2186279865/robot-10.15/README.md

# robot-competition —— 机器人视觉分拣系统

> 2027 年第十届中国大学生工程实践与创新能力大赛 · 智能+工程创新赛道 · **智能分拣**赛项
> 一台"看得到、抓得准"的四轴抓取机器人：双相机识别 → 双摄融合定位 → 四轴 + 托盘 + 舵机夹爪执行。

```
         两个 USB 相机                    笔记本（识别 + 界面）
              │                                 ▲
              ▼                                 │ WiFi：5056 发现 / 5057 图传 / 5058 串口桥
       香橙派（采集 + 串口桥）───────────────────┘
              │ USB
              ▼
   STM32F407 ── USART2 ──► 4 台 EMM V5 步进（Z / 托盘 / X / Y）
        └── TIM4_CH1 ──► 舵机夹爪（180° 全开 / 150° 预备 / 135° 夹紧）
```

## 仓库四个文件夹（第四个是给队友的）

| 文件夹 | 是什么 | 谁该看 |
|---|---|---|
| **`01-交付包/`** | **能用的那一版**：固件源码+hex、派端服务、视觉算法+模型权重、上位机 GUI、部署脚本、操作文档。自带模型，拷走就能跑 | 要跑、要改、要交付的人 |
| **`02-资料库/`** | 赛题原文、硬件资料、往届参考、历史快照、调研报告、交接教程，以及 **`00-项目日志.md`**（每件事的背景/取舍/验证/坑） | 想知道"为什么这么做"、要接手的人 |
| **`03-实验台/`** | 试过但没进主线的东西：Qwen 语义识别（33 GB，**不在 git 里**）、SAM 上派实测、网络化原型 | 想试新想法的人 |
| **`04-队友视觉调试包/`** | 给第二台电脑（队友）的入口：只读看图、离线跑识别、一键自检、真机样例图 | 队友和他的 AI |

**第一次来 → 直接读 `01-交付包/README.md`**（三步跑起来 + 故障速查）。
**想搞清来龙去脉 → 读 `02-资料库/00-项目日志.md`**（按时间倒着看也行）。

## 最快上手

```bat
cd 01-交付包
setup.bat                     :: 只需一次：建 .venv 并装依赖（约 1–2 GB）
run.bat                       :: 本地模式：相机 + STM32 都插在本机
run.bat --pi 192.168.100.198  :: WiFi 模式：相机和 STM32 在派上（端口下拉框会自动出现「派 robot-pi …」）
run.bat --sim                 :: 没有硬件，纯看界面
selftest.bat                  :: 自测 7 步（220 单测 + 端到端 + GUI）
```

派端装一次：`cd 01-交付包/orangepi && ./install.sh`（装依赖 + 生成开机自启服务）。
固件烧录：`01-交付包/stm32/hex/STM32F429.hex`（或 Keil 打开 `01-交付包/stm32/firmware/Project/STM32F407.uvprojx` 按 F8）。

## 三个容易踩的坑（交付包里已经处理过，但你还会遇到）

1. **相机槽位每次插拔可能变**——顶视/侧视互换后要改 `vision/config.json` 的 `remote.cam_map`；
2. **两台相机别挂同一个 USB2 hub**——带宽不够会掉到 5 fps，插一台到 USB3；
3. **动过相机位置/分辨率 → 标定全部重做**（四点、空背景、X/Y、Z 示教）。

## 快照与恢复

- git：tag `working-20261023` / commit `3a5fec3` 是重构前的可运行快照；
- 物理备份：`D:\study\backup\robot-competition-2026-10-23`（1.16 GB，含逐文件哈希清单）；
- 模型 `sam_b.pt`（358 MB）走 **Git LFS** 入库：clone 前先 `git lfs install`（否则得到 134 字节指针，`git lfs pull` 补）；
- 队友那台机器直接看 `04-队友视觉调试包/README.md`。

## 约定

- 批处理文件一律**纯 ASCII + CRLF**（cmd.exe 逐字节解析，UTF-8 中文会把行切错）；
- 固件里**不要**从外部脚本改 `.uvprojx`（Keil 保存会用内存里的旧列表覆盖）；
- 新增功能优先改 `*_inline.h`；`Drive/Source/gripper.c`、`stepper.c` 是参考副本、不进编译；
- `01-交付包` 严禁 import `03-实验台` 里的东西；要用的结论就搬进 01。

## 旧目录（待清理，暂留作回退）

`10.21/`（重构前的自包含包）、`final/`、`new_eye/`、`ghr/`、`xrw/`、`build/`、`Qwen/`（已移入 `03-实验台/Qwen-VLM/`）
—— 内容都已被三个新文件夹覆盖，确认新版无问题后可删（见 `02-资料库/00-项目日志.md` 最后一条）。
