2186279865/robot-10.15/03-实验台/网络化原型/README.md

# 【已毕业】网络化原型（派采集 + 串口桥 + 拉模式图传）

- **日期**：2026-10-22 起草 → 2026-10-23 毕业
- **想解决什么**：相机和 STM32 都插在派上，笔记本只跑识别与界面，两者同一 WiFi。
- **毕业去向**：已全部并入 `01-交付包/`：

| 当初的原型 | 现在在交付包里的位置 |
|---|---|
| `pi_agent.py`（图传 5057 + 串口桥 5058 + UDP 发现 5056） | `01-交付包/orangepi/pi/pi_agent.py` |
| 线路协议（9 B 请求 / 24 B 头 + JPEG / 6 B 错误头） | `01-交付包/common/wire.py` |
| `RemoteCamera` / `camera_factory`（笔记本侧把远程帧伪装成本地相机） | `01-交付包/vision/remote_camera.py`、`camera_factory.py` |
| `SocketLink`（把 `tcp://IP:5058` 当串口用） | `01-交付包/host/serial_link.py` |
| 一键连派（端口下拉框里出现「派 robot-pi <IP>」） | `01-交付包/host/pi_link.py` |
| 发现与测速工具 | `01-交付包/net/find_pi.py` |
| 防火墙/组网指南 | `01-交付包/net/组网指南.md`、`firewall-allow.ps1` |

## 这个实验里最值钱的三个判断

1. **拉模式优于推流**：笔记本发 9 字节请求、派回一帧 JPEG。没有积压、没有重传、延迟可控（实测取一帧 137–376 ms）。
2. **错误包必须带自己的头长度**：图传头 24 B、错误头 6 B。第一版客户端一律按 24 B 读，遇到错误包会多吞 18 字节，然后卡到 5 s 超时——表现为"偶发超时"，非常难查。修法：先读 2 B magic 再分派。
3. **派端要有看门狗**：笔记本 1.5 s 没发字节，派端就自己往 STM32 发四轴停车帧。这样笔记本崩了/网断了，机械臂不会一直跑。

## 这目录现在还剩什么

什么都没有——原型代码已经删了（避免两份代码漂移）。要读实现，直接看 `01-交付包` 里的对应文件；要读当时的取舍，看 `02-资料库/00-项目日志.md` 的 2026-10-22 与 2026-10-23 两条。
