2186279865/robot-10.15/codex/output/project_report_work/artifact.md

# 模板执行约定

- 原件：C:/Users/rs/Desktop/附件7-命题文档_1785202024444.docx
- SHA256：7c49e14664f3795d0f7ec58d0b5f1f59784145c8e426350145f9a7dabfd03245
- 已用 Word 只读导出 template.pdf，7 页；template-1.png 至 template-7.png 已检查。
- 参考 PDF 为写作结构与详细程度参考，不复制人物、机构、实测成绩或垃圾分拣部件。
- A4 纵向 21.001×29.700 cm；上/下 2.54 cm，左/右 3 cm；单节；页眉距离1.501 cm，页脚1.750 cm。
- 主体是一个10行2列合并表格：第0行赛事名称，第1行组委会编号，第2/3行标题与参赛项目，第4至8行五章，第9行赛事提示。
- 保留主表列宽、表头合并关系、边框、赛事标题、编号栏与赛事提示。正文允许克隆源全宽行，将标题和正文、图片和图题作为完整分组；组间隐藏横线，保留章节分隔。复制源文件编辑，不改变原件。
- 填入第3行项目名 智能分拣 并加入作品题目 几何物块视觉识别与自动分拣系统。
- 第4至8行：删除蓝色指导文字和空白段，替换为原创项目正文；各章字数分别不超过500/2000/500/300/2000。
- 正文宋体10.5 pt（五号），固定20 pt行距，两字首行缩进；正文与标题黑色。章节按源模板编号，内层采用2.1等层次，避免借用垃圾项目的内容。
- 源表行高为模板占位，5~7行各742.35 pt；正文填入后改为自然高度，允许跨页。正式内容自然续页；正文短组不可拆分，标题与后文、图片与图题合组以防孤行，不再强制章节分页。
- 图表：仅使用项目图像与新绘制的系统/算法/动作示意图；图按章最多5幅。图中文字中文，说明为示意不伪装实物成果；图文不覆盖、不越框。
- 第二张表为智能搬运赛项的决赛场地空白附页，不适用于智能分拣，删除该附页及多余空白段；模板正文的五章和赛事提示保留。
- Title样式应用于作品说明书标题，去除标题装饰线；参赛作品题目位于第一章内。
- 匿名：清除作者等元数据；不出现学校、队号、学生名及个人标识，不放软件带个人信息的截图。
- 数据：采用已经存档的离线结果，不虚构全机准确率与耗时。决赛流程、数量、时间和评分明确为命题建议。
- 渲染：当前Windows运行时没有LibreOffice（runtime.json libreOfficeVersion=null），已确认本机 Word 16.0 可用。通过任务包装器将技能render_docx.py的PDF转换阶段接入Word只读导出，PNG仍由技能渲染器生成。最终逐页检查。
- 输出为codex/output/几何物块智能分拣系统作品说明书.docx；中间PDF与页面不作为交付件。

- 最终QA：6页逐页PNG已检查；四幅图齐全，无蓝色指导文字；各章字数合限，几何尺寸与原模板相同，原文件哈希未变。正文借助克隆行解决Word长合并单元格的分页问题，保留章节边框。报告仅采用存档离线测试数据。
