2186279865/robot-10.15/01-交付包/VERSION.md

# VERSION.md —— 01-交付包 版本说明

## 当前版本：v1.0（2026-10-23 冻结）

| 项 | 值 |
|---|---|
| 冻结时间 | 2026-10-23 23:50 左右（本机时间） |
| Git 快照 | 仓库 commit `3a5fec3`，tag `working-20261023` |
| 物理备份 | `D:\study\backup\robot-competition-2026-10-23`（1.16 GB，含 `_MANIFEST.txt`） |
| 固件 | `stm32/hex/STM32F429.hex`，92,952 B，2026-10-26 00:13 编译，Code=31,632 / RO=1,152 / RW=532 / ZI=7,396，0 Error 0 Warning（含闭环 `motor_goto` + **转盘角度模式** `motor_angle`/`motor_angle_zero`；修了 goto 负向方向 bug、查询节流、argc 与时间差回绕） |
| 上位机 | 8 页一体化 GUI，单测 **182** 个全过（含 box_map / auto_runner） |
| 派端 | `pi_agent.py` 1872 行，假硬件自测 24 项全过 |
| 视觉 | SAM-B（`vision/models/sam_b.pt`，357.7 MB）+ 双摄融合 + 规则分类 |
| 跨端 | TCP 端到端 5 项全过（图传 / 串口桥 / ER 包 / cam_map / 不可达降级） |

## 这一版能做什么

- 笔记本单机跑（USB 相机 + USB 串口），或 WiFi 跑（相机与 STM32 在派上）；
- 双相机实时预览（顶视 + 侧视）、点选识别、分割出目标、双摄融合、按形状/颜色分类；
- 四轴手动点动、参数读写、动作序列编排与运行；
- 夹爪三档角度：180° 完全张开 / 150° 预备位（连上自动到）/ 135° 夹紧；
- 接近段示教：把"上电位置 → 抓取位置"的路径录下来，序列前自动重放；
- 回上电初始位：记录本次上电后的全部移动，一键倒放回来；
- 三层安全网（界面急停 / 派端 1.5 s 看门狗 / 固件 3 s 心跳锁存）。

## 已知限制（不是 bug，是这一版就这样的地方）

1. **四轴无编码器回读**（PA3 回读线未接）：`motor_query` 一律 `E04`，所有位置是"软位置"（按脉冲累加估算），超时/堵转后不可信。
2. **开环重放有累积误差**：接近段与回初始位都是按记录重放，误差逐次累积；现场需要人工归位。
3. **常用走（速度模式）的段是估算**：按"转速 × 时间"换算脉冲，误差较大；示教优先用「相对走 / 绝对走到此」。
4. **相机槽位不稳定**：换 USB 口/换相机/重装系统后 `0/1` 可能互换，需重设 `vision/config.json` 的 `remote.cam_map`。
5. **同 USB2 hub 掉帧**：两台 1280×720 相机挂同一个 USB2 hub 时 5–10 fps；分开插（一台 USB3）可到 11 fps 以上。
6. **标定不可迁移**：动过相机位置/分辨率，四点、空背景、X/Y、Z 全部要重做。
7. **识别只在笔记本**：派上跑 SAM 实测 20–30 s/帧，不可用；派只做采集与串口桥。
8. **Qwen 语义识别未并入主线**：那套（Ollama + qwen2.5vl）在 `../03-实验台/Qwen-VLM/`，它的输出格式与上位机现在读的 `latest_targets.json` 不通。
9. **本包不含 `.venv`**：模型与代码都在，但 Python 依赖要跑一次 `setup.bat` 装（约 1–2 GB）。

## 上一版（历史）

- `10.21/`（本包的前身）：2026-10-22～23 在工作区根目录演进，功能相同但目录没分三类、依赖仓库根的 `Qwen/.venv`。
- `final/`（2026-10-21 01:06 冻结）：单机一体化交付快照，8 页，但在 `02-资料库/04-历史快照/final/`。
- `new_eye/`（更早）：独立视觉程序，不含控制，在 `02-资料库/04-历史快照/new_eye/`。

## 改动记录

| 日期 | 内容 |
|---|---|
| 2026-10-23 | 固件：夹爪三档（180/150/135）+ `gripper ready` 动作 + `gripper_ready_deg`/`gripper_hold_max_ms` 参数 + 卸力保护 |
| 2026-10-23 | 上位机：三种点动都能记入接近段；删掉「一键回0 / 开机回基准」；新增「回上电初始位」 |
| 2026-10-23 | 派端：`_open_capture` 设 MJPG 修多相机带宽；连接失败可见化；派端 systemd 服务按现场生成 |
| 2026-10-23 | 结构：从 `10.21/` 重排为 `01-交付包/`（stm32 / orangepi / vision / host 分家），路径全部改为相对计算 |
