2186279865/robot-10.15/02-资料库/方案-省赛冲刺总纲-2026-10-26.md

# 省赛冲刺总纲（2026-10-26 凌晨）

> 背景：距离省赛只剩几天。目标从"把系统做完整"改成"**能跑完一轮、不违规、拿得到分**"。
> 本文件是把 2026-10-21 ~ 10-26 所有讨论（架构、闭环、流程、现场约束）收敛成一份可执行总纲。
> 相关文件：`方案-自动抓放流程与状态机-v2.md`（流程细节）、`明日待办-2026-10-26.md`（当日操作）、`待优化清单.md`（赛后再说）。

---

## 1. 一页结论

- **能拿分的形态**：一键启动 → 自动抓 1 件 → 分类 → 转盘到位 → 沿固定通道出去 → 对准 → 抓起 → 原路回 P0 → 松爪落盒 → 屏幕显示 → 自动下一件。全程不碰人、不遥控。
- **当前底座**：链路、双相机、SAM、四轴点动、夹爪三档、遥测真实 counts、**闭环 goto 正向已通（err 33–127 counts）** 全部可用。
- **当前缺口**（按危险度）：①标定 u,v→X/Y 不可用（旧残差 ±3.2 万脉冲）②行程/软限位未知 ③通道执行器（corridor）没有 ④goto 负向 bug ⑤转盘角度模式 ⑥6 类样本只登记了 1 类 ⑦显示/一键启动/状态机。
- **冲刺策略**：先保"一条完整链能自动跑"，再谈精度与分类；所有"锦上添花"一律砍掉。

---

## 2. 事实底座（已确认，不要再猜）

### 2.1 机械与现场约束（用户确认）

| 事实 | 影响 |
|---|---|
| P0（上电初始位）= 转盘正上方，**正上方有结构挡住，不能先抬 Z** | 出门必须"先 Y 让开 → 再抬 Z"，通道固定为 2 段 |
| 结构已固定，不能改 | 一切只能在软件层解决 |
| 抓取区 12 件货、最多 6 类；**X、Y 都随机散布** | X 必须参与对准，X 标定精度须等同 Y |
| 6 类货**尺寸/高度都差不多** | 单一 `Z_PICK` 即可，夹爪开口统一 |
| 相机固定；**看不到盒子区，但抓取区完整可见** | 拍照可在 P0 进行；**落货无法视觉确认** |
| 转盘：步进 + 6 个储物盒，每盒 60° | 用**绝对角度模式 + 单圈归零点** |
| 现场只有约 3 分钟调试，没时间录样本 | 分类样本必须**赛前**录好 |

### 2.2 电气与固件（实测）

| 项 | 值 / 结论 |
|---|---|
| 链路 | 笔记本 ↔ WiFi ↔ 派 192.168.100.198 ↔ `/dev/ttyACM0` ↔ STM32 ↔ 四台 EMM V5 |
| 图传/串口桥 | 1280×720 约 48–70 ms / 约 5–38 ms |
| 回读 | **遥测链路可用**（四轴真实 counts，`counts_per_rev=65536` 已实测吻合：640 脉冲 → +13110 counts） |
| `motor_query` | 必回 E04（同源时间戳 bug），**闭环已绕开，不修也行** |
| 闭环 `motor_goto` | 正向 `+640 tol=200` → `ok passes=0 err=-127 counts 834 ms`；**负向 bug 已定位、补丁已写未烧** |
| 夹爪 | `gripper_open_deg=180` / `gripper_ready_deg=150` / `gripper_grab_deg=135`，运行时读参数 |
| 安全网 | GUI「停止全部」→ 派端 1.5 s 无字节发停车帧 → 固件 3 s 失联锁存停止 |

### 2.3 分类现状（危险）

- `01-交付包/vision/samples.json`：**只登记了 1 类**（`五棱体|绿`）。
- `config.json` 的 `class_map`：6 条键值，值是旧编号（5/2/6/4/3/待登记），**与真实 6 类不对应**。
- 结论：**分类链路现在等于没配**。有实物就必须今天补录，否则只能按颜色粗分。

---

## 3. 目标与验收

### 3.1 本轮交付定义

> **一键启动后，机器人自动完成 ≥6 件（目标 12 件）的"抓—分类—归盒"循环，中途不碰人，屏幕持续显示当前件信息；单件节拍 ≤15 s（赛题要求"超 15 秒无动作无显示本轮结束"）。**

### 3.2 验收清单（比赛前必须全绿）

| # | 验收项 | 判据 |
|---|---|---|
| 1 | 行程与软限位 | 三轴行程已量、`limits.json` 生效，超程拒绝 (E15) |
| 2 | 闭环 goto 双向 | 正负各 3 轮，\|err\|≤200 counts、累计漂移≤1000 counts |
| 3 | 转盘角度 | 转 60° / 回 0°，回读角差 ≤0.5°，重复 6 次不累积 |
| 4 | 标定 | u,v→X/Y 残差 <100 脉冲（约 0.25 mm 量级） |
| 5 | 单件抓放 | 抓取成功率 ≥8/10，回 P0 松爪落盒成功 ≥8/10 |
| 6 | 分类 | 6 类各 5 件，正确率 ≥80% |
| 7 | 自动流程 | 一键启动 → 连跑 ≥6 件，无需人工介入 |
| 8 | 显示 | 序号/类别/数量显示正确，刷新 ≤1 s |
| 9 | 安全 | 急停可用、失联停车、上电不自走 |

---

## 4. 架构与数据流（不变的部分）

```
[顶视相机] --JPEG--> 派(camera_agent/pi_agent:5057)
                        │
[笔记本 host GUI] <──────────────────────────┐
   ├─ 视觉页: 取帧 → SAM → 融合 → 规则分类 → latest_targets.json
   ├─ 动作序列: auto_runner 读目标 → 生成四轴脉冲 → 发命令
   └─ 串口桥 5058 → 派 → /dev/ttyACM0 → STM32 → 驱动器
[显示] 派 HDMI 小屏 ← 5059 display_state（或笔记本副屏）
```

**职责划分**：识别与决策在笔记本（SAM 只能在笔记本跑，0.98 fps）；派只做"取图 + 串口透传 + 显示"；STM32 只做"收帧 + 发帧 + 闭环 goto + 角度模式"。

---

## 5. 精简流程：8 状态（替代原 19 状态）

| 状态 | 动作 | 判据/超时 | 失败去向 |
|---|---|---|---|
| `S1 CAPTURE` | 顶视取 1 帧 + SAM 分割 | 3 s | FAULT |
| `S2 DECIDE` | 选目标（完整度→近通道→面积）+ 分类 + 盒号 + 算 X/Y 目标脉冲 | 2 s | FAULT |
| `S3 TRAY` | `motor_angle 3 <deg>` 到该盒角度 | 3 s | FAULT |
| `S4 OUT` | 通道出门：`Y +Δy` → `Z_LOW→Z_HIGH` | 4 s | FAULT |
| `S5 PICK` | X/Y 闭环对准 → `Z→Z_PICK` → 夹 135° → `Z→Z_HIGH` | 6 s | FAULT |
| `S6 BACK` | X/Y 回 P1 → `Z_HIGH→Z_LOW` → `Y -Δy` | 5 s | FAULT |
| `S7 DROP` | 松爪 180° → 等 0.3 s → 回 150° → 显示 + 计数 | 2 s | FAULT |
| `S8 NEXT` | 还有件 → S1；无件 → DONE | — | — |

**设计原则**

1. **每步都等事件**（goto 应答 / `motor_angle` 应答 / 图像帧到位），不用固定 `sleep`。
2. **任何失败进 FAULT 并立即停车**，屏幕显示错误码；不重试（时间不够，宁可少抓一件也不要把机构卡住）。
3. **不做抓取复核**（`VERIFY_PICK` 砍掉，省 1.5 s/件；靠闭环 counts 判定）。
4. 显示在每一状态切换时更新，保证"始终有动作/有显示"。

---

## 6. 关键设计决策（含被否方案）

| # | 决策 | 理由 | 被否方案 |
|---|---|---|---|
| D1 | 通道固定 2 段（Y 让开 → Z 抬起），回程严格反序 | P0 正上方有结构，不能先抬 Z | 先抬 Z 再 Y（撞） |
| D2 | X 只在"最高处"参与移动与对准 | X 参与会破坏"固定通道"的安全前提 | 通道含 X（会被挡） |
| D3 | 转盘用绝对角度 + 单圈归零 | 幂等，重复下发不偏移；断电后人工对 1 号盒 | 相对增量记账（会累积漂移） |
| D4 | 闭环放固件、读遥测缓存 | 判定 1 ms；WiFi 往返 200–400 ms 太慢 | 闭环放上位机 |
| D5 | 查询节流 20 ms + 发帧后静默 30 ms | kHz 级 `0x36` 查询会把 `FD` 运动帧淹掉（已实测） | 不节流（goto 不动） |
| D6 | 分类用"规则(形状\|颜色) + 赛前样本登记" | 现成代码，赛前 30 分钟可录 6 类 | CLIP 零样本（来不及调） |
| D7 | 落货不做视觉确认 | 相机看不到盒区 | 加对射光电（改硬件，赛后） |
| D8 | 显示用派 HDMI 全屏大字（最简） | 赛题强制"仅显示功能的高亮屏" | STM32 直驱 TFT（驱动/接线成本高） |
| D9 | 一键启动 = 界面上一个按钮 + 键盘回车 | 赛题"不得遥控" | 手机/远程触发（违规） |

---

## 7. 明天必须测出来的物理量（40 分钟）

| # | 量 | 怎么量 | 用途 |
|---|---|---|---|
| M1 | X/Y/Z 三轴行程脉冲（正负两个方向） | 相对走 200–500 脉冲/次，读回读 counts 累计；留 5–10% 余量 | 软限位 `limits.json` |
| M2 | 每毫米多少脉冲（丝杠导程） | 走 3200 脉冲，用尺量实际位移 | 精度预算、视觉标定 |
| M3 | `Δy_corr`、`Z_LOW`、`Z_HIGH`、`Z_PICK` | 手动点动 + 目视/尺量，记 counts | 通道与抓取高度 |
| M4 | 托盘一圈是否 3200 脉冲；1 号盒是否对准 P0 | `motor_angle_zero` 后转 60° 看回读 | 角度表 |
| M5 | 抓取区在相机里的物理范围（mm） | 四点校正 + 尺量 | 视觉→脉冲标定 |
| M6 | 硬限位在哪（听声音/看行程） | 慢速点动到底 | 软限位余量 |

---

## 8. 精度与误差预算（粗算，待 M2 修正）

- 编码器：65536 counts/圈，3200 脉冲/圈 → **1 脉冲 = 20.48 counts**。
- 若导程 4 mm：3200 脉冲 = 4 mm → 1 脉冲 = 1.25 µm；**tol 200 counts ≈ 0.25 mm**。
- 视觉链路误差来源：四点校正残差 + 标定残差 + 抓取时爪子偏移。
- **目标**：视觉→脉冲残差 <100 脉冲（≈0.12 mm），夹爪开口留 2–3 mm 余量吸收剩余误差。

---

## 9. 分类与盒号映射

- 流程：SAM 掩膜 → 颜色(HSV) + 形状(圆度/顶点/长宽比/实心度) → `形状|颜色` 键 → `class_map` → 类别号 → 盒号 = 类别号（1..6）。
- 赛前要做：①6 类各登记 3–5 个样本（GUI「登记样本」）；②确认 `class_map` 6 条键值对应真实类名；③类别→盒号固定映射写进 `config.json`。
- 兜底：分类失败（"待登记"）→ 按**颜色最近**归盒，仍失败 → 放 1 号盒（拿基础分 2 分/件）。
- 现状差距：样本库只有 1 类，`class_map` 值还是旧编号 → **必须重录**。

---

## 10. 节拍预算（12 件 ≈ 2 分钟）

| 状态 | 预计 | 备注 |
|---|---|---|
| S1 CAPTURE | 1.0 s | SAM 0.98 fps |
| S2 DECIDE | 0.3 s | 纯计算 |
| S3 TRAY | 1.0 s | 60°，300 RPM |
| S4 OUT | 1.5 s | 2 段 |
| S5 PICK | 3.0 s | 对准 1.5 + 下探/夹/抬 1.5 |
| S6 BACK | 2.5 s | 3 段 |
| S7 DROP | 0.6 s | 松爪+回位+显示 |
| **合计** | **≈10 s/件** | 12 件 ≈ 2 min，余量充足 |

---

## 11. 冲刺日程（按"还剩 3–4 天"）

| 天 | 目标 | 产出 |
|---|---|---|
| **D0（今天凌晨，纯软件）** | 固件一轮改完并编译出 hex；`auto_runner.py` 8 状态骨架（假后端可跑）；显示页最简版；分类映射配置 | 三个 hex/文件，明天只需烧录+上板 |
| **D1** | 量行程(M1–M6) → 烧新固件 → goto 双向 3 轮 → 转盘角度验证 → 示教通道+三高度 | `limits.json`、`P0/P1/Δy/Z_*` 参数、双向 goto 全绿 |
| **D2** | u,v→X/Y 标定（残差<100）→ 单件"抓→回→松"跑通 | 第一次完整单件演示（最关键里程碑） |
| **D3** | 6 类登记 + 盒号映射 → 连跑 3–6 件 → 一键启动 + 显示接线 | 自动流程跑通 |
| **D4（缓冲/比赛日）** | 12 件演练 ×2、runbook、故障预案、打包 | 比赛可交付 |

---

## 12. 风险与保底

| 风险 | 概率 | 预案 |
|---|---|---|
| 标定搞不定（残差 >100） | 中 | **保底 A：工位示教**——把抓取区分成 3×4 网格，每格教一次 X/Y 脉冲，按格抓，完全绕过视觉标定 |
| 分类样本录不全 | 中 | 保底 B：只按颜色粗分（6 类颜色够区分就能到 5 分/件） |
| goto 负向仍有问题 | 低 | 保底 C：通道段改用 `motor_pos rel` + wait（精度差但能动） |
| 自动流程卡死 | 中 | 每状态硬超时 → FAULT 停车 + 屏幕报错，人工接管重跑本轮 |
| 显示被扣分 | 低 | 显示内容最小集：序号/类别名/已分拣数量，刷新 1 s 内 |
| 现场网络 | 低 | 统一 192.168.100.x 静态；备用手机热点 |

---

## 13. 今晚我做什么（无需你在场）

1. 应用 `.survey/patch_goto_dir.py`（负向方向修复）+ 写 `absolute` 真生效 + `motor_angle` / `motor_angle_zero` → 编译出 hex、CHECK、selftest。
2. 写 `01-交付包/host/auto_runner.py`（8 状态 + 假后端单测），先保证"逻辑能跑通"。
3. 写 `01-交付包/orangepi/pi/pi_display.py`（5059 全屏大字，最简）。
4. 分类：写 `tools/register_classes.py`（一键登记 6 类）与 `class→盒号` 映射配置，等你明天有货时 30 分钟录完。
5. 生成 `02-资料库/赛前 runbook（打印版）.md` 与待测表格。

---

## 14. 待你确认（3 条）

1. **比赛具体日期**（还剩几天）？
2. **6 类货现在手上有实物吗**（决定今晚能不能录样本）？
3. **派的小屏现在能用吗**（HDMI 输出是否已确认显示）？

---

## 15. 附录：关键文件与命令

| 用途 | 路径 / 命令 |
|---|---|
| 烧录 | `01-交付包/stm32/hex/STM32F429.hex`（Keil F8 或 `UV4 -f`） |
| 自测 | `01-交付包/selftest.bat`、`CHECK.py`、`tools/goto_check.py` |
| 固件源码 | `01-交付包/stm32/firmware/Drive/Include/{host_protocol_inline.h,control_inline.h,emm_reply_inline.h,stepper_inline.h}` |
| 上位机 | `01-交付包/host/`（`host_gui.py`、`auto_runner.py`、`vision_grasp.py`） |
| 视觉 | `01-交付包/vision/`（`gui.py`、`auto_segment.py`、`classify.py`） |
| 派端 | `01-交付包/orangepi/pi/pi_agent.py`、`pi_display.py` |
| 参数 | `counts_per_rev=65536`、`goto_tol_counts=200`、`goto_rpm=300`、`goto_max_passes=4` |
