2186279865/robot-10.15/02-资料库/明日待办-2026-10-26.md

# 明日待办 · 2026-10-26

> 状态（10-25 23:50 收工）：**闭环 `motor_goto` 真机正向已通（err 33–127 counts）；负向方向 bug 补丁已写未烧；转盘角度模式、自动抓放流程已定方案（v2）。**
> 顺序按用户要求：**第 1 件=量全场行程脉冲，第 2 件=修 goto（连带固件改动，一次烧完），第 3 件=自动抓取状态机骨架。**

---

## 0. 今天的关键结论（先读）

1. 闭环 goto 真机成功：`motor_goto 4 +640 tol=200 rpm=60` → `ok passes=0 err=-127 counts elapsed=834 ms`（counts 94042→107252，理论 13107）。
2. 根因不是驱动器/接线/使能：goto 期间主循环 kHz 级地灌 `0x36` 查询，驱动器把紧跟其后的 `FD` 运动帧丢掉 → `tx=1` 却不动。已修（查询限速 20 ms + 发帧后静默 30 ms）。
3. **还没修**：GAP 段发段用绝对值 → **负向指令实际往正走**。补丁 `.survey/patch_goto_dir.py` 已写好未应用。
4. `motor_query` 仍必 E04（闭环已绕开）；**回读靠遥测**（四轴真实 counts 可读）。
5. 板子里现在是 **89,961 B / 22:46:55**（含节流，**不含方向修复**）。

---

## 1. 【第一件 · P0】量全场行程脉冲（约 40 分钟）

**目的**：拿到 X/Y/Z 三轴从初始位到两端的真实脉冲数，明天写进配置做**软限位**（防止视觉/标定算错时把机构顶死）。

### 1.1 工具与安全注意

- 只用 **「相对走」(`motor_pos rel`)** 点动，**不要用 goto**——闭环负向现在还是坏的；
- 每次 200–500 脉冲（Z 用 200，X/Y 用 500），每走一次**读一次「回读」**（遥测，0.1 s 刷新）；
- **留 5–10% 余量**：听到/看到快到底就停，别真撞到硬限位（撞了会丢步，数字就不准了）；
- 每轴记两个数：**正方向累计** 和 **负方向累计**（从初始位出发，各走到底再回初始位）。

### 1.2 怎么走（界面 + 记录表）

四轴页每个轴都有「相对走」（方向 正/负 + 圈数/度数 + 脉冲），走一次看一下「回读」的 counts。

| 轴 | 正方向（远离初始位） | 负方向 |
|---|---|---|
| `Z (1)` | 初始 → 最高 = ______ 脉冲 | 初始 → 最低 = ______ 脉冲 |
| `Y (5)` | 初始 → 最远 = ______ 脉冲 | 初始 → 最近 = ______ 脉冲 |
| `X (4)` | 初始 → 最远 = ______ 脉冲 | 初始 → 最近 = ______ 脉冲 |
| `托盘 (3)` | 一圈确认 = 3200 脉冲？ | 单圈归零点 = 1 号盒（确认） |

顺便确认（这三个数字直接影响参数）：
1. 每轴**正常可用**的最高转速（X/Y 比如 150 RPM、Z 100 RPM）→ 写进 `goto_rpm`；
2. **有没有硬限位开关**（没有的话软限位就是唯一保护）；
3. 三轴**上电初始位**是机械停位，还是每次要人工对零。

### 1.3 交给我之后我做什么

把表填好发我 → 我写进 `01-交付包/host/limits.json`（新文件）+ `auto_runner`/`host_client` 下发前检查：
`目标 = 当前 + delta`，若 `目标` 超出 `[min, max]` → 直接拒绝并报 `E15 超程`（不上报固件，不动作）。

---

## 2. 【第二件 · P0】固件一轮改完，一次烧录（约 1.5 h）

三个补丁一起做、一次编译、一次烧录、一次复位：

| # | 内容 | 补丁/位置 |
|---|---|---|
| A | goto **方向修复**（GAP 段按 `dir` 还原符号；CORRECT 段补 `dir`） | `.survey/patch_goto_dir.py`（已写） |
| B | **绝对位置真生效**：`control_apply_position()` 现在调 `Stepper_MoveRelativeAt2(...,0UL)`，`absolute` 没生效 → 真走 `Stepper_MoveAbsoluteAt()`（`0xFD raF=1`） | 新补丁 |
| C | **转盘角度模式**：`motor_angle,<addr>,<deg_x100>[,<rpm>]` + `motor_angle_zero,<addr>`（发 `93 88`）；角度→脉冲用参数换算；到位用 `0x36` 回读，角差 ≤0.5° | 新补丁 |

```powershell
cd D:\study\project\robot-competition
01-交付包\.venv\Scripts\python.exe .survey\patch_goto_dir.py
01-交付包\.venv\Scripts\python.exe .survey\patch_absolute_and_angle.py   # 明天写

D:\study\keil\UV4\UV4.exe -b D:\study\project\robot-competition\01-交付包\stm32\firmware\Project\STM32F407.uvprojx -j0 -o D:\study\project\robot-competition\01-交付包\stm32\firmware\Project\build_goto5.log

Get-Process UV4 -ErrorAction SilentlyContinue | Stop-Process -Force
Start-Process -FilePath 'D:\study\keil\UV4\UV4.exe' -ArgumentList '-f','D:\study\project\robot-competition\01-交付包\stm32\firmware\Project\STM32F407.uvprojx','-j0','-o','D:\study\project\robot-competition\01-交付包\stm32\firmware\Project\flash_goto5.log' -Wait
Get-Content 01-交付包\stm32\firmware\Project\flash_goto5.log
# 烧完必须【按复位键】，USB 才会重新枚举
```

**验收**

```powershell
cd D:\study\project\robot-competition\01-交付包
.venv\Scripts\python.exe tools\goto_check.py  --port tcp://192.168.100.198:5058 --axis 4 --pulses 640  --rounds 3 --tol 200
.venv\Scripts\python.exe tools\angle_check.py --port tcp://192.168.100.198:5058 --axis 3 --zero --deg 6000
.venv\Scripts\python.exe tools\angle_check.py --port tcp://192.168.100.198:5058 --axis 3 --deg 0
```

判据：goto 3 轮全 `ok`、每轮 `|err|≤200`、累计漂移 ≤1000；角度回读差 ≤0.5°，重复下发同一角度**不再转动**。

⚠ 顺手把 `tools/goto_check.py` 的客户端超时改大（`hc.send("motor_goto", ..., timeout_ms=20000)`），否则 rpm=60 会误判超时。

---

## 3. 【第三件 · P0】自动抓放状态机骨架（假后端，不碰硬件）

文档：`02-资料库/方案-自动抓放流程与状态机-v2.md`。
新建 `01-交付包/host/auto_runner.py`：19 个状态（`IDLE / TRAY_SET / CAPTURE / RECOGNIZE / PLAN / CORRIDOR_OUT / MOVE_XY / DESCEND / GRASP / LIFT / VERIFY_PICK / RETURN_XY / CORRIDOR_BACK / RELEASE / LIFT_BACK / DISPLAY / NEXT / FAULT / DONE`）。

要点：
- 每步**等事件**（`motor_goto`/`motor_angle` 的 ok/err），不按固定时间等；
- 每步超时 + 重试预算（对准 1、重夹 2、转盘 2），超了进 `FAULT`；
- 分类不确定**自动取最高分**（记 confidence），不停下问人；
- 每件耗时写 `runtime/auto_run_*.jsonl`；
- 下发前用 §1 的软限位检查。

用 `--sim` 假后端跑通全流程，界面加「一键启动 / 暂停 / 停止 + 当前状态」。

---

## 4. 【第四件 · P1】示教通道与高度（要你在场）

- `P0`（X0,Y0,Z 最低）、`P1`（X1,Y1,Z_HIGH）、`Z_PICK`、`Δy_corr`；
- 通道两段写进 `approach_route`：`Y +Δy_corr` → `Z→Z_HIGH`；回程 `reverse_steps`。

---

## 5. 【第五件 · P1】标定 u,v → X/Y（要你在场）

- 重拍空背景 → 顶视四点 → X/Y 标定，判据残差 **<100 脉冲**；
- Z 三个高度示教后存 `runtime/`；
- 侧视支架一改就要重做。

---

## 6. 【第六件 · P1】真机联调

1. 手动单件：`TRAY_SET → 通道 → X/Y 对准 → 抓 → 复核 → 回 → 松爪`；
2. 自动循环 6 件（每类 1 件）→ 归盒正确；
3. 连续 20 件 + 异常注入（抓空/超时）→ 全进 `FAULT` 且能人工恢复。

---

## 7. 收尾

- `VERSION.md` 固件行改新 hex；`stm32/hex/` 换最终 hex + build_log；
- `00-项目日志.md` 追加今天三件事（行程数据 / 方向+角度模式 / 状态机骨架）；
- `git add -A && git commit`；
- 待定：`3d/` 两个 STL 是否收进 `02-资料库/02-硬件/`。

---

## 8. 现场 / 环境备忘

| 项 | 值 |
|---|---|
| WiFi | `MIFI-2419`（笔记本 + 派都连它） |
| 笔记本 IP | `192.168.100.200` |
| 派 IP | `192.168.100.198`，SSH `orangepi/orangepi` |
| 派端服务 | `systemctl status robotpi`；`/dev/ttyACM0` = STM32 CDC |
| 串口桥 / 图传 / 发现 | `tcp://192.168.100.198:5058` / `5057` / `5056` |
| 固件参数 | `counts_per_rev=65536`、`goto_tol_counts=200`、`goto_rpm=300`、`goto_final_rpm=60`、`goto_max_passes=4` |
| 烧录 | Keil `UV4.exe -f`（无 ST-LINK_CLI），烧完必须按复位 |
| 约定 | 所有 .bat/.cmd 必须纯 ASCII + CRLF |

---

## 9. 尚未解决（不在明天范围）

- `motor_query` 必 E04（时间基不同源），闭环已绕开；
- 背隙补偿（先量正/反向 err 差值）；
- 回读是单圈角度，多圈靠固件累计；
- 侧视相机被丝杠挡 → 支架调整 + 重标定；
- 夹爪角度随时可改（OPT-01，见 `待优化清单.md`）；
- 派端显示窗口（`pi_display.py`）与赛题硬指标（350×350×450 包络、一键启动、15 s 节奏）；
- 落货确认只能靠"视觉复核目标消失"，没有盒子入口光电（已记进 OPT）。
