2186279865/robot-10.15/02-资料库/明日待办-2026-10-25.md

# 2026-10-25 明天待办清单

> 用法：从上往下做，带 ☐ 的勾掉。**灰底「需你到场」的条目必须先做**（要上电/动电机/烧录）。
> 昨晚的思路背景见 `02-资料库/思路-2026-10-24.md`；整机方案见 `02-资料库/方案-整机作战方案-v1.md`。

---

## 0. 开场 10 分钟：先回答这 7 个问题（或直接说"按建议"）

| # | 问题 | 我的建议默认值（没人回答就按这个做） |
|---|---|---|
| 1 | P0 释放到哪里？(a) 六盒转盘 (b) 滑槽料框 (c) 别处 | **先按 (b) 滑槽/料框做**：RELEASE = 松爪 180，不做托盘转位 |
| 2 | P0 张开夹爪有干涉吗？ | 假设无；若无把握，RELEASE 前先 Z 抬 5 mm |
| 3 | 通道每件都走吗？ | **每件都走**（对应你要的"抓完原路返回"） |
| 4 | 六类货高度不同吗？ | 假设**不同**，先按 6 个 `Z_grab` 查表做，值先人工示教 |
| 5 | 允许"放弃某件"吗？ | **允许**（超时 14 s / 连续抓空 2 次就跳过） |
| 6 | 小显示器规格？ | 先按 7" 1024×600、≥500 nit、HDMI、5 V 供电做代码，屏到了再调 |
| 7 | 4 个闭环标定实验可否现在跑？ | 需要你点头（会动 X 轴约 1 分钟） |

---

## 1. 批次一：需要你在场（上电/动电机/烧录）

### ☐ M1 更正文档里的错误结论（10 分钟，不用硬件）
- 依据：回读其实通了（遥测 75 帧全有真实 counts）。
- 改两处：
  - `02-资料库/02-硬件/README.md:23` —"PA3 未接线 → E04" → "PA3 已回读正常；`motor_query` 主动查询有固件状态机 bug（见 `思路-2026-10-24.md` §1）"
  - `01-交付包/VERSION.md:28` — 同上
- 验收：`grep -n "未接线" 02-资料库/02-硬件/README.md 01-交付包/VERSION.md` 无输出。

### ☐ M2 四个遥测闭环标定实验（约 1 分钟动作 + 20 分钟整理）★需你点头
- 脚本：`03-实验台/00-scratch` 下新建 `telemetry_calib.py`（只发 enable/pos rel/遥测，不动 Z、不夹爪）。
- 实验与产出：

  | 实验 | 做法 | 产出 |
  |---|---|---|
  | A 比例 | X(4) 走 3200 脉冲，前后读 counts 差 | `counts/脉冲` 系数 |
  | B 重复性 | A 重复 5 次 | 误差分布 → 死区取值 |
  | C 反向间隙 | 正走 1600 再反走 1600，看 counts 差 | 背隙 counts → 是否必须单向逼近 |
  | D 遥测延迟 | 发指令后每 100 ms 采样 counts | 实际刷新周期 → "等几拍" |

- 验收：生成 `02-资料库/05-调研报告/遥测闭环标定.md`，含 4 个表 + 结论（死区取多少）。
- 风险：X 轴 1 圈 60 RPM，幅度小；若撞限位立即急停（GUI「停止全部」或断电）。

### ☐ M3 烧一版"诊断固件"钉死 E04（30 分钟）
- 改动（`01-交付包/stm32/firmware/Drive/Include/host_protocol_inline.h`）：
  - `host_cmd_motor_query()` 里把 `sent_ms` 改为**任务循环的 now**（或记录两套时间戳做对比）；
  - 新增事件（或临时 `telemetry` 字段）每次查询输出：`sent_ms / stamp_ms / have / active / timeout_count`；
  - `EmmQuery_Expired` 改有符号比较（`emm_reply_inline.h:354-365`）。
- 编译：`D:\study\keil\UV4\UV4.exe -b "01-交付包\stm32\project\STM32F407.uvprojx" -j0 -o build\uv4_diag.log` → 0E0W。
- 烧录：`01-交付包\stm32\hex\STM32F429.hex`（重新生成后）。
- 验收：连上后跑 20 次 `motor_query`，成功率 ≥19/20，且日志能看出旧 bug 的时间戳规律。
- 需要你做的：插 ST-Link、按 F8 烧录、确认电机能上电。

---

## 2. 批次二：纯软件（我做，不需要你在场）

### ☐ F1 固件 A1：修 `motor_query`（0.5 天）★依赖 M3 的诊断结论
- 按 M3 观测到的真因落最终修法（统一时间源 / 有符号比较 / 重取 now）；
- 编译 0E0W → 交给 M3 的烧录流程；
- 验收：`readback_noTele.py` 12/12 成功（tele 关闭状态下也能查）。

### ☐ F2 固件 B1：固件侧闭环 goto（1 天）
- 新命令：`motor_goto <axis> <target_counts> [tol]` → 两段式逼近 + counts 校验 + `done,counts=N`；
- 新参数：`goto_tol_counts`（默认 200）、`goto_final_rpm`（默认 60）；
- 失败路径：补两次仍超差 → `err,E14,goto_lost,axis=N,delta=D`（新错误码 E14）；
- 验收：模拟后端单测 + 真机 X 轴 10 次 goto，重复性误差 ≤200 counts。

### ☐ F3 固件 B2：多轴同步（0.5 天）
- 用 `FF 66` 同步触发：先给各轴发 `FD snF=1`（等同步），再发 `FF 66`；
- 校验：先单独验证两台电机能同时启动；
- 验收：X/Y 走斜线后，`elapsed_ms` 比顺序执行少 ≥15%。

### ☐ H1 上位机：查询界面改读遥测（0.2 天）
- 「查位置/查速度」按钮改为直接显示 `last_counts`/`age_ms`（不再发 `motor_query`）；
- 加提示：`motor_query` 修好前这是唯一来源；
- 验收：`01-交付包/host` 单测全绿（164+），GUI 四轴面板回读不再报 E04。

### ☐ H2 上位机：`corridor.py` + 往返状态机（1 天）★今天主目标
- `01-交付包/host/corridor.py`（新）：`{axis,dir,rpm,acc,pulses}` 段的 load/save/正序/倒序/校验（仿 `approach_route.py`）；
- 示教：复用四轴页「开始示教」，录完存 `runtime/corridor.json`；
- 执行器：`IDLE → OUT → PICK → BACK → RELEASE → 计数+1 → OUT/IDLE`；
- 每段：`motor_enable` → `motor_pos rel` → 等时（或 B1 的 goto 到位）→ 200 ms 稳定；
- 每件回 P0 做 counts 校验（与上电基准差 >500 counts → 警告）；
- 抓取宏：`pick()` = 拍图 → 对准 → Z 下 → 夹 135 → Z 上 → 侧视确认；
- 释放宏：`release()` = （可选 Z 下）→ 夹爪 180 → 300 ms → Z 上 → 夹爪 150；
- 验收（模拟后端）：`.survey` 新脚本跑 12 件时序，打印每件耗时、末态 counts、无队列泄漏。

### ☐ D1 派端 `pi_display.py` 骨架（0.5 天，可先不动硬件）
- `01-交付包/orangepi/pi/pi_display.py`：Tkinter 全屏窗口（第 N 件/图片/名称/类别/计数/状态）；
- 监听 `5059`（JSON + 可选 JPEG），断线 3 s 重连，无数据显示"等待上位机"；
- 本地可用假数据跑通并截图；
- 验收：`python pi_display.py --fake` 出窗口并截图 `01-交付包/runtime/display_fake.png`。

---

## 3. 收尾验证（全部跑一遍，10 分钟）

```powershell
cd "D:\study\project\robot-competition\01-交付包"
.\CHECK.py                                      # 期望 19/19
.\selftest.bat /quick                           # 期望 ALL CHECKS PASSED（164 单测等）
.\selftest.bat                                  # 全量 7/7
```

- ☐ `CHECK.py` 19/19
- ☐ `selftest.bat /quick` 全绿
- ☐ `selftest.bat` 全量 7/7（含 GUI 冒烟截图）
- ☐ 固件编译 0 Error 0 Warning，hex 大小记录进 `01-交付包/VERSION.md`

---

## 4. 需要你做的（我会等这些）

| 事项 | 什么时候 | 说明 |
|---|---|---|
| 回答 §0 的 7 个问题（或说"按建议"） | 开场 | 最关键的是 1、2、3、5 |
| 同意 M2 动电机做标定 | 批次一 | 约 1 分钟动作，X 轴 1 圈 60 RPM |
| 插 ST-Link + 烧录（M3/F1/F2 每次） | 批次一/二 | 我编好 hex 你按 F8 |
| 屏到货后给型号/亮度/供电 | 随时 | 决定 `pi_display.py` 分辨率与支架 |
| 确认 P0 释放点有无干涉（拍照给我也行） | 批次一 | 决定 RELEASE 要不要加 Z 抬升 |

---

## 5. 卡住时的降级方案

| 卡在 | 降级做法 |
|---|---|
| E04 诊断不出真因 | 走方案 A：上位机只用遥测（已实现），`motor_query` 标记"暂不可用"，继续 H2 |
| 标定实验数据离散太大 | 死区放宽到 500 counts，改用"单向逼近 + 每件校准" |
| 往返状态机来不及 | 先做"手动 OUT → 抓 → 手动 BACK"的**半自动**版（各一个按钮），把流程跑通 |
| 屏没到 | `pi_display.py` 用假数据跑到截图为止，真屏到了只调分辨率 |

---

## 6. 明天结束时应产出

- [ ] `02-资料库/05-调研报告/遥测闭环标定.md`（死区/背隙/延迟实测值）
- [ ] `02-资料库/02-硬件/README.md`、`01-交付包/VERSION.md` 的旧结论更正
- [ ] 固件：E04 修复 + `motor_goto` + 同步触发（三个 hex 版本）
- [ ] `01-交付包/host/corridor.py` + 往返状态机 + 模拟后端 12 件时序脚本
- [ ] `01-交付包/orangepi/pi/pi_display.py` + 假数据截图
- [ ] `02-资料库/00-项目日志.md` 追加一条（当天记录）
- [ ] 全量自测绿（CHECK 19/19 + selftest 7/7）
