2186279865/robot-10.15/01-交付包/docs/交接文档-20261016.md

# 交接文档（2026-10-16 更新版）

> **新对话请先读这份。**
> 上一版交接文档是 `交接文档.md`（189 行，提交 `6fb864c`），写于 PA0 改造之前。本文取代它，包含那之后的所有进展、以及**串口上位机的完整方案**。
> 读完本文如需更深的细节，再去读文末「文档地图」里列的具体文档。

---

## 一、项目是什么

STM32F407ZGT6 机器人抓取系统：**舵机夹爪 + 单按键 + 4 台 EMM V5 步进电机**，用于机器人比赛。

| 项 | 值 |
|---|---|
| 工作区目录 | `D:\study\project\robot-competition` |
| 主工程 | `ghr/10.15/`（**要改的就是这个**） |
| 参考示例 | `xrw/例35 视觉XY接近跟随(1)(2)/`（视觉跟随，用 USART1 控制台）、`xrw/例36 Z轴单独上升/`（按键控制 Z 轴，**实测好用**） |
| 远程仓库 | `git@github.com:2186279865/robot-10.15.git`（SSH，不需要代理） |
| SSH 私钥 | `D:\study\git\key\id_ed25519`（全盘唯一，**不要放进仓库**） |
| 分支 | `main` |
| 编译器 | Keil MDK V5.39 + **ARMCC V5.06 update 6 (build 750)**，**禁止换 AC6** |
| Keil 安装位置 | `D:\study\keil`（UV4 在 `D:\study\keil\UV4\UV4.exe`，ARMCC 在 `D:\study\keil\ARM\ARMCC\Bin`） |
| 目标器件 | `STM32F407ZGTx`，Pack `Keil.STM32F4xx_DFP.3.1.1` |
| 工程文件 | `ghr/10.15/Project/STM32F407.uvprojx`（含调试工程 `STM32F407_diag.uvprojx`） |
| 固件产物 | `ghr/10.15/Project/Objects/STM32F429.hex`（**名字里的 429 是历史遗留，实际是 407，故意不改**） |
| 下载方式 | **ST-Link + Keil 按 F8**（`STM32F407.uvoptx:117` 指向 `ST-LINKIII-KEIL_SWO.dll`；`uvoptx` 被 gitignore，每个队友要各自重选一次调试器） |

### 硬件接线（现状，已实测）

| 功能 | 引脚 | 说明 |
|---|---|---|
| 舵机抓夹 | **PB6** = TIM4_CH1 | 50Hz PWM，脉宽 500~2500us ↔ 0~270° |
| 按键 | **PA0** | **内部下拉 `GPIO_PuPd_DOWN`，按下读到高**（这是铁律，见四-②） |
| 步进电机 | **PA2** = USART2_TX | 115200 8N1，**只发不收**，PA3 未配置 |
| 调试串口 | **PA9/PA10** = USART1 | 文档标"预留"，**固件里零实现**；上位机就用它 |
| LED | **PC13** | 低电平点亮（`LED1_ON` = ResetBits） |
| 步进电机地址 | Z=**1**、托盘=**3**、X=**4**、Y=**5** | 全部挂同一条 PA2 总线，靠地址区分 |
| 电机驱动器电源 | **独立 12~48V** | 只靠 USB/5V 供电电机绝对不会转 |
| 舵机电源 | 4.8~7.4V | 与大电流电机分开供 |
| 共地 | STM32 GND ↔ 驱动器电源 GND | **必须共地**，不共地表现为"程序在跑但电机纹丝不动" |

---

## 二、当前状态（截至 2026-10-16）

### 2.1 Git 状态

```
最新提交  6fb864c  docs: 新增交接文档（新对话先读这份）      ← 远端与本地一致
历史提交  8 条，追踪文件 391 个
origin/main = 6fb864c，ahead 0 / behind 0
```

**工作区有未提交的改动**（都在 `ghr/10.15/` 下，`xrw/` 一行未动）：

```
 M ghr/10.15/Drive/Include/stepper.h        +5   （新增 Stepper_ResetStallAt / RunSpeedAt2 声明）
 M ghr/10.15/Drive/Include/stepper_inline.h +32  （新增解堵转、带加速度速度模式）
 M ghr/10.15/Drive/Source/stepper.c         +32  （参考副本同步，**不参与编译**）
 M ghr/10.15/MY/main.c                      194 行改动（PA0 控制 1 号电机转/停）
?? ghr/10.15/MY/main_diag.c                 （新增：硬件联调诊断固件）
?? ghr/10.15/Project/STM32F407_diag.uvprojx （新增：诊断固件专用 Keil 工程）
?? ghr/10.15/上位机方案.md                   （新增：串口上位机设计方案）
```

**注意：这些改动还没有提交。** 详见 2.4 与第八节的建议。

### 2.2 已完成并验证的事

| 事项 | 状态 | 证据 |
|---|---|---|
| PA0 改成"按一下 1 号电机转、再按一下停" | ✅ **用户已确认"跑通了"** | `ghr/10.15/MY/main.c` |
| 起转参数问题定位与修复 | ✅ 已定位 | 旧版 RPM=300 + acc=128，加速度档位越大起转力矩越小 → 易触发堵转保护；改成 acc=1 + RPM=60，并加自动换档 |
| 正式固件编译 | ✅ 0 Error 0 Warning | `Code=3308`，产物 `Objects/STM32F429.hex` |
| 诊断固件编译 | ✅ 0 Error 0 Warning | `Code=3044`，产物 `Objects/STM32F429_diag.hex` |
| 帧格式正确性 | ✅ 反汇编逐条核对 | 见 2.3 |
| 串口上位机 | ❌ **仅有方案，未写代码** | `ghr/10.15/上位机方案.md` |

### 2.3 反汇编核对结论（帧编码已排除嫌疑）

用 `fromelf --text -c -o dis.txt Objects/STM32F429.axf` 反汇编后逐条核对：

- `build_speed` @`0x08000b78`：`o[0]=addr`、`o[1]=0xF6`、`o[2]=dir`、`o[3]=rpm>>8`、`o[4]=rpm`、`o[5]=accel`、`o[6]=0`、`o[7]=0x6B`，返回 8 ✅
- `build_stop` @`0x08000ba2`：`FE 98 00 6B` ✅；`build_enable` @`0x08000b56`：`F3 AB on 00 6B` ✅
- `main` @`0x08000bbc`：参数阶梯表在 `0x08000e78`（`003c,01 / 003c,00 / 0078,01 / 012c,01 / 001e,01`），循环里 `LDRH`+`LDRB` 取值传给 `build_speed` ✅
- `Stepper_SendFrame` @`0x080007f0`：USART2 基址 `0x40004400`，逐字节等 TXE(0x80)、末尾等 TC(0x40) ✅
- **教训：想验证帧编码不能用二进制搜常量** —— 帧是运行时在栈上逐字节构造的，不是常量数组，搜 `01 F6 ...` 永远 0 命中。**必须看反汇编。**

因此**按一下 PA0 实际发出的字节就是 `01 F6 00 00 3C 01 00 6B`**（地址 1、CW、60RPM、acc=1），停止是 `01 FE 98 00 6B`，使能是 `01 F3 AB 01 00 6B`。

### 2.4 本地备份快照（已被 gitignore，勿加进 Keil 工程）

`.gitignore` 有 `**/backup_*/` 规则，这些目录不会入库：

```
ghr/10.15/backup_before_pa0_pulldown_20261015_205054/
ghr/10.15/backup_before_inline_gripper_20261015_211202/
ghr/10.15/backup_before_toggle_20261016_135500/     ← PA0 toggle 改之前的 main.c
ghr/10.15/backup_before_accfix_20261016_135752/     ← 加参数阶梯之前的 main.c
```

---

## 三、编译与下载

### 3.1 命令行编译（无需开 Keil GUI）

```powershell
& 'D:\study\keil\UV4\UV4.exe' -b 'D:\study\project\robot-competition\ghr\10.15\Project\STM32F407.uvprojx' -j0 -o 'D:\...\build.log'
```

- **exit 0 = 成功**，失败会返回非 0，日志里看 `Error(s)`。
- ⚠️ `UV4 -h` **不会打印帮助，会打开 GUI**，别用。
- `xrw/例36/build_check.ps1` 里假设 `D:\ARM\ARMCC507\bin\armcc.exe` 存在 —— **该路径不存在，不能用**。
- 全量重编：先清空 `Project/Objects/` 和 `Project/Listings/`。

### 3.2 反汇编核对（本机唯一能"看机器码"的手段）

本机**没有模拟器、没有 gcc/clang/cl**，无法运行 ARM 代码。只能用：

```powershell
& 'D:\study\keil\ARM\ARMCC\Bin\fromelf.exe' --text -c -o Objects\dis.txt Objects\STM32F429.axf
& 'D:\study\keil\ARM\ARMCC\Bin\fromelf.exe' --bin -o Objects\img.bin Objects\STM32F429.axf
```

### 3.3 两个 Keil 工程的分工

| 工程 | 编译的入口 | 产物 | 用途 |
|---|---|---|---|
| `STM32F407.uvprojx` | `MY/main.c` | `Objects/STM32F429.hex` | **正式固件**：PA0 按键控制 1 号电机转/停 |
| `STM32F407_diag.uvprojx` | `MY/main_diag.c` | `Objects/STM32F429_diag.hex` | **诊断固件**：位置模式，每 2.5s 走半圈，自动换档试参数 |

诊断固件用 **FD 位置模式**（例36 里 Z 轴实测好用的那条指令），上电闪 **2 下**（正式固件闪 1 下），用来区分烧的是哪支。**电机跟着节奏一动一动 = 驱动器/电源/共地/地址/接线全部 OK；全程静止 = 硬件或接线问题。**

---

## 四、三条特殊约定（**违反会直接出 bug**）

### ① 模块实现放在 `Drive/Include/*_inline.h` 里

**原因**：Keil 保存时会用**内存里的旧文件列表**覆盖 `.uvprojx`，外部加进去的文件会丢。

- `MY/main.c:8-13` 的三行 `#include "gripper_inline.h"` / `"key_inline.h"` / `"stepper_inline.h"` **就是实现代码**，删了会 Undefined symbol。
- **`Drive/Source/gripper.c`、`Drive/Source/stepper.c` 是参考副本，不参与编译**；把它们加进 Keil 工程会 **Multiply defined symbol**。
- ⚠️ **例外**：`Drive/Source/servo.c` 是**真实参与编译的**（定义 `Servo_Init`/`Servo_SetAngle`/`Servo_AngleToPulse`）。"Source 下都是参考副本"这句话对 `servo.c` 不成立。`key.c` 根本不存在。
- **推论：加新模块不要新建 `.c` 再加进工程**，写成 `*_inline.h` 由 `main.c` include 即可，`.uvprojx` 完全不用动。

### ② 按键 PA0 必须内部下拉、按下读到高

```c
key.GPIO_Mode = GPIO_Mode_IN;
key.GPIO_PuPd = GPIO_PuPd_DOWN;   /* key_inline.h:34 —— 不要改成 UP */
```

**照例36。之前用上拉绕了很久都读不到按键。** `KEY_DEBOUNCE_MS=20`、`KEY_TASK_MS=1`；`Key_Poll(now)` 要求**先松开过一次**才认下一次按下，长按不会连发。

### ③ 源文件编码是 GBK / UTF-8 **混合**的，不要批量转码

**实测结果**（逐个文件用 UTF-8 严格解码验证）：

| 编码 | 文件 |
|---|---|
| **GBK** | `MY/main.c`、`MY/main_diag.c`、`MY/stm32f4xx_it.c`、`Drive/Source/delay.c`、`Drive/Source/led.c`、`Drive/Include/delay.h`、`Drive/Include/led.h` |
| **UTF-8** | `MY/stm32f4xx_conf.h`、`MY/stm32f4xx_it.h`、`Drive/Include/stepper.h`、`stepper_inline.h`、`key.h`、`key_inline.h`、`gripper.h`、`gripper_inline.h`、`servo.h`、`Drive/Source/servo.c`、`gripper.c`、`stepper.c` |
| **UTF-8（文档）** | 所有 `.md` |

> ⚠️ 上一版交接文档说 `stepper.h`/`stepper_inline.h` 是 GBK —— **那是错的**，它们其实是 UTF-8。这里已更正。

**读文件的方法**：`read` 工具遇到 GBK 文件会报 `invalid UTF-8 text`，改用：
```powershell
$gbk=[System.Text.Encoding]::GetEncoding(936)
[IO.File]::ReadAllText('ghr\10.15\MY\main.c', $gbk)
```

**写文件的建议**：改 `main.c` 就**保持 GBK**（用上面的 Encoding 写回）；改 `stepper.h`/`stepper_inline.h` 就**保持 UTF-8**；新增的 `.c/.h` 建议跟同目录邻居一致。**不要用工具批量转码。**

---

## 五、固件架构与模块参考

### 5.1 编译清单（`.uvprojx` 里实际编的 12 个源文件）

```
MY      : main.c          ← 主逻辑（GBK）
          stm32f4xx_it.c  ← SysTick_Handler → TimingDelay_Decrement()
Drive   : Source/led.c  Source/delay.c  Source/servo.c
STM32   : startup_stm32f40_41xxx.s  system_stm32f4xx.c  misc.c
          stm32f4xx_rcc.c  stm32f4xx_gpio.c  stm32f4xx_usart.c  stm32f4xx_tim.c
```

**⚠️ `stm32f4xx_dma.c` 不在清单里 → 本工程固件没有 DMA 可用。**

IncludePath：`..\STM32\CMSIS\Device\ST\STM32F4xx\Include;..\STM32\CMSIS\Include;..\STM32\STM32F4xx_StdPeriph_Driver\inc;..\MY;..\Drive\Include`
Define：`USE_STDPERIPH_DRIVER,STM32F40_41xxx`；优化档 O0，C99。

### 5.2 模块接口速查

**`Drive/Include/stepper.h`**（**UTF-8**）

| 宏 | 值 |
|---|---|
| `STEPPER_ADDR_Z / TRAY / X / Y` | `1U / 3U / 4U / 5U` |
| `STEPPER_MOTOR_1..4 / COUNT` | `1U,2U,3U,4U / 4U` |
| `STEPPER_SPEED_RPM / ACCEL / PULSES_PER_REV` | `300U / 128U / 3200UL` |
| `STEPPER_MOVE_WAIT_MS / TURNS_PER_PRESS` | `6000UL / 1U` |
| `STEPPER_DIR_POSITIVE / NEGATIVE` | `0U / 1U` |

函数（行号为当前文件）：

```c
void     Stepper_Init(void);                                                  /* :44  配 USART2(PA2)+TIM2 1ms */
uint8_t  Stepper_EnableAt(uint8_t addr, uint8_t on);                          /* :47  F3 */
uint8_t  Stepper_ZeroHereAt(uint8_t addr);                                    /* :48  0A 6D 位置清零 */
uint8_t  Stepper_ResetStallAt(uint8_t addr);                                  /* :49  0E 52 解堵转【本次新增】 */
uint8_t  Stepper_MoveRelativeAt(uint8_t addr,uint8_t dir,int32_t pulses,uint32_t wait_ms);
uint8_t  Stepper_MoveRelativeAt2(uint8_t addr,uint8_t dir,int32_t pulses,uint16_t rpm,uint8_t accel,uint32_t wait_ms);
uint8_t  Stepper_MoveAbsoluteAt(uint8_t addr,uint8_t dir,int32_t pulses,uint32_t wait_ms);
uint8_t  Stepper_RunSpeedAt(uint8_t addr, uint8_t dir, uint16_t rpm);          /* :57  F6，accel 固定 0 */
uint8_t  Stepper_RunSpeedAt2(uint8_t addr,uint8_t dir,uint16_t rpm,uint8_t accel); /* :58 【本次新增】 */
uint8_t  Stepper_StopAt(uint8_t addr);                                        /* :59  FE */
uint8_t  Stepper_NudgeAll(uint8_t dir, uint16_t rpm, uint32_t run_ms);
uint8_t  Stepper_SendFrame(const uint8_t *frame, uint8_t len);                /* :71  已够健壮，回读复用 */
uint32_t Stepper_Millis(void);                                                /* :74  TIM2 1ms，不占 SysTick */
uint8_t  Stepper_LoopbackTest(void);                                          /* :81  回环自检（会发 0x55/0x56 垃圾字节）*/
uint8_t  Stepper_Read(uint8_t *byte);                                         /* :84  ⚠️ 有声明、无实现 */
uint8_t  Stepper_RxError(void);                                               /* :85  ⚠️ 有声明、无实现 */
```

> **`Stepper_Read`/`Stepper_RxError` 是原作者给回读预留的空接口** —— 做上位机回读功能时正好填上它们。

**`gripper.h`**：`GRIPPER_STEP_DEG 45U`、`OPEN_DEG 180U`、`GRAB_DEG 0U`、`STEP_WAIT_MS 200U`；`Gripper_Grab/Release/GrabNow/ReleaseNow/GetAngle/IsGrabbed/IsOpen`。
**`servo.h`**（**真实编译**）：`SERVO_PORT GPIOB`、`SERVO_PIN GPIO_Pin_6`、`MIN_US 500`、`MAX_US 2500`、`MAX_ANGLE 270`；`Servo_Init`、`Servo_SetAngle(uint16_t)`、`Servo_AngleToPulse(uint16_t)`。
**`key.h`**：`KEY_PORT GPIOA`、`KEY_PIN GPIO_Pin_0`、`DEBOUNCE_MS 20`、`TASK_MS 1`；`Key_Init`、`Key_Poll(uint32_t now)`、`Key_TaskDelay()`。
**`led.h`**：`LED1_PIN GPIO_Pin_13`、`LED1_PORT GPIOC`、`LED1_ON/OFF/Toggle`、`LED_Init()`。
**`delay.h`**：`Delay_Init()`、`Delay_ms(uint32_t)`。**没有 `Delay_us`。**

### 5.3 定时器/中断占用

| 资源 | 用途 | 备注 |
|---|---|---|
| TIM2 + TIM2_IRQn | 1ms 软件毫秒计数（`Stepper_Millis`） | NVIC 抢占优先级 **1**；加新中断时**不要抢它的优先级** |
| TIM4_CH1 / PB6 | 舵机 50Hz PWM | Prescaler=83, Period=19999 → 1MHz/50Hz |
| SysTick | `Delay_ms` | `delay.c:23` `SysTick_Config(SystemCoreClock/1000)` |
| USART2 + 空 ISR | 电机发送 | `stepper_inline.h:108-110` 是空 `USART2_IRQHandler`，回读时直接填 |
| USART1 / PA9 / PA10 | **空闲，未配置** | 上位机就用这里 |

---

## 六、串口通信协议

### 6.1 EMM V5 驱动器协议（PC→固件→驱动器）

115200 8N1，**帧尾固定 `0x6B`**（不是 CRC），多字节参数**大端**。

| 功能 | 帧 | 长度 |
|---|---|---|
| 使能 | `[addr] F3 AB state snF 6B` | 6 |
| 速度模式（持续转） | `[addr] F6 dir vel_H vel_L acc snF 6B` | 8 |
| 位置模式 | `[addr] FD dir vel_H vel_L acc clk[4] raF snF 6B` | 13 |
| 立即停止 | `[addr] FE 98 snF 6B` | 5 |
| 解除堵转 | `[addr] 0E 52 6B` | 4 |
| 位置清零 | `[addr] 0A 6D 6B` | 4 |
| 同步触发 | `[addr] FF 66 6B` | 3 |
| 查询实时转速 | `[addr] 35 6B` | 3 |
| 查询实时位置 | `[addr] 36 6B` | 3 |
| 查询状态标志 | `[addr] 3A 6B` | 3 |

**回包（例36 已实测的长度表，直接复用，别自己猜）**：

| 功能码 | 回包长度 | 格式 |
|---|---|---|
| `0x1F` 版本 | **5** | 字段含义待现场确认 |
| `0x35` 转速 | **6** | `addr 35 dir spd_H spd_L 6B` |
| `0x36` 位置 | **8** | `addr 36 dir p31:24 p23:16 p15:8 p7:0 6B` |
| `0x3A` 状态 | **4** | **位定义待现场抓包确认** |
| `0x3B` 回零 | **4** | 待补 |
| `0xFD` 到位通知 | **3** | `addr FD 9F 6B` |
| 其它未知功能码 | — | **一律拒绝解析**（注释原文："不猜测未知/可变长度回复"） |

**多机同总线注意**：① 连发多条命令**帧间至少 10ms**（否则驱动器接收被粘包打断）；② 查询命令**一次只查一个地址**，等回包或超时后再查下一个；③ 广播地址 0 只用于同步触发，不用于查询。

**⚠️ 别照抄协议文档里的 DMA 代码**：根目录 `EMM_V5_串口协议与工程指令总结.md:17-26` 说的 `Src/Emm_V5.c`、`Src/usart.c` **不是本仓库的文件**（没有这些路径，也没有 HAL 库），那是**厂家自己的 HAL + DMA + IDLE 中断**示例工程。本工程是标准外设库，且 `stm32f4xx_dma.c` 不在编译清单里。所以**只搬帧格式，收发用 RXNE 中断 + 环形缓冲**（例35/例36 的做法，已实测）。

### 6.2 PC ↔ 单片机 上位机协议（**设计中，未实现**）

```
PC → 单片机:  $12,motor_speed,1,1,120*3F\n
单片机 → PC:  #12,ok,addr=1,rpm=120*4A\n
              #0,tele,addr=1,vel=118,pos=1024,flag=0x21*7D\n   ← 主动上报
```

- `<id>` 是 PC 递增的请求号，固件原样回填，用于配对请求/应答。
- `*CS` 是 `$`/`#` 与 `*` 之间所有字节的**逐字节异或**，两位十六进制 —— 防的是电机大电流时串口位翻转。
- `\n` 分帧，行缓冲上限 96 字节，超长丢弃并回 `E06`。
- 错误码 `E01` 未知命令 / `E02` 参数越界 / `E03` 地址越界 / `E04` 驱动器无回包 / `E05` 回包格式错 / `E06` 行超长 / `E07` 校验和错 / `E08` 未使能就运动。
- 命令表、GUI 布局、里程碑详见第七节。

---

## 七、★ 串口上位机方案（本次新增，重点）

**完整设计文档：[`ghr/10.15/上位机方案.md`](上位机方案.md)（422 行）。** 这里只摘要点，细节看那份。

### 7.1 用户已拍板的决策

| 议题 | 决定 |
|---|---|
| 固件侧通信机制 | **接受**加双向命令层（USART1 收命令 → 固件转发/驱动） |
| 电机回读接线 | **接回读线**（驱动器 TXD → PA3），要能读位置/速度/堵转 |
| 上位机形态 | **Python 桌面 GUI（tkinter）** |
| 第一期范围 | ① 手动控制 ② 参数在线读写 ③ 动作序列编排/重放 |
| 硬件条件 | **已有 USB 转串口模块，3.3V 电平** ✅ |

### 7.2 架构（核心决定：上位机**不**直接对驱动器发帧）

```
PC ──USART1(PA9/PA10)──► 固件命令解析层 ──► 现有 stepper_inline.h ──PA2──► EMM 驱动器（地址 1/3/4/5）
                          ▲                                              │
                          └──────── 回包解析 ◄── PA3 ◄───────────────────┘
```

理由：① 只有走单片机才能读到按键/LED/固件状态；② PC 串口是 5V 电平，物理上接不进驱动器总线；③ 固件层能做限速、超时自动停等保护。

### 7.3 ★ 最大发现：两块关键代码在 `xrw/` 里已有**跑通过的成品**，应当移植而非重写

| 要移植的东西 | 现成实现位置 |
|---|---|
| **USART1 控制台全套**：环形缓冲 `RxRing`、`gpio_uart()`/`uart_setup()`（PA9/PA10, 115200）、`Console_GetCommand/Write/TakeRxError/FlushRx`、`USART1_IRQHandler` | `xrw/例35 …/HARDWARE/EMM/emm_port.c:11,30,41,68-70,158-188,203` |
| **软件急停**：主机发单字节 `'!'` 立即 latch 停止 | `xrw/例35 …/emm_port.c:199` |
| 行协议先例：PC 发 `id,x,y`，STM32 回 `ACK,<id>` | `xrw/例35 …/HARDWARE/EMM/motion_sequence.c:256-278` |
| **EMM 回包解析器**：`reply_length()` 长度表 + `EmmParser_Feed()` 按地址重同步 + `Emm_DecodePosition()` | `xrw/例36 …/HARDWARE/EMM/emm_protocol.c:5-17,21-49,88-98` |
| 电机接收环缓冲 `motor_rx[]` + `Read/Flush/RxError` | `xrw/例35 …/emm_port.c:147-157`（正好填 `stepper.h:84-85` 的空接口） |

**例35 的视觉跟随正是靠这条 USART1 控制台在跑，引脚/波特率与本工程完全一样** —— 说明通信链路可以继承一份已验证的实现。真正要新写的只剩"命令分发层"（约 300 行）。

### 7.4 固件侧要实现的东西

| 文件 | 动作 |
|---|---|
| `Drive/Include/usart_inline.h` | **新增**（GBK）：移植例35 控制台 + 新写行命令解析与分发 `Usart_CommandTask()` |
| `Drive/Include/emm_reply.h` | **新增**（GBK）：移植例36 长度表与解析器，补 `Emm_DecodeSpeed()` |
| `Drive/Include/stepper_inline.h` | 小改：`stepper_inline.h:99` 改 `USART_Mode_Tx \| USART_Mode_Rx`；补 PA3 配置；填 `USART2_IRQHandler`；**实现** `Stepper_Read`/`Stepper_RxError` |
| `MY/main.c` | 小改：`#include "usart_inline.h"`、上电 `Usart_Init()`、主循环 `Usart_CommandTask()` |
| `Project/STM32F407.uvprojx` | **不动**（头文件靠 `#include` 展开） |

**必须非阻塞**：所有"等电机走到位"的地方做成状态机，禁止在主循环 `Delay_ms(大数)`，否则上位机以为掉线。

### 7.5 里程碑

| 期 | 内容 | 验收标准 |
|---|---|---|
| **第一期** | 移植 USART1 控制台 + 命令解析 + `ping`/`motor_*`/`servo_angle`/`raw`；PC 侧串口连接、控制面板、原始报文日志、（不接硬件也能跑的）虚拟后端 | 点 GUI"起转"，1 号电机真的转；日志能看到 `$…` 发出、`#…` 应答、以及 PA2 上的原始帧 |
| **第二期** | PA3 回读 + 填 `USART2_IRQHandler` + 移植例36 解析器 + `motor_query`/`tele`；PC 侧实测值显示 + 曲线 | 显示数字与电机实际状态一致；堵转时状态位变色 |
| **第三期** | `param_get/set`（可选 Flash 保存）、`tele` 限流、离线看门狗；PC 侧参数面板 + 动作序列编辑器 | 不改代码就能试出合适转速/加速度；一键跑完整抓取序列 |
| **第四期** | 错误码补全、协议文档成文；PyInstaller 打包 exe、README | 拷给队友就能用，不需要装 Python |

### 7.6 硬件要动一次的地方

1. USB 转 TTL（3.3V）：`TXD→PA10`、`RXD→PA9`、`GND→单片机 GND`。**必须 3.3V，5V 会烧 PA9/PA10。**
2. 回读线，三选一（**4 个驱动器的 TX 不能直接并联**，会互相短路）：
   - **方案 A（推荐）**：`驱动器1 TXD → PA3`，只回读 1 号，风险最低。
   - **方案 B**：每个驱动器 TXD 串一个二极管（或 1kΩ）再并入 PA3。
   - **方案 C**：RS-485 + MAX485 半双工，最干净但要加芯片。
3. PA3 要配 `GPIO_Mode_AF` + `GPIO_AF_USART2` + **上拉**（悬空时拉高，不会误触发 RXNE —— 这正是原作者只发不收的原因）。

### 7.7 还没定的事

1. 上位机放哪个目录（建议 `ghr/10.15/上位机/`，不碰 Keil 工程）。
2. 要不要"PC 断连 3 秒自动停全部电机"看门狗（安全，但断线重连可能打断正在跑的动作）。
3. `param_set` 只存 RAM 够不够，要不要写 Flash。
4. 提交策略：一期一提交，还是全做完再提交。

---

## 八、待办

### 🔴 高优先级

1. **把当前未提交的改动提交并推送**（现在这些成果只在本地，没有备份到远端）。建议提交信息：
   ```
   feat(10.15): PA0 改为控制 1 号电机转/停，新增解堵转与带加速度速度模式
   fix(10.15): 起转参数由 300RPM/acc128 改为 60RPM/acc1 并加参数阶梯自动换档
   feat(10.15): 新增硬件联调诊断固件 main_diag.c 与独立 Keil 工程
   docs(10.15): 新增串口上位机设计方案
   ```
2. **开工上位机第一期**（方案已评审通过 4 项决策，见 7.1）。

### 🟡 中优先级

3. **邀请队友**：GitHub → repo → Settings → Collaborators → Add people → 权限选 **Write**。
4. 账号 `2186279865` 疑似个人账号，若比赛要求组织账号需早处理。
5. 抓夹夹紧位在 0° 时需要按 4 下 —— 待确认是机械还是参数问题。
6. `stepper.h:37 STEPPER_TURNS_PER_PRESS` 与 `STEPPER_MOVE_WAIT_MS` 目前是**死代码**（main 走速度模式），按"速查表"去改圈数不会有任何效果，建议清理或明确用途。

### ✅ 已解决（留档）

- ~~在硬件上确认步进电机能转~~ → 2026-10-16 用户确认"跑通了"。
- ~~PA0 按键读不到~~ → 内部下拉解决（见四-②）。

---

## 九、踩过的坑（含上一版 8 条）

1. **改 `.uvprojx` 会被 Keil 覆盖** —— 所以模块实现写成 `*_inline.h`。**在 Keil 开着的时候别在外部改工程文件**；同理，**Keil 开着时它会缓存旧版 `main.c`，如果不先 Close Project 就按保存，会把我改的内容覆盖回去。**
2. **`gripper.c`/`stepper.c` 加进工程会重复定义** —— 它们是参考副本；但注意 `servo.c` **是**真编的。
3. **按键必须内部下拉**（PA0，按下为高）—— 用上拉会绕很久读不到。
4. **不要批量转码** —— GBK/UTF-8 混合。
5. **`xrw/例36/build_check.ps1` 假设的 armcc 路径不存在** —— 用 `D:\study\keil`。
6. **`UV4 -h` 会打开 GUI**，不是打印帮助。
7. **不能用二进制搜常量验证帧编码** —— 帧是运行时在栈上构造的，必须看反汇编。
8. **别照抄协议文档的 DMA 代码** —— 那是厂家 HAL 工程，本工程没有 DMA。
9. **电机不转先查硬件**：驱动器 12~48V 电源、STM32 与驱动器**共地**、PA2 接的是不是驱动器 RXD、地址拨码是不是 1。
10. **加速度档位越大，起转力矩越小** —— `acc=128` + 300RPM 会因起转无力触发堵转保护而纹丝不动；`acc=0/1` 才是近乎直接启动。
11. **堵转保护一旦触发，只发 F6/FD 也不会转** —— 必须发 `0E 52` 解堵转或断电重启。所以上电先发一帧 `0E 52` 成本极低。
12. **Keil 保存时用内存里的旧文件列表覆盖工程**（同 1，但这是根因）。
13. **会话工作区目录被移走会导致所有工具失效**（上一版记录）。
14. **`read` 工具读 GBK 文件报 `invalid UTF-8`** —— 改用 `[System.Text.Encoding]::GetEncoding(936)`。

---

## 十、文档地图

| 文档 | 行数 | 内容 |
|---|---|---|
| `交接文档-20261016.md` | 本文 | **新对话先读这份** |
| `交接文档.md` | 189 | 上一版（提交 `6fb864c`），信息较旧但硬件/仓库部分仍有效 |
| `ghr/10.15/上位机方案.md` | 422 | **串口上位机完整设计方案**（架构/协议/GUI/里程碑/风险/依据行号） |
| `EMM_V5_串口协议与工程指令总结.md` | 732 | EMM V5 驱动器的**全部帧格式、回包格式、解码公式**；作者明确说可作上位机接口参考 |
| `ghr/10.15/新手联合开发完整教程.md` | 1253 | 从注册账号讲起的 Git/Keil 上手教程；**第四节引脚表在 674-693 行** |
| `ghr/10.15/CONTRIBUTING.md` | 223 | 协作规则、三条铁律、引脚表（244 行） |
| `README.md` | 92 | 仓库结构、构建环境 |

**参考资料（只读，不要改）**：

| 路径 | 能参考什么 |
|---|---|
| `xrw/例36 Z轴单独上升/` | **实测好用的按键控制 Z 轴**；`HARDWARE/EMM/` 下的 `app_config.h` 是全部可调参数；`emm_protocol.c` 有回包长度表和解析器 |
| `xrw/例35 视觉XY接近跟随(1)(2)/` | **USART1 控制台实现**（`emm_port.c`）、PC 行协议先例（`motion_sequence.c:256-278`）、软件急停 `'!'` |

---

## 十一、环境与工具

| 项 | 值 |
|---|---|
| 工作目录 | `D:\study\project\robot-competition` |
| Shell | **PowerShell 7**（用户 2026-10-16 指定） |
| 文件策略 | `danger-full-access`，审批已关闭；**不要请求提权** |
| Keil | `D:\study\keil`（UV4 + ARMCC V5.06 update 6） |
| fromelf | `D:\study\keil\ARM\ARMCC\Bin\fromelf.exe` |
| 本机**没有** | 模拟器、gcc/clang/cl、能运行 ARM 代码的东西 → 一切验证靠**反汇编 + 上板实测** |
| git 提交 | 用户 SSH key 已配好；`git fetch` 可直连 GitHub，不需要代理 |
| 只改范围 | **只允许改 `ghr/10.15/`，`xrw/` 一行不碰** |

---

## 十二、约定与红线

- ✅ 只改 `ghr/10.15/`，`xrw/` 只读
- ✅ 模块实现放 `*_inline.h`，不动 `.uvprojx`
- ✅ PA0 保持内部下拉
- ✅ 不批量转码；改 GBK 文件就写回 GBK
- ✅ 不换编译器（ARMCC V5.06 update 6，AC6 关闭）
- ✅ 不把密钥、`backup_*`、`Objects/` 提交进仓库（`.gitignore` 已覆盖）
- ❌ 不把 `gripper.c`/`stepper.c` 加进 Keil 工程
- ❌ 不在主循环里用长 `Delay_ms` 阻塞（做上位机功能时尤其重要）
- ❌ 不照抄协议文档里的 DMA 收发代码
