2186279865/robot-10.15/02-资料库/06-交接与教程/交接文档.md

# 交接文档（新对话请先读这份）

> 生成时间：2026-10-16
> 用途：把当前进度完整交给下一个对话/下一个人，避免重复摸索。
> **先读本文，再读 [README.md](README.md) 和 [新手联合开发完整教程.md](ghr/10.15/新手联合开发完整教程.md)。**

---

## 一、30 秒速览

| 项目 | 值 |
|---|---|
| 工程 | STM32F407ZGT6 机器人抓取（舵机夹爪 + 按键 + EMM V5 步进电机） |
| 代码位置 | **`D:\study\project\robot-competition`** |
| 主工程 | `ghr/10.15/`（Keil 工程、源码都在这） |
| 参考示例 | `xrw/例35 ...`（视觉 XY 跟随）、`xrw/例36 ...`（按键 + Z 轴升降） |
| 远程仓库 | `git@github.com:2186279865/robot-10.15.git`（**SSH，不需要代理**） |
| 当前提交 | `dab6d77`，7 条历史，390 个文件，工作区干净 |
| SSH 密钥 | **`D:\study\git\key\id_ed25519`**（唯一一把，已登记到 GitHub） |
| 编译器 | Keil MDK V5.39 + **ARMCC V5.06 update 6**（不能换 AC6） |

---

## 二、当前固件在做什么

`ghr/10.15/MY/main.c`：

```
上电：
  1. 串口回环自检（PA2↔PA3 短接则回显），LED 闪 1/2/3 次报告结果
  2. Stepper_StopAll() → Stepper_EnableAll(1) → 等 500ms     （照例36 的顺序）
  3. Gripper_Init()  舵机停到松开位 180°

按 PA0 一次：
  1. 抓夹收紧一步 45°（180 → 135 → 90 → 45 → 0，到 0 停止）
  2. 全部电机（地址 1~4）以速度模式 F6 转 1 秒，然后 FE 停车
  3. 方向每次按键交替（正 / 负）
```

**各模块参数**（要调参改这些宏）：

| 模块 | 头文件 | 关键参数 |
|---|---|---|
| 舵机 | `Drive/Include/servo.h` | PB6 / TIM4_CH1 / 50Hz；500~2500us ↔ 0~270° |
| 抓夹 | `Drive/Include/gripper.h` | `OPEN_DEG=180`、`GRAB_DEG=0`、`STEP_DEG=45`、`STEP_WAIT_MS=200` |
| 按键 | `Drive/Include/key.h` | **PA0 内部下拉、按下读到高**；`DEBOUNCE_MS=20`、`TASK_MS=1` |
| 步进 | `Drive/Include/stepper.h` | PA2 / USART2 / 115200；地址 Z=1 托盘=3 X=4 Y=5；`SPEED_RPM=300`、`ACCEL=128`、`PULSES_PER_REV=3200` |

---

## 三、⚠️ 这个工程的三个特殊约定（不知道就会踩坑）

### 1. 模块实现放在 `*_inline.h` 里，不是 `.c`

`MY/main.c` 里有这几行，**它们是实现代码，删了会链接报 `Undefined symbol`**：

```c
#include "gripper_inline.h"
#include "key_inline.h"
#include "stepper_inline.h"
```

原因：**Keil 保存工程时会用内存里的旧文件列表覆盖 `.uvprojx`**，导致从外部加进去的 `.c` 不被编译。所以把实现放进头文件，由 `main.c` 编译时带进来，**不需要改工程文件**。

因此 `Drive/Source/gripper.c`、`stepper.c` 是**参考副本，当前不参与编译**。不要把它们加进 Keil 工程——会 `Multiply defined symbol`。

> 已记入 `新手联合开发完整教程.md` 第 6 章"铁律一"。

### 2. 按键是"内部下拉 + 按下为高电平"

```c
key.GPIO_PuPd = GPIO_PuPd_DOWN;   // PA0
```

这是从 **例36**（唯一按键实测好用的工程）照抄的。**之前用"上拉 + 按下为低"绕了很久都读不到**，改成下拉立刻正常。改按键代码时务必保持这个极性。

### 3. 源文件是 GBK / UTF-8 混合编码

- **GBK**：`Drive/Source/delay.c`、`led.c`、`Drive/Include/delay.h`、`led.h`、`MY/stm32f4xx_it.c`
- **UTF-8**：`MY/main.c`、`servo.h`、`gripper*.h`、`key*.h`、`stepper*.h`、`servo.c`、`gripper.c`、`stepper.c`

ARMCC 两种都能编译，**不要为了"统一"批量转码**（会让 diff 整个文件变红）。用 Keil 编辑最安全。

---

## 四、Git 与推送

### 正常流程

```powershell
cd D:\study\project\robot-competition
git pull
# 改代码 → Keil F7 编译 → F8 下载验证
git add -A
git commit -m "说明"
git push
```

### 关键事实

| 事项 | 说明 |
|---|---|
| 远程协议 | **SSH**（`git@github.com:...`）→ **不需要开代理**，实测 4 秒推完 |
| 密钥位置 | `D:\study\git\key\id_ed25519`（**全盘唯一**，已加到 GitHub） |
| `~/.ssh/config` | 指向 D 盘密钥，内容 6 行（见文末附录） |
| 凭证助手 | `credential.helper = manager`（HTTPS 备用通道也能用） |
| 全盘代理 | `http.proxy` 已清空（原来指向未开启的 `127.0.0.1:7897`，会挡住操作） |

### 如果推送报错

| 报错 | 原因 | 解决 |
|---|---|---|
| `Permission denied (publickey)` | 密钥丢了或没登记 | 确认 `D:\study\git\key\id_ed25519` 在；公钥在 https://github.com/settings/keys 里 |
| `Failed to connect ... over proxy` | 你在用 HTTPS 且代理没开 | 打开代理，或改用 SSH |
| `non-fast-forward` | 队友先推了 | `git pull --rebase` 再推 |

---

## 五、踩过的坑（避免重复）

| # | 坑 | 结论 |
|---|---|---|
| 1 | 10.15 舵机不动 | 一度以为是舵机代码问题。反汇编比对证明 `Servo_Init` 与例35 `S20_Servo_Init` **指令序列完全一致**，舵机通路没问题 |
| 2 | **按键一直读不到** | **根因：极性搞反**。必须用 `GPIO_PuPd_DOWN`（照例36），不要用上拉。这是踩最久的坑 |
| 3 | 步进电机不转 | 一度归因于 USART2 配置（原来开了 Rx+RXNE 中断），后改为**纯发送**（照例35/36 `EMM_TX_ONLY`）。**但用 SSH 推送成功不代表电机已转——这块尚未在硬件上确认** |
| 4 | Keil 覆盖 `.uvprojx` | 外部改工程文件会被 Keil 保存时覆盖 → 模块实现改用 `*_inline.h` 方案 |
| 5 | `*.uvopt` 规则写错 | 应为 `*.uvoptx`，否则本机调试设置会误入库（已修正并移除） |
| 6 | 私钥进了工程目录 | `.git-ssh/` 残留过，**已删除**；`.gitignore` 已加防密钥规则 |
| 7 | 旧私钥随临时目录消失 | 已改用 `D:\study\git\key`，不再依赖临时目录 |
| 8 | 会话工作区目录被移走 → 所有工具失效 | `pwsh`/`glob`/`read` 都以会话工作区根为基准。**若报 `realpath ... 不存在`，请在 `C:\Users\rs\Desktop\机器人校赛` 建一个空文件夹** |

---

## 六、硬件接线

| 功能 | 引脚 | 外设 | 说明 |
|---|---|---|---|
| 舵机（抓夹） | **PB6** | TIM4_CH1，50Hz | 500~2500us ↔ 0~270° |
| 按键 | **PA0** | GPIO 输入，**内部下拉** | 按下读到高 |
| 步进电机 | **PA2** | USART2 TX，115200 8N1 | 只发不收，PA3 留空 |
| 板载 LED | **PC13** | GPIO 输出 | 低电平点亮 |
| 调试串口 | PA9 / PA10 | USART1 | 预留 |

**电源**：步进驱动器需独立 **12~48V** 电机电源；舵机需 **4.8~7.4V**；**都必须和 STM32 共地**。

**电机地址**：Z=1、托盘=3、X=4、Y=5（同一条 PA2 总线靠地址区分）。

---

## 七、待办 / 下一步

| 优先级 | 事项 |
|---|---|
| 🔴 高 | **在硬件上确认步进电机能转**（目前只验证到"代码会发帧"，未确认电机动作） |
| 🔴 高 | **邀请队友**：https://github.com/2186279865/robot-10.15/settings/access → `Add people` → 角色 **Write** |
| 🟡 中 | `2186279865` 看起来是**个人账号**。若与队友共用，则无法区分谁提交了什么——建议队友注册自己账号 |
| 🟡 中 | 抓夹"夹紧位置"目前是 0°（需按 4 下到位）。若实际机械只需走一步，改 `GRIPPER_GRAB_DEG` 或把 main 里的 `Gripper_Grab()` 换成 `Gripper_GrabNow()` |
| 🟢 低 | 步进电机地址/圈数若与实物不符，改 `stepper.h` 里的 `STEPPER_MOTOR_1..4`、`STEPPER_TURNS_PER_PRESS` |

---

## 八、常用文件速查

| 想做什么 | 改这里 |
|---|---|
| 改按键动作 | `ghr/10.15/MY/main.c` 的 `while(1)` 循环 |
| 调抓夹角度/步进 | `ghr/10.15/Drive/Include/gripper.h` |
| 调按键消抖 | `ghr/10.15/Drive/Include/key.h` |
| 调电机速度/地址/圈数 | `ghr/10.15/Drive/Include/stepper.h` |
| 调舵机脉宽 | `ghr/10.15/Drive/Include/servo.h` |
| 加忽略规则 | **仓库根** `.gitignore`（不在 `ghr/10.15/` 里） |
| 看协议 | `EMM_V5_串口协议与工程指令总结.md` |
| 队友上手 | `ghr/10.15/新手联合开发完整教程.md` |

---

## 附录：`~/.ssh/config` 内容（换电脑需重建）

```
Host github.com
    HostName github.com
    User git
    IdentityFile D:/study/git/key/id_ed25519
    IdentitiesOnly yes
    StrictHostKeyChecking accept-new
```

> ⚠️ 私钥 `D:\study\git\key\id_ed25519` 是**全盘唯一**的，请自行备份到安全位置（U 盘/加密网盘）。
> **绝不能提交到仓库或发给他人**——仓库已确认不含任何密钥文件（有 `.gitignore` 规则防护）。
