2186279865/robot-10.15/01-交付包/stm32/docs/固件-速度版默认值-20261031.md

# 固件「速度版默认值」改动说明（2026-10-31）

> 给队友（以及队友的 AI）看的变更说明：**改了哪个文件、改了哪几项、为什么必须改、怎么合并、怎么编译烧录、怎么自检、怎么回滚**。
> 读这份就能判断「我这边的代码会不会被影响」，不用去翻整份交接文档。

## 0. 一句话结论

只改了 **一张参数默认值表里的 4 个初值**（`01-交付包/stm32/firmware/Drive/Include/host_protocol_inline.h` 的 `host_param_defaults`），
**没有改任何协议命令、字段、帧格式、状态机**。
目的是让 MCU 复位/断电重新上电后，不用点「初始化」就已经是速度版（`speed_rpm_max=3200 / acc=0 / telemetry_ms=100 / gripper_ready_deg=168`）。

## 1. 为什么非改固件不可

`host_protocol_init()` 每次上电都会把运行参数恢复成 `host_param_defaults` 里那一份（源码注释写得很明白：
「MCU 复位后参数一定回到默认」）。所以只要默认值还是 `speed_rpm_max=300`、`acc=1`：

- 上位机「X/Y 并行」用 `motor_pos` 发 **Y 轴 2000 圈/分**，固件会判 `rpm > speed_rpm_max` → 回 `reason=speed_limit`；
- 上位机只能退化成「X 先走、Y 再顺序补走」，肉眼看到 **X/Y 分开走**，每件多花 0.5~1 s；
- `acc=1`（默认带加速度斜坡）比 `acc=0` 慢一个数量级；
- `telemetry_ms=200` 让编码器回读偏旧（上位机的 counts 龄期经常 >400 ms）。

**现场证据（2026-10-31 02:37 那一批）**：STM32 重启后启动号变成 `00000001`，参数全部回到默认；
一手抬到 3200 之后 `move_xy_fast` 的 `finally` 又把值改回旧值 300，于是全批 **12 次 Y 并行全被 `speed_limit` 拒**。
上位机侧也已同步修好（见第 5 节），但**根子只有改默认值才彻底**。

## 2. 改了哪个文件

| 项 | 值 |
| --- | --- |
| 文件 | `01-交付包/stm32/firmware/Drive/Include/host_protocol_inline.h` |
| 表 | `static const host_param_def_t host_param_defaults[]`（全工程只有这一份） |
| 改动行 | 表中 4 行 + 表上方一段注释（说明改动理由），其余 22 行未动 |

`Drive/Include/*_inline.h` 是**真正被编译进去**的实现；`Drive/Source/gripper.c`、`Drive/Source/stepper.c` 只是参考副本，改它们不生效（这个坑以前踩过）。

## 3. 逐项改动

| 参数 | 旧默认 | 新默认 | 为什么 | 影响面 |
| --- | --- | --- | --- | --- |
| `acc` | `1` | `0` | `acc=1` 带加速度斜坡，实测慢约 10 倍；本项目全程用 `acc=0`（零加速） | 任何依赖「默认有斜坡」的调用方需自己下发 `acc=1` |
| `speed_rpm_max` | `300` | `3200` | 这是 `motor_speed` / `motor_pos` 的**手动转速上限**；`motor_pos` 的 X/Y 并行要用 2000 圈/分 | 只放宽了上限，不会自己变快；不安全时可随时 `param_set` 降回 |
| `gripper_ready_deg` | `150` | `168` | 现场标定的「预备（待抓）」角；上位机连上后还会推存盘值（`host/runtime/gripper.json`），这里只是让「没连上位机时」也正确 | 夹爪 `ready` 命令/pin 回位角度变化 |
| `telemetry_ms` | `200` | `100` | 编码器回读周期；上位机默认也是 100 ms，回读更新鲜 → 并行残差保护少误判 | 串口流量略增（约 +5 帧/秒/轴） |

其余 22 项（`speed_rpm`、`goto_rpm`、`goto_final_rpm`、`goto_tol_counts`、`goto_max_passes`、`goto_max_ms`、
`link_timeout_ms`、`heartbeat_ms`、`query_timeout_ms`、`frame_gap_ms`、`readback_mask`、`counts_per_rev`、
`gripper_open_deg`、`gripper_grab_deg`、`gripper_step_deg`、`gripper_settle_ms`、`gripper_hold_max_ms`、`angle_tol_counts` …）**一个都没动**。

### 特别说明：`speed_rpm_max` 只管两条命令

- 只在 `host_cmd_motor_speed()` 与 `host_cmd_motor_pos()` 里检查 `rpm > speed_rpm_max`，超限回 `reason=speed_limit` + `max=<当前值>`。
- **`motor_goto`（闭环 goto）不看 `speed_rpm_max`**，它看 `goto_rpm`（命令里可带，默认 300）。
  所以现场 Z 轴用 2400 圈/分走 `motor_goto` 一直没问题，只有 Y 并行用的 `motor_pos` 会被拒 —— 这一点以前排查时很容易看错。

## 3.5 追加（2026-10-31 03:5x）：闭环 goto 的时序提速（同一文件、两处常量）

现场用户要求「Z 轴还能再快」。追日志后发现**光把转速从 2400 抬到 2800 反而更慢**
（Z 单趟 1474 ms → 1848/2182 ms，`passes` 从 0 变 1~2）：因为驱动器停得比 350 counts 稍偏，
固件就用 `goto_final_rpm`（默认 **60 圈/分**）补走一整趟 —— 补的那几步位移不到 1 mm，
**时间全花在「等停稳 + 20 ms 总线空档 + 慢速补走」这套固定开销上**。
所以这轮改的是「固定开销」，不是再堆转速：

| 位置 | 旧值 | 新值 | 为什么 |
| --- | --- | --- | --- |
| `host_goto_estimate_ms()` 末尾 | `return ms + 250U;` | `return ms + 60U;` | 250 ms 只是「等它走完」的保险，而后面 `HOST_GOTO_SETTLE` 本来就会等 counts 停稳；每趟白等约 190 ms（Z 四趟/件 ≈0.76 s） |
| `#define HOST_GOTO_STABLE_NEED` | `2U` | `1U` | 遥测 100 ms 一份，要求连续 2 份「没动」= 再白等一份；`delta<=40 counts` 本身已经等价于停住，1 份就够 |

语义没变（状态机、命令、应答字段都没动），只是少了两次固定等待。
配合上位机侧「Z 转速 2400→3000 + Z 闭环容差 350→1500 counts」，Z 满行程单趟预计从实测 **1.62 s → 约 1.1 s**。

## 4. 编译（Keil，命令行可跑）

```powershell
# 工程：01-交付包/stm32/firmware/Project/STM32F407.uvprojx（ARMCC V5.06 update 6）
& 'D:\study\keil\UV4\UV4.exe' -b 'D:\study\project\robot-competition\01-交付包\stm32\firmware\Project\STM32F407.uvprojx' -j0 -o 'D:\study\project\robot-competition\01-交付包\stm32\firmware\Project\Objects\uv4_build.log'
```

- 成功判据：日志末尾 `".\Objects\STM32F429.axf" - 0 Error(s), 0 Warning(s).`
- 产物：`01-交付包/stm32/firmware/Project/Objects/STM32F429.hex`（**注意目标名是 STM32F407，但输出文件名历史上叫 STM32F429.hex**，别被名字骗了）
- 发布用 hex 要**手工复制**到 `01-交付包/stm32/hex/STM32F429.hex`（仓库里只维护这「一份当前 hex」）。

## 5. 上位机侧配套改动（同一个 commit，一起 merge）

这些改动**不依赖烧录**也生效，是「复位后还没连上位机」之外的兜底：

1. `01-交付包/host/protocol.py`：`PARAM_DEFAULTS` 与固件逐项对齐（`speed_rpm_max=3200 / acc=0 / telemetry_ms=100 / gripper_ready_deg=168`），
   否则「参数页显示的默认值」和板子复位后的真实值会不一致；`GRIPPER_READY_DEG=168`。
2. `01-交付包/host/host_gui.py`：**连接成功即下发速度版参数**（`acc=0 / speed_rpm_max=3200 / goto_max_ms=120000 / telemetry_ms=100`），
   并在日志里打一行 `[连接] 参数快照：speed_rpm_max=… acc=… telemetry_ms=…`，看日志就知道板子上跑的是不是速度版。
3. `01-交付包/host/prep_pose.py`：`move_xy_fast` **不再把 `speed_rpm_max` 还原**（原 `finally` 会把它改回旧值，是 X/Y 分开走的直接原因）；
   被 `speed_limit` 拒绝时**抬高限速并原地重发同一轴**，不退化成顺序补走。
4. `01-交付包/host/prep_pose.py`：`EFFECTIVE_RPM_CAP` 从 `50` 改成 `2740` —— 旧值把 Z 满行程估成 122 s，导致「回执早到了、后台还在等超时」（现场 02:39:37 已回 `#265,ok`，02:41:37 才报超时）。
6. `01-交付包/host/protocol.py`：`GOTO_RPM_BY_AXIS[1]`（Z）**2400 → 3000**，并新增 `GOTO_TOL_BY_AXIS`（Z 闭环容差 **1500 counts** ≈0.044 mm，其余轴 350）；
   `prep_pose` 里 4 处 `client.goto(...)` 都把该容差传下去。理由见 3.5 节：容差贴着边会触发 60 圈/分的慢补走，放宽容差 + 提转速才是净收益。
   **一行回滚**：`protocol.GOTO_RPM_BY_AXIS[1] = 2400`（容差可保持 1500，不会变慢）。
7. `01-交付包/host/host_client.py`：E10 自动清锁存重发、链路判定 8 s→15 s、运动类回执超时 1.5 s→3 s；
   `01-交付包/vision`：云端单次封顶 6 s、>3.5 s 熔断 120 s（现场图传挤爆链路时的兜底，详见上位机交接文档 §8 第 19/20 条）。

5. `01-交付包/host/host_gui.py` / `calib_tab.py`：后台抓取线程改用 `done_of` 轮询回执（不再用会抢 GUI 事件队列的 `wait_reply`）；
   遥测到的 counts 直接回写 `soft_pos`（修「被拒的 motor_pos 也记账 → 软位置漂到 +140570 脉冲 → 算出一万五千脉冲的假位移被 RANGE 拦停」）。

## 6. 合并建议（给队友的 AI）

- **改默认值 = 单文件小 diff**：`01-交付包/stm32/firmware/Drive/Include/host_protocol_inline.h`（4 行 + 注释）。
  直接 cherry-pick 我们这个 commit，或手工照第 3 节改这 4 个数即可；**不需要动任何 `.c`**。
- 队友如果同时改了这个头文件，按 hunk 合并：只保留 `host_param_defaults` 表里那 4 行数值，注释块可整段带走。
- 合并后务必做一次「协议回归」：`host_param_get/param_set` 表顺序、`param_get` 回包字段名都不变，但请重跑一遍他们的单元测试。
- 兼容性检查清单（改别人代码前先 grep 这几点）：
  - 有没有代码**假定** `speed_rpm_max` 默认是 300（例如自己先 `param_set` 再判断）？
  - 有没有依赖 `acc` 默认 = 1 的斜坡行为（位置精度/丢步）？
  - `telemetry_ms` 减半后串口/接收缓冲是否吃得下（按 100 ms × 4 轴估算）。
  - `gripper_ready_deg` 默认 168 会不会和他们的夹爪标定冲突？（上位机连上会推存盘值覆盖）
- **不要**只改上位机不改固件：复位后未连接的瞬间仍是旧默认值，且队友如果直接用串口脚本（不连上位机）就会拿到旧值。

## 7. 烧录

- 本机**没有** STM32CubeProgrammer / ST-Link CLI（只有虚拟串口驱动），所以：
  - 用 Keil 打开工程 → `Flash → Download`（F8）烧 `STM32F429.hex`；或
  - 用 STM32CubeProgrammer（GUI）选 `01-交付包/stm32/hex/STM32F429.hex` 烧录。
- 烧录前把机械臂挪到安全位（Z 抬到顶、X/Y 在通道外），烧录会复位 MCU，参数表按新默认值初始化。
- 步骤细节见同目录 `烧录与编译.md`。

## 8. 烧完自检清单（3 分钟）

1. 上电/复位后**不要点「初始化」**，先 `param_get` 四个值：`speed_rpm_max=3200`、`acc=0`、`telemetry_ms=100`、`gripper_ready_deg=168`。
2. 手动发一次 `motor_pos 5,0,2000,0,20000,rel`：应被接受（不再 `reason=speed_limit`）。
3. 观察 telemetry 频率：约 10 Hz/轴（100 ms）。
4. 上位机连上后看日志：`连接成功：速度版参数已下发 …` + `[连接] 参数快照：speed_rpm_max=3200 …`。
5. 点一次「一键启动」，一件节拍应在 **10~15 s**（2.29 版现场 11.9~15.3 s；本轮 Z 提速后预期再省 1.5~2 s/件）；若明显更慢，先查第 3 节四项是否真的生效，再看日志里 Z 的 `elapsed_ms`（新参数应 ≈1000~1200 ms，旧 2400 圈/分是 ≈1600 ms）。

## 9. 如果你手里只有 hex，怎么快速确认是不是这版

Keil 把 4 个默认值放在这几个位置（本版编译产物，`Objects/STM32F429.hex`）。用文本方式看对应记录行即可
（第 1 个 u16 是 `value`，小端）：

| 记录起始 | 期望字节（value, LE） | 含义 |
| --- | --- | --- |
| `:107D3000` | `0000` | `acc = 0`（旧版是 `0100`） |
| `:107D4000` | `800C` | `speed_rpm_max = 3200`（旧版是 `2C01`=300） |
| `:107D6000` | `A800` | `gripper_ready_deg = 168`（旧版是 `9600`=150） |
| `:107DE000` | `6400` | `telemetry_ms = 100`（旧版是 `C800`=200） |

> 地址是「本版 + 当前编译选项」下的结果；队友改了代码后地址可能漂移，只适合作为**交叉验证**，
> 真正的判据还是烧上去 `param_get`。

## 10. 回滚

- 固件回滚：`git show <旧commit>:01-交付包/stm32/hex/STM32F429.hex` 取回旧 hex 重新烧（本轮之前的版本是 commit `db429f6` 的 hex）。
- 上位机回滚：`git reset --hard pre-speedup-20261031-0213`（2026-10-31 凌晨的「一档提速」稳定版）。
- 只想关掉某项提速、不改固件：`param_set speed_rpm_max,300` / `param_set acc,1` 即可临时回到保守值（复位后又会变回速度版默认值）。

## 11. 联系/上下文

- 上位机交接文档：`02-资料库/交接文档-20261031.md`（架构、参数、坑、现场操作卡）。
- 本轮上位机改动与验证：**271 个单元测试全绿** + `main.py --selftest` 8/8 页。
- 本版固件编译产物：`Code=31624 RO-data=1152 RW-data=532 ZI-data=7396`，Keil 0 Error 0 Warning。
- 现场验收口径：**以「2.29 版」（commit `e268d02`，真机 6 件 88.1 s、单件 11.9~15.3 s）为质量红线，新版本只能更好不能变差**。
