2186279865/robot-10.15/02-资料库/04-历史快照/final-20261021/ghr/10.15/上位机方案.md

# 串口上位机调试工具 —— 设计方案（v1，待评审）

> 目标：在 PC 上做一个图形化工具，用一根串口线连到单片机，实现对步进电机 / 舵机夹爪的**手动控制、参数在线调整、动作序列编排与重放**，并能**看到电机真实状态**（转速、位置、堵转/到位标志）。
> 本文只做方案，不含实现代码。评审通过后按第 10 节的里程碑分期开发。

---

## 0. 一句话架构

```
┌─────────────── PC ───────────────┐        ┌──────────── STM32F407 (ghr/10.15) ────────────┐        ┌─ EMM V5 驱动器 ─┐
│  上位机 GUI (Python)             │        │  新增：串口命令层 (usart_inline.h)            │        │                │
│  ┌──────────┐  ┌──────────────┐  │  USB   │  ┌──────────┐   ┌──────────────────────────┐  │  PA2   │  1 号 (地址01) │
│  │ 串口收发 │  │ 命令/日志/   │  │◄──────►│  │ 帧解析器 │──►│ 现有模块                  │──┼───────►│  3 号 (地址03) │
│  │ 帧编解码 │  │ 曲线/序列    │  │ 转 TTL │  │ 命令分发 │   │ stepper_inline.h (PA2 TX) │  │  PA3   │  4 号 (地址04) │
│  └──────────┘  └──────────────┘  │ PA9/10 │  └──────────┘   │ key_inline.h / gripper    │  │◄───────│  5 号 (地址05) │
│                                  │ USART1 │                 │ servo.c / led.c           │  │ 回读    │                │
└──────────────────────────────────┘        └───────────────────────────────────────────────┘        └────────────────┘
        （PC 只跟 USART1 说话）                （固件负责把 PC 命令翻译成 EMM 帧，在 PA2 上发出）
```

**关键设计决定：上位机不直接对驱动器发帧。** PC 的串口接的是 `USART1 / PA9(TX) PA10(RX)`，固件收到 PC 命令后由固件在 `PA2` 上发 EMM 帧。这样做的三个理由：

1. **能读状态**：驱动器回包走 `PA3` 进单片机，固件解析后回给 PC；如果 PC 直连驱动器总线，就绕过了单片机，读不到按键/LED/固件状态，而且 PC 串口是 5V/RS232 电平，接不进驱动器总线。
2. **不用改接线逻辑**：现在的 PA2 单总线已经在正常工作，不用把 PC 串口线并进去。
3. **安全**：固件可以做限位、超时自动停、转速上限，PC 崩了不会让电机失控。

---

## 1. 现状盘点（已核对源码）

### 1.1 ★关键发现：这两层在 `xrw/` 里都已经有**跑通过的成品**，应当移植而不是重写

| 要移植的东西 | 现成实现在哪 | 复用价值 |
|---|---|---|
| **USART1 控制台全套**：环形接收缓冲 `RxRing` + `Console_GetCommand()` + `Console_Write()` + `Console_TakeRxError()` + `Console_FlushRx()` + `USART1_IRQHandler` + PA9/PA10 初始化 | `xrw/例35 视觉XY接近跟随(1)(2)/HARDWARE/EMM/emm_port.c:11,30,41,68-70,158-188,203` | **这是最大的发现**：`例35` 的视觉跟随就是靠这条 USART1 控制台在跑（PC 发 `id,x,y` 行、STM32 回 `ACK,<id>`），硬件和引脚与本工程**完全一样**（PA9/PA10、115200）。**移植它 = 通信链路直接继承一份已验证的实现**，风险比重写低一个量级 |
| **软件急停**：主机发单字节 `'!'` 立即latch 停止 | `emm_port.c:199` `if(debug && b=='!') { stop_latched=1; return; }` | 白送一个"急停"能力，不用设计协议 |
| **EMM 回包解析器**：`EmmParser_Feed()` 按地址重同步 + `reply_length()` 长度表 + `Emm_DecodePosition()` | `xrw/例36 Z轴单独上升/HARDWARE/EMM/emm_protocol.c:5-17,21-49,88-98` | 回读解析**不用自己猜帧长**，直接搬长度表（见 4.6 节） |
| **电机接收环形缓冲**：`motor_rx[]` + `EmmPort_Read/Flush/RxError` | `emm_port.c:147-157` | 正好对应 `stepper.h:84-85` 已经声明但**从未实现**的 `Stepper_Read()` / `Stepper_RxError()` —— 说明原作者本来就预留了这个接口 |

> 移植时按本工程约定改写：放进 `Drive/Include/usart_inline.h`（GBK 编码），只保留单通道版本（`EMM_CHANNEL_COUNT=1`），去掉例35 的多通道/视觉/PD2 急停输入那些用不上的部分。

### 1.2 现状逐项核对

| 项目 | 现状 | 结论 |
|---|---|---|
| 调试串口 | `USART1 / PA9 / PA10` 在 `新手联合开发完整教程.md:682` 标为"预留"；**全工程源码里没有任何 USART1 初始化代码**（已 grep 确认无 `RCC_APB2Periph_USART1`、无 `USART1_IRQHandler`、无 `printf`/`fputc`） | 工程里没有，但**例35 里有完整可移植版** → 移植而非重写 |
| 电机串口 | `USART2 / PA2`，只发不收，`stepper_inline.h:99` `u.USART_Mode = USART_Mode_Tx;`，PA3 完全没配置（`:87` 注释"只配 TX，PA3 留空"） | 回读需要改成 `USART_Mode_Tx \| USART_Mode_Rx` 并配 PA3 |
| 电机中断 | `stepper_inline.h:108-110` 已有一个**空的** `void USART2_IRQHandler(void) {}`；`stepper.c:97-102`（不参与编译的参考副本）里还留着旧的"开 RXNE 中断"代码 | 回读直接在空 ISR 里填 `receive()` 即可，向量表不用动 |
| **已声明但未实现的接口** | `stepper.h:84` `uint8_t Stepper_Read(uint8_t *byte);`、`:85` `uint8_t Stepper_RxError(void);` —— 有声明、无实现 | 老接口原样留着，正好还给上位机用 |
| 发送实现 | `Stepper_SendFrame()`（`stepper_inline.h:114-140`）逐字节等 TXE、末尾等 TC、每位 10ms 超时，返回 1/0 | 够健壮，回读复用，不改 |
| 帧构造 | `build_speed`(F6) / `build_enable`(F3) / `build_stop`(FE) / `build_position`(FD) / `Stepper_ResetStallAt`(0E 52) / `Stepper_ZeroHereAt`(0A 6D) | 命令层的"执行"全部复用，不重写协议 |
| 键盘 | `key_inline.h`：PA0 内部下拉（`:34` `key.GPIO_PuPd = GPIO_PuPd_DOWN;`）、20ms 消抖、`Key_Poll()` | PC 命令层与按键层并存，不互相干扰 |
| LED | `led.h:8-15`：`LED1 = PC13`，低电平点亮 | 用作"上位机在线/命令执行"指示 |
| 舵机 | `servo.c` **真实参与编译**，TIM4+PB6（`servo.c:23-24` `Prescaler=83, Period=19999` → 1MHz/50Hz），`Servo_SetAngle()` 0~270° | 直接调用，无冲突 |
| 中断占用 | 只有 TIM2（`stepper_inline.h:57`）和 SysTick 是活的；USART2 ISR 是空壳 | 加 USART1 中断不冲突（NVIC 优先级注意别抢 TIM2） |
| 编译 | `STM32F407.uvprojx:13` `5060750::V5.06 update 6 (build 750)::ARMCC`、`:14` `<uAC6>0</uAC6>`、`:17` `STM32F407ZGTx`、`:317` `<Optim>1</Optim>`(O0)、`:329` `<uC99>1</uC99>` | 换编译器=重做验证，**不许换 AC6** |
| ⚠️ **DMA 不可用** | 根目录 `EMM_V5_串口协议与工程指令总结.md` 里的示例代码用 **DMA + IDLE 中断**做收帧，但 `stm32f4xx_dma.c` **根本不在 Keil 工程编译清单里** | **别照抄那份文档的 DMA 代码**（会链接失败或行为不对）；用中断收字节的方式，也就是例35/例36 的做法 |
| 下载方式 | `STM32F407.uvoptx:117` `STLink\ST-LINKIII-KEIL_SWO.dll` → **ST-Link + Keil 按 F8**；`*.uvoptx` 被 gitignore，每个队友要自己选一次调试器（`新手联合开发完整教程.md:448-491`） | 上位机不管下载，只管运行时通信 |
| 编码 | 源文件 GBK / UTF-8 混合 | 新增 `.c/.h` 用 GBK，文档用 UTF-8，**不批量转码** |

**结论：整套方案的改动量比预想的小得多** —— 发送、帧构造、消抖、舵机、**以及 USART1 控制台和 EMM 回包解析器**都已有成品；真正要新写的只有"把 PC 命令翻译成模块调用"的命令分发层（约 300 行）。

---

## 2. 硬件改动（需要你动一次烙铁/杜邦线）

### 2.1 必做

| # | 接线 | 说明 |
|---|---|---|
| 1 | PC 的 USB 转 TTL 模块 `TXD → PA10(RX1)`、`RXD → PA9(TX1)`、`GND → 单片机 GND` | **必须 3.3V 电平**（接 5V 会烧 PA9/PA10）。常用 CH340 / CP2102 / FT232 模块上都有 3.3V 档 |
| 2 | 单片机 `GND` ↔ 驱动器电源 `GND` | 这条**必须**共地，否则电机根本不动（`新手联合开发完整教程.md:695-699`、`CONTRIBUTING.md:247` 都点明了） |

### 2.2 回读接线（选做，第 4 节要用）

驱动器要回包就必须接它的 TX 出去。**多机同总线时不能把 4 个驱动器的 TX 直接并在一起**（会互相短路打架），有两个方案：

- **方案 A（推荐，简单）**：`驱动器1的 TXD → 单片机 PA3`，只回读 1 号。够验证"上位机能显示真实转速/位置"，调试期风险最低。
- **方案 B（全回读）**：给每个驱动器 TXD 串一个二极管（或 1kΩ）再并入 PA3，靠 EMM 的"只应答自己被点名的地址"特性避免冲突。**能工作但电气上不优雅**。
- **方案 C（工业做法）**：驱动器如果是 RS-485 接口，用 MAX485 收发器，单片机一个 GPIO 控 DE/RE 做半双工。最干净，但要加芯片。

> 不管哪个方案，`PA3` 要配成 `GPIO_Mode_AF` + `GPIO_AF_USART2` + 上拉（与 PA2 对称）。悬空时上拉把 RX 拉高，不会误触发（这也是原作者只发不收的原因，见 `stepper_inline.h:97-98` 的注释）。

### 2.3 电源

| 设备 | 电压 | 备注 |
|---|---|---|
| STM32 | 3.3V / 5V（板载） | — |
| 舵机 | 4.8~7.4V | 与大电流电机**分开供**，否则共电源会互相干扰 |
| EMM 驱动器 | **12~48V 独立电源** | 只靠 USB 供电绝对不会转 |

---

## 3. 固件侧设计

### 3.1 新增/修改文件一览（严格遵守交接文档约定①）

| 文件 | 动作 | 内容 |
|---|---|---|
| `Drive/Include/usart_inline.h` | **新增**（GBK） | **移植**例35 `emm_port.c:11,30,41,68-70,158-188,190-203` 的 USART1 控制台（保留单通道）：`RxRing` 环缓冲、`gpio_uart()`/`uart_setup()`、`Console_GetCommand/Write/TakeRxError/FlushRx`、`USART1_IRQHandler`；再加上**新写**的行命令解析器与命令分发 `Usart_CommandTask()`、回包发送 `Usart_Reply*()` |
| `Drive/Include/stepper_inline.h` | 小改 | ① `stepper_inline.h:99` `USART_Mode_Tx` → `USART_Mode_Tx \| USART_Mode_Rx`；② 补 PA3 的 GPIO/复用配置（与 PA2 对称，上拉）；③ 填充空的 `USART2_IRQHandler()`（`:108-110`），把驱动器回包写进环缓冲；④ **实现** `stepper.h:84-85` 已声明但空缺的 `Stepper_Read()`/`Stepper_RxError()`；⑤ 新增 `Stepper_QueryAt(addr, func)` 查询帧构造 |
| `Drive/Include/emm_reply.h` | **新增**（GBK） | 移植例36 `emm_protocol.c:5-17` 的 `reply_length()` 长度表 + `:21-49` 的 `EmmParser_Feed()` 重同步解析 + `:88-98` 的 `Emm_DecodePosition()`；再补 `Emm_DecodeSpeed()` |
| `MY/main.c` | 小改 | ① `#include "usart_inline.h"`；② 上电加 `Usart_Init()`；③ 主循环加 `Usart_CommandTask()`（1ms 轮询） |
| `Drive/Include/stepper.h` | 小改 | 新增 `Stepper_QueryAt` 声明 |
| `Drive/Source/stepper.c` | 小改 | 同步镜像（**不参与编译**，只为保持参考副本一致） |
| `Project/STM32F407.uvprojx` | **不动** | 头文件靠 `#include` 展开，不需要加进 Keil 文件列表 —— 这正是 `*_inline.h` 约定存在的意义 |

**注意**：`Usart_*` 的实现必须写在 `Drive/Include/usart_inline.h` 里（用 `static inline` 或在 main.c 的编译单元里展开），不能新建 `usart.c` 加进工程 —— 这是本工程踩过的坑：Keil 保存时会用内存里的旧文件列表覆盖 `.uvprojx`，新加的文件会丢。

### 3.2 主循环时序

```
while (1) {
    Usart_CommandTask();   // 解析收到的行命令并执行；不阻塞，最多处理 1 条
    Stepper_QueryPoll();   // 有回读时：驱动回包解析 + 应答 PC
    if (Key_Poll(ms)) { ...保留现在的 PA0 逻辑... }
    Key_TaskDelay();       // Delay_ms(1)
    ms += KEY_TASK_MS;
}
```

全部**非阻塞**：命令执行里凡是要"等电机走到位"的地方，都用状态机（`WAIT_300MS` → `WAIT_MOVE_DONE`），不能 `Delay_ms(5000)` 卡住主循环，否则上位机会以为单片机死了。

### 3.3 与按键共存

- PC 命令和 PA0 按键**都能**操作电机，互相不锁。
- PA0 按下时如果电机正在被上位机操作，按现有逻辑立刻停止（安全优先）。
- LED1 语义：常亮 = 电机运行中；快闪 = 正在执行上位机命令；慢闪 = 仅仅在线。避免和现在的"空闲心跳"冲突。

---

## 4. 通信协议设计（PC ↔ 单片机）

### 4.1 为什么用"文本行 + 逗号分隔"而不是二进制/JSON

| 方案 | 优点 | 缺点 | 结论 |
|---|---|---|---|
| 二进制定长帧 | 紧凑、解析快 | 出错时完全看不懂，每次加字段都要改两端 | ✗ |
| JSON | 扩展性最好 | 要在 ARMCC + 无 malloc 的 STM32 上**手写 JSON 解析器**，成本远大于收益 | ✗ |
| **文本行 + 逗号分隔 + 校验** | 串口助手直接能看懂/能手敲、解析器 50 行、出错能看见 | 每字节 1 个字符，比二进制大一倍 | **✓ 采用** |

### 4.2 帧格式

```
PC → 单片机（请求）：
    $<id>,<cmd>[,<arg1>[,<arg2>...]]*<CS>\n
    例： $12,motor_speed,1,1,120*3F\n

单片机 → PC（应答）：
    #<id>,ok[,<key=value>...]*<CS>\n          执行成功
    #<id>,err,<code>[,<msg>]*<CS>\n           执行失败
    例： #12,ok,addr=1,rpm=120*4A\n
         #12,err,E02*3C\n

单片机 → PC（主动上报，id 固定为 0）：
    #0,tele,addr=1,vel=118,pos=1024,flag=0x21*7D\n
```

- `<id>`：PC 自己递增的请求号，固件原样回填，用来配对"哪条命令回了什么"。
- `<CS>`：`*` 后面两位十六进制，对 `$`(或`#`) 与 `*` 之间的所有字节做**逐字节异或**。防的是串口在电机大电流干扰下的位翻转，这个是真实会遇到的。
- `\n` 结尾：只用 LF 作分帧符，丢弃 `\r`，PC 端（tkinter/Python）和串口助手都好处理。
- **行缓冲上限 96 字节**：超长直接丢弃并回 `E06`，防止缓冲区溢出。

### 4.3 命令表（第一期）

**电机（地址 1~5，广播用 0）**

| 命令 | 参数 | 固件动作 | 成功应答 |
|---|---|---|---|
| `motor_speed` | `addr,dir,rpm` | `build_speed` + 发帧；记录为"运行中" | `addr,rpm,dir` |
| `motor_pos` | `addr,dir,rpm,acc,pulses` | `build_position`（相对运动） | `addr,pulses` |
| `motor_stop` | `addr` | 连发两帧 FE（间隔 10ms） | `addr` |
| `motor_enable` | `addr,on` | F3 | `addr,on` |
| `motor_stall_clear` | `addr` | `0E 52` | `addr` |
| `motor_zero` | `addr` | `0A 6D`（当前位置清零） | `addr` |
| `motor_query` | `addr,what` | 发 `35`/`36`/`3A` 查询帧，等回包 | `vel=`/`pos=`/`flag=` |
| `motor_status` | — | 返回固件记录的运行状态 | `run=1,dir=1,rpm=120` |

**舵机 / 夹爪**

| 命令 | 参数 | 动作 |
|---|---|---|
| `servo_angle` | `deg` | `Servo_SetAngle(deg)`（0~270） |
| `gripper` | `open` \| `grab` \| `step` | 复用 `Gripper_Open/Grab/Step` 宏语义 |

**系统 / 参数**

| 命令 | 参数 | 动作 |
|---|---|---|
| `ping` | — | 回 `ver=1,fw=..,addr=id`，用于握手和探测在线 |
| `led` | `on` \| `off` \| `blink,n` | 调试用 |
| `param_get` | `name` | 读固件里的宏值（rpm/acc 上限、脉冲当量、舵机角等） |
| `param_set` | `name,value` | **运行期**改，存 RAM（可选存 Flash），掉电丢失 |
| `save` / `load` | — | 把运行期参数写/读 Flash（可选，第二期） |
| `version` | — | 固件版本、编译日期时间 |

**调试用（必须留）**

| 命令 | 参数 | 动作 |
|---|---|---|
| `raw` | `hex串`（如 `01F600007800006B`） | **原样**把字节发到 PA2 总线，用于协议层抓虫 |
| `raw_query` | `hex串` | 原样发 + 等回包并回显十六进制 |
| `echo` | `on/off` | 打开后固件把 PA2 收到的所有字节上报给 PC（调试回读时极其有用） |
| `reset` | — | 软复位（可选） |

### 4.4 错误码

| 码 | 含义 |
|---|---|
| `E01` | 未知命令 |
| `E02` | 参数错/越界（如 rpm>3000） |
| `E03` | 地址越界（合法 1~5，广播 0） |
| `E04` | 驱动器无回包（超时 100ms） |
| `E05` | 回包格式错（地址/功能码/帧尾不符） |
| `E06` | 行超长/缓冲满 |
| `E07` | 校验和错 |
| `E08` | 电机未使能就发运动命令 |

### 4.5 主动上报（遥测）

- 上位机周期性发 `tele_on,addr,interval_ms` 打开，`tele_off` 关闭（默认关，避免占带宽）。
- 固件每 `interval_ms`（默认 200ms）上报：`#0,tele,addr=1,vel=118,pos=1024,flag=0x21`
- 连发限流：单片机发送前检查 `USART1` TXE，发送函数与 `Stepper_SendFrame` 同样带超时，绝不阻塞主循环。

### 4.6 EMM 回包格式（固件解析用，已核对手册**和例36 的实测代码**）

例36 的 `emm_protocol.c:5-17` 里有一张**已经跑通的长度表**，直接移植，不要自己猜：

| 查询 | 发送帧 | 回包（字节数） | 解析 |
|---|---|---|---|
| 固件/硬件版本 `0x1F` | `[addr] 1F 6B` | **5** | 待补字段含义 |
| 实时转速 `0x35` | `[addr] 35 6B` | **6**：`addr 35 dir speed_H speed_L 6B` | `speed = H<<8\|L`，`dir!=0` 为负（手册 `:149-150`） |
| 实时位置 `0x36` | `[addr] 36 6B` | **8**：`addr 36 dir p31:24 p23:16 p15:8 p7:0 6B` | 32 位有符号 counts；`angle = raw*360/65536`（手册 `:170-175`） |
| 状态标志 `0x3A` | `[addr] 3A 6B` | **4** | 使能/到位/堵转位 —— **位定义待现场抓包确认** |
| 回零状态 `0x3B` | `[addr] 3B 6B` | **4** | 待补 |
| 到位通知 | 位置模式自动发 | **3**：`addr FD 9F 6B` | 运动到位（手册 `:325-329`） |
| 总线电压 `0x24` | `[addr] 24 6B` | 表里没有 | 想读要扩表，并现场确认长度 |
| 相电流 `0x27` / PID `0x21` | … | 表里没有 | 同上 |

**移植过来的解析器已经内建两条保护**，要保留：
1. `EmmParser_Feed()` 按**地址**重同步：丢字节直到 `bytes[0]==addr`，帧尾不是 `0x6B` 就丢掉一个字节重新同步 —— 串口被电机干扰时能自愈。
2. 长度表里**未知功能码一律返回 0（不解析）**，注释原文是"不猜测未知/可变长度回复"。这是对的，宁可报错也不要瞎解析。

> `3A` 的位定义和 `1F`/`24` 的字段布局，实现时先用 `raw_query` 命令现场抓一次真实回包，再写进解码器 —— 这样不依赖我对手册的转述。

### 4.6.1 ⚠️ 协议文档里的 DMA 示例是**厂家自己的工程**，不能照抄

先看清 `EMM_V5_串口协议与工程指令总结.md:17-26` 说的是什么：它整理的 `Src/Emm_V5.c`、`Src/usart.c`、`Src/stm32f4xx_it.c` **不是本仓库的文件**（本仓库里根本没有这些路径，也没有 HAL 库），而是**厂家 EMM V5 示例工程**（HAL 库 + DMA + IDLE 中断，见 `:41-44` `发送方式 DMA 普通模式 / 接收方式 DMA 循环模式 / 一帧结束判断 UART IDLE 中断`、`:526,553,565` 的 `HAL_UART_*` 调用）。

两个工程的技术栈完全不同：

| | 厂家示例工程 | 本工程 `ghr/10.15` |
|---|---|---|
| 库 | STM32 **HAL** | **标准外设库**（StdPeriph） |
| 收帧 | DMA 循环 + IDLE 空闲中断 | 无 DMA |
| DMA 可用性 | 有 | **`stm32f4xx_dma.c` 不在 Keil 编译清单里** |

**所以：协议栈只能搬"帧格式"，不能搬"DMA 收发代码"。** 本方案统一用**逐字节 RXNE 中断 + 环形缓冲**（例35/例36 的实际做法，已实测可用）。若将来真要用 DMA，得先把 `stm32f4xx_dma.c` 加进工程并处理 HAL→StdPeriph 的改写，属于单独一件事，不放进本期。**可以放心复用的是**：帧结构、帧尾 `0x6B`、大端字节序、以及例36 已经写好的回包长度表与解析器。

### 4.7 多机同总线的注意点

1. 连续给多个驱动器发命令，**帧间至少留 10ms**（`EMM_V5_串口协议与工程指令总结.md:728`），否则驱动器的接收会被粘包打断 —— 这就是现在 `motor_stop` 里两帧之间 `Delay_ms(10)` 的原因。
2. 查询命令**一次只查一个地址**，等回包（或超时）后再查下一个，不能并发，否则回包会撞在一起。
3. 广播地址 0 只用于 `sync`（`FF 66`）和使能，不用于查询。

---

## 5. 上位机设计

### 5.1 技术选型

- **Python 3 + tkinter**（标准库自带 GUI，双击即用）
- 串口：`pyserial`。考虑到开发机可能装不了包，代码里做**双后端**：
  - 装了 `pyserial` → 用真串口；
  - 没装 → 退化到 Windows 原生 `\\.\COMx` 文件读写（能用，但缺少超时/波特率设置能力）。
  - 另做**虚拟串口后端（simulator）**：不接硬件也能把整套 GUI 点一遍、验证协议解析和时序。**这一点很重要**，因为这台机器上没法仿真固件（无模拟器、无 gcc），上位机必须先能独立自测。
- 曲线：优先用 tkinter Canvas 手绘（零依赖）；若装了 matplotlib 则用它画得更漂亮。
- 打包（可选）：PyInstaller 出单个 `.exe`，方便拷到别的电脑。

### 5.2 文件结构（建议放 `ghr/10.15/上位机/`，不影响 Keil 工程）

```
上位机/
├── host_gui.py          # 主窗口 + 各面板
├── protocol.py          # 帧编解码、校验和、错误码（与固件一一对应，含自测）
├── serial_link.py       # 串口抽象：真实串口 / 虚拟串口 两种后端
├── emm.py               # EMM 回包解析（转速/位置/标志），可单独单测
├── sequence.py          # 动作序列模型、执行器（含超时与中止）
├── config.json          # 串口参数、电机地址映射、默认转速/加速度、序列库
├── logs/                # 原始报文日志（按启动时间命名）
└── README.md            # 使用说明：怎么接线、怎么选串口、怎么排错
```

### 5.3 界面布局

```
┌────────────────────────────────────────────────────────────────────────────┐
│ 串口: [COM5 ▼] 115200 [刷新] [连接] ●已连接   收 1234 字节 / 发 567 字节    │  ← 连接栏
├────────────────────────────────────────────────────────────────────────────┤
│ [电机控制] [舵机夹爪] [参数] [动作序列] [原始报文]                          │  ← 分页
├────────────────────────────────────────────────────────────────────────────┤
│ ▸ 电机控制                                                                  │
│   ┌ 电机 [1 ▼](地址1~5) ──────────────────────────────────────────────┐    │
│   │ 转速(60~3000) ─────●────── 120 RPM   加速度 ──●──── 128            │    │
│   │ 方向 [正转][反转]  [▶ 起转] [■ 停止] [⊙ 解堵转] [⌂ 位置清零]        │    │
│   │ 位置模式: 脉冲[ 3200 ] 圈数[ 1.0 ] [▶ 相对走] [▶ 绝对走]           │    │
│   │ 实测: 转速 118 RPM   位置 1024 (5.6°)   状态: 使能/已到位           │    │
│   └────────────────────────────────────────────────────────────────────┘    │
│   快捷: [全部使能] [全部停止] [全部解堵转]      ← 一键安全操作              │
├────────────────────────────────────────────────────────────────────────────┤
│ ▸ 原始报文 / 日志                                       [清空] [保存]      │
│   14:02:31.412  ▶ $12,motor_speed,1,1,120*3F                             │
│   14:02:31.425  ◀ #12,ok,addr=1,rpm=120*4A                               │
│   14:02:31.426  ⇒ PA2: 01 F6 00 00 78 00 00 6B      ← 固件上报的原始帧   │
└────────────────────────────────────────────────────────────────────────────┘
```

- **参数面板**：所有可调项（转速上限、加速度档、脉冲当量、舵机角度、按键消抖）以表格呈现，支持"读回/下发/保存到 config.json"，避免每次改参数都重编固件。
- **动作序列面板**：表格排列步骤，每行 = `延时 | 目标(电机n/舵机/夹爪) | 动作 | 参数`；支持增删行、上下移、保存/加载到 `config.json`、一键运行/暂停/急停；运行中高亮当前行。这一块直接对应你现在的抓取流程（托盘 → X/Y → Z 下降 → 夹紧 → 上升），一次编排就能复现整套动作。
- **曲线面板（第二期）**：转速/位置随时间滚动显示，用于判断加减速是否合理、是否丢步。

### 5.4 安全性设计（必须有）

| 层 | 措施 |
|---|---|
| 上位机 | 转速上限校验、脉冲数上限校验；`Ctrl+S` / 红色急停按钮随时可点；关闭窗口前自动发一次"全部停止" |
| 协议 | 每条命令带校验和；请求/应答带 id，超时 300ms 未收到应答就在日志里标红 |
| 固件 | PC 命令只允许在合法地址/参数范围内；`tele` 上报自动限流；**可选**："PC 离线 3 秒自动停止全部电机"看门狗（建议做，值可在参数面板配） |
| 物理 | 电机驱动器本身的堵转保护；`0E 52` 解堵转一键可达 |

---

## 6. 开发环境与依赖

| 项 | 方案 |
|---|---|
| PC 端运行 | Python 3.8+（先确认你机器上的版本），`pyserial` 可选 |
| 无第三方依赖也能跑 | 提供虚拟串口后端 + tkinter 手绘曲线 |
| 固件端 | Keil MDK + ARMCC V5.06 update 6（**不能换 AC6**，交接文档明确） |
| 新增文件入工程 | 手动在 Keil 里 Add Files 到 `Drive/Include`（其实头文件不用加，只加 `main.c` 即可因为 `#include` 展开）；**改完 .uvprojx 后别让 Keil 覆盖** |
| 版本管理 | 只动 `ghr/10.15/`，不碰 `xrw/`；上位机目录天然不进 Keil 工程 |

---

## 7. 测试计划（本机不能仿真固件，所以分层验证）

1. **协议自测**（纯 PC，不用硬件）：`protocol.py` 里对编解码/校验和做单元测试，跑 `python -m unittest`；用虚拟后端把 GUI 全流程点一遍。
2. **回环自测**（PC 单机）：把 USB 转 TTL 的 TXD 和 RXD 短接，上位机自己发自己收，验证串口层和分帧。
3. **固件命令层自测**（不接驱动器）：用 `raw`/`echo` 命令，让 PC 发帧、固件回报"我在 PA2 上发了什么"，比对字节是否与手工算的一致。
4. **单电机联调**：接 1 号驱动器 + 回读线，验证 `motor_speed`/`motor_stop`/`motor_query` 的实测值。
5. **全轴联调 + 序列重放**：接齐 4 个驱动器 + 舵机，跑一遍真实抓取序列。
6. **干扰测试**：电机大电流运转时观察校验和错误率（验证协议鲁棒性）。

---

## 8. 风险与对策

| 风险 | 影响 | 对策 |
|---|---|---|
| **照抄协议文档的 DMA 示例** | 编译/链接失败（`stm32f4xx_dma.c` 不在工程里） | 统一用 RXNE 中断 + 环形缓冲，见 4.6.1 |
| `pyserial` 装不上 | 上位机起不来 | 双后端设计 + 纯 tkinter，零依赖可跑 |
| 驱动器 TX 并总线冲突 | 回包乱码 | 先只接 1 号（方案 A）；全接时加二极管隔离 |
| `3A`/`1F` 回包位定义未知 | 状态解析错 | 先 `raw_query` 抓真实回包再写死；解析器强校验地址/功能码/帧尾，未知功能码拒绝解析 |
| Keil 覆盖 `.uvprojx` | 新文件从工程里消失 | 实现全放 `*_inline.h`，只改 `main.c` 的 include，**不动 `.uvprojx`** |
| 主循环被长动作阻塞 | 上位机以为掉线 | 所有等待做成状态机，禁止在主循环 `Delay_ms(大数)` |
| 调试串口与电机串口接反/接错 | 通信不通 | 上位机 `ping` 握手 + 日志显示原始字节；接线表写进 README |
| 3.3V/5V 电平接错 | 烧 PA9/PA10 | README 首行加粗警告 + 连接前自检清单 |
| 编码混乱（GBK/UTF-8） | Keil 里中文乱码、编译报错 | 新增 `.c/.h` 用 GBK；`.md` 用 UTF-8；**不批量转码** |
| USART1 中断抢 TIM2 优先级 | 1ms 时基抖动 → 消抖/超时判断漂移 | 给 USART1 设**低于** TIM2 的抢占优先级（TIM2 目前是 1） |

---

## 9. 待你确认的问题

1. **USB 转 TTL 模块**：你手上有没有？是哪种（CH340 / CP2102 / FT232）？能出 3.3V 电平吗？现在 PA9/PA10 是不是空的？
2. **回读接线**：接受第 2.2 节的方案 A（只回读 1 号）吗？还是想一次性把 4 个都回读（方案 B 加二极管）？
3. **Python 环境**：机器上装了 Python 吗、什么版本？允许 `pip install pyserial` 吗（还是要求零依赖）？
4. **离线看门狗**：要不要"PC 断连 3 秒自动停全部电机"？做的话安全，但断线重连时可能中断你正在跑的动作。
5. **参数是否存 Flash**：`param_set` 只存 RAM（掉电丢）够不够？要不要 `save` 写进 Flash 长期保存？
6. **上位机位置**：放 `ghr/10.15/上位机/` 可以吗？还是要单独一个仓库/目录？
7. **提交策略**：这次方案通过后，是一次性实现完再提交，还是每期提交一次？

---

## 10. 分期里程碑

| 期 | 固件侧 | PC 侧 | 验收标准（可观测） |
|---|---|---|---|
| **第一期** 打通控制 | **移植**例35 USART1 控制台（已验证过）+ 新写行命令解析 + `ping`/`motor_*`/`servo_angle`/`raw` | 串口连接、电机控制面板、原始报文日志、虚拟后端 | 点 GUI 上"起转"按钮，1 号电机真的转；日志里能看到 `$…` 发出、`#…` 应答、以及 PA2 上的原始帧 |
| **第二期** 看得见 | PA3 回读 + 填 `USART2_IRQHandler` + **移植**例36 长度表与 `EmmParser_Feed()` + `motor_query`/`tele` | 实测转速/位置显示、状态灯、曲线面板 | GUI 上显示的数字与电机实际状态一致；堵转时状态位变色 |
| **第三期** 可调可编排 | `param_get/set`（可选 `save/load`）、`tele` 限流、离线看门狗 | 参数面板、动作序列编辑器 + 一键重放 | 不改代码就能试出合适转速/加速度；一键跑完整抓取序列 |
| **第四期** 打磨 | 错误码补全、协议文档成文 | PyInstaller 打包 exe、README、异常自愈 | 拷给队友就能用，不需要装 Python |

## 11. 本方案的事实来源（便于复核）

| 结论 | 依据 |
|---|---|
| USART1 控制台可移植 | `xrw/例35 …/HARDWARE/EMM/emm_port.c:11,30,41,68-70,158-188,203` |
| 软件急停 `'!'` | `xrw/例35 …/emm_port.c:199` |
| EMM 回包长度表 / 重同步解析 / 位置解码 | `xrw/例36 …/HARDWARE/EMM/emm_protocol.c:5-17,21-49,88-98` |
| 电机 RX 环缓冲接口 | `xrw/例35 …/emm_port.c:147-157`，对应 `ghr/10.15/Drive/Include/stepper.h:84-85` 的空声明 |
| USART2 只发不收 / PA3 未配置 | `ghr/10.15/Drive/Include/stepper_inline.h:87,99` |
| USART1 在 ghr 中零实现 | grep 全工程无 `RCC_APB2Periph_USART1` / `USART1_IRQHandler` / `fputc` |
| DMA 不在编译清单 | `ghr/10.15/Project/STM32F407.uvprojx` 的 STM32 组文件列表无 `stm32f4xx_dma.c` |
| 协议文档的 DMA 示例来自厂家 HAL 工程 | `EMM_V5_串口协议与工程指令总结.md:17-26,41-44`（`Src/Emm_V5.c`/`Src/usart.c` 均不在本仓库） |
| 编译器/器件/优化档 | `STM32F407.uvprojx:13,14,17,317,329` |
| 下载用 ST-Link | `ghr/10.15/Project/STM32F407.uvoptx:117` |
| 协议帧格式与回包 | `EMM_V5_串口协议与工程指令总结.md:115-176,325-329,637-664,730` |
| 引脚/接线/共地要求 | `ghr/10.15/新手联合开发完整教程.md:674-699`、`CONTRIBUTING.md:244,247` |

---

## 附：与现有约定的兼容性检查

- ✅ 只改 `ghr/10.15/`，`xrw/` 一行不动
- ✅ 实现写在 `*_inline.h`，不新增 `.c` 到 Keil 工程（遵守交接文档约定①）
- ✅ `gripper.c` / `stepper.c` 仍不加进工程（避免 Multiply defined symbol）
- ✅ PA0 仍是 `GPIO_PuPd_DOWN`（约定②），按键功能保留
- ✅ 不批量转码（约定③），新增 C 文件用 GBK、文档用 UTF-8
- ✅ 不换编译器（ARMCC V5.06 update 6）
- ✅ 不碰 `Drive/Source/servo.c`（它是真实参与编译的，不是参考副本）
