2186279865/robot-10.15/02-资料库/04-历史快照/final-20261021/ghr/10.15/交接文档-上位机开工-TypeC-20261016.md

# 上位机开工交接：10.15 / Type-C USB CDC

更新时间：2026-10-16。本文供新对话接手开发，记录本次会话的最终决定、真实文件状态、已核对代码和开工顺序。

## 1. 接手后要做什么

用户准备让新对话开始实现上位机。目标是：通过开发板自带Type-C接口，以STM32原生USB CDC虚拟串口连接PC，完成四轴电机、舵机夹爪的手动控制、运行参数在线调整、动作序列编辑与重放，并显示已接回读轴的真实反馈。

最新方案是本目录的 **《上位机方案-v3-TypeC-CDC.md》**。v1、v2保留作历史参考，不能继续按其USART1 + USB转TTL路线开发。原《交接文档-20261016.md》中的硬件进展仍有参考价值，但部分事实已更正，见本文第12节。

本轮用户请求是写交接文档；本轮没有实现USB固件或PC上位机。新对话收到用户的开工指令后，应直接推进实现，不再重做整套方案讨论。

## 2. 工作区与必读文件

工作区：`D:\study\project\robot-competition`

| 优先级 | 路径 | 用途 |
|---|---|---|
| 1 | `ghr/10.15/交接文档-上位机开工-TypeC-20261016.md` | 本文，接手状态与实施注意事项 |
| 2 | `ghr/10.15/上位机方案-v3-TypeC-CDC.md` | 当前完整方案，约298行 |
| 3 | `C:\Users\rs\Desktop\机器人校赛\STM32F407VGT6_TypeC通信_标准库交接说明.md` | 用户提供的USB硬件与SPL移植说明 |
| 4 | `ghr/10.15/MY/main.c`及实际模块实现 | 当前固件真实行为，以源码为准 |
| 5 | `ghr/10.15/Project/STM32F407.uvprojx` | 编译器、器件、真正参与编译的文件 |
| 参考 | `EMM_V5_串口协议与工程指令总结.md` | 电机帧格式；HAL/DMA代码不能直接移植 |
| 参考 | `ghr/10.15/交接文档-20261016.md` | 早期调试记录，注意过时内容 |

USB说明提到的原理图：`C:\Users\rs\Downloads\1777026115896930.pdf`。本会话读取了交接说明，并未重新打开PDF或检查实物；后续若需确认供电、VBUS或CC线路，应实际查看图纸/实物，不能把转述写成自己测过。

## 3. 用户已确认的基准

### 3.1 四轴地址

| 轴 | 总线地址 |
|---|---|
| Z | 1 |
| 托盘 | 3 |
| X | 4 |
| Y | 5 |

用户明确确认1、3、4、5正确。`stepper.h`已修改为：

```c
#define STEPPER_MOTOR_1 STEPPER_ADDR_Z
#define STEPPER_MOTOR_2 STEPPER_ADDR_TRAY
#define STEPPER_MOTOR_3 STEPPER_ADDR_X
#define STEPPER_MOTOR_4 STEPPER_ADDR_Y
```

现有inline和参考副本的`stepper_all_addr[]`均引用这些宏，因此全部接口现在遍历1、3、4、5。不能再把电机序号直接当地址；GUI显示“Z(1)、托盘(3)、X(4)、Y(5)”。

### 3.2 舵机和夹爪

用户确认昨晚封装好的夹爪文件正确。本会话细查了inline实现、Source参考副本、PWM底层及旧main备份，确认动作逻辑自洽；没有修改舵机或夹爪文件。

| 项目 | 当前定义 |
|---|---|
| PWM | PB6 / TIM4_CH1，50Hz |
| 脉宽范围 | 500～2500μs对应0～270° |
| 松开 | 180° |
| 夹紧 | 0° |
| 单步 | 45° |
| 每步等待 | 200ms |

`Gripper_Grab()`依次180→135→90→45→0；前四次返回1，到0°后再次调用返回0。`Release()`反向走。`GrabNow/ReleaseNow`直接设置端点，但现有函数内部仍等待200ms。“需要按四次”是单步API的既定行为，不能据此认为封装或机械有错。

`servo.h`中旧名称`SERVO_OPEN_DEG=0`与`SERVO_GRAB_DEG=180`没有用于夹爪动作计算；夹爪以`GRIPPER_*`为准，不要反转已验证的夹爪方向。

集成时需要处理的衔接问题：

- 当前`Servo_Init()`初始化目标0°，`Gripper_Init()`随后设180°；新增可指定初始角度的入口，在PWM输出启用前准备松开目标，避免启动短暂夹紧。首个实际PWM需上板测量。
- 当前main/main_diag均不调用舵机初始化，是只调试电机的入口选择，不代表模块失效。
- `Servo_SetAngle()`不会同步夹爪内部目标角度；角度调试和夹爪命令应走统一状态接口。
- 为上位机新增非阻塞请求和轮询，沿用端点、步长和PWM映射；可保留旧阻塞API给旧调用者。
- `GetAngle/IsGrabbed/IsOpen`是软件目标状态，不能显示成传感器实测到位；200ms结束只说明等待结束。

## 4. Type-C路线与硬件事实

交接材料记录用户最终确认实际芯片为 **STM32F407VGT6**，不是旧文档的ZGT6。图纸标VET6，而实物据用户为VGT6；两者100引脚，G为1MB Flash、E为512KB。工程应按VGT6配置。

| 信号 | 接线/处理 |
|---|---|
| USB D− | Type-C经0Ω到PA11 |
| USB D+ | Type-C经0Ω到PA12 |
| USB控制器 | USB OTG FS，Device CDC，PA11/PA12 AF10 |
| PA9 VBUS检测 | 材料称未连接，移植时配置无外部VBUS sensing模式 |
| CC1/CC2 | 图中悬空，实物是否有Rd需核实；首次用USB-A转Type-C数据线 |
| 主晶振 | 图中8MHz；当前代码HSE_VALUE也为8MHz |
| PA9/PA10 | 不再作为上位机USART1通信引脚 |
| 电机TX | USART2 PA2，115200 8N1，仍保留 |
| 电机RX | 计划USART2 PA3，先接Z驱动器TXD验证 |
| 按键 | PA0内部下拉，按下高电平，20ms消抖 |
| LED | PC13低电平点亮 |

Type-C是MCU原生USB，无CH340/CP2102桥；只初始化USART无法通过此口通信。CDC表现为COM口，但串口波特率通常只是线路编码，不限制USB传输速率。

当前时钟已满足USB：HSE8MHz / PLLM8 × PLLN336 / PLLP2=168MHz；PLLQ7得到48MHz。APB1 /4、APB2 /2，TIM2/TIM4时钟84MHz。不要为USB随意改时钟或影响现有舵机PWM。

无VBUS检测时必须核对所选库的最终寄存器初始化，包括设备模式及会话有效处理，不是删PA9配置就完成。无VBUS检测也不能保证立即知道物理拔线，业务心跳仍需保留。

若需要C-to-C，核实实物后按设备受电端设计让CC1、CC2分别经约5.1kΩ到地；不要直接短接两脚。程序继续用ST-Link下载，Type-C通信不等于USB下载已实现。

## 5. 当前固件真实状态

### 5.1 正式入口

`MY/main.c`：上电闪一次、解堵转、停止、使能地址1；PA0启动/停止地址1。每250ms补发F6。

自动换档目前开启，运行后无条件每约1.5秒切换60/acc1→60/acc0→120/acc1→300/acc1→30/acc1，最后保持30。**没有回读，所以它不能判断电机是否已成功起转。** 接入PC控制时要关闭该调试换档，并让按键/PC共用统一状态，否则旧循环会覆盖PC目标。

`motor_state`等目前在main中局部维护，串口发送返回值多被丢弃。LED亮不代表驱动器确实转动。主循环`ms += KEY_TASK_MS`是估算时钟，业务增多后应改用`Stepper_Millis()`。

### 5.2 诊断入口

`MY/main_diag.c`：独立诊断固件，上电闪两次，以FD位置模式循环走半圈、等待、换参数。会自动产生运动，不能当作普通USB空载通信测试固件误烧。

### 5.3 接收与阻塞

真正编译的`stepper_inline.h`只启用USART2 TX，PA3未配，USART2_IRQHandler为空。`Stepper_Read()`、`Stepper_RxError()`已有函数体及缓冲，但没有ISR写入，所以不会收到数据。

不参与编译的`Drive/Source/stepper.c`已有接收ISR代码，但其GPIO尚只配PA2，不能原样认为硬件接收已完成。迁移时参考其错误处理，补全PA3和接收恢复。

位置API含`Delay_ms(wait_ms)`，夹爪API含200ms等待，`NudgeAll()`也阻塞。`*All()`现有循环没有10ms帧间调度。新增控制层需要非阻塞动作等待、帧队列、查询事务和停止优先级；单纯调用旧接口不能满足上位机响应要求。

## 6. 工程配置、模块和编码

正式工程：`ghr/10.15/Project/STM32F407.uvprojx`

诊断工程：`ghr/10.15/Project/STM32F407_diag.uvprojx`

两者当前器件仍是`STM32F407ZGTx`，**尚未改成VGTx**。ARMCC V5.06 update 6 build750，AC6关闭，C99、O0，Pack Keil.STM32F4xx_DFP.3.1.1。正式输出名STM32F429是历史命名，实际芯片407；不必为USB顺便改名。

实际参与编译的代码：

```text
MY/main.c（诊断工程替换为main_diag.c）
MY/stm32f4xx_it.c
Drive/Source/led.c
Drive/Source/delay.c
Drive/Source/servo.c
STM32/.../startup_stm32f40_41xxx.s
STM32/.../system_stm32f4xx.c
STM32/.../misc.c
STM32/.../stm32f4xx_rcc.c
STM32/.../stm32f4xx_gpio.c
STM32/.../stm32f4xx_usart.c
STM32/.../stm32f4xx_tim.c
```

`main.c`包含`gripper_inline.h/key_inline.h/stepper_inline.h`来带入实现。`gripper.c/stepper.c`是参考副本，不要同时加进编译，否则重复定义。`servo.c`是真正编译的，不能当参考副本忽略。

USB栈尚未加入：仓库未找到USB库；启动文件已有OTG_FS_IRQHandler弱向量，没有真实USB ISR。DMA外设库源码虽然在磁盘上，但没有加入当前编译清单，不能直接复制厂家HAL+DMA代码。

USB库和适配层应独立编译，正式加入uvprojx，这替代了旧方案“一律不改工程文件”的约束。不要include多个USB .c进main。避免Keil开着时从外部修改工程清单，被内存旧配置覆盖；修改前检查是否有打开的工程，编辑后重新加载核对。

| 编码 | 已核对文件 |
|---|---|
| GBK | main.c、main_diag.c、stm32f4xx_it.c、delay.c/h、led.c/h |
| UTF-8 | stepper.h、stepper_inline.h、key.h、key_inline.h、gripper.h、gripper_inline.h、servo.h、servo.c、gripper.c、stepper.c |
| UTF-8 | Markdown文档 |

编辑保持原编码，不批量转换。新增自有源码可统一UTF-8，厂商库保留原文件。GBK读取示例：

```powershell
$encoding = [Text.Encoding]::GetEncoding(936)
[IO.File]::ReadAllText('D:\study\project\robot-competition\ghr\10.15\MY\main.c', $encoding)
```

## 7. PC软件建议结构

```text
ghr/10.15/上位机/
  host_gui.py        tkinter主窗口，四轴/夹爪/参数/序列/日志分页
  protocol.py        ASCII帧、异或校验、请求id、错误码
  serial_link.py     pyserial传输、超时、设备识别、读写队列
  simulator.py       无硬件后端，与真实链路使用同一业务协议
  sequence.py        步骤模型、等待条件、超时、暂停/中止
  config.json       轴映射、参数快照、序列及格式版本
  requirements.txt  pyserial等明确依赖
  tests/            协议/序列/异常行为测试
  README.md         启动、Type-C连接、烧录、模拟模式和排错
```

GUI主线程只更新界面，串口线程用队列传递数据，`after()`刷新；禁止从后台线程直接操作tkinter控件。无pyserial时仍可运行模拟模式，真实连接给出依赖提示。

先让模拟器、协议和GUI可运行，与USB库移植分别推进；不必等实物枚举才能写PC侧。不要把虚拟后端数据伪装成实测数据。若USB库来源或硬件验证暂时受阻，继续完成不依赖这些条件的PC工作。

## 8. 通信与控制必须落实的规则

### 8.1 USB封装

参考v3的HostLink接口：Init、Poll、IsConfigured、ReadByte、QueueTx、TakeRxError。它们是计划新增的本项目接口，不是现有实现或厂商固定API。

OUT回调只扫描停止字符、入队和处理溢出；主循环解析协议。USB包不等于命令，必须处理拆包/粘包。发送复制到自有队列后才返回成功，端点完成前不得覆盖使用中的内存；端点忙不自旋，处理64字节整数倍传输及库要求的ZLP。

USB配置态与PC业务在线是两个状态。重枚举、MCU重启、断连后重新hello，清理半帧、旧回复和未完成动作，不能自动续跑。DTR不能作为唯一心跳依据。

### 8.2 文本帧

```text
请求：$<id>,<cmd>[,<arg>...]*<CS>\n
应答：#<id>,ok[,<key=value>...]*<CS>\n
错误：#<id>,err,<code>*<CS>\n
事件：#0,event,<type>[,<key=value>...]*<CS>\n
遥测：#0,tele,<key=value>...*<CS>\n

已核对示例：
$12,motor_speed,1,0,60,1*4A\n
#12,ok,addr=1,rpm=60*60\n
```

CS是起始符之后、星号之前ASCII字节逐个异或。文档中的反斜杠n表示实际LF，不是两个普通字符。完整帧含分隔与LF最多96字节，数组至少97字节容纳终止零；若接受CRLF，计数和丢CR规则需两端统一。

id为1～65535，0留给事件。会话内缓存请求内容和结果；相同id、相同内容不重复执行，相同id不同内容报错。在途重复请求也要有明确处理，不能再次排队。运动超时不能盲目重试，尤其相对位移；缓存之外结果未知应停止或查询。id回绕需避免与旧缓存冲突，必要时在空闲状态重新建立会话。

hello带协议版本和会话标识，返回固件/启动身份、轴映射和能力。命令集合按v3：ping、motor_enable/speed/pos/stop/stall_clear/zero/query、stop_all、status、gripper、servo_angle、param_get/set、tele_on/off、stop_clear。

解析必须严格检查字段数、整数格式、范围和溢出。速度初始60RPM/acc1，界面默认速度上限300RPM；驱动器物理极限不能直接当机械安全速度。普通轴地址白名单1/3/4/5，广播不开放普通查询。

ok表示接纳，不表示运动到位。任务事件区分sent、driver_ack、reached、settle_elapsed。无回读时“使能已发送”不能假装“使能已确认”；E08具体门槛按反馈能力明确实现，避免无回读模式完全无法调试或虚假显示确认。

### 8.3 停止和按键

- 单字节`!`优先锁存停止；USB回调不直接发送长电机帧。
- 主循环清空运动队列、取消查询，优先对1/3/4/5发停止，并安排间隔补发。
- PA0空闲时保留启动Z；运行或序列期间按下触发全部停止，统一状态避免旧循环覆盖。
- 建议PC心跳500ms，失联3秒停车锁存；本地独立按键运行与PC会话保护应分清，不能没连PC就无条件超时。
- 停车不自动关闭Z轴使能，需结合垂直机构保持情况验证。
- 解除锁存只解锁，不恢复旧运动；软件停止不等同独立硬件急停。

上述心跳数值、初始速度、暂停策略是方案默认值，不是已经完成上板验证的参数。

### 8.4 回读与序列

先单Z轴回读。多路驱动器TX不能因为地址不同就直接并联；四轴回读硬件方案尚未确定。没接的轴明确显示“未接回读”。

复用例36解析器：1F=5字节、35=6字节、36=8字节、3A/3B及常见应答=4字节；到位通知`addr FD 9F 6B`是4字节，同步触发`addr FF 66 6B`也是4字节。0E等未覆盖应答需确认后扩表，状态位未确认时显示原始值。

每次只留一个查询事务，校验地址、功能码、长度、帧尾和符号；初始超时100ms。编码器计数65536/圈与位置指令脉冲数不同，不能混用。遥测默认当前轴200ms起始周期，反馈按时间标新鲜度。

PC序列逐步下发，步骤含完成条件和超时；无反馈轴只能用明确标识的时间等待。暂停在当前步骤完成后生效，立即停车用中止；中止/断连后不自动续跑。运行参数先RAM，PC配置和序列存JSON；Flash、脱机序列、exe打包后续再做。

## 9. USB库移植和实施顺序

1. 先核对现有文件状态和环境，读v3，避免覆盖未提交成果。
2. 固定业务协议的尚未定细节（字段、任务事件、会话缓存边界），在protocol.py及简短协议文档中落地；实现模拟器和最小可启动GUI。
3. 获取同一发行版的STM32F4兼容ST USB Host/Device库，优先评估旧版配套CDC示例，检查ARMCC5和CMSIS依赖。记录来源、版本和许可证，不能跨代拼文件，不套HAL API。
4. 引入FS Device、CDC、描述符、板级适配及中断，改正式工程器件为VGTx；诊断工程仅同步器件型号并保留诊断功能。具体文件名/API以选定库为准。
5. 做最小CDC echo固件，先验证枚举与字节流；不要用会自动运动的诊断程序当通信空载测试。临时测试入口与正式构建明确区分。
6. 接入hello/状态/命令层、统一控制队列和夹爪非阻塞接口，关闭旧自动换档覆盖；先单Z和夹爪，再四轴。
7. 接PA3回读、遥测、参数和序列，逐项验证异常恢复。

可以先写PC侧并做模拟验收，同时准备USB库；硬件相关验收需要用户实际接板配合。当前尚未选定/下载USB库，所以不要承诺某个旧版USBD_Init参数已经与工程匹配。

## 10. 工具、验证和当前证据

Keil：`D:\study\keil\UV4\UV4.exe`

ARMCC：`D:\study\keil\ARM\ARMCC\Bin\armcc.exe`

FromELF：`D:\study\keil\ARM\ARMCC\Bin\fromelf.exe`

本会话确认armcc存在、node命令可用；`Get-Command python,python3,py`未找到命令。不能据此断言磁盘上绝无Python：新对话需查运行时或安装条件，依赖安装/网络访问按当时权限处理，不要声称环境已配好。

当前会话文件写权限为工作区及指定临时目录，网络受限制；旧交接写的“danger-full-access、无需审批”不代表真实工具权限。遇到下载限制按当前环境正规处理，不能借文档绕过审批。

已有旧构建日志：正式Code=3308、诊断Code=3044，均0 Error/0 Warning，是USB改造前记录。地址表修改后本会话用ARMCC5分别单独编译main.c和main_diag.c成功；**没有重新完整链接，没有烧录，没有验证USB。** 临时对象文件main_v2_check.o及main_diag_v2_check.o在被忽略的Objects目录。

完整构建可参考：

```powershell
& 'D:\study\keil\UV4\UV4.exe' -b 'D:\study\project\robot-competition\ghr\10.15\Project\STM32F407.uvprojx' -j0 -o 'D:\study\project\robot-competition\ghr\10.15\Project\build_usb.log'
```

UV4可能异步返回，需等进程或日志写完，检查最终错误警告和产物时间；不要只靠启动返回值报成功。`UV4 -h`会开GUI，不是命令行帮助。改动USB编译清单后完整构建，不能只做main语法检查就称USB移植通过。

PC测试重点：分段/粘连、校验、超长恢复、请求去重、在途重发、相对位移不重复执行、序列超时/中止、断连重连。USB上板测试重点：枚举，1/63/64/65/96/128/256字节，队列满，端点忙，拔插，MCU复位，主机停止读取；USB负载下按键、TIM2和舵机仍正常。

## 11. Git状态与本轮交付

当前HEAD：`6fb864c docs: 新增交接文档（新对话先读这份）`。本会话未提交、推送或fetch；不声称远端仍与本地一致。

写本文前已存在的状态：

```text
 M ghr/10.15/Drive/Include/stepper.h
 M ghr/10.15/Drive/Include/stepper_inline.h
 M ghr/10.15/Drive/Source/stepper.c
 M ghr/10.15/MY/main.c
?? ghr/10.15/MY/main_diag.c
?? ghr/10.15/Project/STM32F407_diag.uvprojx
?? ghr/10.15/上位机方案.md
?? ghr/10.15/上位机方案-v2.md
?? ghr/10.15/上位机方案-v3-TypeC-CDC.md
?? ghr/10.15/交接文档-20261016.md
```

本文本身也是新文件。main和stepper的改动多数早于本次会话，不能reset或覆盖。本会话实际代码修改只有stepper.h四个序号宏引用轴地址；新增v2、v3及本交接。舵机/夹爪未修改。USB库、PC程序和上位机目录均未创建，器件配置尚未调整。

`backup_before_*`保留在本地并被gitignore；Objects、Listings、用户uvoptx、密钥不入库。xrw目录本次未修改，后续继续仅作参考。不要根据旧文档的待办自动提交推送或邀请协作者。

## 12. 旧文档不能继续沿用的内容

| 旧说法 | 当前结论 |
|---|---|
| PC走USART1 PA9/PA10与USB转TTL | 已改Type-C原生USB CDC，PA11/PA12 |
| 芯片固定ZGT6 | USB交接记录用户更正为VGT6；工程尚待调整 |
| 全部电机地址1/2/3/4 | 已修为1/3/4/5，轴定义正确 |
| Stepper_Read/RxError只有声明 | 已有函数体，缺启用接收及ISR写入 |
| 四次夹紧可能是bug | 45°单步从180到0的预期行为 |
| SERVO_OPEN名称相反就要反转夹爪 | 不成立，夹爪方向由GRIPPER宏控制 |
| 只新增命令分发约300行即可 | 还需USB栈、统一状态、非阻塞队列、协议事务和PC程序 |
| 所有新模块只能inline且不能改uvprojx | USB栈/适配必须正式独立编译，业务inline约定保留 |
| FD到位通知3字节、同步触发3字节 | 两者完整帧都是4字节 |
| v1报文示例校验可直接复制 | 部分错误；以v3及实际计算的测试向量为准 |
| 按下后参数稳定在60RPM | 旧main无条件换档到最后30RPM，集成时关闭 |
| 文档说用户已批准/已测就算本轮验证 | 区分历史转述、本轮源码核对和真实硬件验收 |

## 13. 用户协作偏好

用户明确要求：**做完一件事就报告一件事**，不接受长时间只显示thinking。此前反复描述“正在写”却没有及时落盘，已导致用户不满。

接手后用小块交付：创建协议模块就报告路径和测试结果；创建可启动GUI就报告启动方式；引入USB库就报告版本和构建结果。进度更新必须对应真实完成的动作，不要提前说已写入或已测试。持续工作时至少每60秒更新一次，优先实际写文件和执行检查，减少重复阅读与方案复述。

只在确实缺少硬件信息或权限时询问；同时继续不依赖该答案的工作。当前对话没有授权主动开多个子代理，不要默认派发。不要把用户的新开工指令又转换成一轮冗长方案确认。

## 14. 可直接发给新对话的开工话术

> 请先读 `ghr/10.15/交接文档-上位机开工-TypeC-20261016.md` 和 `ghr/10.15/上位机方案-v3-TypeC-CDC.md`，然后开始实现上位机及必要的固件通信层。通信采用STM32F407VGT6标准库工程的板载Type-C USB CDC，PC用Python tkinter + pyserial，并提供模拟模式。保留Z=1、托盘=3、X=4、Y=5及昨晚已验证的夹爪180°松开/0°夹紧封装。先交付可运行的PC协议、模拟器和最小GUI，同时落实兼容ARMCC5的USB CDC接入。保护现有未提交修改，每完成一项就报告文件和验证结果；不要只停留在计划，也不要把没做过的硬件测试说成通过。
