2186279865/robot-10.15/02-资料库/README.md

# 02-资料库

> 这里放**所有不是"当前要跑的那一版"**的东西：赛题、硬件资料、往届参考、历史快照、调研报告、交接文档、截图。
> 规则只有一条：**只加不改**。已经写下的资料不删、不改结论；有新认识就新增一份，或在 `00-项目日志.md` 里补一条。

## 先看哪个

| 你想干什么 | 打开 |
|---|---|
| **赛前只看这一份**（省赛几天冲刺：现状/缺口/8 状态流程/日程/风险/今晚做什么） | **`方案-省赛冲刺总纲-2026-10-26.md`** ← 最新总纲，优先级最高 |
| 想知道"接下来怎么干、还差什么、怎么验收" | **`方案-整机作战方案-v1.md`** ← 现状/差距/分阶段/验收/风险（一页纸摘要在第 0 节） |
| 想知道"自动抓一件"具体怎么跑（Y+Z 通道 / 六盒转盘） | **`方案-自动抓放流程与状态机-v2.md`** ← 修正通道定义 + X 参与 + 转盘角度模式（v1 已被它取代） |
| 想知道"2026-10-24 到底讨论了什么、明天从哪继续" | **`思路-2026-10-24.md`** ← 回读真相/往返流程/遥测闭环/显示改派 HDMI/7 个待拍板 |
| 明天照着做（可勾选） | **`明日待办-2026-10-26.md`** ← 方向修复→3 轮验证→3200 脉冲→接 corridor→收尾（`明日待办-2026-10-25.md` 是上一版） |
| 想到但暂时不做的改进 | **`待优化清单.md`** ← OPT-01 夹爪角度随时可改（三步）+ 其它 9 条占位 |
| 想知道"这些功能当初为什么这么做" | **`00-项目日志.md`** ← 最重要，唯一的行为+想法记录 |
| 想快速上手一个子系统 | `06-交接与教程/` |
| 想核对赛项规则（尺寸/计分/流程） | `01-赛题/newpdftext.txt`（官方规则，冲突以它为准）+ `pdftext.txt`（命题解析） |
| 想看往届/厂家参考代码 | `03-往届参考/xrw/`（例35 视觉XY跟随、例36 Z轴） |
| 想找某一版旧代码 | `04-历史快照/` |
| 想看某个技术判断的依据 | `05-调研报告/`（6 份带行号引用的调研 + 分工方案 + 重构计划） |
| 想要现场照片/界面截图 | `07-图片与录屏/` |

## 目录说明

```
02-资料库/
├── 00-项目日志.md          ★ 唯一追加式日志：每件事的背景/取舍/做法/验证/风险/放弃的念头
├── 00-项目日志模板.md       新条目的格式
├── 决策记录.md              只记"拍板类"决定（含被推翻的），一行一条
├── 01-赛题/                 官方规则 pdftext/newpdftext（转文本）+ 测试图 crop_test.jpg
├── 02-硬件/                 接线与硬件说明索引（详细在 01-交付包/stm32/docs）
├── 03-往届参考/xrw/          例35（视觉XY跟随+托盘六工位）、例36（PWM/按键/Z轴），只读参考
├── 04-历史快照/              旧版本，仅供对照
│   ├── final-20261021/        10-21 冻结的一体化 8 页快照（本版上位机的前身）
│   ├── new_eye-独立视觉/      最早的独立视觉程序（不含控制）
│   ├── 液晶-10.17/ 液晶-10.19/ ST7735S 点屏实验（赛项强制显示屏的现成驱动）
│   └── 上位机-原始版6页/      6 页版本的上位机
├── 05-调研报告/              6 份子系统调研 + 香橙派分工方案 + 重构计划
├── 06-交接与教程/            交接文档、上位机方案 v1/v2/v3、新手教程、各子系统 README
└── 07-图片与录屏/            真机截图（含 8 页界面、双相机画面、夹爪开合证据）
```

## 与另外两个文件夹的关系

- `01-交付包/` = 能跑的那一版（代码 + 模型 + hex + 部署脚本）。**资料库里的代码都是历史，不要拿它跑。**
- `03-实验台/` = 试过但没进主线的东西（Qwen 语义识别、SAM 上派实测、网络化原型）。
- 本资料库不存大件（模型、venv、编译中间产物）。历史快照里的 `models/` 已被剔除，需要权重去 `01-交付包/vision/models/`。
