2186279865/robot-10.15/02-资料库/05-调研报告/README.md

# 05-调研报告

> 2026-10-21 一次性把整仓读了一遍，得到 6 份带**行号引用**的子系统报告 + 2 份方案设计稿。
> 行号是**当时的**行号（代码后来改了），所以它们适合看"结论与机制"，不适合当接口文档用。

| 文件 | 覆盖 | 最值钱的三个结论 |
|---|---|---|
| `00-全项目导读.md` | 全仓（339 行，15 节） | ①主线是 `ghr/10.15` 固件 + 上位机 + `new_eye` 视觉；②赛项是智能分拣，缺"高亮显示屏"和"一键启动"；③文档一半过期 |
| `01-firmware.md` | STM32 固件（447 行） | ①模块实现内联在 `*_inline.h`；②USB CDC 从未上板枚举；③`motor_query` 依赖 PA3 回读线（没接） |
| `02-host-app.md` | 上位机（229 行） | ①纯标准库 tkinter，一个 daemon 服务线程 + 30 ms 轮询；②abs 在固件里其实是 rel；③真机日志证明 hello 通、四轴 E04 |
| `03-vision.md` | new_eye 视觉（293 行） | ①双相机四点单应 → SAM → 融合 → 规则分类，只输出 JSON；②0.98 fps；③X/Y 标定残差 ±3.2 万脉冲（验收要求 <100）→ 不可用于真抓 |
| `04-llm-qwen.md` | Qwen 实验台（232 行） | ①Ollama + qwen2.5vl，冷启 60 s / 热 0.8–2 s；②6 件 4 件"未知"；③交接文件已成孤儿 |
| `05-refs-docs.md` | 赛题 + 参考例程 + 编译日志（321 行） | ①赛项硬约束逐条（外形 ≤350×350×450、六储物盒、一件一显示、15 秒节奏…）；②EMM V5 帧格式全表；③唯一一份 10.15 编译日志是**失败**的 |
| `06-final.md` | final 快照（242 行） | ①10-21 01:06 冻结的 8 页一体化包；②6 个集成文件只存在于此；③冻结后又开发 19 小时 → 它不是主线 |
| `香橙派-笔记本分工方案.md` | 架构设计（约 300 行） | 四个方案对比后选"派采集 + 笔记本识别 + 串口桥"，并给出时延/带宽预算与三层安全网 |
| `重构计划-交付包与资料库.md` | 仓库重构 v2（约 300 行） | 三文件夹结构（01 交付 / 02 资料 / 03 实验台）+ 日志规范 + 六阶段执行计划 |

## 怎么用这些报告

- 想理解**某个机制的存在理由** → 查对应报告（比如"为什么固件把模块实现写进 `.h`"）。
- 想确认**某个结论是否有证据** → 报告里都是 `路径:行号`，直接跳过去看代码。
- **不要**拿它当"当前代码是什么样"的文档：2026-10-22～23 之后代码改动很大（夹爪三档、接近段示教、回初始位、网络化），以 `01-交付包/README.md` + `VERSION.md` 为准。
