2186279865/robot-10.15/03-实验台/00-模板/README.md

# 【进行中】实验名：一句话

- **开始日期**：YYYY-MM-DD
- **想解决什么**：
- **用到的外部东西**：（模型/库/服务，写清体积，方便日后清理）
- **数据多大**：
- **结论**（结束前填）：

## 为什么开这个实验

（一句话说清：主线上有什么缺口，逼得你要试这个）

## 怎么试的

（命令、脚本名、关键参数。别人要能照着复现）

## 结果

（数字、截图路径。别写"效果不错"，写"6 件里 4 件识别正确，平均 2.3 s"）

## 判断：毕业 / 放弃 / 继续

- 毕业 → 把要用的代码搬进 `01-交付包`，再回来标【已毕业】并写"搬到了哪里"
- 放弃 → 写清**为什么不行**（这比代码值钱）
- 继续 → 写下一步
