2186279865/robot-10.15/02-资料库/交接文档-20261031.md

# 机器人分拣项目 · 交接文档（2026-10-31 00:30 版）

> 用途：换新对话/换人接手时，读完这一份就能继续干。
> 当前代码 HEAD：`cd2374f`（分支 `main`，已 push 到 `github.com:2186279865/robot-10.15.git`）

---

## 0. 30 秒速览

- **做了什么**：笔记本上位机（Python + Tk 一体化 GUI，8 页签）+ 树莓派端（视觉采集/串口桥/比赛屏）+ STM32F429 步进控制（四轴：Z/X/Y/转盘 + 舵机夹爪）。
- **现在能做什么**：视觉识别 6 类物块 → 自己算抓取点 → 全自动抓取/抬升/搬运/落盒/回位；比赛屏实时显示分拣进度。
- **最近状态**：最后一次真机整批 = **8 成功 / 1 失败、总 227.9 s、单件 18–28.8 s**（没达设计 9–10 s/件，原因见 §8.4）。
- **马上要做的三件事**（按优先级）：
  1. 双击 `01-交付包/deploy_pi_display.bat` 更新派端屏（输入派端密码 `orangepi`）；
  2. 恢复被回滚删掉的运行态配置（`tray_scale.json` / `route.json`，见 §5.4，**不恢复转盘只会转一半**）；
  3. 跑 12 件真机彩排，记录节拍与失败原因（见 §9 待办 P0）。

---

## 1. 赛题与物块

- 任务：托盘内 6 类几何体各 2 个（共 12 件）→ 识别 → 逐件抓取 → 按「同类同盒」放进 6 个转盘储物盒。
- 官方清单（`01-交付包/物块/物块种类.txt`）：黄色圆锥 ×2、紫色四棱锥 ×2、蓝色长方体 ×2、红色长方体 ×2、白色六棱锥 ×2、粉色椭圆柱 ×2。
- ⚠️ **实物与清单有出入**（2026-10-30 清点）：红长方体只有 1 件，另多 1 件**黄绿色长方体**。若按清单摆 12 件，实际只有 11 件匹配 + 1 件"清单外"，会多占 1 个 class_key（6 盒可能不够）。
- 分盒键 = **颜色 + 形状**（蓝/红长方体同形状不同色，必须分开）。

---

## 2. 硬件与网络

| 角色 | 型号/位置 | 地址 |
|---|---|---|
| 上位机（主控） | 笔记本 Windows | 192.168.100.199（与派同网段） |
| 派端 | Orange Pi 4 Pro（A733，无 CUDA） | 192.168.100.198，用户 `orangepi`，项目在 `/home/orangepi/robot1021/` |
| 运动控制 | STM32F429（EMM V5 步进驱动器 ×4 + 舵机） | USB CDC，经派端串口桥暴露 |
| 相机 | 2 个 USB 摄像头（顶视 = 派端槽位 1、副摄 = 槽位 0） | 派端 `/dev/video*` |
| 比赛屏 | 派端 HDMI 1024×600 全屏 Tk 窗口 | 派端本机 |

### 端口表

| 端口 | 方向 | 用途 |
|---|---|---|
| 5056 | UDP | 派端发现（上位机扫局域网自动填 IP） |
| 5057 | TCP | 图传（上位机按需拉帧：9B 请求 + 24B 头 + JPEG） |
| 5058 | TCP | 串口桥（**独占**，只有上位机连；用于发运动/夹爪命令） |
| 5054 | TCP | 只读观察（遥测/日志旁观，不影响主控） |
| 5060 | TCP | 派端**最新缓存帧**（只读，给派端屏裁缩略图用，不触发新抓帧） |
| 5059 | TCP | 派端比赛屏接收上位机推送（NDJSON：`state` / `item` / `finished` / `alarm`） |

### 固件

- 源码：`01-交付包/stm32/firmware/`（Keil 工程，UV4 命令行可编译）
- 现用 hex：`01-交付包/stm32/hex/STM32F429.hex`（2026-10-31 03:04 重编的「速度版默认值」固件），与 `stm32/firmware/Project/Objects/STM32F429.hex` 同内容
- **2026-10-31 起固件默认值改为速度版**（`host_param_defaults`：`speed_rpm_max 300→3200`、`acc 1→0`、`telemetry_ms 200→100`、`gripper_ready_deg 150→168`），复位后不用点「初始化」就是速度版；改动说明/合并/烧录/自检/回滚见 **`01-交付包/stm32/docs/固件-速度版默认值-20261031.md`**（给队友的 AI 看的那份）
- 诊断固件：`stm32/hex/STM32F429_diag.hex`（11 KB，仅点灯/串口）
- 烧写：Keil F8 / STM32CubeProgrammer（本机**没有** ST-Link CLI）；烧完断电重连

---

## 3. 代码地图

```
01-交付包/
├─ run.bat                      # 主程序启动（ASCII+CRLF，别用中文注释）
├─ deploy_pi_display.bat        # 派端一键更新（pi_display.py + presets/）
├─ main.py                      # 入口：host_gui + vision gui 组装
├─ host/                        # 上位机逻辑（40 个 py，约 11k 行）
│  ├─ host_gui.py               # 8 页签 GUI（运行台/视觉/运动控制/X-Y标定/参数/动作序列/视觉目标/原始日志）
│  ├─ run_tab.py                # 「运行台」页：一键启动/一键回 P0/状态与识别结果两栏日志（2026-10-31 已删预览画面）
│  ├─ auto_grab.py              # 核心：识别→抓取 11 段动作、分盒、转盘、回 P0
│  ├─ prep_pose.py              # 底层单轴/多轴移动（move_abs 闭环、软限位、位置来源）
│  ├─ calib_tab.py              # X/Y 标定页（抓取点记录/求解、连续抓入口；2026-10-31 已删顶视小预览）
│  ├─ host_client.py            # 5058 串口桥协议客户端
│  ├─ display_link.py           # 5059 比赛屏推送（norm_bbox / thumb_b64）
│  ├─ runtime/                  # 运行态：limits.json、gripper.json、tray_scale.json、route.json
│  └─ tests/                    # 341 个单测
├─ vision/                      # 视觉（15 个 py）
│  ├─ gui.py                    # 视觉页 + recognize_blocking（识别主流程）
│  ├─ cloud_vlm.py              # DeepSeek 提示词/请求/解析（6 类规则在 _SCENE/_RULE/_JSON_SPEC）
│  ├─ classify.py               # 几何判据 + six_class 收敛
│  ├─ segmenter.py / fusion.py  # SAM 分割、双视融合
│  ├─ config.json               # 相机/四点框/云模型/类别等全部配置
│  └─ runtime/                  # latest_targets.json、calib_marks.json、grasp_pairs.json、tray_calib.json
├─ orangepi/pi/                 # 派端
│  ├─ pi_agent.py               # 图传/串口桥/发现/缓存帧
│  ├─ pi_display.py             # 比赛屏（6 列盒位、卡片缩略图、预设图 fallback、总用时）
│  ├─ presets/                  # 6 类预设图 ×52/56/96/160 + index.json（比赛屏唯一的货物图）
│  ├─ start.sh / start_display.sh / robotpi.service
├─ stm32/                       # 固件源码 + hex
├─ 物块/物块种类.txt             # 赛题清单
└─ runtime/                     # 上位机杂项运行态（box_map.json、journey.json、备份 json）

02-资料库/                       # 文档（本文件所在）
图片/presets/                    # 6 张 512×512 实物照（比赛屏预设图源）
```

---

## 4. 启动与常用命令

### 4.1 启动（每天开机顺序）

1. 派端开机 → 等屏幕出现「智能分拣 · 待机」六列。
2. 笔记本双击 `01-交付包/run.bat`。
3. GUI 顶栏串口下拉选「派 robot-pi 192.168.100.198」→ 点「连接」（自动：订阅四轴遥测、下发 `acc=0`、夹爪打预备角）。
4. 点「初始化」→ 四轴回读出数（**Z 必须是 0 = 最底**，见 §8.2）。
5. 视觉页「打开双画面」→ 首次会加载分割模型（约 5–6 s）。
6. 运行台点「一键启动」。

### 4.2 测试与自检

```powershell
# 单元测试（必须用 venv，系统 python 缺 PIL 会报 3 errors）
cd D:\study\project\robot-competition\01-交付包\host
& '..\.venv\Scripts\python.exe' -m unittest discover -s tests -q      # 期望：Ran 341 tests ... OK

# 界面自检（截图 8 页）
cd D:\study\project\robot-competition\01-交付包
& '.\.venv\Scripts\python.exe' main.py --selftest                     # 期望：selftest pages: 8 / 8
```

### 4.3 派端部署

- 图形屏：双击 `01-交付包/deploy_pi_display.bat`，输密码 `orangepi`（会校验 md5 与预设图数量，并装开机自启）。
  它会传 `pi_display.py` + `presets/`，再调派端 `start_display.sh` 重启屏幕（第 4 步原来是错的，已修）。
- 改货物图：换 `图片/presets/<基名>.png`（512×512）→ `.venv\Scripts\python.exe tools\make_presets.py`
  重新生成 `orangepi/pi/presets/*_{52,56,96,160}.png`（`--check` 只检查）→ 再跑上面的 bat 传上去。
- 完整 agent：`scp 01-交付包/orangepi/pi/pi_agent.py orangepi@192.168.100.198:/home/orangepi/robot1021/pi/` 后 `ssh ... "pkill -f pi_agent; nohup python3 pi_agent.py --port 5057 ... &"`（参考 `start.sh`/`robotpi.service`）。
- 免交互部署（本机已装 PuTTY，主机指纹 `SHA256:SHnztqS6JrOB8t65hwMvC9cZw7kcGXSBGGNouVrYbKg`，密码 `orangepi`）：
  `pscp -batch -hostkey <指纹> -pw orangepi -r 01-交付包\orangepi\pi\presets orangepi@192.168.100.198:/home/orangepi/robot1021/pi/`
- 派端日志：`ssh orangepi@192.168.100.198 tail -f /home/orangepi/agent.log`；屏幕日志在 `/tmp/pdisp.out`（要在日志里看每条消息/排查图片问题，用 `DISPLAY_LOG=1 sh start_display.sh` 起屏）。截屏验证：`DISPLAY=:0 import -window root /tmp/shot.png`。

### 4.4 Git

```bash
git log --oneline -10
git push            # 远端已配好 ssh
```

---

## 5. 关键参数与运行态文件

### 5.1 `01-交付包/host/auto_grab.py` 常量（原文）

```python
Z_DOWN = 0                  # 抓取高度（最底）
Z_UP   = -152000            # 抬顶
P1_Y   = -13144             # 通道末端
P0_Y   = 0                  # 初始/落料位
TRAY_DEG = 60.0             # 每个盒 60°
_ACC_DEFAULT = 0            # 0=最快；acc=1 实测慢 10 倍，禁用
TRAY_RPM = 6                # 5 很稳、6 略快且顺、10 会甩货
TRAY_ACC = 1                # 转盘必须用驱动器慢斜坡
TRAY_TIMEOUT_S = 20.0
TRAY_JOIN_TIMEOUT_S = 8.0   # 转盘没到位时在 ⑧ 降 Z 之前等它的上限（超时中止本件、不松爪）
TRAY_STABLE_COUNTS = 60.0   # 判"稳定"的 counts 抖动容差（≈3 脉冲）
TRAY_MOVED_OK = 0.72        # 位移≥72% 视为到位
TRAY_MOVED_LENIENT = 0.45   # 等够 1.1×理论时长后 ≥45% 也算到位
TRAY_TIME_FALLBACK = 1.25   # counts 不可信时按 1.25×时长收口
# 2026-10-31 提速后的等待与判据：
SETTLE_GRAB_MS = 200        # 夹紧后等 0.2 s（用户 2026-10-31 明确「这里稍微等 0.2 秒」）：
                            #   固件 host_cmd_gripper 调完 control_gripper_apply 立即回 ok、舵机自己合拢，
                            #   这 0.2 s 留给舵机真的合上，之后立刻抬 Z。
SETTLE_OPEN_MS = 220        # 松爪后给舵机**张嘴**的时间（500→150→0→220）：
                            #   0 的时候 open/ready 相隔 ~1 ms 背靠背下发，固件收到 ready 立刻
                            #   Servo_SetAngle(168) 覆盖 open，爪子张不开、物块不掉，现场看起来
                            #   像「爪子没松/预备角度没了」。舵机 135°→180° 约 0.1~0.2 s，留 0.22 s。
SETTLE_READY_MS = 0         # 回预备不再单独等（下一段运动期间转完）
IN_PLACE_TOL_PULSES = 60    # "就在这个位"的判据（≈0.6 mm），move_abs 用它跳过空步
COUNTS_MAX_AGE_MS = 800     # counts 超过这个年龄才重取（最多 2×30 ms）；现场拥塞时 age 常到 400~800 ms
PREFETCH_Z_TOL_PULSES = 400 # 预走的 Z 在底判据（±400 脉冲）＋两次读数差 ≤200 counts、且龄期 ≤COUNTS_MAX_AGE_MS
#: tele_on 的遥测周期（ms）——**这才是真正决定遥测帧率的旋钮**；固件里的 `telemetry_ms`
#: 参数只是声明、代码没人读。200 ms 时四轴各 5 Hz ≈ 20 帧/秒，界面每条还记两遍 → 日志 40 行/秒，
#: 2026-10-31 05:25 实测把派端串口桥挤到整段停 5 s、Z 回执迟到 4 s。改 400 = 事件量减半。
TELE_PERIOD_MS = 400
# 【硬性约束】Z 抬升高度 = -152000 是现场硬性要求，**不可以改**（用户 2026-10-31 明确：
# 抬不到顶横移会撞托盘上的物块/箱口）。不要为了省时间把它调低，也不要加"可覆盖"的配置项。
# Z 转速也已到硬件上限（实测 ~1804 圈/分 ≈60 mm/s），一件 4 趟 Z ≈6.1 s 是硬成本——
# 见 §8 第 22 条。想提速只能从非 Z 段挖。
```

```
#: 01-交付包/host/protocol.py（2026-10-31 提速）
GOTO_RPM_BY_AXIS = {1: 3000, 3: 300, 4: 300, 5: 2000}   # 2026-10-31 三轮：Z 2400→3000
GOTO_TOL_BY_AXIS = {1: 1500, 3: 350, 4: 350, 5: 350}    # 闭环到位容差（counts）；Z 放宽到 1500≈0.044 mm，避免触发 60 圈/分的慢补走
# Z 2200→2400（2800 实测更慢，已回退）；Y 1600→2000；Z 要再降就改 [1]
```

```
#: 固件默认值（01-交付包/stm32/firmware/Drive/Include/host_protocol_inline.h: host_param_defaults）
#: 2026-10-31「速度版」：复位后不用点「初始化」就是速度版
acc = 0            # 原 1（有斜坡，慢 10 倍）
speed_rpm_max = 3200  # 原 300；只管 motor_speed / motor_pos，motor_goto 不看它
telemetry_ms = 100    # 原 200
gripper_ready_deg = 168  # 原 150
# 上位机 protocol.PARAM_DEFAULTS 必须与这份逐项一致（有单测守着）
```

### 5.2 单位换算（易混，务必记住）

- 接口口径 **3200 脉冲/圈**；编码器 counts = **脉冲 × 20.48**（1 圈 = 65536 counts）。
- 行程 100 mm：X 96.5 脉冲/mm、Y 97.7、Z 1658（Z 是 2 mm 导程丝杆）。
- 界面「回读」显示的是 **counts**，输入框填的是 **脉冲**。

### 5.2.1 位置回读预算与链路预算（**2026-10-31 18:12 现场定死**）

- **遥测 counts 不是"当前位置"**：固件 `host_query_sweep()` 挂在"遥测发送"分支里
  （`host_protocol_inline.h:2608-2614`），每个遥测节拍（`telemetry_ms=400`）**只轮询一根轴**，
  4 轴转一圈 = **1.6 s**；只有 `motor_goto` 期间 `host_goto_sweep_first()` 会把那根轴提到 20 ms 级。
  实测：`addr=5` 的 counts 连发 5 帧同值（`age_ms` 1→399→799→1199→1599），Y 42,675 脉冲/s
  → 光滞后就相当于算错 6.8 万脉冲。
- 需要"当前位置"时一律用 `prep_pose.query_pulses(client, axis)`：发 `motor_query <axis> pos`
  （固件直问驱动器，回 `counts`；忙回 `E09 query_busy`，内部等 15 ms 重试 3 次 ≈ 40 ms）。
- 实测有效转速（由 `[预走] … elapsed_ms` 反算）：**Y = 800 圈/分（42,675 脉冲/s）、
  Z = 1810 圈/分（96,569 脉冲/s）**、X = 300、托盘 = 300；
  代码里是 `prep_pose.EFFECTIVE_RPM_BY_AXIS = {1: 1900, 5: 800, 4: 300, 3: 300}`。
  用"指令转速"估走位时间会**少等 1.5 倍**（Y@2000 若按 1240 上限算）。
- 链路预算：`host_client.HEARTBEAT_MS = 500`（原 1000）、`LINK_TIMEOUT_MS = 15000`、
  `SLOW_LINK_MS = 5000`；派端看门狗 `common/wire.py SERIAL_WATCHDOG_MS = 3000`（原 1500）。
  原来 1 s 心跳对 1.5 s 看门狗太接近：链路抖一下派端就注停车帧 → 固件锁存 E10 → 后面 goto 全被拒。

### 5.3 `01-交付包/host/limits.json`（软限位，脉冲）

| 轴 | min | max |
|---|---|---|
| Z(1) | −152501 | 500 |
| 托盘(3) | −20000 | 20000 |
| X(4) | −500 | 12000 |
| Y(5) | −55000 | 500 |

### 5.4 运行态文件现状（**重要**）

| 文件 | 状态 | 说明 |
|---|---|---|
| `host/runtime/gripper.json` | ✅ `{"ready_deg": 167}` | 夹爪预备角（改后存盘，重启保留） |
| `vision/runtime/grasp_pairs.json` | ✅ 5 组 | 抓取点标定（`u,v → px,py`），见下表 |
| `vision/runtime/tray_calib.json` | ✅ | (u,v)→X/Y 仿射（a,b,c,d,tx,ty） |
| `runtime/box_map.json` | ✅ 每批自动清零（2026-10-31 起） | 文件里可能还留着旧键（`圆柱/圆形→1`、`五棱体→2`），下次「一键启动」会先打一行「分盒已自动清零」再重分 |
| `host/runtime/tray_scale.json` | ❌ **缺失** | 缺省回落 1.0 → 转盘只转一半！必须恢复或重标（约 2.0） |
| `host/runtime/route.json` | ❌ **缺失** | 「一键走出固定路线」用，缺失则该按钮报错 |
| `host/runtime/prep_pose.json`、`host/config.json` | ❌ 缺失 | 同上（随 10-30 回滚被删） |

抓取点 5 组（u,v → 脉冲）：

```
(0.1433, 0.1923) → ( 500, -38144)
(0.8246, 0.1975) → ( 900, -97144)
(0.7944, 0.8082) → (9300, -93144)
(0.1326, 0.8214) → (9200, -34144)
(0.4533, 0.5326) → (5300, -63144)
```

### 5.5 `01-交付包/vision/config.json` 要点

```
fps: 3                     # 15 → 8 → 3（断联/链路挤停治理）：Stream 现在真的按 fps 节流，
                           # 每帧都是"请求→派端缩放压 JPEG→走无线"，越快越挤控制链路
frames_for_vote: 1         # 只跑一帧，无投票
device: cuda               # 笔记本有 GPU；SAM 首次加载 5–6 s
top_camera_index: 1 ; side_camera_index: 2
remote.cam_map: {"1": 1, "2": 0}    # 顶视→派端槽位1；副摄→槽位0（弄反会裁错位置！）
cloud_vlm: enabled=true, mode="primary", model="deepseek-flash", views="two",
           min_conf=0.88, accept_conf=0.7, timeout_s=10,
           candidates=["圆锥","四棱锥","六棱锥","椭圆柱","长方体","其他几何体"],
           ambiguous=["四棱锥","六棱锥","椭圆柱","圆锥","其他几何体"]
white_objects: true        # 白色/浅色物块候选（2026-10-31：两个白六棱锥一直漏抓）
white_ratio: 1.10 ; white_sat_max: 55 ; white_val_min: 80
white_min_area: 5000 ; white_min_fill: 0.35   # 滤掉托盘内壁的斜向反光带
```

---

## 6. 抓取动作时序（auto_grab.run_once，每件 11 段）

| # | 动作 | 目标 | 备注 |
|---|---|---|---|
| 0 | 点「一键启动」 | — | ① **刷新派端屏**（6 盒卡片清空、计数/计时归零、回「等待第一件」）② **分盒登记清零** ③ 拍一张照片开始识别 |
| ① | Y 进通道（识别期间） | Y=−13144（**Z 必须在底**） | 通道净高不够，必须先走 Y；识别同时在跑，不占节拍 |
| ② | Z 抬顶（识别期间） | −152000 | Y 之后立刻抬，X 不动；①② 都在「等识别结果」之前走完 |
| ③ | X/Y **一起**到物块上方 | 该件脉冲 | **一条并行 motor_pos**；残差也是一整对重发，绝不拆单轴 |
| ④ | Z 降底 | Z=0 | 到位立刻降 |
| ⑤ | 夹紧 | 135° | 发出去就走，**停 200 ms**（给舵机合上，用户要求） |
| ⑤b | 转盘后台开转 | 目标盒角度差（见下） | **本件一开始（①之前）就开始转**，与 ①~⑧ 全程并行 |
| ⑥ | Z 抬顶 | −152000 | 夹紧后立刻；Z 在顶才允许横移 |
| ⑦ | X/Y **一起**回 P1 | X=0, Y=−13144 | 一条并行指令 |
| ⑧ | **等转盘到位** → Z 降底 | 0 | 转盘没到位就在这里等（上限 8 s，超时报错中止本件、**不降 Z 不松爪**）；到位才降 |
| ⑨ | 松爪 | 180°（张嘴 220 ms）→ 回预备 168° | 降到底**立刻**松爪，不等转盘、不等落盒 |
| ⑩ | 松爪后立刻：**拍下一张识别 + Z 抬顶** | — | 每件都重新识别（`recognize_each=True`）；下一件 ① 的 Y 已在 P1 会跳过；Z 上升期间爪子转回 168° |

- **分盒规则**：`box_map[class_key]` 决定盒号；`k=(box-box_now)%6`，`k>3` 取负（走最短方向）；`k=0` 不转（同类不转，省 4 s/件）。
- **整批回 P0**（`goto_p0()`，2026-10-31 重写）：已判新鲜读数（连续两次差 ≤30 counts）后分四种情形——已在 P0 → 不动；**在 P1 且 Z 到底 → 只发 `Y→0`（唯一允许直接回 P0 的情形）**；在 P1 但 Z 没到底 → `Z→0` 再 `Y→0`；**不在 P1（停在托盘上方）→ X/Y 并行回 P1 → `Z→0` → `Y→0`**。绝不"就地降 Z"。手动按「停止」则不回位。
- **照片链路**：派端屏用 `orangepi/pi/presets/` 的预设照片（四档 52/56/96/160，按屏上实际像素选相近档），`display_link.SEND_THUMB=False` 时上位机不再推 `thumb_b64`（见 §8 第 27 条）；改图走 `tools/make_presets.py` + `deploy_pi_display.bat`。

---

## 7. 识别链路（vision/gui.recognize_blocking）

1. 顶视+副摄取最新帧（1920×1080，fps 3，`Stream` 按 fps 节流）
2. `top_points` / `side_points` 四点透视校正到 700×700
3. SAM 分割（GPU，首帧 5–6 s，之后 ~0.9 s）；候选前景 = **颜色分支**（`饱和度>45 & 亮度>35`）
   + **白色/浅色分支**（`局部亮度比 V/模糊(V) > 1.10` 且 `饱和度<55` 且 `亮度>80`，见 §8 第 24 条）
4. 面积/贴边过滤 → 双视 (u,v) 融合
5. **DeepSeek 双图分类**（`views=two`、`thinking=disabled`、`temperature=0`、`detail=high`、10 s 超时）→ 每件 `shape/color/confidence/center`
6. 按中心 ≤0.07 贴回 SAM 掩膜；失败先单图重试，再失败回退几何判据（日志会打「已回退几何判据」）
7. 写 `vision/runtime/latest_targets.json`；同时做 **VLM 条数 vs 本地分割条数** 一致性校验（不一致以本地为准并告警）
8. 整次 2.5–4 s

### 提示词（v3，2026-10-30）核心判据

- **第一步：顶面内部有没有棱线/明暗分区** → 有 = 锥（圆锥/四棱锥/六棱锥），无 = 柱（椭圆柱/长方体）
- 柱：顶面全圆滑 = 椭圆柱；顶面有 4 个尖角/两组平行边 = 长方体
- 锥：顶视外轮廓 圆→圆锥、4 边→四棱锥、6 边→六棱锥
- 数量约束：「最多 6 类、每类 2 个、合计 12，允许更少，禁止凑数/合并/重复」
- 颜色闭集：黄/紫/蓝/红/白/粉 + 提示"蓝色偏紫要报蓝并给低置信"
- 逐件要求字段：`id/shape/color/confidence/inner_edges/outline_corners/edge_style/apex/top_aspect/reason/center`
- 已知短板：`frames_for_vote=1`（首帧错到底；2026-10-31 前 `recognize_blocking` 写死 2 帧，现在真按 1 帧跑，若发现误识别变多就改回 2）；`ask_crops`（放大裁剪）已实现但**未接入**；密排时单件仅 60–120 px

---

## 8. 踩过的坑（**新手必读，别再犯**）

1. **相机槽位映射**：`cam_map {"1":1,"2":0}`。曾把顶视指到槽位 0 → 画面是斜视，四点框套错、裁出来的"照片"全是别的区域。改完必须重启 GUI（配置只在启动时读）。
2. **Z 零点语义**：`Z=0` 必须是**最底**、`−152000` 是顶部。清零必须"降到底再清零"，否则整套动作上下反向（**撞过机**）。
3. **counts 读数滞后**：`prep_pose.move_xy_fast` 的并行残差保护 **2026-10-31 已按现场要求改过分级**：
   - 收口读数改成"连续两次一致"的**新鲜读数**再算残差。旧帧晚 130 ms ≈ 1.1 万脉冲（Y 1600 RPM ≈ 8.5 万脉冲/s），
     这正是现场那句「偏离目标 +11394 脉冲（>3000）」的来源 —— 爪子其实已在位。
   - `60 ~ 3000` 脉冲：照旧顺序补一次（相对量，等回执）。
   - `3000 ~ 40000` 脉冲：**只告警、不补走、继续本件**，不再中止整批（现场确认爪子已到位）。
   - `> 40000` 脉冲（≈400 mm，回读滞后解释不了）：仍中止等人工，防真撞机。
   - 阈值在 `prep_pose.XY_MISS_TOL_PULSES / XY_MISS_SKIP_PULSES / XY_MISS_ABORT_PULSES`。
   **不要把 3000 改回"中止线"**：那会在爪子已到位时白停一批（2026-10-31 现场已确认）。
4. **节拍慢的真因**：每件 4 次 Z 全行程（1.6 s/次）+ 每段等稳定 0.6 s + 转盘 join。设计 9–10 s，实测 18–28 s。**2026-10-31 已提速**（删 0.6 s 稳定等待、X/Y 永远并行、夹爪/松爪等待缩短、Z/Y 转速上调），见 §9 第 9 条。
5. **转盘**：必须 `TRAY_ACC=1`（驱动器慢斜坡）、`TRAY_RPM=6`；`acc=0` 会甩货、`rpm=10` 会甩。轴 3 常无有效回读 → 已改成"抖动容差 60 counts / 45–72% 位移 / 按时间收口"，**不会再死等 20 s**。
6. **分盒 class_key 旧名**：曾出现 `菱体/菱形|蓝` 与 `长方体|蓝` 两个 key 指向同一类 → 同形同色分两盒 → 6 盒被 7 key 占满 → 第 9 件"分盒失败"。现已 `six_class()` 收敛；历史 `box_map.json` 仍需清理。
7. **派端屏照片**：不能拿 5060 实时帧按"识别时的旧框"裁（物块已被抓走/画面已变），要用识别帧的 `thumb_b64`。
8. **断联**：1080p×15fps×2 约 31 Mbps 打满 WiFi 上行 → 心跳丢失判离线。已把 `fps 15→8`、链路判定 3 s→8 s、查询超时 300→800 ms。
9. **.bat 必须纯 ASCII + CRLF**：带中文注释或 LF 换行时 cmd 按 GBK 解析会打不开/乱码。
10. **系统 python 缺 PIL**：所有测试/自检必须用 `01-交付包/.venv/Scripts/python.exe`。
11. **派端 ssh 无免密**：`Permission denied (publickey,password)`，只能用 `deploy_pi_display.bat` 手动输密码，或先 `ssh-copy-id`。
12. **回滚风险**：2026-10-30 23:15 用 `git reset --hard 3024475` 回滚过（删掉了开机预热、免确认、屏端缩略图、`main.py` 与 `deploy_pi_display.bat`）。恢复：`git reset --hard pre-rollback-20261030-2315`（该 tag = 被回滚的 `3523484` 状态）。
13. **预备角度「莫名其妙变小」（2026-10-31 已修）**：现场设好 168°/170°，一按「初始化」就掉回 **158°**（预备位夹得更紧，爪尖容易蹭到物块）。真因：`host_gui.App._INIT_PARAMS` 是**类属性**，`gripper_ready_deg` 在 import 时求值 → 拿到协议默认 158（`protocol.GRIPPER_READY_DEG`），那时还没读 `runtime/gripper.json`；`initialize_all()` 每次把 158 下发给固件。日志特征：`param_set,gripper_ready_deg,158` 紧跟一条 `初始化：…`。
    已改成 `_INIT_PARAM_BASE`（不含预备角度）+ `_init_params()` 现算：界面输入框 → 存盘 `gripper.json` → 模块值，三者取第一个合法的 135–180。
    **别再往类属性/模块常量里塞"当前用户设置"**：Tk 界面起来之前加载的文件，一律在用到时现读。
14. **旧帧把 Z 判成"在底"（2026-10-31 已修）**：抓空后回 P0 那一刻，预走刚把 Z 抬到顶，回读还是旧值 `-8 counts` → 被判"Z 已在底"、跳过降底，于是**在高位直接 Y 退回 P0**（现场看到的「抓空后直接回 p0」）。`goto_p0()` 现在强制"连续两次读数一致（差 ≤30 counts）"才下结论，且不在 P1 时先并行回 P1 再降 Z。**别再把单次读数当真相**，尤其刚发过运动命令之后。
15. **X/Y "又分开走"（2026-10-31 已修）**：现场看到 X 先走、Y 后补，日志一堆 `Y 并行：被拒绝 reason=speed_limit`。真因两层：
    - 固件复位后 `speed_rpm_max` 回到默认 **300**，而 Y 并行要 **2000** → `motor_pos` 被拒（`host_protocol_inline.h` 里 `rpm > speed_rpm_max` 直接回 `reason=speed_limit`；**`motor_goto` 不看这个参数**，所以只有 Y 并行中招）。
    - 上位机 `move_xy_fast` 在 `speed_setup` 里把 `speed_rpm_max` 抬到 3200，`finally` **又还原成旧值**（"一批只抬一次"的设计 + finally 还原 = 抬完立刻失效）。
    修法：固件默认值改 3200；`move_xy_fast` 不再还原；被拒时抬限速并**原地重发同一轴**；被拒的轴不再退化成顺序补走。判定是否复发：日志里不该再出现 `reason=speed_limit`。
16. **回执竞态 → 假超时（2026-10-31 已修）**：后台抓取线程没传 `wait`，`prep_pose` 默认走 `client.wait_reply()`，而它会 `poll_events()` **把回执从 GUI 事件队列取走**，主线程再也看不见 → 后台干等到超时（现场 02:39:37 Z 抬顶已回 `#265,ok`，02:41:37 才报超时）。`calib_tab._grab_waiter()` 现在只用 `done_of()` 轮询；`wait_reply` 的 docstring 本来就写着"只给脚本用，GUI 别调"。
17. **软位置双计 → 假位移被 RANGE 拦停（2026-10-31 已修）**：`host_client.send()` 在下发前就调 `motion_hook` 记账，**被固件拒绝的 `motor_pos` 也记**，之后补走用 `motor_goto` 再记一次 → `soft_pos[Y]` 从 -13144 漂到 +140570；`_counts_with_soft()` 拿它换算成 2878873 counts，下一条动作算出 **-153714 脉冲**（>120000）→ `第 4 件失败：Y 没走到位：RANGE 单步超行程 1.5 倍`。修法：遥测 counts 一到就回写 `soft_pos/pos_known`（以实测为准），不再靠累加记账。
18. **`EFFECTIVE_RPM_CAP = 50` 是早期错结论（2026-10-31 已修）**：它把 `estimate_timeout_ms` 的有效转速硬压到 50 圈/分，Z 满行程 152000 脉冲被估成 **122 s**。真实现场：Z 2400 圈/分走满行程 1.49 s（有效 ~1910 圈/分）。现在 `EFFECTIVE_RPM_CAP = 2740`。

19. **E10「停止锁存」把整件吃掉（2026-10-31 已修）**：派端串口桥看门狗在笔记本 **1.5 s** 没收到字节就会
    `transport.write(wire.STOP_FRAMES)` 注入四轴停车帧（`orangepi/pi/pi_agent.py: _watchdog_loop`），
    固件随即置停止锁存；等笔记本再发运动命令就被 `E10` 拒，直到有人 `stop_clear`。现场 03:14 那件就是这么丢的
    （`#123,err,E10` → `第 1 件失败：Z 没走到位：E10`）。
    修法（`host_client`）：收到 `E10` 且命令属于运动类时，**自动 `stop_clear` + 换新 id 重发原命令**
    （同一 id 重发会被固件当成重传、回放的还是那条 E10），最多 2 次；应答按**原请求 id** 结算，调用方无感。
    人按「停止全部」造成的锁存**不自动清**（`_user_stop` 守卫，安全优先）。
    同时放宽链路判定：`LINK_TIMEOUT_MS 8000→15000`（中间静默 5 s 只告警「链路变慢」）、
    运动类「被接纳」超时 1500→3000 ms（`prep_pose.ACK_MS`）、`param_get` 800→1500、`param_set` 1200→2000。
    判定是否复发：日志里偶尔出现 E10 没关系，**不能**再出现「E10 → 第 N 件失败」。
20. **云端分类拖慢节拍（2026-10-31 已修）**：网络一慢 `ask_objects2` 从 1.2 s 涨到 6.5~6.7 s；
    而 `classify_fused` 先按 8 s 上限调双图、再用 **10 s 不封顶**的单图重试 → 分类 18.55 s、识别总耗 20.6 s。
    修法：云端单次封顶 **6 s**（`cloud_vlm.DEFAULT_TIMEOUT`、`vision/config.json` 的 `cloud_vlm.timeout_s`）；
    一次调用 >3.5 s 就**熔断 120 s**（之后直接用本地几何判据，不再调云端）；偏慢/熔断时跳过单图重试；
    `available()` 探测 1.5→5 s、缓存 60→10 s（原来一次抖动就把云端功能「锁死一分钟」）。

21. **「Z 转速一抬反而更慢」（2026-10-31 已修）**：Z 从 2400 抬到 2800，单趟反而从 1494 ms 变成 1848/2182 ms、`passes` 从 0 变 1~2。
    机理：驱动器停的位置比闭环容差（`goto_tol_counts=350` counts ≈0.017 圈）稍偏 → 固件用 `goto_final_rpm`（默认 **60 圈/分**）补一趟；
    补的位移不到 1 mm，时间全花在固定开销上（等停稳 2 份遥测 + 20 ms 总线空档 + 慢速补走）。
    **结论：抬高转速必须同时放宽容差**，否则净变慢。本轮：Z `GOTO_RPM_BY_AXIS[1] 2400→3000` + `GOTO_TOL_BY_AXIS[1]=1500 counts`（≈0.044 mm，竖直轴无感）；
    固件侧再把 `host_goto_estimate_ms()` 的 +250 ms 余量降到 +60 ms、`HOST_GOTO_STABLE_NEED 2→1`（SETTLE 本来就会等停稳，这两处是纯白等）。
    预期 Z 单趟 1.62 s → 约 1.1 s。判据：日志里 `motor_goto` 的 `elapsed_ms`（Z 满行程应 ≈1000~1200 ms、`passes=0`）。

22. **Z 轴提速到头了（2026-10-31 实测结论，别再折腾）**：
    - 转速上限：rpm=3000 跑 93 趟，`elapsed_ms` min 1414 / **avg 1585** / max 1794、`passes` 全 0、`|err|` max 1169 counts；
      rpm=2400 跑 15 趟 avg **1617** → 只差 24 ms/趟。折算有效 **1804 圈/分（96 kHz 步频）**，单趟最快 1414 ms（2013 圈/分）。
      3000 圈/分需要 160 kHz，实际只有 96 kHz → **电机/驱动器能力上限**（≈60 mm/s，1658 脉冲/mm）。
    - 抬升高度：`Z_UP = -152000` 是**现场硬性要求，不可以改**（抬不到顶横移会撞物块/箱口）。
    - 合起来：一件 4 趟 Z（②抬④降⑥抬⑧降）= **约 6.1 s，是硬成本**。抬转速、改细分、调行程三条路都堵死了，
      别再把"Z 变快"当待办；要省时间只能挖非 Z 段（见 §9 第 12 条）。

23. **松爪前白等转盘 1.5 s（2026-10-31 已修）**：转盘原来在「⑤夹紧之后」才开始转，而 -120° 要 **7.42 s**、
    回程（⑥抬 ⑦回P1 ⑧降）只要 ~6 s → 到落料位还得 `join` 等 **1.51 s** 才能松爪（现场 04:02 那件就是这么白等的）。
    修法：`run_once(..., tray_early=True)` 把转盘启动提到**本件一开始（①Y 之前）**——盒号在 `run_many` 里早就定了，
    转盘只动 3 轴、与 Y/Z/X 电机独立，货块也不在转盘上，所以全程并行是安全的。
    重试场景加了防重复转：`run_once` 把本件已转的度数写进 `state['tray_applied']`，`run_many` 重试时把需要的角度减掉
    （日志「重试不再转盘（上一轮已转 +120°，剩 +0°）」）。旧顺序可用 `tray_early=False` 复现。

---
24. **白色/浅色物块漏抓（2026-10-31 已修）**：托盘里两个**白色六棱锥**一直识别不出来，`第 N 件` 永远轮不到它们。
    两道门都会杀它（都实测过）：
    - 候选前景只认 `饱和度 > 45`，白块实测 **S≈11~15** → SAM 一个提示点都落不到；
    - 就算打了点，掩膜的「物体性」门是 `sat_mean < 32 and diff_mean < 20` 就丢；白块 S≈10，
      现场又没开 `gray_objects`（无空托盘差分）→ 必丢。
    修法：`auto_segment._white_mask()` 用**局部亮度比**找白块（`V / GaussianBlur(V, σ≈0.04·边长) > 1.10`
    + 低饱和 + 够亮），`_white_ok()` 再做块级过滤，`segment()` 把白色候选并入前景并放宽物体性门
    （白候选命中 ≥35% 即可）。阈值来自现场帧实测：
    白棱锥 7262 px / 填充 0.52、7778 px / 填充 0.44；托盘内壁反光带 3800 px / 填充 0.37
    → `white_min_area=5000` + `white_min_fill=0.35` 正好把假目标挡在外面。
    **判据**：日志/`runtime/latest_targets.json` 里应出现 `白|六棱锥`；`stats['white_blobs']` 在
    `detect_targets` 里会统计白银候选块数。整条分支可用 `"white_objects": false` 关掉。
    注意：离线脚本进程里 `SAM.predict()` 会崩 `0xC0000005`（ACCESS_VIOLATION，本机环境问题），
    这条分支只能用**纯 OpenCV 候选 + 假 SAM 管线**回归（`host/tests/test_auto_segment_white.py`），
    端到端只能开 GUI 验。

25. **「Z 降到底后停顿几秒」= 回执被链路拖住，不是 Z 慢（2026-10-31 已治）**：
    固件自报 `elapsed_ms` 恒 1034~1054 ms（真走完了），但回执迟到 2~6 s（05:13–05:31 会话里 Z 的 60 次
    `motor_goto` 有 18 次迟到 ≥1.5 s，最坏 6 s），期间遥测整段断流（`链路变慢：已经 5 s 没收到任何数据`、
    `ping 无应答`）→ `move_abs` 在等回执，看起来就是「降到底卡住」。
    真因：图传 1920×1080@8fps 请求把派端 CPU 吃满（相机原生只有 1280×720，`pi_agent._encode()` 先放大再压
    JPEG，实测只出 ~1.1 fps）+ 四轴 5 Hz 遥测（≈20 帧/秒）→ 串口桥转发线程被饿死，遥测与回执一起积压。
    已做的三件事：
    - A：`vision/config.json` 的 `fps 8→3`，`Stream.run()` **真的按 fps 节流**（以前只是把 fps 传下去，没限速）；
    - D：`tele_on` 周期 200→**400 ms**（`protocol.TELE_PERIOD_MS`），遥测帧不再额外发一条 `rx` 事件
      （界面原来把 `rx` 和 `tele` 各记一行，光日志就 40 行/秒，读写都在挤链路）；
    - ①③（用户明确要求）：Z 降到底**立刻松爪**、**不再等转盘**（原来 join 最多 8 s、现场白等 1.5 s），
      夹紧指令发完**立刻抬 Z**（不再留 180 ms）。
    **判据**：日志里 `链路变慢`/`ping 无应答`/`[自动抓] 读数不够新` 明显变少；单件不再偶发 +2~6 s。
    没做的：B 降分辨率（画面标注按 1920 标定坐标画，降了会整体错位，2026-10-31 试过已回退）、
    C 把派端 JPEG 编码挪出主循环（要改 `orangepi/pi/pi_agent.py`，风险大、收益要现场验）。

26. **「爪子没松 / 预备角度像没了」= open 与 ready 背靠背下发（2026-10-31 已修）**：
    现场 05:54 的用户反馈，日志里 `$119,gripper,open` 与 `$120,gripper,ready` 同一秒（相隔 ~1 ms）：
    固件 `host_cmd_gripper`（`host_protocol_inline.h:2112-2185`）收到命令就 `Servo_SetAngle()` 无条件写 PWM
    （`control_inline.h:312-326`、`servo.c:58`），**不看 busy、不等舵机**，所以 ready 立刻把 open 的目标角度
    覆盖成 168° → 舵机来不及从 135° 张到 180° → 爪子看着没张开、物块也可能不掉。
    注意：**预备角度参数一直没动过**（连接日志 `$3,param_set,gripper_ready_deg,168`、参数快照
    `gripper_ready_deg=168`、`host/runtime/gripper.json` 也是 168），`gripper ready` 命令每件都在发。
    修法：`SETTLE_OPEN_MS = 220`（0 → 220），open 之后留 0.22 s 给舵机真正张到 180°，再发 ready；
    回预备仍然不等（180°→168° 在下一件 ②Z 抬顶期间转完），转盘/落盒也仍然不等。
    单测 `test_auto_grab.ReleasePacingTest.test_open_then_ready_keeps_a_mouth_opening_gap` 守住这条
    （open 与 ready 之间必须有一段 ≥150 ms 的等待）。

27. **派端屏的货物图改成「预设照片」，不再实时截取（2026-10-31 现场要求）**：
    用户要求「@图片/presets/ 让派端调用这几张照片，不在实时截取」。原逻辑是收到 `item` 后
    从派端 5060 预览口抓一帧、按 bbox 裁剪（`pi_display._fetch_photo_later`），每件多拉一次图、
    样子还随光照变。现在：
    - `pi_display.py` **先查 `presets/` 预设图**（按「形状\|颜色」，查不到退到同色同族、再退到同族），
      查不到才用上位机推的 `thumb_b64`；`_fetch_photo_later` 默认**不调用**，
      要恢复抓拍就带环境变量 `PI_DISPLAY_LIVE_PHOTO=1` 启动；
    - 上位机 `display_link.SEND_THUMB = False`（默认不再每件解码顶视图+裁剪+压 JPEG+base64，
      `auto_grab.py` / `calib_tab.py` 都不再算 thumb），省 CPU；
    - `图片/presets/` 的 6 张 512×512 原图 → `tools/make_presets.py` 生成
      `orangepi/pi/presets/<基名>_{52,56,96,160}.png` + 人工维护的 `index.json`；
    - **坑（现场截图发现）**：屏是 1024×600，列内缩略图只有 `f(52)=52 px`、底栏 `f(56)=56 px`。
      Tk 的 `Label(width=52)` 对 96 px 的图是**从左上角裁**，不是缩放 → 第一版只生成 96/160 时，
      屏上每张图都只剩「灰底 + 一角」。修法：多生成 52/56 两档，`preset_photo()` 按请求尺寸挑
      「相近且不小于」的档；真不在档里再 `PhotoImage.subsample(k)` 整数倍缩小。
    - 部署：`deploy_pi_display.bat` 第 4 步原来指向不存在的 `..\.survey\start_disp.sh`（必失败），
      已改成调派端 `start_display.sh`（并 `setsid nohup` 让它脱离 ssh）。
    - **事故（2026-10-31 07:35，用户报「派端图片不对，现在是纯色图片」）**：派端 `pi_display.py`
      被换回了 10-30 的旧版（38126 B、mtime 还是 10-30 10:57，明显是带时间戳同步覆盖的），
      `presets/` 目录整个不在 → 旧版拿不到图就画**纯色方块**。重传后立刻恢复正常
      （现场真机截图：椭圆柱|红 显示粉色椭圆柱实物图）。为防止再次"悄悄变回去"：
      * `pi_display.py` 加 `BUILD = '2026-10-31 presets-only'`，启动打印
        `[display] BUILD=... 启动（... live_photo=False）`；
      * 新增 `self_check_presets()`，缺目录/缺图时打印 `[preset] !! ...`（一眼能看出"图没了"）；
      * `deploy_pi_display.bat` 上传后**核对远端 md5 + presets/*.png 数量 + index 行数**，
        不一致就 `:fail` 退出（以前无论传没传上去都说 DONE）；
      * 顺带装开机自启 `~/.config/autostart/pi_display.desktop`（调 `start_display.sh`），
        这样重启派端后屏幕自己回来（以前要手动起）；
      * **坑**：`deploy_pi_display.bat` 必须是 **CRLF** 行尾 —— 用 LF-only 写出来时 cmd.exe 会
        逐行吞掉首字符（报 `'nabledelayedexpansion' is not recognized` 这类鬼错）。
    - 单测 `01-交付包/host/tests/test_presets.py`（14 个）：index 与 4 档图齐全、无孤儿图、
      现场 6 个类别键都能查到图、颜色写错能退到同形状、未知形状返回 None、`pi_display` 先查预设且
      实时抓拍受开关控制、上位机默认不推 thumb、BUILD 横幅与 `self_check_presets` 在位、
      自启条目存在、bat 会校验 md5/预设数量且是 CRLF 行尾、形状没认出来时能按颜色兜底
      （第 8 件类别名是 `—`、颜色 `蓝/浅蓝` → 蓝长方体预设图；`透明` 这种无对应颜色 → None）。
    - **"纯色图片"还有第二种来源（2026-10-31 07:45 现场看到）**：形状识别成 `—` 的件，预设查不到 →
      退回上位机裁的缩略图，屏上就是一块纯色。现在 `preset_photo()` 多一级兜底
      `_preset_base_by_color()`：形状族对不上时按颜色（含 `蓝/浅蓝` 这种多色串）挑同色预设图。

28. **E02 零脉冲补走把一整件打挂（2026-10-31 07:39 已修）**：`move_xy_fast` 的残差段先用旧帧算出
    `Y 并行残差复核：-49332 → +0 脉冲（用新鲜读数）`，`miss` 变成 0 之后**没有重新判容差**，
    仍然发了一条 `motor_goto,5,0,350,2000` → 固件回 `#203,err,E02,reason=pulses` →
    `Y 补走失败：code=E02 reason=pulses` → `[连续抓] 第 7 件失败：Y 补走未完成（锁存/超时），中止本件`。
    修法（`01-交付包/host/prep_pose.py`）：
    * 复核出新鲜残差后**重新判一次**容差，`|miss| <= max(XY_MISS_TOL_PULSES, tol_pulses)` 就
      `continue`（日志「并行残差复核后已在容差内（…），不补走」）；
    * `_goto_wait()` 开头对 `0` 脉冲直接返回 True、不发指令（「补走 0 脉冲：已经在目标位」）。
    单测：`tests/test_prep_pose.py::ParallelResidualTests::test_fresh_read_that_clears_the_residual_sends_nothing`。

29. **视觉没定名的件吃掉盒号 → 第 7 件「分盒失败」整批停（2026-10-31 07:41、07:47 两次，已修）**：
    视觉偶尔给不出定名（`待登记` / `副摄待确认` / `—` / `未知`），`class_key()` 把它们当**新类别**，
    `BM.assign()` 各占一个盒（现场 6 类里混进 `副摄待确认|蓝/浅蓝 → 6 号盒`），下一件 `待登记|红`
    撞上满盒 → `分盒失败：6 个盒子都已分配给其它类别` → `break` 停机。
    修法（`01-交付包/host/auto_grab.py`）：
    * 新增 `UNNAMED_SHAPES` / `is_named()` / `box_for(key)`，`run_many` 的两处分盒都走 `box_for`；
    * 没定名的键**不占新盒**：① 先复用**同颜色**的已登记类别盒（分盒可能错这一件，但不停批）
      → ② 还有空盒就占空盒并登记该键 → ③ 6 盒都满 → 复用**最后登记**的盒，只 WARN；
    * **任何情况都不再因为分盒 break**；
    * `pick_order()` 改成**定名的目标优先**（没定名的排最后，别白占分盒名额）。
    单测：`tests/test_auto_grab.py::BoxForTests`（7 例）。

30. **同时开两个窗口 → 互踢串口 + 关窗口把正在跑的件打死（2026-10-31 07:35，已修）**：
    现场同时开了两个 GUI，两个都连同一块板子：
    * 两个实例抢 5058 → 07:33:50–07:33:56 连续 `失联→重连→主动断开→连接成功`；
    * 关掉其中一个窗口时 `host_gui._on_close` 会 `client.stop_all()`，把另一个窗口**正在跑的那件**
      打成 `E14 reason=stopped`（07:35 一分钟内 `已下发停止全部 19 次`、5 件失败都是这个原因）。
    修法：`01-交付包/main.py` 启动先抢本机单实例锁（源码里 `LOCK_PORT = 47319`，
    绑 `127.0.0.1:47319`；Windows 上**不能**设 `SO_REUSEADDR`），抢不到就弹提示并 `return 2`；
    调试确实要多开时加 `--allow-multi`。
    单测：`tests/test_single_instance.py`（4 例）。
    附带：`初始化` / `位置清零` 撞上正在跑的 goto 会回 `E09 忙/队列满` → **先停止、再初始化**。

31. **每件重新拍照 + 开批刷新派端屏 + X/Y 整对重发（2026-10-31 现场固定时序）**：
    用户明确"这些都是死的"：每次「一键启动」必须刷新派端屏、清零分盒；识别期间**先 Y 后 Z**；
    X/Y **必须一起走**、不许分开；任何轴转速不许降；夹紧后等 0.2 s；转盘务必在爪子到落料位前到位；
    松爪后**立刻**拍下一张开始识别、同时 Z 抬顶，Z 上升期间爪子回预备角 168°。
    做法：
    * 派端屏：`display_link.reset()` 推 `kind=reset`，`pi_display.Screen.apply()` 收到就把 6 个盒卡片
      清空、`done/elapsed` 归零、回「等待第一件」；`run_many` 开批第一件事就是推它（日志「派端屏已刷新」）。
    * 每件重新识别：`calib_tab._many_worker` 传 `recognize_each=True`（否则会拿一次识别的清单逐件消费，
      松爪后不会重新拍照）。
    * 预走：`_prefetch_channel()` 恢复「①Y 进通道 → ②Z 抬顶」两步（04:30 那版曾把 ② 回滚掉）。
    * 转盘：`tray_early=True` 一开始就转；⑧ 降 Z 之前 `tray_job.join(TRAY_JOIN_TIMEOUT_S)` **硬等**，
      转盘报错/超时 → `GrabError` 中止本件（不降 Z、不松爪），不再"只 WARN 就松爪"。
    * 夹爪：`SETTLE_GRAB_MS = 200`；open 后 220 ms 发 ready（§8 第 26 条），ready 不等。
    * X/Y 收口：`move_xy_fast` 删掉单轴 `motor_goto` 顺序补走，残差/被拒都改成
      `_send_round()` 把需要动的轴**整对重发**（`X/Y 并行收口（第 n 轮）`），最多 2 轮，
      之后仍有偏差就日志说明"按现场要求继续本件，不再单轴补走"。
    单测：`tests/test_display_reset.py`（含「一键启动必须传 recognize_each=True」「预走 Y 在 Z 之前」「SETTLE_GRAB_MS=200」「转盘等到位在松爪之前」四条源码守卫）、`tests/test_auto_grab.py::PrefetchTest`
    （Y→Z 顺序 / 转盘必须到位 / 转盘报错不松爪）、
    `tests/test_prep_pose.py::ParallelResidualTests::test_moderate_residual_is_re_sent_in_parallel`。

32. **X 轴「莫名其妙不对」（收口基准用了旧帧，2026-10-31 16:54 现场，已修）**：
    现象：某几件 X 会多走一截、甚至冲出 0 点（遥测 `addr=4 counts=-178145`），下一件又"纠正"过头。
    日志铁证（16:54:17 那件）：
    * `[自动抓] X 并行：-8668 脉冲（300 RPM）` → `$110,motor_pos,4,1,300,0,8668,rel`；
    * `X/Y 并行：0.70 s 内读数没有变化…交给残差逻辑收口` → `X/Y 并行收口（第 1 轮）：X -472`；
    * **紧接着实际发的还是 `$113,motor_pos,4,1,300,0,8668,rel`** → X 多走 8196 脉冲；
    * 下一件目标 X +6423，实际下发 `+15114`（= 6423 + 8691）→ 又顶回量程另一头。
    根因：`move_xy_fast()` 里两个函数**读不同来源的位置**——
    `_residual_fixes()` 用 `fresh_counts()`（连续两帧一致，慢但准）算出残差 -472；
    而 `_send_round()` 用 `read_counts()`（只取当前最新一帧，可能是 2.8 s 前的旧帧 +8668）
    再算一次「绝对目标 − 基准」→ 得到 -8668。于是「日志说 -472、实际发 -8668」。
    加重因素：`|miss|` 在 3000~40000 之间只告警「继续本件」，8k 级错位不会停机。
    修法（`01-交付包/host/prep_pose.py`）：
    * `_send_round(send_map, rel_map=None)` 的基准改成 **`fresh_counts() or read_counts()`**
      （和残差同一个来源）；
    * 收口轮把**残差量直发**（`rel_map`，日志 `X/Y 并行收口（第 n 轮）… X 并行收口：%+d 脉冲直发（残差量…）`），
      不再"绝对目标 − 基准"二次换算 —— 基准过期一帧也不可能再多走一整段。
    单测：`tests/test_prep_pose.py::StaleBasisTests`（3 例：残差 472 只发 472 / 残差 100 不等于整段 5000 /
    收口的两轴仍在同一批里紧挨发出）。

33. **X/Y「乱走 / 原地抓取」的真因：拿 1.6 s 才刷新的遥测当当前位置（2026-10-31 18:12 现场，已修）**：
    现象：前几件还行，后面开始"走着走着不对"、偶尔在托盘上方就松爪（等于原地放回），
    批末回 P0 又"自己调回来了"。18:12 那批：**4 成 1 败、127.1 s**，第 8 件回程只发
    `X +4 / Y +9` 脉冲（应 −821 / +74,277）、第 10 件去程 X 发 −3419（应 −127，多走 34 mm）。
    根因链：
    * 每段 X/Y 位移是"目标 − 回读基准"；基准取自遥测 counts，而 X/Y 的 counts **1.6 s 才刷新一次**
      （固件每个遥测节拍只查一根轴），Y 42,675 脉冲/s → 基准最坏偏 6.8 万脉冲；
    * 走位等待又按 `min(转速, 1240)` 估 → 比实测 Y（800 圈/分）少等 1.55 倍，常常"还没到就进下一步"；
    * "判停稳"比较两次读数差 ≤24，而遥测把同一缓存帧重复 4~5 次 → 值相同、必然判成停稳 → Z 提前下压；
    * 偏差 >3000 只告警"继续本件" → 该件抓偏，下一件又从错位基准继续 → 越走越乱；
    * 批末 `goto_p0()` 走 `motor_goto` 闭环（固件 20 ms 查该轴 + 补差）→ 位置被拉回真值。
    修法（`01-交付包/host/prep_pose.py`、`host_client.py`、`common/wire.py`）：
    * **基准现查**：`query_pulses()` 发 `motor_query` 直问驱动器（忙 E09 重试 3×15 ms），
      查不到才退回遥测并告警；
    * **按实测转速等**（`EFFECTIVE_RPM_BY_AXIS`，Y 800），先睡 `t_est*0.6`，之后每 0.20 s 现查一次，
      两轴都进容差就立刻走（`X/Y 并行：现查已到位（x.xx s）`）——又快又准；
    * **残差按剩余量整对重发**（`rel_map`），不再有单轴 `motor_goto` 补走、也不再"只告警不纠"；
    * **`motor_goto` 遇 E10/E14 自动 `stop_clear` 后重试一次**（原来直接判整件失败）；
    * **心跳 1000→500 ms、派端看门狗 1500→3000 ms**，消掉"抖一下就锁存"。
    单测：`tests/test_prep_pose_query.py`（8 例：基准来自 motor_query 而非遥测 / query 在 move 之前 /
    提前放行 / 残差只发剩余量 / 两轴背靠背 / E10 自动清锁存重试 / 心跳<看门狗 / 实测转速）。

## 9. 待办（按优先级，含做法）

### P0（比赛前必做）

1. **恢复运行态配置**：`tray_scale.json`（约 `{"scale": 2.0}`）、`route.json`。可从 tag `pre-rollback-20261030-2315` 取，或重标（转盘转 60° 量实际角度，`scale = 2.0 × 60/(60+偏差°)`）。
2. **12 件真机彩排**：摆 6 类×2 → 勾「抓完落货」→ 连续抓 → 记录总时长/失败件/节拍；目标 ≥11/12、≤15 s/件。
3. **派端屏更新**：跑 `deploy_pi_display.bat`（预设图 + 照片修复才生效）。
4. ~~点「分盒清零」~~ **已自动化（2026-10-31 02:50）**：每次「一键启动 / 连续抓」开批自动清零（`run_many(..., reset_boxes=True)` → `box_map.auto_reset`），日志打「分盒已自动清零（每批重新分配盒子）：<旧登记> → 0 类」；手动按钮仍保留。

### P1（提准确率/提速）

5. **接 `ask_crops`**（`vision/cloud_vlm.ask_crops` 已实现未接）：把每件放大到 300 px 拼成编号图再问一次，低置信时二次问 → 预期密排场景明显变好。
6. **`frames_for_vote 1→2`**（可选）：整批两帧投票，降"首帧错到底"。注意这个配置 **2026-10-31 起才真正生效**（之前 `recognize_blocking` 写死 2 帧）；现在 1 帧 ≈ 2~5 s，改 2 就是多花一倍时间，只在误识别偏多时才开。
7. ~~**一键启动 15 s 加速**~~ **已实施（2026-10-31 01:45）**：根因是**识别本身就要 8~17 s**，且机械臂在等识别。实测拆解：SAM **首帧推理 ~8 s**（`_prewarm` 只 `SAM(...)` 加载权重、不跑推理）+ `recognize_blocking` 写死 `max(2, n)` 硬凑 2 帧（配置里 `frames_for_vote: 1`）。已做：
   - `vision/auto_segment.AutoSegmenter.warmup()`：造一张 700×700 假托盘（灰底 + 饱和色块）真跑一次 `segment()`；`vision/gui._prewarm` 在「打开双画面」时调用（日志「分割模型预热完成（含首帧推理）」）。A/B 实测：冷启动首帧 2.7 s → 预热后 1.1 s（真机 8 s 尖峰同理被吃掉）。
   - `recognize_blocking` 改成 `n = max(1, min(5, n))`，与 `_recognize_precheck` 一致：1 帧 = 顶视SAM + 副摄SAM + 云端分类，约 2~5 s；配置里本来就是 1。
   - `auto_grab.run_many(..., prefetch=True)`（`calib_tab._many_worker` 传 True）：识别期间后台先走「①Y 进通道」，点完按钮 <1 s 机械臂就动；这一步与识别结果无关。**Z 抬顶不在预走里**（= 2.29 版行为；现场明确"Z 必须抬到位才允许横移"，且抓空那件会白抬 1.6 s 再降 1.6 s）。**安全闸**：只有两次回读都确认 Z 在底（`PREFETCH_Z_TOL_PULSES = 400` 脉冲 ≈ 0.24 mm、两次差 ≤200 counts、龄期 ≤`COUNTS_MAX_AGE_MS`）才预走，否则只打一行「预走跳过」按常规顺序走；预走线程在 `run_once` 前 join，绝不和正式动作抢固件；单件/测试默认 `prefetch=False`，行为不变。
   - `run_many` 现在把识别耗时落进现场日志：`[连续抓] 识别完成：x.x s` + `[连续抓] 视觉：<各段耗时明细>`（以前只在「视觉」页 note 里，不落盘，排查看不到）。
   - 未做（要权衡）：B「连接即订阅四轴遥测」、C 去 `messagebox.askyesno`（这层确认是安全提醒，建议保留；要快就点「是」别犹豫）。
8. **「一键启动」前置校验**：点击前检查是否在 P0 / Z 是否在底，否则弹提示。（`prefetch` 的 Z 底闸只保护自己那两步，整件动作仍需这层校验。）
9. ~~**每件节拍提速（23.9 s → 预期 ~16 s/件）**~~ **已实施（2026-10-31 02:30；回滚点 tag `pre-speedup-20261031-0213` = 提速前现场版本）**：
   - **回 P0 重写三分支**（见 §6）：不在 P1 时 `X/Y 并行回 P1 → Z 降底 → Y 回 0`，绝不"就地降 Z"；判 Z 是否到底改用连续两次一致的新鲜读数。
   - **X/Y 永远并行**：`run_once` 里所有 X/Y 都走 `move_xy()` → `prep_pose.move_xy_fast`（两轴 motor_pos 同时下发），不再出现"先 X 后 Y"。
   - **删掉 `_settle_counts`**（一件 6~8 次 × 0.6 s ≈ 4~5 s 白等）：改成"读数够新就直接走"（`COUNTS_MAX_AGE_MS = 800`，最多重取 2×30 ms），缺读数用软位置补，精度交给残差复核。
   - **夹爪/落料等待**：夹紧后 450→180 ms、松爪后 500→150 ms、回预备位不再单独等（`SETTLE_* = 180/150/0`）。
   - **前置准备整批一次**：`run_once(..., prep=)` 首件 True 之后 False；`move_xy_fast(speed_setup=)` 也只做一次 param_get/param_set。
   - **预走只走 ①Y**（02:56 回退；02:50 那版恢复了 ②Z 抬顶，实测让抓空那件白多 3.2 s，且与"Z 必须抬到位才横移"的规矩冲突）。
   - **转速**：`protocol.GOTO_RPM_BY_AXIS` Z 2200→**2400**→（2026-10-31 三轮）**3000**，且必须与 `GOTO_TOL_BY_AXIS[1]=1500` 成对出现，见 §8 第 21 条（2800 已回退：02:37 实测 Z 单趟 1474–2182 ms、常带 `passes=1~2`，比 2400 的 1494 ms 更慢）、Y 1600→**2000**（X/托盘仍 300）。现场若 Z 有异响/丢步/闭环反复补差，把 `[1]` 再降一档。
   - 实测（2026-10-31 02:21 真机 6 件 88.1 s）：单件 **11.9~15.3 s**（提速前 23.9 s），其中 Z 四趟 5.98 s（占一半，纯行程）、X/Y 2 趟 2.4 s、夹爪/落料 0.4 s、杂项 ~2.7 s。**这是「2.29 版」基线，后续版本只能更好不能更差**。

10. ~~**分盒每次一键启动自动清零 + 二轮提速**~~ **已实施（2026-10-31 02:50）**：
    - `run_many(..., reset_boxes=True)` 开批第一件事就是 `box_map.auto_reset(log=log)`（`calib_tab._many_worker` 传 True，日志留痕「分盒已自动清零…→ 0 类」），彻底消灭"旧登记占满 6 盒 → 第 7 件分盒失败"停机；手动「分盒清零」按钮保留。默认 False，单件抓取/旧调用行为不变。
    - `COUNTS_MAX_AGE_MS` 400→**800 ms**、重取 5→**2 次**（02:22 那批「读数不够新」42 次 × 最多 0.15 s ≈ 1 s/件）。
    - ~~预走恢复 ②Z 抬顶~~ **02:56 已回退**（见第 9 条）；~~Z 转速 2400→2800~~ **已回退**，2026-10-31 三轮改为「3000 + 容差 1500 + 固件 goto 余量 250→60 ms / STABLE_NEED 2→1」（2800 实测更慢的机理见 §8 第 21 条）。

11. ~~**固件默认值 + 上位机兜底（"每次重启都是速度版"）**~~ **已实施（2026-10-31 03:05）**：
    - 固件 `host_param_defaults`：`speed_rpm_max 300→3200`、`acc 1→0`、`telemetry_ms 200→100`、`gripper_ready_deg 150→168`（只改初值，协议不动）；已用 Keil 命令行重编并覆盖 `stm32/hex/STM32F429.hex`（hex 里 4 个默认值已按地址核对过）。**改动说明给队友 AI**：`01-交付包/stm32/docs/固件-速度版默认值-20261031.md`。
    - 上位机 `protocol.PARAM_DEFAULTS` 逐项对齐（有单测守着）、`GRIPPER_READY_DEG=168`。
    - 连接成功即下发速度版参数 + 日志打 `[连接] 参数快照：speed_rpm_max=… acc=…`。
    - `move_xy_fast` 不再还原 `speed_rpm_max`；被 `speed_limit` 拒时抬限速并**原地重发同一轴**（不再退化成 X 先走、Y 后补）。
    - `EFFECTIVE_RPM_CAP` 50→2740（旧值把 Z 满行程估成 122 s → 假超时）。
    - 后台抓取线程改用 `done_of` 轮询回执（不再用抢 GUI 事件队列的 `wait_reply`）；遥测 counts 实时回写 `soft_pos`（修软位置漂移 → 假位移被 RANGE 拦停）。

12. **Z 侧已无提速空间（2026-10-31 定论）**：转速到硬件上限（~1804 圈/分，实测见 §8 第 22 条）、
    抬升高度是硬性要求不可改 → 一件 4 趟 Z ≈6.1 s 改不动。
    剩下的时间只能从**非 Z 段**挖：一件 11.9 s 里 Z 5.98 s、X/Y 2.4 s、夹爪 0.33 s，还有 **~2.7 s 杂项**
    （计数取样、每步的 settle/遥测等待、日志与写盘、转盘 join 等）。要提速就先做这 2.7 s 的分段实测，别再动 Z。

### P2（工程化）

11. 提示词抽 `vision/rules/<套名>.json`（换物块只改 json，不改代码）；现硬编码在 `cloud_vlm.py: SHAPES/COLORS/_RULE/_SCENE`。
12. 抓空检测（夹爪无货检测）、E10/E14 锁存自动诊断。
13. 派端 `robotpi.service` 开机自启 + 操作卡定稿（`02-资料库/` 里已有旧版）。
14. 文档补 `preview_port: 5060`、`deploy_pi_display.bat` 用法、开机 1 号盒对零。

---

## 10. 现场操作卡（比赛当天照着做）

1. 派端开机 → 屏幕「待机」六列。
2. 笔记本连派（同 WiFi/网段），`run.bat` → 连接。
3. **Z 降到最底** → 点「位置清零」（否则整套反向）；四轴回读都应接近 0。
4. 视觉页「打开双画面」→ 校对顶视四点框（绿框应贴住托盘内框）→ 「单次识别」看是否把 12 件都框住。
5. 手转 **1 号盒正对落料位** → 点「托盘角度清零」（转盘无绝对编码器，每次开机都要做）。
6. 摆 12 件（同色同类同盒，别叠放、间隔 ≥2 cm）。
7. 运行台 → 点「一键启动」→ 全程手放 Esc；抓空后自动回 P0。
8. 异常：按「停止全部/Esc」→ 机器停在原地（可能握着货）→ 人工处理后再「初始化」重来。

---

## 11. 我这边已验证的事实（可直接信任）

- 单元测试 **341 个全绿**（原 251 + 3 个并行残差用例 + 1 个「初始化不得冲掉预备角度」用例 + 3 个「预走 / 识别耗时落盘」用例 + 4 个「回 P0 分支」用例 + 2 个 `box_map.auto_reset` 用例 + 2 个「run_many 开批自动清零」用例 + 1 个「速度版默认值必须与固件一致」用例 + 3 个「E10 自动恢复 / 人工停止不自动清锁存 / 重试上限」用例 + 7 个「白/浅色物块候选」用例 + 3 个「回执迟到告警 / extend_deadline / E10 恢复不误伤」用例 + 2 个「遥测帧不再重复记 rx」用例 + 1 个「TELE_PERIOD_MS 才是真正旋钮」用例 + 1 个「松爪不等转盘」用例 + 1 个「松爪必须有张嘴时间」用例 + 4 个「开批刷新派端屏 / 一键启动必须 recognize_each」用例 + 4 个「固定时序源码守卫」用例 + 14 个「派端屏预设图 / 不再实时截取 / 部署校验 / 只认颜色时的兜底」用例 + 1 个「复核后残差归零不补走」用例 + 7 个「没定名不吃盒 / 满盒不停批 / 定名优先」用例 + 4 个「单实例锁」用例 + 4 个「回执迟到告警 / extend_deadline」用例 + 5 个「回执迟到时按遥测 counts 判到位」用例）；
  界面自检 **8/8 页**（运行台/视觉/X-Y 标定/运动控制/参数/动作序列/视觉目标/原始日志）。
  - 注意：在 DSH 沙箱里 `tempfile.mkdtemp`（`os.mkdir(mode=0o700)`）建出的目录写不进去，
    跑测试要绕开或换非沙箱终端；产品代码/断言不变。
- 预备角度 bug 已修并有用例守住（2026-10-31）：`initialize_all()` 下发的 `gripper_ready_deg` 等于
  界面/存盘值（测得 169），不再固定 158；`_INIT_PARAM_BASE` 里没有 `gripper_ready_deg` 这一项。
- 跑用例不再往现场日志灌假数据（2026-10-31）：`host_gui.LOG_DIR` 可改，界面冒烟用例指到临时目录；
  排查现场问题时 `runtime/host-YYYYMMDD.log` 里只有真机流量。
- E10 自动恢复（假固件验证，2026-10-31）：派端看门狗锁存 → 客户端自动 stop_clear + 换新 id 重发，
  原请求 id 拿到 ok（done_of(rid)['kind']=='reply'）；人按「停止全部」时锁存保留、E10 直接报错；
  重试到上限仍报 E10。
- 云端熔断（代码核对，2026-10-31）：单次封顶 6 s；>3.5 s 熔断 120 s 并跳过单图重试；
  vailable() 探测 5 s、缓存 10 s。
- Z 转速上限（真机日志统计，2026-10-31）：rpm=3000 共 93 趟 `elapsed_ms` avg 1585（min 1414/max 1794、passes 全 0）；
  rpm=2400 共 15 趟 avg 1617 → 差 24 ms/趟；有效 1804 圈/分（96 kHz）≈60 mm/s，**已到硬件上限**；
  Z 抬升高度 -152000 是现场硬性要求，不可改（用户 2026-10-31 明确）。
- 转盘提前转（假 client 验证，2026-10-31）：`tray_early=True` 时转盘 `motor_pos` 命令在第一条 `goto` 之前发出、`res['tray_applied']==60.0`；`tray_early=False` 仍是夹紧之后才发（行为可回退）。
- 并行残差分级（假 client 验证，2026-10-31）：回读残差 `+11394`（>3000）→ 只告警、不补走、继续本件；
  `500` → 仍顺序补一次；`-45000`（编码器基准错）→ 仍中止等人工。
- 遥测/日志降量（代码核对 + 假固件验证，2026-10-31）：遥测帧只发 `tele` 事件、不再多发一条 `rx`；
  普通应答仍走 `rx`（日志/抓包还靠它）。`tele_on` 周期统一取 `protocol.TELE_PERIOD_MS=400 ms`。
- 节拍动作（假 client 验证，2026-10-31）：`SETTLE_GRAB_MS=200`（夹紧后等 0.2 s 再抬 Z）、
  `SETTLE_OPEN_MS=220`（松爪张嘴 ≥150 ms，见 §8 第 26 条）；
  **转盘必须在 ⑧ 降 Z 之前到位**（没到位就等，上限 8 s；转盘报错/超时就中止本件、不降 Z 不松爪），
  见 §8 第 31 条。
- 固定时序（假 client 验证，2026-10-31）：识别期间**先 ①Y 再 ②Z**（`PrefetchTest`）；
  `run_many(recognize_each=True)` 每件都重新识别；X/Y 残差**整对重发**（每条 motor_pos 两条、
  `motor_goto` 一条都不发）。
- 开批刷新派端屏（假 client + 源码核对，2026-10-31）：`run_many` 第一条派端消息是
  `('reset', {'total': …, 'last_event': …})`，`pi_display.Screen.apply()` 收到 `kind=reset` 会把
  6 个盒卡片置空、`done/elapsed` 归零；日志留痕「派端屏已刷新（6 个盒卡片清空…）」。
- 派端屏预设图（**真机验证**，2026-10-31 07:0x）：`orangepi/pi/presets/` 已上传（24 张 52/56/96/160 + index.json），
  `pi_display.py` 重启后 PID 生效；在派端 `DISPLAY=:0` 里用真 `tk.PhotoImage` 加载，现场 6 个类别键
  （圆锥|黄、椭圆柱|红、长方体|蓝、长方体|红、六棱锥|白、四棱锥|紫）96/160 全部 `True`，
  颜色写错（椭圆柱|绿、长方体|紫）能退到同形状，未知形状（螺丝|银）返回 None；
  推 6 条演示 item 后 `DISPLAY=:0 import -window root` 截屏确认六列都显示正确预设图
  （截图存 `02-资料库/派端屏-预设图-20261031.png`）。`_USE_LIVE_PHOTO=False`（不再实时截取）。
- 派端被旧副本覆盖的事故 + 修复（真机验证，2026-10-31 07:35–07:45）：派端 `pi_display.py` 变回
  10-30 的 38126 B 旧版、`presets/` 目录消失 → 屏上每张货物图退化成**纯色方块**；重传后
  `/tmp/pdisp.out` 打出 `[display] BUILD=2026-10-31 presets-only` + `[preset] ... png=24 index=18`，
  真机跑着的一批里 `椭圆柱|红 → 1 号盒` 卡片显示粉色椭圆柱实物图；开机自启条目
  `~/.config/autostart/pi_display.desktop` 已装（重启派端屏幕自己回来）。
- 「点完一键启动 15 s 才动」的量化拆解（2026-10-31，真机日志 01:23:35 那一次）：点按钮 → 识别 **17 s**
  （期间只有 1 Hz 心跳，机械臂完全没动）→ 01:23:53 才发第一条 `Y 目标 -13144`。识别内部：SAM
  **首帧推理 8 s**（`_prewarm` 只加载权重、不推理）+ 2 帧 × ~4.5 s（顶视SAM 1.4 + 副摄SAM 1.4 + 云端 1.2）。
  A/B 实测（700×700 含 3 块假托盘）：`warmup()` 前首帧 `segment()` 2.73 s、之后 1.15 s；`warmup()` 后首帧 1.09 s。
  修复后预期：点完 <1 s 机械臂就动（预走①②），识别 ~2~5 s 出结果。
- 提速后真机实测（2026-10-31 02:21–02:22，新代码首跑）：6 件 88.1 s，单件 13.9/13.3/11.9/12.7/12.7/15.3 s；
  点「一键启动」到机械臂动 **0.43 s**（预走 Y）；Z 2400 共 24 趟 err 全在 ±350 counts、仅 3 趟 passes=1；
  Y 并行偏离 +10356 脉冲 → **只告警不中止**，第 6 件照常完成（第 1 轮的分级修复现场生效）；
  抓空回 P0 走「P1 且 Z 已到底 → 直接 Y 回 P0」一步到位；唯一停机原因是旧 `box_map` 占满 6 盒（现已自动清零）。
- 回 P0 三分支逻辑（假机械臂验证，`GotoP0Test`）：已在 P0 → 一步不动；P1+Z 底 → 只 `Y→0`；P1+Z 顶 → 先 `Z→0` 再 `Y→0`；不在 P1（托盘上方）→ **X/Y 并行回 P1** → `Z→0` → `Y→0`。
- 转盘判据仿真（目标 1066 脉冲）：正常 6.09 s/1066；±9 counts 抖动 6.09 s/1066.85；只走 50% → 3.67 s 判到位；counts 恒 0 → 4.17 s 按时间收口（`mode=pos_acc_time`）。
- DeepSeek 双图实测：整盘 4 件 4/4 正确；单图 vs 双图耗时 2.0–2.3 s vs 1.2–1.7 s。
- 固件「速度版默认值」已重编并核对（2026-10-31 03:04，Keil `UV4 -b`：`0 Error(s), 0 Warning(s)`，2 s）：
  新 `stm32/hex/STM32F429.hex` 与旧 hex 逐行对比只有 4 条记录不同，正好是那 4 个默认值
  （`:107D3000` acc `0100→0000`、`:107D4000` speed_rpm_max `2C01→800C`(=300→3200)、
  `:107D6000` ready `9600→A800`(=150→168)、`:107DE000` telemetry `C800→6400`(=200→100)）。
- 现场「X/Y 分开走 / 时序不对」的归因（2026-10-31 02:37 那批，日志逐行核过）：12 次 `Y 并行被拒 reason=speed_limit`
  = 固件复位后 `speed_rpm_max` 回 300 + 上位机 finally 把刚抬高的 3200 又还原；Z 2800 单趟 1474–2182 ms（常 `passes≥2`）
  比 2400 的 1494 ms 更慢 → 已回退；第 4 件 RANGE = `soft_pos[Y]` 双计漂到 +140570 脉冲。
  三条都在本轮修掉，且都有日志/单测可验证。

---

- 白色候选阈值的现场依据（2026-10-31 04:35 从派端 5057 拉的 1920×1080 实帧，按 `top_points` 校正成 700×700 后纯 OpenCV 量的）：两个白六棱锥候选 7262 px（填充 0.52）、7778 px（填充 0.44），托盘内壁斜向反光带 3800 px（填充 0.37）；`white_min_area=5000 + white_min_fill=0.35` 之后候选正好剩 2 个（就是那两个白棱锥）。

- 位置回读（假 client 验证，2026-10-31）：`move_xy_fast` 的基准来自 `motor_query` 现查
  （遥测缓存故意写成 0，位移仍按 −13144 算成 −11856）；`motor_query` 一定在 `motor_pos` 之前发出；
  一发出就到 → 1.4 s 内"现查已到位"提前结束；只走八成 → 只按剩余量（2371 脉冲）再并行一次，
  全程 `motor_goto` 0 条；两轴 `motor_pos` 背靠背相邻。
- goto 自动恢复（假 client 验证，2026-10-31）：`motor_goto` 回 E10 → 自动 `stop_clear` +
  按现查位置重算剩余量再发一次并成功收口（日志「自动 stop_clear 后重试一次」）。
- 链路预算（代码核对，2026-10-31）：`HEARTBEAT_MS=500`、`SERIAL_WATCHDOG_MS=3000`，
  心跳两倍仍小于派端看门狗（有用例守着）。
## 12. 名词与文件速查

| 名词 | 含义 |
|---|---|
| P0 / P1 | 初始（落料）位 Y=0 / 通道末端 Y=−13144 |
| 通道 | 爪子从 P0 进入托盘必经的低净高区，必须 Y 先走、Z 在底 |
| 盒位 | 转盘 6 个储物盒，每 60° 一个，`current_box` 记录当前对准落料位的是几号盒 |
| 预设图 | `orangepi/pi/presets/*_{52,56,96,160}.png`，比赛屏按「颜色+形状」取（唯一来源，不再实时截取） |
| class_key | `"形状|颜色"`，分盒的唯一键 |
| latest_targets.json | 最近一次识别的目标列表（含 bbox/center_tray/class_key） |

**关键文件绝对路径**

- 主程序：`D:\study\project\robot-competition\01-交付包\run.bat`
- 抓取核心：`D:\study\project\robot-competition\01-交付包\host\auto_grab.py`
- 识别主流程：`D:\study\project\robot-competition\01-交付包\vision\gui.py`
- 提示词：`D:\study\project\robot-competition\01-交付包\vision\cloud_vlm.py`
- 视觉配置：`D:\study\project\robot-competition\01-交付包\vision\config.json`
- 比赛屏：`D:\study\project\robot-competition\01-交付包\orangepi\pi\pi_display.py`
- 派端部署：`D:\study\project\robot-competition\01-交付包\deploy_pi_display.bat`
- 固件 hex：`D:\study\project\robot-competition\01-交付包\stm32\hex\STM32F429.hex`
