2186279865/robot-10.15/codex/YOLO_REVIEW.md

# 现成 YOLO 模型评估

2026-10-27。读取 `yolo/` 的 README、训练/预测/评测脚本、类别表、数据生成代码、训练配置、指标和现成 best.pt，未重训或修改该目录。

结论：对于已覆盖的颜色和形状，该模型更适合实时主识别；不能满足任意新形状免训练识别，现场效果和镂空支持仍不足。建议组合 YOLO 快速检测、独立主体颜色统计、孔洞几何验证，以及视觉大模型对困难目标的异步复核。

## 模型实际覆盖

- YOLO11n-seg，最佳权重约 6MB，来自第 50 轮；训练在第 80 轮提前停止。
- 245 张图片、698 个实例、23 个联合“颜色+形状”类别。
- 形状只有正方体、长方体、三棱柱、六棱柱、菱面体。不是开放词汇识别模型。
- 三棱柱、六棱柱、菱面体只有 Blender 合成数据；实拍只覆盖正方体/长方体。
- 无镂空、圆柱、球、圆锥、五棱柱等类别；橙色、黑白灰等也不在类别表。原有颜色和形状的新组合也未必支持，例如绿色长方体不在现有类别表。
- 官方 `models/yolo11n-seg.pt` 是通用预训练权重；应使用定制训练后的 `runs/blocks_v2/weights/best.pt`。

## 本次直接实测

GPU：RTX 5060 Laptop。仅图像推理，不连接机器人、不访问云端。

原图去掉底部英文标签，保留其余像素和绿色描边，输入模型完整画面，未给模型提供分组标签。初次加载/第一次推理明显慢于预热，速度不含相机采集、GUI 绘制或机械控制。

| 输入方式 | 结果 | 预热后单次中位用时 |
|---|---|---:|
| 全图，imgsz=640 | 9 个框但只覆盖 8 个不同物块，有漏检、误分类和重复框 | 10.6 ms，10 次 |
| 全图，imgsz=960 | 9 个物块颜色/形状均有正确标签，但红六棱柱有重复框，总共 10 框 | 9.4 ms，5 次 |
| 全图，imgsz=1280 | 正好 9 框，颜色/形状均与示意图一致 | 20.9 ms，5 次 |
| 三个子图分别输入 640 | 每组 3 个均正确；共 9 个 | 各约 11.5~15.8 ms，10 次/组 |
| 使用之前大模型评测用的小尺寸紧裁剪逐块输入 640 | 大量漏检和误判 | 不推荐这种输入方式 |

独立重复的短耗时测量会受到 GPU 状态和输入长宽比影响，960 比640略快不构成普遍规律。YOLO适合保留场景及目标尺度的整图/托盘 ROI，不应直接沿用大模型的紧裁剪调用方式。

`agnostic_nms=true` 没有清掉960输入的红色重复框；不能只靠启用此开关解决重复目标。1280是本图测试选择，不能据一张图当作最优通用参数。

之前 Qwen3-VL 4B Instruct 使用修复绿色描边后的固定物块裁剪，形状 7/9，预热后单块1.2~1.6秒，另有 SAM 全图分割约11~30秒。两条流程输入预处理不同，不能当作严格模型排名；本次 YOLO 在这张示意图上的速度和最终输出确实更好。数据文件未发现与用户原始JPEG完全相同的 SHA256，但这不证明与所有训练样本外观独立。

## 现场照片结果

用 `04-队友视觉调试包/samples/` 中4张图，imgsz=960、conf=0.25：

- real_cam0：0个检测。
- real_cam1：仅报一个托盘外 purple_cube，置信度0.56。
- real_new0：可见蓝色棱柱未检出，仅报一个托盘外 purple_cuboid，置信度0.26。
- real_new1：仅报一个 purple_cube，置信度0.60。

这些照片没有完整人工逐实例真值，不能计算现场准确率，但足以说明合成棱柱的高分尚未解决该相机画面的漏检。托盘 ROI 可以过滤盘外干扰，不能自行补回漏检物块。

## 原有报告怎么理解

独立实拍测试仅17图54实例，分割mAP50–95=0.708；合成测试14图42实例，为0.975。mAP不是“70.8%/97.5%分类正确率”。原报告实拍红色正方体5个测试实例的AP=0，训练仅3个该类实例，类别失衡明显。

合成生成代码中每图固定三块，类别按15类的固定循环规则选择，实际只有5种三类组合，混放组合有限；物体基本只绕竖直轴旋转，缺少侧躺翻转、孔洞及真实字样/反光。三种形状的图像来源都是合成，其他两种都是实拍，来源与类别也存在关联。这些因素使合成测试较乐观，需要现场数据验证。

## 推荐接入方式

1. 用现成 YOLO 做整图或托盘 ROI 实时实例分割、已知形状初判，减少逐帧使用 SAM 和逐块调用大模型。
2. 将形状和颜色分开：模型主判形状，前景 HSV/Lab/白平衡处理判断主体颜色。后续训练将23个联合类别合并为形状类别，降低缺失颜色组合和颜色错误的影响。现有权重不能通过简单改名就完成这种解耦，但可先从预测标签中解析形状。
3. 孔洞从原始图像和内轮廓单独验证，结合副视图；现有YOLO标签使用单个多边形，不能据此保证内孔被保留。不可把掩膜填实后当作实心证据。
4. 漏检候选用背景差分补充，未知/歧义目标交给本地或云端视觉模型复核，允许“不确定”。低置信度也不能可靠代表未知类别，未知物体仍可能被高置信度误分。
5. 固定相机曝光、白平衡和托盘 ROI 后，补现场的棱柱、菱面体、镂空及侧躺遮挡照片作独立测试。若允许补训练，再根据失败样本微调；若坚持完全不针对物块训练，保留通用视觉模型作为新类别识别途径。

## 输出文件

本次完整检测框、置信度、耗时、权重哈希在 `runtime/yolo-review/report.json`，配图在同目录；没有修改现有上位机后端和机器人逻辑。

复现示意图基本检测，在 yolo 目录运行：

```powershell
.\.venv\Scripts\python.exe -c "from ultralytics import YOLO; YOLO('runs/blocks_v2/weights/best.pt').predict(source='../datasets/user_geometry_reference/without_captions.png',imgsz=1280,device=0,conf=0.25,save=True,retina_masks=True)"
```

`predict.py` 当前把 imgsz 写死为640，调整输入尺寸需要新增参数或使用上述直接推理命令。
