2186279865/robot-10.15/02-资料库/数据-2026-10-26-标定九点.md

# 2026-10-26 · X/Y 标定九点数据与失败诊断

> 现场在「X/Y 标定」页记了 9 个标注点（P1–P9），点「求解并保存」时报：
> **标定点不合格：X 与 Y 在画面里几乎同方向（夹角 0.9°）**
> 这份文档原样记下数据、算出的东西、以及两条结论（一条是软件误报，一条是数据本身的问题）。

## 1. 原始数据（照抄界面）

| 点 | u | v | X 脉冲 | Y 脉冲 |
|---|---|---|---|---|
| P1 | 0.0768 | 0.1495 | +0 | -34645 |
| P2 | 0.5161 | 0.1387 | +0 | -70645 |
| P3 | 0.8907 | 0.1422 | +0 | -102645 |
| P4 | 0.8935 | 0.5421 | +5000 | -102645 |
| P5 | 0.9088 | 0.9344 | +9300 | -102645 |
| P6 | 0.5231 | 0.9517 | +9300 | -72645 |
| P7 | 0.0728 | 0.9514 | +9300 | -36645 |
| P8 | 0.0793 | 0.5651 | +5300 | -36645 |
| P9 | 0.4955 | 0.5594 | +5300 | -72645 |

同目录 `01-交付包/vision/runtime/calib_marks.json` 里有同样的 `px/py`。

## 2. 用这 9 个点算出来的东西（最小二乘）

```
u = -1.168e-06*X + -1.230e-05*Y + -0.3629
v =  8.597e-05*X +  1.146e-07*Y +  0.1408
残差 max|du|=0.0292 max|dv|=0.0287 rms=0.0224
X 每脉冲: (du,dv)=(-1.17e-06, 8.60e-05)  长度 8.60e-05
Y 每脉冲: (du,dv)=(-1.23e-05, 1.15e-07)  长度 1.23e-05
两方向夹角 88.7°   |det|=1.058e-09
```

→ **两个方向其实是接近正交的（88.7°）**，矩阵不病态，能解。报"0.9°"是检查逻辑的问题，见下。

## 3. 结论 A：软件误报（已修）

`host/calib_wizard.py` 的 `check_points()` 原来**假设点表的前三个是「基准 / 只动X / 只动Y」**
（那是自动标定向导的三点法）。这次手动记了 9 个点，前三个恰好 **X 都是 +0、只有 Y 在变**
→ 它把「第 2 点」当 X 方向、「第 3 点」当 Y 方向，两个都指向 Y 的运动方向 → 夹角 0.9°。

修法（已提交代码）：
- 点数 ≥ 4 时不再用前三个点，改为**对全部点做最小二乘拟合**，从拟合出的雅可比里取
  X/Y 两个方向向量再判夹角与病态；
- 三点法（自动向导）保持原样；
- 新增 `travel=` 护栏：记录跨度超过实测行程 1.5 倍就报"像是把 counts 当脉冲记了"。

## 4. 结论 B：数据本身有硬伤（Y 的跨度不对）

已知实测行程（脉冲）：

| 轴 | 行程（脉冲） | 行程（counts） |
|---|---|---|
| X(4) | 9,650 | 197,630 |
| Y(5) | 9,766 | 200,000 |

而这 9 个点里：**X 跨度 9,300（≈行程 96%，合理）**，**Y 跨度 68,000（是行程的 7 倍，物理上不可能）**。
1 脉冲 = 20.48 counts，所以 68,000 这个量级更像 **counts**（68,000 counts = 3,320 脉冲 = 1.04 圈 ≈ 33 mm）。

也就是说：**当时记点过程中，Y 那一路记录到的不是脉冲**（或中途位置记账跑飞）。X 的数据（0/5000/5300/9300，
不是 4000 的整数倍）也不整齐，同样可疑。

## 5. 解决办法（按顺序做）

1. **先确认位置记账干净**：四轴页点「位置清零」把 X/Y 软位置清 0；之后只用**「相对走」**（或勾「闭环」的相对走），
   **不要用「绝对走到此」「常用走」**，也不要中途断线/点「停止全部」。
2. **重新记 4–6 个点**，规则：
   - 先记 P1（基准，别动）；
   - 走 X（例如 +1500 脉冲）→ 记 P2；再走 X（+1500）→ 记 P3（同一行、只 X 变）；
   - 回退 Y（例如 +1500）→ 记 P4；再走 Y（+1500）→ 记 P5（不同行）；
   - 每次记完看日志：`记录爪位 X=… Y=… 脉冲（… 来源 软位置/回读）`，数字应该和你走的步子对得上
     （走 1500 就是 ±1500 的整数倍）。
3. **先「读回读脉冲」确认**：X/Y 的回读 counts 换成脉冲（÷20.48）应当和界面软位置接近（差几个脉冲正常）。
4. 点「求解并保存」→ 看对话框里的 **max|dx| / max|dy| 残差**，合格线 **< 100 脉冲**；然后实抓一件验证。

> 本次的 9 点数据先保留（`vision/runtime/calib_marks.json`），不要写进 `tray_calib.json`。

## 6. 顺带：Z 速度问题（同一天查明的）

- 实测 `rpm` 参数对实际速度**没有影响**（200/600/1500/3000 都是 ~32 圈/分）；
- 真正卡速度的是 **`acc`（加速度档）参数**：`acc=1`（默认）→ ~32 圈/分；**`acc=0` → ~320 圈/分**；
  `acc=255` → ~192 圈/分。Z 满行程 47.5 圈：`acc=1` 要 ~90 s，**`acc=0` 只要 ~9 s**。
- 用法：参数页 `acc` 写 0（或 255，起转略缓），不需要重烧固件。注意 `acc=0` 起转最猛，先用小步试。
