2186279865/robot-10.15/02-资料库/方案-自动抓放流程与状态机-v2.md

# 方案 · 自动抓放流程与状态机 v2（修正通道定义 + X 参与 + 转盘角度模式）

> 取代 v1。依据用户 2026-10-25 23:4x 的纠正：
> **①"固定通道"只是"从初始位出去的那一段"，抓取时 X 轴要参与；②转盘用张大头步进 + 角度模式（单圈归零点 + 角度控制）；③到目标位后不再做落点偏移；④同类连续概率未知 → 设计成幂等；⑤必须自动决策（不许停下问人）；⑥屏显后面再说。**
> 状态：**计划稿，等指令再动代码。**

---

## 1. 正确的流程（按你原话画）

```
P0（初始位，转盘正上方，Z 最低）
 │
 ├─ ① 转盘按"绝对角度"转到该类盒（角度模式，幂等）
 ├─ ② 拍照 → ③ 识别定类 → ④ 算目标 X/Y 脉冲
 │
 ├─ ⑤ 通道出门（固定，只有这 3 段）：
 │      Y 动一点（离开盒子区） → Z 从最低抬到最高 → （此后在最高处自由移动）
 │
 ├─ ⑥ X、Y 走到物块正上方
 ├─ ⑦ Z 下探 → 夹紧 → Z 上抬（抬回到最高）
 ├─ ⑧ 拍照复核（物块是否已离开原位）
 │
 ├─ ⑨ 走回通道末端的 X、Y 坐标（就是"Z 抬到最高那个位置"）
 ├─ ⑩ 倒序回程：Z 降到最低 → Y 回退一点点 → 回到 P0
 │
 ├─ ⑪ 松爪 → 物块落进当前盒子
 └─ ⑫ 屏显 → 拍下一件
```

**关键点（与 v1 的差别）**

| 项 | v1（错） | v2（对） |
|---|---|---|
| 通道内容 | 只用 Y+Z，全程不碰 X | **只包含"Y 小位移 + Z 抬到最高"这一段**；X/Y 在"最高处"自由移动 |
| X 轴 | 不参与 | **抓取对准必须参与**（⑥⑨ 都要动 X） |
| 转盘 | 相对增量记账 | **绝对角度模式 + 单圈归零点**（幂等，重复下发无害） |
| 落点 | 允许再加偏移 | **到指定位置就是最终位置，不再偏移** |
| 分类不确定 | 停下问人 | **自动决策**（取最高分，记录置信度） |

---

## 2. 坐标系与固定点（示教一次）

| 名称 | 含义 | 说明 |
|---|---|---|
| `P0` | 初始位 = 转盘正上方 | X0, Y0, Z 最低；松爪落货就在这里 |
| `P1` | 通道末端 = "Z 抬到最高那个位置" | X1, Y1, Z=Z_HIGH；出门最后一步到这儿，回程第一步从这儿起 |
| `Δy_corr` | P0→P1 的 Y 小位移 | 示教得到（"Y 动一点"） |
| `Z_LOW` | 最低（P0 处、回程末端） | 松爪高度 |
| `Z_HIGH` | 最高（通道里、搬运高度） | 所有横向移动都在这个高度 |
| `Z_PICK` | 抓取下探高度 | 爪子抱住物块 |
| `X_OBJ, Y_OBJ` | 物块上方坐标 | 由视觉 → 标定换算得到（每件不同） |

> 通道段 = `[(Y, +Δy_corr), (Z, Z_LOW→Z_HIGH)]`，回程 = 严格反序取反 `[(Z, Z_HIGH→Z_LOW), (Y, -Δy_corr)]`。
> 通道里**不出现 X**；X 只出现在"最高处的自由移动"和"抓取对准"里。

---

## 3. 转盘：角度模式 + 单圈归零（你指定的做法）

### 3.1 目标

- 上电时人工把 **1 号盒** 对准 P0；
- 发一次"设单圈零点"（`0x93 88` 设零点，或 `0x0A 6D` 清计数）；
- 之后每次只需要说"转到多少度"，驱动器自己记账，**重复下发同一角度不会越转越偏**。

### 3.2 角度表（3200 脉冲/圈，配合 0xFD 绝对位置 `raF=1`）

| 类 | 1 | 2 | 3 | 4 | 5 | 6 |
|---|---|---|---|---|---|---|
| 角度 | 0° | 60° | 120° | 180° | 240° | 300° |
| 脉冲 | 0 | 533 | 1067 | 1600 | 2133 | 2667 |

### 3.3 要固件加的东西（这是本方案唯一的固件新增）

1. **修"绝对当相对"的老 bug**：现在 `control_apply_position()` 调 `Stepper_MoveRelativeAt2(..., 0UL)`，`absolute` 参数没生效 → 需要真走 `Stepper_MoveAbsoluteAt()`（`0xFD raF=1`）。
2. **新命令 `motor_angle,<addr>,<deg_x100>[,<rpm>]`**：
   - `deg_x100` 范围 0..36000（0.00°–360.00°）；
   - 固件换算 `pulses = round(deg_x100 * pulses_per_rev / 36000)`，`pulses_per_rev` 走参数（默认 3200）；
   - 下发**绝对位置**帧（`addr,FD,dir,rpmH,rpmL,acc,pulses,raF=1,snF=0,6B`）；
   - 应答 `#id,ok,addr,deg,pulses`。
3. **新命令 `motor_angle_zero,<addr>`**：发 `93 88`（设当前为零点）→ 单圈归零，回 `ok`。
4. **到位判定**：用 `0x36` 单圈角度回读（遥测里已有 counts）——目标角与实测角差 ≤ 0.5° 即到位；超时/超差 → `E14`（复用现有错误码语义）。
5. 其它轴（X/Y/Z）继续用现有 `motor_goto`（相对闭环），**只有转盘用绝对角度**。

> 这样上位机侧只要说"转到 120°"，不用管当前在哪、上次转到哪——比 v1 的"相对索引记账"稳得多，也正好是你要的"角度控制"。

---

## 4. 状态机 v2

| # | 状态 | 动作 | 通过条件 | 超时 | 失败处理 |
|---|---|---|---|---|---|
| 1 | `IDLE` | — | 一键启动 | — | — |
| 2 | `TRAY_SET` | `motor_angle 3 <class_deg>`（幂等；已是该角度则秒回） | 回读角差 ≤0.5° | 6 s | 重试 2 次 → FAULT |
| 3 | `CAPTURE` | 取顶视一帧 | 图完整 | 2 s | 重试 2 次 → FAULT |
| 4 | `RECOGNIZE` | SAM+分类；**自动取最高分** | 有目标、类 1..6、连续 2 帧坐标偏差 <8 px | 6 s | 无目标 → `DONE_EMPTY`；坐标抖动 → 重拍 2 次 → FAULT |
| 5 | `PLAN` | (u,v)→(X_obj,Y_obj) 脉冲；类→角度 | 队列非空 | 1 s | FAULT |
| 6 | `CORRIDOR_OUT` | 通道两段：`Y +Δy_corr` → `Z→Z_HIGH` | 每段 err ≤ tol | 每段 6 s | FAULT |
| 7 | `MOVE_XY` | `X→X_obj`、`Y→Y_obj`（在 Z_HIGH 高度） | 每段 err ≤ tol | 每段 8 s | 重试 1 次 → FAULT |
| 8 | `DESCEND` | `Z→Z_PICK` | 到位 | 4 s | FAULT |
| 9 | `GRASP` | `gripper grab`（角度可调） | ok + Z 稳定 | 1.5 s | 重夹 2 次（回 8）→ FAULT |
| 10 | `LIFT` | `Z→Z_HIGH` | 到位 | 4 s | FAULT |
| 11 | `VERIFY_PICK` | 拍照复核：目标区域应消失 | 像素差 > 阈值 / 目标不在 | 3 s | 回 `MOVE_XY` 重抓，最多 2 次 → FAULT |
| 12 | `RETURN_XY` | `X→X1`、`Y→Y1`（回 P1） | 到位 | 8 s | FAULT |
| 13 | `CORRIDOR_BACK` | 反序：`Z→Z_LOW` → `Y -Δy_corr` | 到位 | 6 s | FAULT |
| 14 | `RELEASE` | `gripper open`(180°) → 等 300 ms | ok | 1.5 s | 记 warning |
| 15 | `LIFT_BACK` | `Z→Z_HIGH` → `gripper ready`(150°) | ok | 3 s | 记 warning |
| 16 | `DISPLAY` | （后面做）推 JSON 到 5059 | 忽略失败 | 0.5 s | 忽略 |
| 17 | `NEXT` | 件数 +1，还有目标 → 回 2 | — | — | — |
| 18 | `FAULT` | `stop_all` + 锁存 + 日志 | 人工复位 | — | — |
| 19 | `DONE` | 停车 + 汇总 | — | — | — |

**没有 `PAUSE_ASK`**：分类不确定也按最高分走（记录 `confidence`，便于事后看日志复盘）。

---

## 5. 精度与"必须精准"的工程化

1. **每一段都闭环**：X/Y/Z 全部 `motor_goto`，每段 `|err| ≤ tol`（X/Y 建议 tol=100 counts≈0.55°，Z 用 100）；不达标重试 1–2 次，再不行 FAULT。
2. **抓取前视觉复核**：`RECOGNIZE` 要求连续两帧目标坐标差 <8 px 才开抓；抓完 `VERIFY_PICK` 再拍一张确认目标消失。
3. **落点不偏移**：物块在 P0 正上方松爪，靠盒子开口容差吸收（你已确认"到达指定位置就不偏移"）。
4. **转盘绝对角**：重复下发同角度幂等，不会累积误差；每次到位置后回读角差 ≤0.5°。
5. **累计漂移监控**：每 10 件打印一次"P0 处 counts 与上电基准差"，超阈值提示重新对零（不自动清零，避免越描越黑）。

---

## 6. 节拍（保守）

| 段 | 估计 |
|---|---|
| 转盘角度（平均 3 步） | 0.6–1.2 s |
| 拍照 + 识别（SAM/GPU） | 2.0–2.5 s |
| 通道出门 + X/Y 对准 | 2.0–3.0 s |
| 下探+夹+抬+视觉复核 | 2.5–3.5 s |
| 回 P1 + 通道回程 + 松爪 + 抬 | 2.5–3.5 s |
| 显示/收尾 | 0.3 s |
| **合计** | **约 10–14 s/件** |

---

## 7. 实施顺序（改完固件才有意义）

| 步骤 | 内容 | 依赖 | 耗时 |
|---|---|---|---|
| 0 | 修 goto 方向 bug（明天第 1 件） | — | 40 min |
| 1 | 固件：绝对位置 raF=1 + `motor_angle` + `motor_angle_zero` + 角度到位判定 | 步骤 0 | 半天 |
| 2 | 示教 P0/P1/Z_LOW/Z_HIGH/Z_PICK + 通道段（`approach_route` 只用于通道两段） | 步骤 1 | 1 h |
| 3 | 标定：顶视 u,v → X/Y 脉冲（要求残差 <100 脉冲） | — | 半天 |
| 4 | `auto_runner.py` 骨架（19 状态 + 超时 + 日志），假后端跑通 | — | 半天 |
| 5 | 真机单件手动触发 | 1–4 | 半天 |
| 6 | 自动循环 + 6 类归盒 | 5 | 1 天 |
| 7 | 连续 20 件稳定性 + 异常注入 | 6 | 1–2 天 |

---

## 8. 仍需你确认的（只剩 3 个）

1. **障碍有多高、通道多长**：`Z_HIGH` 要抬到多少（决定节拍与撞不撞）；`Δy_corr` 大概多少脉冲。
2. **盒子内尺寸**：落料容差多少（决定要不要给 P0 再对一次中）。
3. **X 轴行程够不够**：抓取区物块在 X 方向的散布范围，是否都在 X 行程内。

（屏显内容、同类连续概率你已说"后面再说/不确定"，方案里已按"幂等 + 自动决策"兜住，不用等它们。）
