2186279865/robot-10.15/02-资料库/思路-2026-10-24.md

# 2026-10-24 思路汇总（明天从这里继续）

> 这份文件只记**今天提出的思路**：哪些已经落盘、哪些只是讨论、哪些还等你拍板。
> 正式方案在 `02-资料库/方案-整机作战方案-v1.md`；过程记录在 `02-资料库/00-项目日志.md`。

---

## 0. 今天一句话结论

**回读其实是通的**（遥测能拿到四轴真实编码器计数），但**上位机主动查询 `motor_query` 100% 超时**；
另外把「按固定通道出障碍区 → 抓取 → 原路返回 → 在初始位置释放 → 下一次」这个往返流程定成了主体流程，
并用它推导出：通道段要单独示教、抓取动作不能参与返回、释放点还需要你确认。

---

## 1. 回读与 motor_query（今天的第一个发现）

### 1.1 实测事实

| 测试 | 结果 |
|---|---|
| `motor_query`（主动查询四轴位置/速度） | **20 次 0 成功**：8/8 E04、6/6 E04、5/6 E04 + 1 次 E09 |
| E04 往返耗时 | 62 / 79 / 93 ms（轴 3 / 轴 1 / 轴 4）→ 比 `query_timeout_ms`=100 ms 还短 |
| `tele_on` 遥测 | 3 秒 75 帧，四轴都有真实 counts：Z=2,757,257、托盘=7、X=−31,111、Y=446,243 |
| 遥测新鲜度 | `age_ms` 能回到 1–67 ms → 后台轮询确实在成功刷新 |
| 关掉遥测后再查询 | 8/8 仍 E04，`last_counts` 空 |

**换算**：65536 counts = 1 圈，32 位多圈累计 → Z 的 2,757,257 counts ≈ 42 圈，Y 446,243 ≈ 6.8 圈。

### 1.2 结论

1. **物理回读链路没问题**——以前写在 `02-资料库/02-硬件/README.md:23` 和 `01-交付包/VERSION.md:28` 的"PA3 未接线 → E04"是**错的**，需要改；
2. 坏的是**"PC 发查询 → 固件转发 → 回包配对"这条状态机**，而且不是"等满 100 ms 才超时"，是**提前判过期**；
3. 你截图里四轴的"回读：…脉冲/…°，0.1s 前"**是真的**，数据来自遥测（`host_gui.py:326-340 update_telemetry` → `:182` 标签由 `refresh_readback()` 渲染）。

### 1.3 主假设（还没钉死）

`sent_ms` 与 `stamp_ms` 不同源：

- 查询命令在 `host_cmd_motor_query()` 里现取一次 `Stepper_Millis()` 当 `sent_ms`（`host_protocol_inline.h:1393`）；
- 而 `host_query_has_fresh_data()`（`:680-687`）要求 `stamp_ms >= sent_ms`，`stamp_ms` 来自任务循环开头那次 `now`（`:1836`）；
- 同一次主循环里 `now` 比 `sent_ms` 旧 → 条件恒假 → 回包被当旧包丢掉 → 最终 E04。

但 62–93 ms 的耗时说明**还有第二处状态机问题**，光靠读代码钉不死。

### 1.4 两条修法（明天二选一）

| 方案 | 做什么 | 代价 | 适合 |
|---|---|---|---|
| **A 先绕开** | 上位机"查位置/查速度"改用遥测缓存（`last_counts` 已有），`motor_query` 按钮标记"暂不可用" | 0 改固件、0 烧录，几分钟 | **今天就能用** |
| **B 修固件** | ①`sent_ms` 改用任务循环的 `now`（或 `host_query_service` 内重取并同源）；②`EmmQuery_Expired` 改成有符号比较；③先烧一版"诊断固件"：每次查询把 `sent_ms/stamp_ms/have/active/timeout_count` 通过事件吐出来 | 改 `*_inline.h` + 重编 + 重烧 + 实测 | 想让查询变可靠 |

**建议**：先 A（不耽误用），再做 B 的诊断版，一次钉死。

---

## 2. 用遥测闭环（能不能靠 counts 做出"到位"判断）

### 2.1 能做的 4 件事

1. **到点判定**：不等时间，等 `|counts − target| ≤ tol`；
2. **丢步/堵转检测**：发 N 脉冲，比较 counts 实际变化，偏差 >3% 就停、报警；
3. **两段式逼近**：先快走 90–95%，再按剩余 counts 慢速补最后一段；
4. **往返漂移检测与补偿**：每次回到 P0 与上电基准比对，超阈值补一小段。

### 2.2 做不到的 3 件事

| 限制 | 原因 | 对策 |
|---|---|---|
| 实时伺服 | 每轴新数据 ≈ 4×`telemetry_ms`（默认 200 → 400 ms） | 只做"到点确认"，不做连续伺服 |
| 机械背隙 | counts 是电机端编码器，看不到丝杠反向间隙 | **单向逼近**：总从同一方向趋近目标 |
| 掉电绝对位置 | 驱动器计数断电行为未实测 | 上电先全轴读一次记基准，不假设 0 |

### 2.3 闭环结构（三段式）

```
目标 3200 脉冲
 ①快走 3000 脉冲（93%）
 ②等 ≥1 个遥测周期（400 ms），读实际 counts
 ③补差：剩余 = 3200 − 实际；|剩余| < 死区(100–300 counts) 就算到
   补两次还差 → 报警（卡住/皮带松）
```

**死区取 100–300 counts（0.5–1.6°）**：机械误差远大于编码器分辨率，设太小会抖动。

### 2.4 明天要做的 4 个标定实验（需要动电机，等你点头）

| 实验 | 做法 | 产出 |
|---|---|---|
| A 比例 | X 轴走 3200 脉冲，读前后 counts 差 | `counts/脉冲` 实际系数 |
| B 重复性 | 同一动作重复 5 次 | 误差分布 → 死区取值 |
| C 反向间隙 | 正走一段再反走同样量 | 背隙大小 → 是否必须单向逼近 |
| D 遥测延迟 | 发指令后每 100 ms 读一次 | 实际刷新周期 → "等几拍" |

一次约 1 分钟动作（60 RPM、每次 1 圈）。跑完写成 `02-资料库/05-调研报告/遥测闭环标定.md`。

---

## 3. 从初始位置开始的抓取流程（今天的主线）

### 3.1 你要的流程（原话）

> "上电是初始位置，然后不动，开始抓取后走的路线自动加上一段，然后抓取后原路返回，初始位置就是释放物体的位置，然后再进行第二次抓取"

```
上电 → P0（不动）
  │ 按下「开始」
  ▼
P0 ──[通道段 C 正序]──► P1（取料区）── 拍图→对准→Z下→夹135→Z上
                          │
P0 ◄──[通道段 C 倒序取反]──┘
  │
  └─ 夹爪 180 松开（在 P0 释放）→ 第二件：P0 → C → 抓 → C⁻¹ → P0 → 松 …
```

### 3.2 关键区别（为什么不是直接用 `journey.py`）

| | `journey.py`（现有的"回上电初始位"） | 你要的往返模式 |
|---|---|---|
| 记录范围 | 上电后**所有**移动（含抓取、托盘转位） | **只记通道段 C** |
| 返回时机 | 手动点按钮，一般整轮结束回一次 | **每件抓完自动返回** |
| 触发 | 手动 | 「开始」后自动循环 |

结论：**新增独立的通道段数据 + 往返状态机**，比改 `journey` 干净得多。

### 3.3 实现清单（约半天）

1. `corridor.json`：一组相对脉冲段 `{axis, dir, rpm, acc, pulses}`，示教复用现有「开始示教」录制逻辑；
2. 往返执行器 `corridor.py`：
   - 正序 = 原序执行；倒序 = `reversed()` 且每段 `dir ^= 1`；
   - 每段：`motor_enable` → `motor_pos rel` → 按 `pulses/rpm` 等时 → 200 ms 稳定；
3. **抓取宏**：把「拍图 → 对准 → Z 下 → 夹 135 → Z 上」串成一个函数（现在都是分步按钮）；
4. **释放宏**（在 P0）：Z 下（若需要）→ 夹爪 180 → 稳定 → Z 上 → 夹爪回 150；
5. **每件 counts 校验**：回 P0 后与上电基准比对，偏差 >500 counts（≈2.7°）报警/微调。

### 3.4 状态机

```
IDLE → OUT(C正序) → PICK(拍图/对准/抓) → BACK(C⁻¹) → RELEASE(松爪) → 计数+1
     → 还有货? OUT : IDLE
任意状态超时/异常 → FAULT（停车 + 屏提示 + 可恢复点）
```

### 3.5 你还需要确认 2 件事

1. **P0 释放到哪里**？
   - (a) P0 就是六盒转盘（转回去放进对应盒）；
   - (b) P0 有固定滑槽/料框，直接丢；
   - (c) P0 是空的，先走到某处再放。
2. **P0 释放时有无干涉**（线缆/立柱/夹具）？夹爪在 P0 张开会不会碰东西。

### 3.6 风险

| 风险 | 数据/对策 |
|---|---|
| 累积误差叠加 | 12 次往返，开环可能漂几 mm；靠每件 counts 校验 + 必要时加光电 |
| 节拍变长 | 通道去 2 s + 抓 4 s + 回 2 s + 释放 1 s + 拍照对准 2 s ≈ 12 s（15 s 内但余量小） |
| 通道越长越慢 | 示教时在保证不撞的前提下尽量少段（能 3 段不要 5 段） |

---

## 4. 显示屏：改由派 HDMI 小显示器（已改方案 §5.3）

**你的原话**：显示界面在派上完成，派通过 HDMI 线连接一个小显示器，上面有一个图形化窗口显示赛题要求的内容。

- 硬件：小显示器（建议 7" 1024×600 / 1280×800，亮度 ≥500 nit，HDMI 输入，5 V/12 V 供电，电源从整机 DC-DC 出）；
- 软件：新增 `01-交付包/orangepi/pi/pi_display.py`，Tkinter 全屏、深底亮字 ≥32 px、不响应输入（合规"仅显示"）；
- 数据：笔记本上位机推 `display_state`（**新端口 5059**，JSON + 小 JPEG），派端长连接订阅、断线 3 s 重连；
- 内容：第 N 件/共 12、实拍裁剪图、名称+类别、已分拣数、当前状态；
- 自启：`systemd robotpi-display.service`；
- 兜底：STM32 直驱 ST7735S 方案**作废但保留**（`02-资料库/04-历史快照/液晶-10.19` 驱动已验证）。
- 待定：屏的尺寸/亮度/供电（等你确认型号）。

---

## 5. 整机作战方案 v1（已落盘）

`02-资料库/方案-整机作战方案-v1.md`（约 330 行）：
赛题 12 条硬指标 → 资产盘点（能用/没验证/缺口）→ 架构与五条数据链 → 已定 7 项/待定 5 项决策 →
分层设计（结构/固件/显示/上位机/视觉）→ 节拍预算 ~10 s/件 → P0–P5 阶段与验收 → 测试矩阵 →
10 条风险 → 比赛 runbook → 5 个待拍板。

---

## 6. 待你决策（明天开场先答这几条）

| # | 问题 | 选项 | 影响 |
|---|---|---|---|
| 1 | P0 释放到哪里 | (a) 六盒转盘 / (b) 滑槽料框 / (c) 别处 | 决定 RELEASE 宏怎么写 |
| 2 | P0 张开有无干涉 | 有 / 无 / 待测 | 可能要加 Z 抬升或换释放姿态 |
| 3 | 通道是否每件都走 | 每件 / 只在开始结束 | 决定节拍与状态机 |
| 4 | 六类货高度是否不同 | 是（→按类查 Z）/ 否 | 决定 Z_grab 是常数还是查表 |
| 5 | 允许"放弃某件"吗 | 允许 / 不允许 | 决定超时策略（我建议允许） |
| 6 | 小显示器规格 | 7"/10"、亮度、供电 | 决定支架与电源 |
| 7 | 4 个闭环标定实验可否现在跑 | 可以 / 等结构装好 | 拿到死区/背隙真实值 |

---

## 7. 明天第一步（可执行）

1. 先答上面 1–7（哪怕只答 1、2、5）；
2. 若同意 → 我按顺序做：
   ① 上位机查询改遥测（方案 A，立即可用）；
   ② 固件诊断版（打印 `sent_ms/stamp_ms/have/active/timeout_count`）→ 钉死 E04；
   ③ `corridor.py` + 往返状态机 + 抓取/释放宏（先模拟后端跑 12 件时序）；
   ④ 4 个闭环标定实验（真机，需你点头）；
   ⑤ `pi_display.py` + 5059 推送（等屏到位可先跑窗口截图）。

---

## 8. 今天定下来的（别再反复）

- 显示走**派 HDMI 小显示器**，STM32 直驱屏作废（留底）；
- 往返流程的返回路径**只重放通道段**，不重放抓取动作；
- 闭环**只做到"到点确认 + 丢步检测"**，不做实时伺服；
- 查询不可用**不是接线问题**，文档要改。
