2186279865/robot-10.15/02-资料库/决策记录.md

# 决策记录（只记"拍板"，一行一条）

> 规则：每条写清 **决定 / 为什么 / 什么时候 / 谁提的**。被后来推翻的决定**不删**，在末尾加 `~~废弃（YYYY-MM-DD）：原因~~`。
> 和 `00-项目日志.md` 的分工：日志写"过程与取舍细节"，这里写"结论一句话，方便快速查"。

| # | 日期 | 决定 | 理由 | 状态 |
|---|---|---|---|---|
| 1 | 2026-10-21 | 赛项按**智能分拣**做（不是搬运/救援） | 救援明文禁止抓取；搬运需要移动底盘且场地 2400×2400，本机没有 | 有效 |
| 2 | 2026-10-21 | 视觉只在笔记本跑，绝不上派 | SAM-B 实测笔记本 CPU 6.2–6.7 s/帧，推算 A733 上 20–30 s/帧 | 有效 |
| 3 | 2026-10-21 | 批处理文件一律**纯 ASCII + CRLF** | cmd.exe 按 ANSI 逐字节解析；UTF-8 中文或 LF 会把行切错（run.bat 曾因此打不开） | 有效 |
| 4 | 2026-10-22 | 架构 = 派采集 + 笔记本识别 + 串口桥透传（三通道 5056/5057/5058） | 720p 静帧上行只要 10–40 ms，不需要实时视频流；协议/固件零改动 | 有效 |
| 5 | 2026-10-22 | 图传用**拉模式**（笔记本请求，派回一帧），不用推流 | 无积压、无重传、延迟可控 | 有效 |
| 6 | 2026-10-22 | 默认分辨率 **1280×720**（不是 1920×1080） | WiFi 双路 1080p 需 4–7 MB/s，现场不稳；720p 足够识别托盘 40 mm 物件 | 有效 |
| 7 | 2026-10-22 | 三层安全网：界面急停 / 派 1.5 s 看门狗 / 固件 3 s 心跳锁存 | 任何一层都能独立停车 | 有效 |
| 8 | 2026-10-23 | 夹爪三档：180 全开 / **150 预备** / 135 夹紧 | 用户指定；150 由上位机连上后下发，不由固件定时 | 有效 |
| 9 | 2026-10-23 | 夹紧角度用 **135°**（不是 137°） | 用户最终确认 | 有效 |
| 10 | 2026-10-23 | 舵机**保持通电不卸力**，只留 `gripper_hold_max_ms`（默认 0） | 卸力会失去夹持；堵转只在搬运 2–5 s 内可接受 | 有效 |
| 11 | 2026-10-23 | 抓取序列：先抬 Z 再收 150° | 在盒子里从 180 收到 150 会蹭物块/盒壁 | 有效 |
| 12 | 2026-10-23 | 删掉「一键回0 / 开机回基准」，新增「回上电初始位（记录+倒放）」 | 固件无机械原点，"回0"只是软位置归零，容易误判；记录倒放才真能回原位 | 有效 |
| 13 | 2026-10-23 | 接近段示教记录 **X/Y/Z**；回初始位记录 **含托盘的四个轴** | 抓取路径不该动托盘；回原点必须连托盘一起回 | 有效 |
| 14 | 2026-10-23 | 绝对走到此也按"相对脉冲"记账 | 固件 `control_apply_position(..., absolute=0)` 实际就是相对执行 | 有效 |
| 15 | 2026-10-23 | 仓库拆成 `01-交付包 / 02-资料库 / 03-实验台` | 34.5 GB、3 万文件、模型 3 份重复，新队友分不清哪个能用 | 有效 |
| 16 | 2026-10-23 | 模型（.pt）**不进 git**，靠包内单份 + 物理备份 | 357.7 MB × 版本数会让 clone 失控 | 有效 |
| 17 | 2026-10-23 | `Qwen/`（33.7 GB）放 `03-实验台/`，不进交付包 | 它是"试过但没进主线"的实验：输出格式与上位机不兼容、服务常年不运行 | 有效 |

## 被推翻/废弃的

| # | 日期 | 决定 | 废弃原因 |
|---|---|---|---|
| A1 | 2026-10-21 | `final/` 作为交付主线 | 冻结后又开发了 19 小时，主线迁到 `10.21/`（现 `01-交付包/`）；final 只当历史快照 |
| A2 | 2026-10-23 | 接近段示教只记「相对走」 | 用户反馈"记录不住"：绝对走到此/常用走都记不到 → 改成三种都记 |
| A3 | 2026-10-23 | 示教"绝对走到此"按目标位置差换算 | 固件其实是相对执行，按位置差算会记错 → 改成按脉冲直记 |
| A4 | 2026-10-23 | `gripper_hold_max_ms` 范围 0–600000 | HostParam 是 uint16_t，最大 60000 |
| A5 | 2026-10-22 | 香橙派上跑完整视觉（SAM） | 实测不可行（20–30 s/帧） |
