2186279865/robot-10.15/.survey/重构计划-交付包与资料库.md

# 仓库重构计划 v2：01 交付包 + 02 资料库 + 03 实验台

> 版本：v2 草案（2026-10-23）｜上一版 v1 只有两个文件夹，本版按你的要求加入**第三个"实验台"文件夹**，Qwen 搬进去。
> 现状：整仓约 **34.5 GB / 32,000+ 文件**，真正在用的代码约 18 MB。

---

## 0. 三个文件夹的定位（这是整个计划的骨架）

| 文件夹 | 一句话定位 | 生命周期 | 能不能删 | 是否进 git |
|---|---|---|---|---|
| **`01-交付包/`** | 拿到就能用、不依赖任何外部文件 | 稳定、少变、有版本号 | **不能**，这是命根子 | 进（代码+文档） |
| **`02-资料库/`** | 全部资料、参考、历史，以及**唯一的那本项目日志** | 持续增长、只追加 | 不能（删了就没记忆） | 进（md 为主） |
| **`03-实验台/`** | 各种尝试与实验（Qwen、SAM-上派、网络化原型、临时脚本） | 快速生灭、允许失败 | **可以整目录清** | **不进**（只跟踪 README） |

判断标准一句话：
- 比赛/现场要用的 → **01**
- 要回看的（规则、手册、旧版本、为什么这么决定） → **02**
- "试试看行不行"的 → **03**

---

## 1. 目标结构

```
robot-competition/
├─ 01-交付包/                       ← 最终可用，自包含，约 372 MB
│  ├─ README.md                     ← 唯一入口（安装/启动/故障，≤2 页）
│  ├─ setup.bat  run.bat  selftest.bat  CHECK.py  VERSION.md
│  ├─ stm32/                        ← ① STM32 部分（约 12 MB）
│  │  ├─ firmware/  project/  hex/STM32F429.hex
│  │  ├─ host/                      ← 上位机源码（协议 + 六页 + 新功能）
│  │  ├─ tools/                     ← 烧录说明、fromelf 核对
│  │  └─ docs/                      ← 固件协议（19 命令/13 参数/E01–E13）、引脚表
│  ├─ orangepi/                     ← ② 香橙派部分（约 0.3 MB）
│  │  ├─ pi/  common/wire.py  install.sh  start.sh
│  │  ├─ requirements-pi.txt        ← apt 包清单（python3-opencv / python3-serial）
│  │  └─ offline-debs/              ← 【可选】无网赛场用的 arm64 deb（约 50 MB）
│  ├─ vision/                       ← ③ 视觉部分（约 358 MB）
│  │  ├─ *.py  models/sam_b.pt  config.json  samples/
│  │  └─ docs/                      ← 标定手册、四点顺序、换分辨率清单
│  ├─ host/                         ← ④ 笔记本上位机（8 页 / 164 用例 / main.py）
│  ├─ docs/                         ← 使用说明、现场操作卡、组网指南、网络协议
│  ├─ state/                        ← 机器相关状态（标定/示教/移动记录），可备份可清空
│  └─ runtime/                      ← 临时产物（截图/日志/pid），全忽略
│
├─ 02-资料库/                       ← 全部资料与记录，约 105 MB
│  ├─ 00-项目日志.md                ← ★ 唯一追加式日志（想法/为什么/今天干了什么）
│  ├─ 00-项目日志模板.md
│  ├─ 决策记录.md                   ← 每周从日志抽 3–5 条 ADR
│  ├─ 01-赛题/                      ← newpdftext.txt（官方 556 行）、pdftext.txt、规则解读
│  ├─ 02-硬件/                      ← EMM_V5 协议、引脚表、接线照片、驱动器/舵机手册
│  ├─ 03-往届参考/xrw/              ← 例35/例36（去掉 75 个 backup_before_*）
│  ├─ 04-历史快照/                  ← final/（去模型）、new_eye/（去模型）、10.17、10.19
│  ├─ 05-调研报告/                  ← .survey 的 7 份 md（含《全项目导读》）
│  ├─ 06-交接与教程/                ← 交接文档各版本、上位机方案、新手教程、CONTRIBUTING
│  └─ 07-图片与录屏/                ← 现场照片、真机截图、验收录屏
│
└─ 03-实验台/                       ← ★新增：各种实验，约 33.7 GB
   ├─ README.md                     ← 实验索引 + 清理规则（见 §5）
   ├─ _模板/README.md               ← 每个实验从第一天就用这个模板
   ├─ Qwen-VLM/                     ← 原 Qwen/：Ollama + qwen2.5vl:3b/7b（33.7 GB）
   │  ├─ README.md                  ← 目的/结论（不用于主流程）/如何恢复
   │  ├─ models/  downloads/  .venv/  ← 大件（不进 git）
   │  └─ *.py                        ← 实验脚本（保留）
   ├─ SAM-上派实测/                 ← bench_sam_cpu.py + 结论（A733 20–30 s/帧，不可用）
   ├─ 网络化原型/                   ← 早期 link.py / TCP 5055 / UDP 发现试验
   └─ _scratch/                     ← 临时脚本与一次性数据，**可随时整个清空**
```

> **体积**：01 372 MB + 02 105 MB + 03 33.7 GB ≈ **34.2 GB**。
> 若把 03 物理放到外部盘（推荐，见 §9 决策 3），仓库本体只有 **约 480 MB**。

---

## 2. 现状 → 去向 映射表

| 现在的目录 | 体积 | 去向 |
|---|---:|---|
| `10.21/{host,pi,vision,net,docs}` | 6.3 MB | → `01-交付包/{host,orangepi,vision,docs}` |
| `10.21/vision/models/sam_b.pt` | 357.7 MB | → `01-交付包/vision/models/`（**唯一保留的一份**） |
| `ghr/10.15`（源码/工程/hex/上位机/Test） | 12 MB | → `01-交付包/stm32/` |
| `ghr/10.15/Project/{Objects,Listings}` | 23 MB | **删除**（可重编） |
| `ghr/10.17`、`ghr/10.19` | 31.6 MB | → `02-资料库/04-历史快照/`（显示屏驱动参考） |
| `new_eye/`（去模型） | 1 MB | → `02-资料库/04-历史快照/new_eye-旧视觉主线/` |
| `new_eye/models/sam_b.pt` | 357.7 MB | **删除**（与交付包重复） |
| `final/`（去模型） | 36 MB | → `02-资料库/04-历史快照/final-10月21日冻结版/` |
| `final/new_eye/models/sam_b.pt` | 357.7 MB | **删除**（先 `git rm --cached`） |
| `xrw/`（去 backup） | 36.3 MB | → `02-资料库/03-往届参考/xrw/` |
| `xrw/**/backup_before_*` | 3.6 MB | **删除** |
| **`Qwen/`** | **33.7 GB** | → **`03-实验台/Qwen-VLM/`（本次新增去向）** |
| `build/` | 17.1 MB | **删除**（10.19 编译日志，无信息价值） |
| `.survey/*.md`（7 份） | 0.2 MB | → `02-资料库/05-调研报告/` |
| `.survey/*.py` | — | 6 个有复用价值的 → `02-资料库/05-调研报告/scripts/`；探针/一次性 → `03-实验台/_scratch/` 或删 |
| 根 README/交接文档/环境复刻流程/EMM md/pdftext | 0.2 MB | 交付包入口重写；原件 → `02-资料库/06-交接与教程/` |
| `.acl-recovery/` | 0.1 MB | **删除** |

---

## 3. `03-实验台` 的规矩（防止它变成第二个垃圾场）

### 3.1 每个实验必须有 README（从第一天起）

```markdown
# 实验名：SAM-B 能不能跑在香橙派 4 Pro 上
- 起止日期：2026-10-20 ～ 2026-10-21
- 想验证什么：A733（2×A76+6×A55）跑 SAM-B 单点 prompt 能否 <1 s/帧
- 怎么试的：torch 2.7.1+cpu，8 线程，crop_test.jpg 700×700，1/5 点 prompt
- 结论：笔记本 6.2–6.7 s/帧；推算派上 20–30 s/帧 → **不可用**，识别留笔记本
- 状态：【有结论】数据留 1 个月后可删
- 毕业后去哪：结论已写入 02-资料库/00-项目日志.md（2026-10-21 条）
```

### 3.2 四种状态，README 顶部必须标

| 状态 | 含义 | 处理 |
|---|---|---|
| 【进行中】 | 还在试 | 保留 |
| 【有结论】 | 已验证，结论进日志 | 数据保留 30 天 → 删数据留 README |
| 【已毕业】 | 代码被正式采用 | 代码并入 `01-交付包`，实验目录可删 |
| 【已放弃】 | 走了弯路 | 只留 README（含"为什么不行"），数据删 |

### 3.3 三条硬规矩

1. **`03` 不进 git 的大件**：`03-实验台/**/{models,downloads,.venv,*.pt,*.zip}` 一律 `.gitignore`；只跟踪 README 与脚本。
2. **`01` 严禁依赖 `03`**：交付包不许 `import` 实验台代码、不许引用其路径；验收时会**把 03 整个移走再跑一遍**。
3. **每月一次复盘**（5 分钟）：`(Get-ChildItem 03-实验台 -Recurse -File | Measure-Object Length -Sum).Sum` 看体积；把有结论的条目抽到 `02-资料库/决策记录.md`；删掉【有结论】超 30 天的数据。

---

## 4. 交付包的"自包含"清单（验收逐项打勾）

| # | 项 | 要求 | 怎么验 |
|---|---|---|---|
| 1 | Python 依赖 | 不依赖 Qwen 的 venv；`setup.bat` 自建 `.venv` | 删/移走 `03-实验台` 与 `..\Qwen` 后仍能跑 |
| 2 | 模型权重 | 包内唯一一份 + sha256 | `CHECK.py` 校验大小与哈希 |
| 3 | 相机 | 本地 DirectShow / 派端 V4L2+MJPG | 各出图一次 |
| 4 | 网络 | 不依赖外部 exe；自动发现派 | 双击 → 下拉框出现「派 robot-pi <IP>」 |
| 5 | 固件 | 包内 hex 与源码同源 | 烧 hex → 「预备(150)」回 `angle=150` |
| 6 | 文档 | 使用/标定/组网/操作卡都在包内 | 断网可查 |
| 7 | 自测 | `selftest.bat` 7 步全绿 | 7/7 ALL CHECKS PASSED |
| 8 | 状态隔离 | 标定/示教/移动记录在 `state/` | 删 `state/*` 后仍能启动（只需重标定） |

---

## 5. 项目日志（02 的核心）

`02-资料库/00-项目日志.md`：**只追加、不改旧条目**，顶部维护日期目录，每条固定 6 段：

> **背景（我为什么想要）** → **方案取舍（放弃了哪几条 + 理由）** → **做了什么（功能级，不写 diff）** → **验证（数字）** → **遗留/风险** → **放弃的念头**

每次任务完成的固定动作：`selftest.bat` 全绿 → 追加日志 → 更新 `VERSION.md`（若交付包变了）→ commit。

日志种子：把 2026-10-15 ～ 10-23 的 12–18 个关键决策回溯补录（夹爪三档、删「一键回0/开机回基准」、接近段示教、原路返回、一键连派、MJPG 带宽坑、相机槽位互换、派开机自启、连接失败可见、Qwen 弃用原因……）。

---

## 6. 执行步骤（全程"复制 → 验收 → 才删"）

### 阶段 0｜冻结与备份（15 min）
- `git add 10.21 .survey` + commit + `git tag v0.10.21-rc1`
- 生成 `manifest-before.txt`（路径+大小+sha1 前 12 位）
- 把 `Qwen/` 复制到外部盘并校验（**先复制，不删**）

### 阶段 1｜建 `01-交付包`（40 min，全用复制）
- 建骨架 + README 占位；复制 host/pi/vision/docs/models/stm32（排除 `__pycache__`、`logs`、`runtime/*.png`）
- 改路径引用（`10.21` → `01-交付包`；重点：tests 的 `parents` 推算、docs 里的示例路径）
- 写 `CHECK.py`（模型 sha256 / 依赖 / 端口 / 相机 / hex 版本）+ `VERSION.md`

### 阶段 2｜建 `02-资料库` + 日志种子（40 min）
- 复制 xrw（去 backup）、final（去模型）、new_eye（去模型）、10.17/10.19、赛题、硬件、调研报告
- 新建 `00-项目日志.md` 并回溯补录 12–18 条；写 `决策记录.md` 头部（先空）

### 阶段 3｜建 `03-实验台` + Qwen 搬入（30 min）
- 建 `03-实验台/{_模板, _scratch, SAM-上派实测, 网络化原型}`，每个写 README
- `Qwen/` → `03-实验台/Qwen-VLM/`（移动后校验 sha1；保留 `models/`、脚本；`downloads/` 11.3 GB 可先删）
- 写 `03-实验台/README.md`（索引 + 四种状态 + 清理规则）与 `.gitignore` 规则
- **【可选，推荐】** 把 `03-实验台` 整体移到外部盘，仓库内用目录联接：
  ```
  mklink /J "D:\study\project\robot-competition\03-实验台" "D:\study\lab\robot-实验台"
  ```
  并在 `.gitignore` 加 `03-实验台/`（junction 在 Windows 上会被 git 当目录递归，必须显式忽略）

### 阶段 4｜真机与"断依赖"验收（40 min）
- **换路径**：把 `01-交付包` 复制到 `D:\tmp\verify\01-交付包`，跑 `setup.bat` → `selftest.bat` → `run.bat` 连派出图
- **断 03**：临时把 `03-实验台` 改名/断开 junction，再跑一遍 01（必须仍然全绿）
- Pi 端从新包 `pscp` + `install.sh`，重启后 `systemctl is-active robotpi` = active
- 烧包内 hex，验证「预备(150)」

### 阶段 5｜清理（20 min，验收通过后才做）
- 删 `build/`、`.acl-recovery/`、两份重复 `sam_b.pt`、`ghr/10.15/Project/{Objects,Listings}`、xrw backups、`Qwen/downloads`
- 移走 `final/`、`new_eye/`、`ghr/10.17`、`ghr/10.19`、`xrw/`、根旧文档 → 02
- 最后删 `10.21/`、`.survey/` 已迁移部分
- `git status` 应只剩 `01-交付包/`、`02-资料库/`、`03-实验台/README.md`、`.gitignore`

### 阶段 6｜流程固化（15 min）
- `finish.ps1`：跑 selftest → 追加日志模板 → git status 摘要
- `.gitignore` 重写（runtime/、state/ 除 .gitkeep、.venv、models/*.pt、03 大件、logs）
- `docs/仓库约定.md`：命名、编码（`.bat` 必须 ASCII+CRLF、`.sh` 必须 LF）、提交规范、实验台规矩

**合计约 3 小时 20 分。**

---

## 7. 验收矩阵

| 场景 | 动作 | 通过标准 |
|---|---|---|
| 新机器从零 | `setup.bat` → `run.bat` | 8 页界面出图，串口框出现「派 …」 |
| **自包含** | 移走 `03-实验台` 与 `Qwen` 再启动 | 仍正常（用自己的 `.venv`） |
| 双机链路 | 双击 run.bat → 选派 → 连接 | 在线 + 双画面 >5 fps |
| 控制板 | 点「预备(150)」 | 回 `action=ready, angle=150` |
| 示教 | 录 2 段 → 执行接近段 | 按段走、状态行 `2 段` |
| 返回 | 移动几段 → 原路返回 | 倒序走回、记录清空 |
| 自测 | `selftest.bat` | 7/7 ALL CHECKS PASSED |
| 实验台可弃 | 整目录清空 | 01 不受影响（这是 03 存在的意义） |
| 日志 | 打开 00-项目日志 | 时间线连续、每条有"为什么" |

---

## 8. 风险与对策

| 风险 | 影响 | 对策 |
|---|---|---|
| 路径写死（docs/tests 里 `10.21/…`） | 换目录后测试挂 | 阶段 4 必做换路径验证；tests 统一 `Path(__file__).parents` |
| 模型入 git 撑大仓库 | `.git` 继续涨 | 只留一份 + LFS；历史瘦身留待以后 |
| **实验台变垃圾场** | 半年后不知那 500 MB 是什么 | 每个实验强制 README + 四状态；每月复盘；【有结论】30 天后删数据 |
| junction + git 互相干扰 | git 试图跟踪 33 GB | `.gitignore` 显式 `03-实验台/`；先小规模试一次再迁移 |
| 交付包"假自包含"（偷用 03/Qwen） | 换机器就崩 | 验收矩阵"断 03"一条强制 |
| 标定数据混在代码里 | 换机后抓偏 | 一律进 `state/`，交付包给示例值 + 标定手册 |
| 删早了要重下 33 GB | 浪费 | 阶段 0 先复制校验，阶段 5 才删 |

---

## 9. 需要你拍板的 3 件事

| # | 问题 | 我的建议 | 备选 |
|---|---|---|---|
| 1 | 笔记本上位机放第 4 类，还是并进「视觉部分」？ | **单独 `01-交付包/host/`** | 并进 `vision/`（目录变胖、职责不清） |
| 2 | 模型权重（357.7 MB）怎么管？ | **Git LFS** | 不进 git，发版 zip + 包内 sha256 清单 |
| 3 | **`03-实验台` 物理放哪？** | **放外部盘** `D:\study\lab\robot-实验台`，仓库内 `mklink /J` 联接；仓库本体只剩 480 MB | 直接放仓库内（简单，但备份/克隆都痛） |

> 你上一条只定了"要有第三个实验台文件夹、Qwen 搬进去"，这三条我先按**建议**执行；有不同意见随时说。

---

## 10. 我的意见（针对"三文件夹"版本，7 条）

1. **`03` 的价值在"允许失败"，但失败的代价是"看不清"**：所以每个实验从第一天就要 4 行 README（想验证什么 / 结论 / 状态 / 毕业后去哪）。否则三个月后你只会看到 33 GB 里一堆 `download_*.py`，不敢删也不知道能不能删。
2. **`03` 不进 git**（至少大件不进）。它是"车间"，不是"档案室"；能滚的轮胎别锁进保险柜。
3. **`01` 与 `03` 之间必须单向**：实验的代码"毕业"进交付包要靠人工评审（跑一遍 selftest），绝不能 `import` 直接跨目录引用——否则交付包就废了。
4. **`02` 里最有价值的不是资料，是日志**：资料网上一搜就有，你们的"为什么这么决定"是独一份。建议日志每条都给"放弃的念头"，这是复盘时最省时间的东西。
5. **给 03 加一条"体积红线"**：超过 40 GB 就强制复盘一次（现在 33.7 GB 已经很接近了，Qwen 的 `downloads/` 11.3 GB 其实是可清的缓存）。
6. **交付包只有一个入口文档**：README ≤2 页。现在 20 多份文档里有一半过期（比如上位机 README 说 75 个用例，实际 164），这种"文档债"比代码债更坑。
7. **把"每次任务完成"做成一条命令**（`finish.ps1`）：跑自测 → 追加日志 → commit。靠自觉一定会断，靠脚本才能一年后还在跑。

---

## 11. 工作量

| 阶段 | 时间 | 产出 |
|---|---:|---|
| 0 冻结备份 | 15 min | tag + 清单 + Qwen 外部副本 |
| 1 建 01 交付包 | 40 min | 可用骨架 + CHECK.py |
| 2 建 02 资料库 + 日志 | 40 min | 资料归档 + 12–18 条日志 |
| 3 建 03 实验台 + Qwen | 30 min | 实验索引 + Qwen 归位 + 清理规则 |
| 4 换路径/断依赖验收 | 40 min | 01 真正自包含 |
| 5 清理旧目录 | 20 min | 34.5 GB → 480 MB（03 外置） |
| 6 流程固化 | 15 min | finish.ps1 + 仓库约定 |
| **合计** | **≈ 3 小时 20 分** | 三文件夹仓库 |

> 建议节奏：先做 **阶段 0–3**（只创建、不删除），你看着满意，再让我进阶段 4–6（验收 + 清理）。
