2186279865/robot-10.15/new_eye/交接文档.md

# new_eye 双 USB 相机视觉项目交接文档

## 1. 项目目标

本项目用于工创赛智能分拣装置的视觉识别。当前硬件条件为：

- 两个 USB 摄像头；
- XYZ 龙门架；
- 三爪柔性夹爪，夹爪不能旋转；
- 底部旋转托盘。

由于夹爪抓起物料后会遮挡物料，系统要求在抓取前完成识别。抓取后只允许做夹持状态、入盒状态等确认，不再依赖物料识别。

## 2. 当前视觉方案

当前主识别链为：

```text
顶视相机实时画面
→ 四点区域定位
→ 透视校正
→ SAM 自动实例分割
→ 独立目标掩膜和外接框
→ 输出目标中心、外接框和置信度
→ 后续再接类别聚类和龙门坐标转换
```

当前没有使用传统阈值分割作为主识别方法。`vision.py` 中仍保留旧的颜色和几何分割函数，但 `gui.py` 的“单次识别”入口使用 `auto_segment.py` 的 SAM 后端。

## 3. 文件说明

| 文件 | 作用 |
|---|---|
| `gui.py` | 双相机可视化窗口、旋转、缩放、四点定位、识别按钮 |
| `camera.py` | USB 摄像头打开、分辨率和帧读取 |
| `auto_segment.py` | SAM 自动实例分割后端 |
| `vision.py` | 旧版阈值、颜色、形状识别函数，当前不是主入口 |
| `config.json` | 相机索引、旋转角度、四点坐标、模型路径等配置 |
| `camera_probe.py` | 扫描可用摄像头索引和分辨率 |
| `models/sam_b.pt` | SAM 权重，已下载到项目目录 |
| `runtime/latest_targets.json` | 最新视觉结果 |
| `run_gui_as_admin.cmd` | 以管理员权限启动窗口 |
| `README.md` | 基本运行说明 |

## 4. 启动方式

普通启动：

```powershell
cd D:\study\project\robot-competition
Qwen\.venv\Scripts\python.exe new_eye\gui.py
```

摄像头权限不足时，使用：

```text
new_eye\run_gui_as_admin.cmd
```

模型文件必须存在：

```text
D:\study\project\robot-competition\new_eye\models\sam_b.pt
```

## 5. 窗口使用流程

程序会自动读取 `config.json` 并尝试打开上次使用的两台摄像头。

### 顶视相机

顶视相机负责主识别和抓取坐标。点击“顶视四点框选”，然后按以下顺序点击：

```text
左上 → 右上 → 右下 → 左下
```

绿色四边形表示有效识别区域。右键可以撤销上一个点。

### 副摄相机

副摄相机可以独立旋转、缩放和平移，也可以点击“副摄四点框选”完成四点定位。目前副摄主要用于辅助观察，主识别仍来自顶视相机。

### 旋转和保存

每路画面都有左转 90°、右转 90°和复位按钮。调整完成后点击“保存配置”，下次启动会恢复：

- 顶视和副摄索引；
- 顶视和副摄旋转角度；
- 顶视和副摄四点坐标；
- 当前类别映射和模型路径。

### 识别

四点定位完成后点击“单次识别”。识别框会直接叠加到顶视实时画面上，不再使用右侧黑色轮廓窗口。

结果写入：

```text
new_eye\runtime\latest_targets.json
```

## 6. SAM 识别流程

`auto_segment.py` 使用 Ultralytics SAM：

1. 对四点区域透视校正后的图像推理；
2. 在图像内生成网格正点提示；
3. 获取每个候选掩膜；
4. 过滤过小、过大的区域；
5. 使用 IoU 和包含关系去除重复掩膜；
6. 输出掩膜、轮廓、外接框、中心点和置信度。

识别结果中：

- `bbox_warped`：透视校正图中的外接框；
- `bbox`：转换回原始顶视实时画面的外接框；
- `center_px`：目前是透视校正图中的中心点；
- `confidence`：当前 SAM 结果的基础置信度，后续应增加真实质量评分；
- `class_name`：当前为“待聚类”，还没有完成未知物料自动分成 1～6 类。

## 7. 当前已知问题

### 7.1 未知物料分类还没有完成

SAM 只负责“有几个物体、每个物体边界在哪里”，不能直接判断物料类别。后续需要在 SAM 掩膜基础上增加：

- 颜色特征；
- 轮廓和几何特征；
- 表面文字、二维码或图案特征；
- DINOv2/CLIP 特征；
- 最多 6 类的现场聚类。

### 7.2 SAM 网格提示可能重复

同一个物料可能生成多个候选掩膜。当前通过 IoU 和包含比例去重，但仍需要用真实物料画面测试。若仍然重复，应进一步使用：

- 更稀疏的正点网格；
- 只在四点区域内提示；
- 掩膜面积和中心距离聚类；
- 对同一目标只保留最高质量掩膜。

### 7.3 坐标标定尚未接入

当前仍然是：

```json
"motion_authorized": false,
"calibration_status": "missing"
```

不能直接让识别结果驱动龙门架。必须完成：

- 相机到托盘平面标定；
- 像素到毫米转换；
- XYZ 原点和行程限制；
- Z 轴安全高度和抓取高度；
- 夹爪中心偏置；
- 储物盒坐标。

### 7.4 两台相机并未融合

目前副摄只用于显示和辅助定位，主识别使用顶视相机。后续如需融合，应通过同一物料的时间和坐标关系，把副摄特征合并到顶视目标，而不是简单拼接两张图。

## 8. 后续推荐开发顺序

1. 先用真实托盘和物料确认 SAM 是否能做到“一件物料一个掩膜”；
2. 在顶视实时画面上修正重复框和漏检；
3. 增加每个目标的轮廓面积、颜色直方图和形状特征；
4. 加入 DINOv2 或 CLIP 特征，完成最多 6 类自动聚类；
5. 增加目标置信度门限，低置信度目标禁止抓取；
6. 完成相机到龙门坐标标定；
7. 接入抓取前状态机；
8. 增加夹爪夹持确认和储物盒入盒确认；
9. 最后才将 `motion_authorized` 从 `false` 改为受控授权。

## 9. 推荐的抓取状态机

```text
WAIT_START
→ CAPTURE_TOP
→ CHECK_FOUR_POINT_REGION
→ SAM_SEGMENT
→ CLASSIFY_AND_VALIDATE
→ SELECT_ONE_TARGET
→ MOVE_XY
→ LOWER_Z
→ CLOSE_GRIPPER
→ VERIFY_GRIP
→ MOVE_TO_BIN
→ RELEASE
→ VERIFY_STORAGE
→ UPDATE_DISPLAY
→ NEXT_TARGET
```

任何识别失败、目标重叠、置信度不足、夹爪未夹稳或入盒失败，都应进入安全停止或重新采集状态，不能盲目执行下一步动作。

## 10. 结果文件示例

```json
{
  "schema_version": 5,
  "motion_authorized": false,
  "points_used": true,
  "max_classes": 6,
  "classification_logic": "rule features on SAM masks (shape+colour) with on-site sample registration",
  "class_summary": { "类别1": 2, "类别2": 1 },
  "targets": [
    {
      "id": 1,
      "views": "top+side",
      "bbox": [320, 210, 86, 92],
      "bbox_warped": [120, 160, 96, 102],
      "center_px": [168.0, 211.0],
      "area_px": 6200.0,
      "confidence": 0.9,
      "shape": "圆柱/圆形",
      "shape_conf": 0.71,
      "color": "黄/橙",
      "color_conf": 0.95,
      "class_id": "1",
      "class_name": "类别1",
      "class_key": "圆柱/圆形|黄/橙",
      "class_conf": 0.95,
      "class_source": "rule",
      "need_review": false,
      "class_votes": "5/5"
    }
  ]
}
```

## 11. 重要注意事项

- 四点顺序必须保持一致：左上、右上、右下、左下；
- 相机、托盘和四点区域建立后不要随意移动；
- 改变旋转角度、相机位置或光照后，应重新检查四点和识别结果；
- 不要在未完成坐标标定时接入机械运动；
- 当前识别结果只代表视觉候选，不代表已经抓取成功；
- 比赛正式规则和评分以最新官方文件为准。

## 12. 2026-10-18 更新：实时分割 / 去误检 / 双摄融合

- **实时分割**：`gui.py` 底部“实时分割”按钮，后台线程持续取两路最新帧 → 四点透视校正到 700×700 → SAM 实例分割 → 画面持续叠加“黄轮廓 + 黄框 + 红十字 + #编号”。状态栏和顶视画面左上角显示：刷新帧率、两路相机帧率、分割帧率、双摄目标数。
- **去误检（空处不再报目标）**：`auto_segment.py` 不再用 5×5 网格盲打点。先用颜色（饱和度>45）或“与空托盘的灰度差”找候选前景块，只在候选块内部撒提示点；空托盘、阴影、反光没有候选 → 不会产生提示 → 不会出现假目标。掩膜再按面积、贴边、候选占比、物体性（饱和度/差分亮度）过滤并去重。灰/黑物料需勾选“含灰/黑物料”（config `gray_objects: true`），并建议先“采集空托盘”。
- **双摄融合**：新增 `fusion.py`。顶视负责俯视位置/轮廓/数量；副摄在同一 700×700 托盘坐标系里按水平位置 u 印证顶视目标（同一列前后重叠的物体允许共用一块侧影，副摄分不出前后深度），副摄多出来的目标作为 `side` 目标追加（常见于顶视被遮挡）。两路左右方向相反时自动翻转对应关系。融合结果保留顶视 bbox/中心点，副摄信息作为附加字段。
- **输出 JSON**：`schema_version` 升到 4，每个目标新增 `views`（`top+side`/`top`/`side`）、`id`；双摄都看到时附带 `side_bbox`、`side_center_px`、`height_ratio`（副摄框高/700，仅作高度特征）。`motion_authorized` 仍恒为 `false`。
- **已知限制**：SAM 只做实例分割不分类（`class_id`/`class_key` 仍为占位）；副摄不做三维定位；副摄画面里被裁切/贴边的物体可能不参与融合；当前帧率约 0.4~1.5 fps（GPU 0.66 s/帧单路），实时性靠“后台持续检测 + 画面刷新”而不是高帧率推理。

## 13. 2026-10-18 更新：规则特征分类 + 现场样本登记

- **方法（不训练模型，用户定案“规则特征 + 现场登记”）**：新增 `new_eye/classify.py`。在 SAM 掩膜上算两类特征：
  - 颜色：掩膜先腐蚀（`min(h,w)*0.12`，去掉边缘/高光/阴影），剔除 `V<35` 和 `V≥250` 的像素，取 HSV 中值 → `黑 / 浅色/白 / 红 / 黄/橙 / 绿 / 蓝/浅蓝 / 紫/其他`，附带纯度置信度与 12+4+4 维 HSV 直方图；
  - 形状：`cv2.approxPolyDP(0.035*peri)` 顶点数（3/4/5 → 三棱/正方或长方/五棱），圆度>0.80 且实心度>0.93（或顶点≥6 且圆度>0.74 且面积占比<0.84）→ `圆柱/圆形`；圆顶面若副摄侧影顶部收窄 `side_curv<0.78` → `球`；其余 `其他几何体`；
  - 特征向量 = HSV 直方图 + 7 维 Hu 矩 + 形状量（圆度/长宽比/顶点数/实心度/面积占比/侧影收窄）归一化，用于同键不同物时的余弦最近邻（阈值 `sample_similarity=0.88`）。
- **类别映射**：键是 `形状|颜色`，查序：`config.class_map`（来源 `rule`）→ `samples.json` 同键（`sample-key`）→ 特征最近邻（`nearest`）→ 都没有则 `class_name="待登记"`、`class_source="unknown"`、`need_review=true`（不硬猜）。用户规则要求“形状相同且颜色相同 → 同一储物盒”，初赛 ≥12 件、≥6 类，因此最多 6 类、键空间有限。
- **现场登记**：GUI 底部“登记样本”按钮 → 再点顶视画面里的目标 → 弹窗输入类别编号或名称。`classify.register()` 把特征存 `new_eye/samples.json`（同类别重复样本按余弦>0.985 去重），同时把 `形状|颜色` 写回 `config.json` 的 `class_map` 并把名字写 `class_names`；立即 `save()` 持久化，重启后规则映射仍有效。副摄单独看到的目标（side-only）不能登记，只标“副摄待确认”。
- **接线**：`gui.py` 的 `detect_and_fuse()` 融合后调用 `classify_fused()`；实时分割每帧也做分类（耗时可忽略），状态栏显示 `类别1×2 类别3×2 …`，画面标签显示 `#id 类别名`，框线颜色按类别区分（6 色调色板）；`recognize()` 用 `frames_for_vote` 帧投票，同位置目标的 `class_key/shape/color` 取多数，投票结果记入 `class_votes`（如 `5/5`）。
- **输出 JSON**：`schema_version` 升到 5，顶层新增 `class_summary`、`max_classes`、`classification_logic`；每个目标新增 `shape`/`shape_conf`、`color`/`color_conf`、`class_id`/`class_name`/`class_key`/`class_conf`/`class_source`、`need_review`、`class_votes`。`motion_authorized` 仍恒为 `false`。
- **实测（crop_test.jpg 5 物体，合成副摄影像）**：5 个目标全部 `top+side`；分类结果 `圆柱/圆形|黄/橙`×2 → 类别1、`五棱体|绿` → 类别2、`圆柱/圆形|红`×2 → 类别3；`det_fps≈0.56`；截图 `new_eye/runtime/classify_proof.png`（1450×850）。
- **已知限制**：六棱柱可能被归入“圆柱/圆形”（`extent<0.84` 兜底会误收），登记时核对；同色同形但需要区分大小/高度的物体，规则特征无能为力，得靠登记样本的最近邻或后续加尺寸特征；颜色在强反光/暖光下会漂移；副摄 side-only 目标只给颜色不给类别。

## 14. 2026-10-18 更新：右侧文字面板（所有文本集中显示）

- **布局**：窗口从 1450×850 改为 1680×920，`gui.py` 的 `build()` 改成“左：顶视/副摄两个 Canvas（PanedWindow 各半）；右：宽 540 的 `tk.Text` + 滚动条”。原来画面左上角的小 HUD（帧率/目标数）和右上角的状态栏标签全部删除，文字统一进右侧面板，12 号 Consolas、标题行蓝色加粗、`⚠待登记` 橙色。
- **面板内容**（`App._panel_text()` 生成，`App.update_text()` 比对签名后刷新，避免闪烁）：
  - 【运行】实时分割中 / 相机已打开 / 未打开相机（+ 登记模式）；
  - 【帧率】刷新 / 顶视 / 副摄 fps；
  - 【状态】实时分割最新的“目标数（顶视/副摄）+ 分割 fps”（`sync_live()` 只更新该字段，不写消息日志，避免刷屏）；
  - 【分割】分割 fps + 融合目标数；
  - 【类别】各类别计数；
  - 【目标明细】每个目标 3 行：`#id 类别名 ⚠待登记`、`形状 + 颜色 conf`、`视角 u/v 面积 来源 投票`；
  - 【最近消息】`App.note(msg)` 记录的最近 9 条（带时间戳）。所有原 `st.set(...)` 已改为 `note(...)`，操作/错误消息不会再“只闪一下就没”。
- **窗口截图**：`new_eye/runtime/panel_proof.png`（1680×920，crop_test.jpg + 合成副摄影像）。

## 15. 2026-10-18 更新：每步耗时、副摄隔帧、双摄一致性

### 15.1 右侧面板新增【耗时】（`gui.py` 的 `_panel_text()`，数据来自 `App.times`）
- 计时点：`detect_targets(frame, which, stats)` 里量三段 `校正(warp)/分割(SAM)/反投影(contour→原图)`；`detect_and_fuse()` 量 `融合(fuse)/分类(classify)/核心(core)`；`live_loop` 量 `写JSON(write)` 和 `整帧(frame)`（`recognize()` 也会记 `frame`）。
- 平滑：`App._merge_times(st)` 对每个 key 做 EMA（系数 0.6），避免单帧抖动；面板显示 3 行：
  `【耗时】整帧 1.00s   顶视 764ms（分割 744ms）` / `顶视细分：校正 4ms / 分割 744ms / 反投影 16ms` / `副摄 766ms（分割 750ms）  融合 0ms  分类 17ms  写JSON 1ms`。
- 实测（crop_test + 合成副摄，GPU/CPU）：SAM 分割是绝对大头（顶视 ~74%，副摄同量级），分类 ~17ms、融合 <1ms、写 JSON ~1ms。

### 15.2 副摄隔帧复用（`side_every`，默认 2）
- `live_loop` 调 `detect_and_fuse(fr, side_fr, int(cfg.get('side_every', 2) or 1))`：副摄每 N 帧跑一次 SAM，其余帧直接用 `self.side_cache` 的上一份副摄结果与 warp。
- 实测整帧 1.46s → 1.00s，实时分割 0.53 → 0.98 fps。`cfg['side_every']=1` 可关掉复用。

### 15.3 同一物体在两路被标成两类 —— 原因与修法（**已被第 16 节的严格一对一替换**，保留作历史记录）
原因有两个叠加：
1. 副摄只能看到水平方向 u，**同一列（同一 u、不同 v）的多个顶视目标会共用同一块副摄侧影**；旧代码按遍历顺序把这块侧影的标签写成“第一个用它”的顶视目标的类别，于是同一块侧影上可能出现另一个物体的类别名，看起来就是“一个物体两个类”。
2. 旧融合只按 |Δu| 配对，不同颜色的两列物体可能被错配（比如黄色的顶视目标配上红色的侧影），标签跟着错。
修法：
- `fusion.py`：匹配打分改为 `score = |Δu| + 颜色惩罚`（`_color_penalty`：两路颜色一致 0、未知 0.03、明显不同 0.10），即优先把同色目标配到一起，但门限仍按 |Δu|≤0.18 控制；每个融合项新增 `dist`（实际 Δu）和 `color_mismatch`（两路颜色明显不一致）。
- `fusion.py::fuse()` 现在返回 `flip`，`fuse()` 里记录 `dist`/`color_mismatch`；`gui.py::write_targets()` 输出新增 `color_mismatch`，`need_review` 合并该标志。
- `gui.py::draw_targets()`：副摄侧影按 `id(side_item)` 分组，**每块侧影只画一次**，标签取 `dist` 最小的顶视目标，被 N 个顶视目标共用时标 `×N`。
- `_panel_text()`：`#id 类别名` 后面加 `⚠两路颜色不一致`；类别统计把 `副摄待确认` 拆出来显示为 `未确认×N`，不再混进类别里。

## 16. 2026-10-18 更新：严格一对一融合、识别耗时日志

### 16.1 单次识别 / 实时停止都报告耗时
- `App.recognize()`：从点击开始计时到写 JSON 结束，日志输出一行（时间戳照旧保留）：
  `17:02:13  单次识别完成：5 个目标（顶视5/副摄0，2 帧投票），用时 2.51s（顶视 2.31s / 副摄 0.00s / 融合 0.00s / 分类 0.03s / 写JSON 0.00s）| 类别统计`
  各阶段是本次 n 帧投票的**累计值**（`detect_and_fuse(..., stats_out=[])` 收集每帧 stats 后相加）。
- `App.stop_live()`：累计实时帧数与总耗时，停止时输出 `实时分割已停止：12 帧，平均 1.29s/帧（约 0.77 fps）`；从“停止”按钮进 `stop()` 时也会先走这条日志。
- 面板【耗时】仍显示 EMA 平滑后的**单帧**各阶段耗时，两者互补。

### 16.2 融合改成严格一对一（修“同一物体两路两个类”）
- 根因：副摄只有水平 u，同列前后重叠物体会叠成一块侧影。旧做法允许一块侧影被多个顶视目标共用，标签只能随便挑一个，于是侧影上出现别的物体的类别；并且旧逻辑只按 |Δu| 配对，可能把黄物体配到红侧影上。
- 新规则（`new_eye/fusion.py::_match`）：
  1. 每块副摄侧影**最多配一个**顶视目标（一对一，不再共用、不再标 `×N`）；
  2. 两路颜色都识别出来且明显不同 → **绝不配对**（`_color_penalty >= .10` 直接跳过），所以副摄画面上的类别标签永远与顶视一致；
  3. 匹配仍按 `score = |Δu| + 颜色惩罚` 从小到大贪心分配，左右翻转两种对应关系各试一次，取配对数多/代价小者。
- `views` 三种取值：`top+side`（两路印证）、`top`（副摄未印证，面板 tail 标注“（副摄未印证）”）、`side`（副摄单独看到，标“副摄待确认”，不参与类别统计）。
- `color_mismatch` 字段保留但基本不会再出现（只可能在颜色“未知”时才配上不同物）；`need_review` 仍会合并它。
- `gui.py::draw_targets()`：副摄画面直接按融合项逐项绘制（每块侧影一个标签），删掉了按 `id(side)` 分组取 rep 的 `×N` 逻辑。

### 16.3 验证
- 单元（`_tmp_fuse_test.py`，已删）：同列黄+红顶视 + 一块红侧影 → 只有红目标配对、黄目标 `top`、无 `color_mismatch`；同色同列两目标 → 一对一（一配一 `top`）；副摄多出的侧影 → `side`。
- GUI 实测（crop_test.jpg + 合成副摄影像，`_tmp_proof2.py`，已删）：6 个融合项 = 4 个 `top+side` + 1 个 `top`（面板显示“（副摄未印证）”）+ 1 个 `side`（“副摄待确认”）；侧影无叠字、无 `×N`；截图 `new_eye/runtime/panel_proof.png`。
- 实测耗时：整帧 1.06s（顶视 821ms，其中 SAM 799ms）、单次识别 2 帧 2.51s、实时 12 帧平均 1.29s/帧。

## 17. 2026-10-18 更新：副摄方向（镜像/同向）与融合诊断

### 17.1 为什么需要“副摄方向”
主副摄若面对面安装，副摄画面里的托盘左右方向与顶视相反。融合按托盘坐标的 u（0~1）配对，
副摄 u 必须先翻转（u→1-u）才能和顶视对齐；否则两路完全配不上。之前靠 `fusion.fuse()`
自动试 `flip=False/True` 并取配对数多者，但自动判断在目标少或列重合时可能选错，且用户
看不到它选了哪个方向、到底配上了几个。

### 17.2 新增控件与诊断
- 底部工具栏新增“副摄方向”下拉框：**自动 / 同向 / 镜像**，写入 `config.json` 的
  `side_flip`（0/1/2，默认 0=自动）。`App.set_flip()` 即时生效并提示。
- `fusion.fuse(top, side, max_dist, flip_mode=0, info=None)`：`flip_mode` 0=自动试两种、
  1=不翻转、2=翻转；`info` 回填诊断字典
  `{'flip','flip_mode','n_top','n_side','matched','mean_dist','unmatched_top','unmatched_side','auto'}`。
- 面板新增【融合】行：`顶视 5 / 副摄 5  →  配对 4 个（平均 Δu 0.052，方向 镜像（自动）），副摄未印证 1，副摄多出 1`；
  配对数为 0 且两路都有目标时，再增加一行 ⚠ 提示（检查方向与副摄四点顺序）。
- `latest_targets.json` 新增顶层 `fusion` 字段（即上面 info 的内容），外部程序可据此判断本次
  融合是否有效。

### 17.3 验证
- 单元（`_tmp_fuse_flip.py`，已删）：同向数据自动判 `flip=False` 配 3/3；镜像数据自动判
  `flip=True` 配 3/3；镜像数据 + 强制同向 → 只配上中间重合的 1 个；镜像数据 + 强制镜像 → 3/3。
- GUI 实测（crop_test + 合成镜像副摄，`_tmp_proof3.py`，已删）：面板【融合】= 顶视 5 / 副摄 5
  → 配对 4（平均 Δu 0.052，方向 镜像（自动）），副摄未印证 1，副摄多出 1；截图
  `new_eye/runtime/panel_proof.png`。

## 18. 2026-10-18 更新：副摄“对齐轴”+ 重复框合并 + 标签避让

### 18.1 为什么要“对齐轴”
副摄是从侧面**水平**看托盘的，它画面的水平方向只可能对应托盘的一根轴：
装在托盘短边外 → 水平方向对应托盘的 u（左右）；装在长边外 → 对应 v（前后）。
之前融合一律拿副摄 u 去和顶视 u 比，装错一边时两路坐标根本不在同一根轴上，
就会出现“明明有融合却配不对/同一物体两路不同类”。
现在 `fusion.fuse(top, side, flip_mode, axis_mode, info)`：
- `axis_mode` 0=自动（u/v × 翻转共 4 种组合都试，取配对数多、Δ 小的），
  1=强制左右(u)，2=强制前后(v)。
- 诊断里多 `axis`/`axis_name`，面板【融合】行显示`对齐轴 左右(u)（自动）`。
- 底部工具栏新增“对齐轴”下拉（自动/左右/前后），写 `config.json` 的 `side_axis`。

### 18.2 重复框合并（new_eye/auto_segment.py）
同一物体常被提示出“顶面掩膜”和“整体掩膜”两张，两者 IoU 可能只有 .2~.4，
原来的 IoU<.45/包含<.72 去重留不住 → 画面上同一物体两个框。新增 `_near()`：
两掩膜中心距 < 0.35×较小框长边、且面积比 > .25 视为同一物体，只保留较大的一个。
实测 crop_test 仍是 5 个目标，空托盘仍 0 个。

### 18.3 标签避让（new_eye/gui.py）
`_place_label()` 依次尝试框上方、框下方、再向上/下错 20px 的 9 个位置，避开已放置
的标签矩形（`self._labels`），字号 13→12；目标密集时标签不再糊成一片。

### 18.4 验证
GUI 测试（crop_test 顶视 + 合成镜像副摄）：面板【融合】= 顶视 5 / 副摄 5 → 配对 3 个
（Δ 0.004，对齐轴 左右(u)（自动），方向 镜像（自动）），副摄未印证 2，副摄多出 2；
标签无重叠；截图 `new_eye/runtime/panel_proof.png`。纯 u/v 投影单测：真值 u/v 与翻转
四种组合下，自动判断的 axis/flip 全部正确、配对 5/5。

## 19. 2026-10-18 更新：视觉结果通讯（笔记本 ↔ 香橙派/单片机）

### 19.1 链路选择
| 链路 | 适用 | 说明 |
|---|---|---|
| 网线直连（推荐） | 笔记本 ↔ 香橙派 | 两端设同网段固定 IP（如 192.168.137.1 / .2），或开启 Windows 网络共享 |
| WiFi 同一路由 | 同上 | 注意现场 2.4G 干扰、IP 会变（建议路由器绑 MAC） |
| USB 串口 | 香橙派 ↔ STM32/Arduino | CDC/CH340，115200 起 |
| USB 网卡 | 无路由器时 | 笔记本插 USB 网卡，与板子直连 |

比赛规则允许笔记本通讯（`pdftext.txt:29`），所以“笔记本跑视觉 + 机器人跑运动”是合规架构。

### 19.2 协议（TCP，端口默认 5055，每行一个 JSON）
```json
{"seq":12,"ts":1730000000.123,"n":3,
 "targets":[{"id":1,"u":0.45,"v":0.38,"class_id":"1","class_name":"圆柱黄",
             "views":"top+side","area":12271}],
 "fusion":{"matched":4,"axis":"u","flip":true}}
```
- `u`/`v` 是**托盘归一化坐标**（0~1，左上为原点），机器人乘托盘实际尺寸即得抓取点；
  这也顺带解决了“像素当量未标定”的问题（只需量托盘长宽）。
- `views`：`top+side` 两路都看到、`top` 副摄未印证、`side` 副摄多出（顶视漏检）。
- 每帧约 300~800 字节，1 fps 量级，带宽完全不是问题。

### 19.3 代码（new_eye/link.py）
- `TargetServer(port)`：视觉端 TCP 服务，`start()/send(payload)/stop()`，支持多客户端，
  自动踢掉断开的连接；GUI 顶栏勾“网络推送”即启动（端口取 config `link_port`，默认 5055）。
- `TargetClient(host, port, on_frame)`：机器人端，断线 1s 自动重连。
- `control_frame(payload)`：把 `latest_targets.json` 压成上面的小帧。
- `pack_uart(payload)` / `unpack_uart(buf)`：`0xAA55 + len(2B LE) + JSON + crc16(2B LE)`，
  CRC-16/MODBUS；Pi 收到 TCP 帧后原样写串口给单片机。
- 示例：`new_eye/link_robot_example.py`（打印 + 可选串口转发 + 2s 无帧超时提示）。

### 19.4 使用步骤
1. 笔记本：GUI 顶栏勾“网络推送”→ 面板日志显示 `网络推送已开启：端口 5055，本机 IP 192.168.x.x`
2. 第一次要放行防火墙：Windows 弹窗选“允许专用网络”，或
   `netsh advfirewall firewall add rule name="new_eye" dir=in action=allow protocol=TCP localport=5055`
3. 香橙派：`python new_eye/link_robot_example.py <笔记本IP> 5055`
4. 单片机：`python new_eye/link_robot_example.py <笔记本IP> 5055 /dev/ttyUSB0 115200`

### 19.5 安全约定
- `latest_targets.json` 里 `motion_authorized` 恒为 `false`，运动使能由机器人端自己判断
  （例如：收到一帧 → 计算 → 执行，超过 1~2 s 没新帧就停车）。
- 视觉只有 0.7~1 fps，**不要用视觉做闭环**；机器人应“看一眼 → 规划 → 动到位”。

### 19.6 只能无线通讯时怎么做（笔记本 ↔ 香橙派）

三种无线方式，按现场条件选：

1. **笔记本开热点（最省事，无需路由器）** —— 设置 → 网络和 Internet → 移动热点 → 打开
   - 笔记本自动变成 `192.168.137.1`；香橙派连这个热点，IP 一般是 `192.168.137.x`
   - 热点建议开 5GHz（`netsh wlan show interfaces` 看是否支持），2.4G 现场很挤
   - 无需任何额外配置，`link.py` 的 TCP/5055 + UDP/5056 直接可用
2. **同一个路由器（最稳定）**
   - 关键：**关掉“AP 隔离/客户端隔离”**，否则两个设备互相 ping 不通
   - 路由器里给香橙派绑 MAC 固定 IP；香橙派关掉省电（`iw dev wlan0 set power_save off`），
     否则空闲几百毫秒就卡一下，延迟从 3ms 变 200ms+
3. **香橙派开热点、笔记本连** —— 反向也行，但笔记本切 WiFi 会影响本机网络，不推荐

**不用记 IP**：视觉端勾“网络推送”后，`link.py` 每 0.8s 往 UDP 5056 广播自己的 IP/端口，
机器人端 `link.discover()` 自动找到，示例脚本默认就是 `auto`：

```bash
# 香橙派上（自动发现，无线/有线都不用改）
python3 new_eye/link_robot_example.py

# 发现失败（多播被路由器拦/网段隔离）时才需要写死 IP
python3 new_eye/link_robot_example.py 192.168.137.1 5055
```

**延迟参考**：5GHz 同路由 RTT 2~10ms，2.4G 5~40ms，笔记本热点 3~15ms；
我们一帧数据 300~800 字节、1 fps，无线完全够用。真正的风险不是带宽，是丢包导致 TCP 卡顿 →
所以机器人端必须做“超时没新帧就停车”，示例里已有 2s 超时提示。

**没有 WiFi 时的兜底**：
- 蓝牙串口（RFCOMM）：香橙派 `rfcomm bind 0 <笔记本蓝牙MAC> 1`，笔记本侧用蓝牙串口，
  速率约 100~200 KB/s、延迟 20~100ms，跑 1fps JSON 够用，但配对极麻烦，只作应急；
- USB 无线数传模块（如 2.4G NRF24/433M）通常是给单片机用的，香橙派要加 USB 转接，
  带宽更小，不建议；
- 比赛现场若允许，**网线直连永远是最稳的**（`pdftext.txt:29` 允许与笔记本通讯）。

**操作手册**：从零开始的分步操作、验收清单、故障排查见 `new_eye/无线组网联调.md`。
不接相机时可用 `python new_eye/link_demo.py` 发假帧先验证链路，`--selftest` 本机自检。
2026-10-21 修复：`255.255.255.255` 广播在开 VPN（如 Radmin VPN）的笔记本上只走默认路由，
热点网段收不到，`link.py` 的 beacon 已改为每个本地 IPv4 各绑一个 socket 分别广播。

## 20. 2026-10-18 更新：与 10.15 上位机联调（视觉抓取）

设计稿见 `new_eye/联调与通讯方案.md`（第 8 节为已落地内容）。已实现：

- `new_eye/tray_calib.py`：u/v ↔ X/Y 脉冲二维仿射标定（`solve/uv_to_pulse/save/load/residuals`，
  纯标准库；`python new_eye/tray_calib.py` 自检误差 ~1e-12）。
- `ghr/10.15/上位机/vision_grasp.py`：视觉目标 → `sequence.Sequence`。按储物盒分组排序，
  顺序为 Z 安全高度 → X/Y → 下爪 → 夹紧 → 抬起 → 回固定放料工位 → 转盘最短角度 → 放料 → 松爪。
  示教参数全部在 `vision_grasp.json`（0 = 未示教，生成时给 warning）。
- `ghr/10.15/上位机/vision_import.py` 重写为“视觉目标”页：读 `runtime/latest_targets.json`
  （schema 4/5，>8s 视为过期），列风险（待登记/副摄未印证/两路颜色不一致），选中后生成序列
  灌到“动作序列”页，**不自动运行**。
- `host_gui.py`：`build_tab(self.notebook, self)` 传入 App，生成序列时填界面并写日志。
- `tests/test_vision_grasp.py`：离线单测（仿射、序列结构/排序/最短转盘路径、过期与坏数据拒绝）。
  注：本仓库测试套件里 `test_sequence.SequenceModelTest.test_save_load_roundtrip` 在沙箱下
  因系统 temp 目录权限失败，与本次改动无关。

**流程**：标定（tray_calib）→ 填 vision_grasp.json 示教值 → new_eye 识别 →
上位机“视觉目标”页生成序列 → 逐条检查 → 模拟器/空跑 → 低速真抓 → 提速。

**待现场确认**：相机视野是否覆盖整个转盘、转盘零位与 6 盒角度、X/Y 行程与脉冲当量、
`z.safe/z.grasp/z.lift/z.place` 与 `drop.x/y` 示教值、急停状态。

**补充（空跑后发现）**：`motor_pos` 脉冲数必须非负（负脉冲 E02），方向放第 2 参数；
`abs` 前要先回零否则 E13；方向"正"的取值用 `vision_grasp.json` 的 `dir_positive` 对齐固件
（上位机单轴面板 正=0，仿真器相反）。空跑：3 目标 → 69 步全部 ok，转盘按最短角度只转 60°。

## 20. 2026-10-18 更新：X/Y 标定向导 + 转盘位置记忆

### 20.1 为什么需要标定
new_eye 给的是托盘归一化坐标 (u,v)，机器人要的是 X/Y 脉冲，两者是二维仿射：
`PX = a*u + b*v + tx`、`PY = c*u + d*v + ty`。三个不同点就能解出 6 个未知数
（`new_eye/tray_calib.py`），解出来存 `new_eye/tray_calib.json`。

### 20.2 标定向导（上位机 → “视觉目标”页 → “标定向导”按钮）
> **注意：v4 起默认是“电机走 + 等画面停”（见 20.6）**：让轴走固定脉冲，等物块在画面里
> 不再移动后再读 u/v，不依赖回读、也不依赖人推。下面 1~5 步是它最早的手动分步版本，仍可用作
> 分步操作；“完全手推”模式见 20.5（仅当平台能反向推动时可用）。
1. 物块放顶视画面里，new_eye 点“单次识别”；
2. 向导里“读取视觉 u/v” → “① 记录基准”（此刻 X/Y 视为脉冲 0）；
3. “② X 走 +N”（默认 3000 脉冲、60rpm）→ 等停 → new_eye 重新“单次识别” → “记录 X 点” → “X 回位”；
4. “③ Y 走 +N” → 等停 → 重新识别 → “记录 Y 点” → “Y 回位”；
5. “④ 求解并保存”，向导会打印残差与“每脉冲对应多少 u/v”，并写 `new_eye/tray_calib.json`。

代码：`ghr/10.15/上位机/calib_wizard.py`（无界面逻辑，可离线测试）、
`calib_dialog.py`（Tk 对话框）。测试：`tests/test_calib_wizard.py`（8 个用例）。

**v2（2026-10-18 晚）**：向导加了三处，解决“只能往一个方向走”的操作困惑：
- “相对脉冲”改为可填负数：正=正向（dir=0）、负=反向（dir=1）；协议里方向本来就是独立的 `dir` 字段，脉冲只表示大小；
- 新增“回位方式”下拉：`相对反向`（发 dir=1 走回）或 `绝对回零`（`motor_pos` `abs`→0，需先对这轴“位置清零”，否则固件回 E13）；
- 新增“点动自检”按钮 X±/Y±/Z±（±200 脉冲）：1 分钟确认这一轴两个方向都能动，再开始标定。
- 手册 `new_eye/标定操作手册.md` 同步加“第 2.5 步：方向自检”与两行排查（回位仍同向 / 某方向完全不动）。

### 20.3 转盘停在哪个盒（自动记忆）
`vision_grasp.build_sequence(..., start_box=...)` 返回 `meta={'start_box','final_box'}`；
`vision_import` 生成序列时读 `vision_grasp.tray_state.json` 的 `current_box` 作为起点，
用户确认生成后把 `final_box` 写回。这样连续抓取时转盘只走最短角度，不会每次都空转回盒 1。
“每类进哪个盒”默认按类别编号（类别 1 → 盒 1），需要改时填 `vision_grasp.json` 的
`tray.class_to_box`。手动转过转盘后，点“视觉目标”页的“转盘记忆重置为盒1”重新对齐。

### 20.4 视野受限
顶视相机看不到整盘 6 个盒。当前流程假设“要抓的目标都在当前视野里”，生成序列也只针对
这一批目标。若必须逐一扫描 6 个盒再汇总，需要另加“分盒扫描”流程（转 60° → 识别 →
累积目标 → 生成序列），这一步还没做，等现场流程确认。

### 20.5 手推标定模式（v3，2026-10-18 晚，取代电机带动为默认）

**为什么改**：电机带动模式要“走 N 脉冲 → 等它到位 → 再识别”，而“到位”只能靠 `_wait_ms`
估算（固件 acc 是加速档位、不是 rev/s²，且没有 X/Y 回读可以轮询），现场很难用。
用户反馈“太不好用了这模式”，改成：电机不使能 → 人用手推 → 读编码器回读定位。

**原理**：
- 编码器回读 65536 counts/圈（`host_gui.py` `COUNTS_PER_REV`），运动 3200 脉冲/圈，
  故 1 脉冲 = 20.48 counts；`calib_wizard.counts_to_pulses()`、`wrap_delta()` 负责换算与回绕；
- 每个采样点同时存 `u,v`（视觉）和 `counts_x,counts_y`（回读），相邻点差分得到 `px,py`，
  多点的 `(px,py) ↔ (u,v)` 用同一套最小二乘解仿射（`tray_calib.solve`）；
- 3 点即可，建议 4~5 点（X 单独、Y 单独、斜着各来一次），分散开避免奇异。

**限制**：单圈编码器只测最短路径，两点间真实位移 ≥ 半圈时方向会判错。
`hand_points(max_delta_ratio=0.45)` 会把超过 0.45 圈的跳变打上提示，手册要求单次推动 < 1/3 圈。

**界面**（`ghr/10.15/上位机/calib_dialog.py`，820×700，顶部单选模式）：
| 控件 | 作用 |
| --- | --- |
| ① 取消 X/Y 使能（可手推） | `stop_all` + `motor_enable 0`，之后可手推 |
| ② 记录当前位置（视觉 + 回读） | 读一次视觉 u/v + 查一次 X/Y 编码器，存一个采样点 |
| 撤销上一个点 / 清空采样 | 修正误记 |
| ③ 求解并保存标定文件 | `calib_wizard.solve_hand()` → 写 `new_eye/tray_calib.json`（自动备份旧文件） |
| 恢复 X/Y 使能 | 标定完必须点，否则电机没力矩 |
| 回读：X=… Y=… counts | 判断回读是否通 |
| 采样列表 | 每点 u/v/counts + 相邻点 Δ脉冲 |

**代码**：`calib_wizard.py` 新增 `COUNTS_PER_REV/PULSES_PER_REV/counts_to_pulses/wrap_delta/
hand_points/solve_hand`；`solve(..., labels=('第 2 点','第 3 点'))` 让手推模式报错文案不串成
“X/Y 点”；`report(result, span)` 的“走 N 脉冲 ≈”用实际采样量程当 span。对话框冒烟测试：
3 个手推点（0/6553/6553 counts）解出 `a=d=3199.7 脉冲/u`、残差 1e-12 量级。
测试：`ghr/10.15/上位机/tests/test_calib_wizard.py` 14 个用例（含“超过半圈”与“点数不足”）。
手册：`new_eye/标定操作手册.md` 第 3~8 步已改为手推流程，电机带动降为“备选”。

> 回读前提：固件 hello 的 `readback` 名单要含 X(4)/Y(5)（`readback_mask` 默认 15 已含），
> 且 X/Y 的 TXD 要接到 PA3 并联总线；否则向导会提示“该轴不在回读名单/查不到回读”。

---

## 21. 2026-10-18 更新：标定向导 v4（电机走 + 等画面停，取代手推为默认）

### 21.1 为什么放弃“手推”
用户实测反馈（“点了取消使能还是推不动”）。查固件后确认不是向导 bug：
- `ghr/10.15/Drive/Include/control_inline.h` 的 `control_apply_enable()` 失能时调用
  `Stepper_EnableAt(addr, 0)`，再 `rpm=0 / mode=STOP`；
- `stepper_inline.h` 的 `Stepper_EnableAt()` 是给驱动器**发一帧使能/失能命令**
  （ZDT/Emm42 类 6 字节帧，`build_enable()`），不是拉本地使能引脚；
- 现场驱动器多为**闭环步进**，即使收到失能帧，驱动器内部仍可能保持位置环；
- 更关键：X/Y 若是滚珠丝杠/蜗轮蜗杆等**自锁传动**，取消使能后也推不动（这是机械属性）。
- 另外 4 路驱动器 TXD 并联回读在硬件上未验证（`ghr/10.15/交接文档-20261016.md` 记为方案 A 只接 1 路），
  所以“手推 + 回读”这条路在本机大概率走不通。

### 21.2 新方案：电机走固定脉冲，等“画面里物块不动了”再读
- 运动：`motor_pos` 走 N 脉冲（可负，负=dir 1），继电器/固件自己保证走完；
- 停稳判定：轮询 `new_eye/runtime/latest_targets.json`，要求
  ① 出现比移动前更新的帧（`vision_ts > prev_ts`）；② **连续两帧**同一目标的
  `|Δu| + |Δv| ≤ SETTLE_TOL`（0.0025）。满足即认为平台停了；
- 记录：此刻 u/v + **指令脉冲** (px,py)，不再需要编码器回读、不再需要估算时间；
- 采集点：基准 (0,0) → X 走 N → 停稳记录 (N,0) → X 回位 → Y 走 N → 停稳记录 (0,N) → Y 回位 → 求解；
- 超时兜底：30 s 内没等到“新帧+停稳”就报错（提示开实时分割 / 去点两次“单次识别”）。

### 21.3 界面（`ghr/10.15/上位机/calib_dialog.py`，860×740，重新写）
| 控件 | 作用 |
| --- | --- |
| 模式：电机走 + 等画面停（默认）/ 手动推动 | 顶部单选，切换两套面板 |
| 相对脉冲(负=反向) / 转速 rpm / 加速度 | 默认 3000 / 60 / 100；负脉冲反向 |
| 只标目标编号 | 多目标时填 `#3`，空则取离托盘中心最近的 |
| **一键标定** | 基准 → X 走/停稳记录/回位 → Y 走/停稳记录/回位 → 自动求解并保存 |
| 读取视觉 u/v / ① 记录基准 | 手动分步时用 |
| ② X 走 N / X 回位、③ Y 走 N / Y 回位 | 每步自动“等停稳→记录”，无需再点“记录点” |
| 点动 X±/Y±/Z± | 各 200 脉冲，验方向/接线 |
| 撤销上一个点 / 清空采样 / 停止所有轴 / 写 tray_calib.json | 常规 |
| 手推面板 | 取消/恢复使能、记录当前位置（视觉+回读）、求解；顶部警示“自锁机构推不动是正常的” |

### 21.4 代码与测试
- `calib_wizard.py` 新增：`vision_ts(path=VISION_JSON)`（读 JSON 的 ts，读不到回 0）、
  `pulse_points(samples)`（校验 u/v/px/py，可直接喂 `solve()`）、
  `solve_pulse(samples, ...)`（等价于 `solve(pulse_points(...))`）。
- `calib_dialog.py` 重写：`_wait_settled_frame(prev_ts, on_done, token, deadline, last_uv, polls, hinted)`
  轮询 `POLL_MS=350`、`FRAME_TIMEOUT_MS=30000`、`SETTLE_TOL=0.0025`；
  `_move_axis(axis, direction, pulses, on_done, what)`；`_jump()` 用自增 seq 作废上一条异步链。
- 测试：`tests/test_calib_wizard.py` 新增 `TestPulsePoints`（脉冲点反解 affine、缺字段报错、
  `vision_ts` 文件/缺失/坏 JSON），共 **17 个用例通过**；全套 99 用例只有既有
  `test_sequence.test_save_load_roundtrip` 因沙箱临时目录权限失败（环境问题）。
- 冒烟（假视觉 + 假电机，已删脚本）：`on_auto_all` 依次产生 4 次 `motor_pos`、3 个采样，
  解出 `a=8333.333、d=9090.909`（与注入真值一致，残差 1e-12 量级）。
- 手册：`new_eye/标定操作手册.md` 第 2~7 步已按新流程重写，手推降为“备选”。

---

## 23. 2026-10-18 更新：标定“简化求解”（治“矩阵奇异/共线”）

- 现场用“通用 3 点”常失败：`变换矩阵接近奇异，标定点可能共线`——多半是两次移动都沿同一方向
  （只走 X 没走 Y），或脉冲没变化（软位置没记上）。
- `calib_wizard.py` 新增：
  - `check_points()` 补两类诊断：① 所有点脉冲完全相同 → 提示“没记录到移动”；
    ② 只有一个轴变化过 → 提示“再走一段另一个轴”；
  - `solve_ortho(points, ...)`：只假设 **X→u、Y→v**（b=c=0），用“Δpx/Δu”和“Δpy/Δv”直接定标，
    从数学上不可能奇异；返回 `mode='ortho'` 与 `coupling`（X 走时 Δv/Δu、Y 走时 Δu/Δv）。
  - `report()` 对 ortho 结果加标题行与“旋转/耦合检查”：|比值|>0.30 时 ⚠ 提示两轴不垂直/相机装歪。
- `calib_dialog.py`：新增按钮 **「简化求解（只走 X/Y）」**（`on_solve_ortho`）；
  「③ 求解并保存」失败且是共线/奇异时弹窗询问“改用简化法吗”，同意即 `solve_ortho`；
  结果输出抽成 `_show_result()`；界面提示文字写明“只走两次即可”。
  窗口 940×740。
- 测试：`tests/test_calib_wizard.py` 新增 `TestOrthoSolve` 5 例（恢复比例、单轴拒绝、无 u/v 变化拒绝、
  耦合 ⚠/✓、写盘 b=c=0）→ 全套 107 用例，仍只有既有 tempfile 权限用例失败（环境）。
- 手册：第 4 步改成“只走 X、再只走 Y、点简化求解”；排查表补“矩阵奇异/共线”一行。

---

## 22. 2026-10-18 更新：标定向导 v5（手动走轴 + 视觉记录，最终采用）

### 22.1 为什么 v4 也不好用
- v4 让向导自己发 `motor_pos`，再用“连续两帧 u/v 差 < 0.0025”判停稳。
- 实测：`标定失败：标定点不合格（Δu=-0.001 Δv=-0.000）`——电机没使能/没动、或
  实时分割帧率太低（0.5~1 fps）、判稳窗口里拿到的其实是同一帧，于是“看起来没动”。
- 排查还发现固件一个真问题：`control_inline.h` 里 `motor_pos` 的 `mode` 参数被忽略，
  始终走 `Stepper_MoveRelativeAt2(..., absolute=0)`，即 **abs 实际是相对**；
  `Stepper_MoveAbsoluteAt()` 定义了但没被调用（已单独告知用户，修法 A/B 待选）。

### 22.2 v5 流程（用户指定）
1. new_eye 点一次「单次识别」，目标 u/v 写入 `new_eye/runtime/latest_targets.json`；
2. 上位机标定向导点「① 读取视觉 u/v」，再点「② 记录坐标」→ 存 (u, v, 当前软位置 X/Y)；
3. 用户用**单轴页**（X(4)/Y(5) 面板「▶ 相对走」）手动把平台走到下一个位置；
4. 再点「单次识别」→「① 读取」「② 记录」→ 第 2 个点；
5. 「读取现在走过的脉冲」可核对当前软位置与相对上一点的 ΔX/ΔY；
6. 「一键回 0 脉冲点（X/Y）」按软位置把轴开回 0 基准点；重复到 3~5 个点；
7. 「③ 求解并保存标定文件」。

关键点：脉冲来自上位机的**软位置记账**（`HostClient.motion_hook` → `App.soft_pos`，
相对运动累加；连续/绝对模式置 `pos_known=False`），不依赖编码器回读，也不需要改固件。

### 22.3 代码（`ghr/10.15/上位机/calib_dialog.py` v5，390 行，940×740）
- 模式：`手动走轴 + 视觉记录（step，默认）` / `手推 + 编码器回读（push，备选）`；
- step 面板：`① 读取视觉 u/v`、`② 记录坐标`、`读取当前脉冲`、`一键回 0`、
  `撤销上一点`、`清空采样`、`③ 求解并保存`、写盘勾选、软位置标签、最近一次视觉标签、
  “采样点”列表（u/v + 脉冲 + 相对上一点 Δ）、日志框；
- `_read_uv(use_cache=True)`：记录时复用 30 s 内「① 读取」的值，避免连读两帧造成 u/v 不一致；
- `on_home()`：按软位置发 `motor_enable 1` + `motor_pos(..., rel)` 反向回 0，走前弹窗确认，
  位置未知时拒绝并提示“手动挪回 + 位置清零”；
- `_soft()` 读 `app.soft_pos/{4,5}` 与 `app.pos_known`；未知时记录前弹窗确认。
- 求解复用 `calib_wizard.pulse_points()` / `solve()`（`MIN_UV_DELTA=0.008`、共线检查、
  报告、写盘前备份 `tray_calib.<时间>.bak.json`）。
- 截图：`new_eye/runtime/calib_dialog_proof.png`（940×740，填了 4 个假采样点）。

### 22.4 验证
- 假视觉 + 假电机冒烟（临时脚本已删）：4 点全部记录、报告输出换算率/方向/残差、
  `on_home()` 正确下发 `X −3200 / Y −1800`；`ast.parse` 通过。
- 全套 102 用例：仅既有 `test_sequence.test_save_load_roundtrip` 因沙箱临时目录权限失败（环境问题）。
- 手册 `new_eye/标定操作手册.md` 已整篇改为 v5 流程（第 2/2.5/3/4/5/7 步 + 排查表 + 完成标准）。

---

## 24. 2026-10-20 更新：视觉点标注法（用户提的“点画面 + 对爪子”方案）

- new_eye 新增 **「标注点」** 按钮（`new_eye/gui.py`）：
  - `mark_mode` 打开后左键点顶视画面 → `frame_to_uv()` 用当前四点单应矩阵把像素换算成
    **与识别结果同一坐标系**的 u/v，追加 `{'u','v','x','y'}` 到 `self.marks`；
  - 每次点击原子写入 `new_eye/runtime/calib_marks.json`（`{'updated_at','points':[...]}`）；
  - 顶视画面画青色十字 + `P<n>`；右键撤销上一个点；Esc 退出；「清空标注」二次确认；
  - 面板加【标注】行（点数 + 最近 u/v）。
- 上位机 `calib_wizard.py` 新增 `MARKS_PATH`、`load_marks()`、`save_marks()`、`marks_points()`
  （后者要求每个点都记录过爪位，<3 点报错）。
- `calib_dialog.py` 新增**第三种模式**「视觉点标注（默认推荐）」：
  列表显示 `P<n> u/v X=? Y=?`；「刷新标注点」「记录爪位」（读软位置写入 px/py 并回写文件、
  自动跳到下一个未记录点）「清除这个爪位」「求解并保存」；`_show_result()` 复用；
  顶部提示语随模式切换。
- 测试：`tests/test_calib_wizard.py` 新增 `TestMarks` 5 例（读/写/坏文件、缺爪位报错、
  少于 3 点、三点反解 affine 残差<1 脉冲）→ 全套 112 用例，仍只有既有 tempfile 权限用例失败（环境）。
- 冒烟：假 marks 文件 + 假软位置跑真 Tk 对话框，列表 3 行、逐行记录爪位、求解残差 0，
  截图 `new_eye/runtime/calib_marks_proof.png`（940×740）。
- 文档：`new_eye/标定操作手册.md` 第 3 步拆成“3A 视觉点标注（推荐）/ 3B 手动走轴（旧）”，
  排查表补 3 行标注点法排错；`new_eye/README.md` 界面用法加第 9 条。

---

## 25. 2026-10-20 更新：向导内置“XY 点动”（四键 + 可改脉冲）

- `calib_dialog.py` 在三种模式共用的位置加了 `LabelFrame('XY 点动')`：
  - 第一行：`X+ / X− / Y+ / Y−` 四个按钮 + `停止所有轴`；
  - 第二行：**`每次点动脉冲` 输入框**（默认 500，可改）+ `X 方向取反` / `Y 方向取反` 勾选 + 说明。
- 行为：点动前自动 `motor_enable axis 1`，再发
  `motor_pos(axis, dir, 60, 100, pulses, 'rel')`；日志记“点动：X+ 500 脉冲（命令方向 0，60rpm）”；
  400ms 后刷新软位置。走的是相对模式，所以软位置继续累加，记录爪位不受影响。
- 纯逻辑抽到 `calib_wizard.jog_direction(sign, flip=False)`（返回 dir 0/1），对话框调用它，
  测试 `TestJogDirection` 3 例覆盖正/负/取反。
- 截图：`new_eye/runtime/calib_jog_proof.png`（940×740，显示四键 + 脉冲框 + 停止 + 取反）。
- 测试：全套 115 用例，仅既有 `test_sequence.test_save_load_roundtrip` 沙箱 tempfile 权限失败（环境）。
- 手册 3A 末尾补“对爪子时用底部 XY 点动，不用来回切页面”。

### 25.1 点动没有反馈 → 加应答回报（2026-10-20 晚）
- 用户反馈“点了四个键没动”。排查：编码正确（`§7,motor_pos,4,0,60,100,500,rel*..`），
  与单轴页「▶ 相对走」同一路径；差别在于点动是“一次点击一条命令”，出错时对话框里看不到任何信息。
- `host_client.py`：新增 `self.last_ok` / `self.last_err`（`_on_reply()` 里写 `{ts,cmd,code,text}`），
  事件流保持不变。对话框用它判断“被拒绝/已确认/没应答”。
- `calib_dialog.py` 点动改为三步：先 `motor_enable`，120ms 后 `motor_pos`，
  650ms 后把结果显示在日志：`✓ X 点动指令已被固件确认（ok）` /
  `✗ Y 点动被固件拒绝：E13 …` + 错误码解释（E13 位置未清零、E02 参数错、E11/E04 轴不可用、
  锁存类先“解除停止锁存”）/ `? 没有收到应答`。
- 新增 **「使能 X/Y」** 按钮（一次给 X=4、Y=5 发 `motor_enable 1`）。
- 测试：全套 115 用例通过（仅既有环境 tempfile 1 例失败）。

### 25.2 向导里加“回 0”按钮（2026-10-20 晚）
- 用户：“加一个让所有电机回到 0 脉冲的位置的按键”。
- `host_gui.py` 的 `home_all()` 增加可选参数 `axes`（只回指定轴，顺序仍按 Z→X→Y→转盘 过滤）；
  主界面顶栏「一键回0」行为不变（`axes=None`）。
- `calib_dialog.py` 点动区新增两个按钮：**「回 0（X/Y）」**（只回 X=4、Y=5）
  和 **「全部回 0」**（Z/X/Y/转盘四轴），都调用主界面同一套软位置回 0 逻辑；
  日志会写“已请求…（顺序 …）”，并对旧版 `home_all()` 做了 TypeError 回退。
- 说明：0 基准点 = 该轴最近一次「位置清零」的位置；位置未知的轴会被跳过并提示，
  防止“按错误基准倒着走”。全部回 0 前面板会弹确认框（运动前确认路径无人无物）。

### 25.3 取消使能 + 手推后“读回读脉冲/记录爪位”（2026-10-20 深夜）
- 用户（m05287）：“加一个取消使能的按键，要要推到位置然后记录脉冲数”。
- `host_client.py`：`motor_query pos` 的应答现在缓存在 `HostClient.last_counts[addr]`
  （`{'counts','ts','what'}`，`_apply_ok` 里解析 `addr/counts`，断线时清空）。
  之前查询应答只是进日志，界面只能靠遥测 `tele` 事件更新面板，拿不到“此刻”的回读。
- `calib_wizard.py`：新增 `READBACK_AXES={'x':4,'y':5}`、`READBACK_MAX_AGE_MS=2500`、
  `pick_pulses(soft, readback, now_ms, ...)`：两轴都有 2.5s 内新鲜回读 → 用
  `counts_to_pulses()`（65536 counts/圈 ↔ 3200 脉冲/圈）换算；否则退回软位置。
- `calib_dialog.py`（XY 点动区）新增：
  - **「取消使能 X/Y」**：先 `stop_all` 再对 4/5 发 `motor_enable 0`，弹确认框（轴可能失力下滑）；
  - **「读回读脉冲」**：对 `client.readback_axes` 内的轴发 `motor_query pos`，500ms 后显示
    `X=… counts（≈… 脉冲，…ms 前）`；没接回读的轴直接提示会回 E04；
  - 「记录爪位 / ② 记录坐标 / 读取当前脉冲」改用 `_current_pulses()`（回读优先，日志标“来源 回读/软位置”）。
- 测试：`tests/test_client.py::test_query_counts_are_cached`、`tests/test_calib_wizard.py::TestPickPulses`（4 例）
  → 全套 121 用例，仅既有 `test_sequence.test_save_load_roundtrip` 沙箱 tempfile 失败（环境）。
- 文档：`new_eye/标定操作手册.md` 备选模式改为“先取消使能 → 读回读脉冲确认计数会变 → 再推”，
  排查表补“读回读脉冲显示回读轴：无 / 来源是软位置”；截图 `new_eye/runtime/calib_rb_proof.png`。
