2186279865/robot-10.15/Qwen/deployment-status.md

# 部署验证记录

## 2026-10-17 YOLO-World 联调更新

- 已安装 Ultralytics 8.3.228、PyTorch 2.7.1+cu128、torchvision 0.22.1+cu128、CLIP。
- CUDA 实算通过，设备为 RTX 5060 Laptop；pip check 无依赖冲突。
- YOLO权重为 yolov8s-worldv2.pt。CUDA轮子和CLIP权重均通过官方SHA256校验。
- GPU单张1280×720照片、640检测输入：首次8.142秒，后续0.016/0.018秒。
- 同照片CPU基线预热后约0.129秒。以上为检测耗时，不能作为完整识别链FPS。
- Qwen首次调用59.535秒；驻留后样本约0.8–2秒。同图复测可能使用缓存。
- 精简中文提示词后，清晰蓝色积木输出蓝色/棱锥，耗时0.789秒。
- 检测质量尚不合格：第一张多积木照片只检测到一个局部框，第二张无框；
  降低阈值和更换提示词也出现合并框。局部圆面裁剪被Qwen误判为球体，且uncertain=false。
  模型自报确定不代表正确，不能用它自动授权抓取。
- 实测完整离线通路：相机工作线程同一路径 → YOLO → 裁剪 → Qwen → 原子JSON → 上位机校验读取。
- 4项视觉契约测试通过（ROI坐标、裁剪、输出格式、上位机输入校验）；12项上位机界面测试通过。
- 视觉窗口创建通过；本次未打开实体摄像头重新拍摄，未操作机械。
- 上位机新增“视觉目标”只读页；未提供标定，因此未实现自动抓取。

以下为较早的基础模型部署记录，当前功能及启动方法以 README.md 为准。

验证日期：2026-10-17（北京时间）。

- 硬件：NVIDIA GeForce RTX 5060 Laptop GPU，8151 MiB 显存。
- Ollama：官方 v0.40.5 便携程序，CUDA 13 后端，所提取文件通过 ZIP 条目 CRC 检查。
- 模型：`qwen2.5vl:3b`，ID `fb90415cde1e`，约 3.2 GB；配置和全部模型层均通过官方摘要 SHA256 校验。
- 服务：`127.0.0.1:11434`，模型目录为本目录 `models/`，未配置开机自启。
- Python：本目录 `.venv/`，基于本机 Python 3.12.10，识别脚本不需第三方依赖。
- `ollama ps` 显示：100% GPU、4096 context。
- 首次公开测试图识别：狗，动物；耗时 62.692 秒，包含首次加载和预热。
- 模型驻留后的同图缩小版本（宽448像素）识别：狗，动物；耗时 1.714 秒。
- 两次结果均成功解析为结构化 JSON，并写入 `data/recognitions.jsonl`。
- 测试图片来源：https://raw.githubusercontent.com/pytorch/hub/master/images/dog.jpg

以上只验证部署和图片推理通路，不代表比赛未知物品的分类准确率，也不能据此保证其他图片的速度。
缩图测试使用相同内容且模型已预热，可能受缓存影响。
下一步需采集实际物品，按比赛分类规则评估名称、分类和不确定项；尚未接入摄像头和龙门架运动。

模型保持空闲5分钟后可自动卸载释放显存；本机服务仍运行，重新识别时会再次加载。
