2186279865/robot-10.15/02-资料库/05-调研报告/00-全项目导读.md

# 全项目导读 · robot-competition

> 本文件由 6 份子报告汇总而成（`01-firmware.md` / `02-host-app.md` / `03-vision.md` / `04-llm-qwen.md` / `05-refs-docs.md` / `06-final.md`），
> 目标只有一个：**任何人（或下一个 AI 会话）读完这一篇，就知道这个仓库里有什么、怎么跑、到哪一步了、坑在哪**。
> 所有结论都尽量给到 `相对路径:行号`；细节展开请看对应的 `.survey/0X-*.md`。
>
> 基线：git HEAD = `2637af2`（分支 main），工作区 32273 个文件，约 34 GB（其中 33.7 GB 是 `Qwen/`）。
> 调研方式：6 名只读调研员 + Lead 交叉核对，全程未修改工程文件。

---

## 0. 一句话

这是一套 **2027 年工创赛「智能分拣」赛项的四轴抓取机器人**工程，由四个可独立运行的部分拼成：

```
视觉(sam+规则分类)  ──latest_targets.json──►  PC 上位机(tkinter)  ──USB CDC 行协议──►  STM32F407 固件  ──USART2/EMM V5──►  4 台步进 + 舵机夹爪
   new_eye/                                    ghr/10.15/上位机/                      ghr/10.15/                          Z/托盘/X/Y
        ▲
        └── Qwen/（Ollama + qwen2.5vl 3b/7b，本地 VLM 语义复核，目前是"孤儿"旁支）
```

外加：`xrw/`（两套厂商参考工程，机械臂时序的来源）、`final/`（10-21 冻结的一体化交付快照）、
`ghr/10.17`+`ghr/10.19`（ST7735S 屏实验，为赛项强制显示屏做准备）、`build/`（编译日志 + 10.19 副本）。

**当前真实状态一句话**：看得见、算得出、能下发、能握手；**但"抓得准"没闭环**——
X/Y 标定残差超标、四轴回读硬件未通、Z 示教全 0、绝对定位在固件里形同相对、视觉从未在真机上跑完整抓取。

---

## 1. 仓库地图：哪些是主线，哪些不是

| 路径 | 体量 | 性质 | 一句话 |
|---|---|---|---|
| `ghr/10.15/` | 66.4 MB / 824 文件 | **主线 · 固件** | STM32F407VG + StdPeriph 四轴抓取固件（正式 + 诊断两支） |
| `ghr/10.15/上位机/` | ~5000 行 Python | **主线 · PC** | tkinter 六页上位机，Type-C CDC 行协议客户端 |
| `new_eye/` | 358.6 MB / 38 文件 | **主线 · 视觉** | 双相机 + SAM 分割 + 双摄融合 + 规则分类，只出 JSON |
| `Qwen/` | 33.7 GB / 30025 文件 | **旁支 · 语义** | Ollama + qwen2.5vl 本地 VLM 实验台，交接文件已无人消费 |
| `xrw/` | 39.9 MB / 706 文件 | **只读参考** | 例35（视觉 XY 跟随全流程）/ 例36（Z 轴最小闭环）+ 76 个 backup |
| `final/` | 393.7 MB / 436 文件 | **交付快照** | 10-21 冻结的「视觉+控制」一体化包，**不是主线** |
| `ghr/10.17/` `ghr/10.19/` | 各 ~10 MB | **独立实验** | ST7735S 1.8" 屏点屏 / 完整液晶实验，不参与主固件 |
| `build/` | 17.1 MB / 232 文件 | 日志 + 副本 | 4 份 UV4 编译日志 + 10.19 副本，**10.15 主固件的"编译通过"不在这里** |
| 根文档 | — | 总纲 | `README.md`(92) `交接文档.md`(189) `环境复刻流程.md`(250) `EMM_V5_串口协议与工程指令总结.md` `newpdftext.txt`(赛题) `pdftext.txt`(命题解析) |

**不在 git 里但占空间的**：`Qwen/.venv`/`models`（33 GB）、`new_eye/models/sam_b.pt`（357.7 MB）、
各目录 `Objects/`、`backup_before_*`、`__pycache__`（`.gitignore` 已排除，新克隆必然缺，见 §7 坑 1）。

---

## 2. 五条数据/控制链（看懂这五条就懂了整个项目）

1. **运动链**：上位机 `protocol.py` 组 `$id,cmd,args*CS\n` → USB CDC(PA11/PA12) → 固件 `host_protocol_inline.h`
   → `control_inline.h` → `stepper_inline.h` → USART2(PA2) → 4 台 EMM V5（Z=1 / 托盘=3 / X=4 / Y=5）。
2. **视觉链**：双相机 → 四点单应(700×700) → 前景候选 → `auto_segment.py`(SAM) → `fusion.py`(双摄一对一) →
   `classify.py`(HSV+形状) → `new_eye/runtime/latest_targets.json`（schema 5，u/v 归一化）。
3. **视觉→运动链**：`vision_import.py` 只读校验（8 s 过期、`motion_authorized` 必须 false）→
   `vision_grasp.py` 套 `tray_calib.json` 仿射 → 12 步/件的 `Sequence` → 动作序列页手工点"运行"（不自动跑）。
4. **标定链**：`calib_wizard.py`/`calib_dialog.py`（marks/push/step 三模式）解 `PX=a·u+b·v+tx`、`PY=c·u+d·v+ty`
   → 写 `new_eye/tray_calib.json`（与视觉共用一份，不是上位机私有）。
5. **语义链（旁支）**：`Qwen/recognize.py` 单件裁剪图 → qwen2.5vl → `data/recognitions.jsonl` + `data/vision_targets.json`
   （schema 1，像素坐标）→ **现在没有任何代码读它**。

关键点：**PC 从不直接对驱动器说话**（三版方案唯一不变的决定），所有 EMM 帧由固件产生；
**视觉从不授权运动**（`motion_authorized` 恒 false，四层落实：视觉不授权/上位机校验/机器人超时/文档留最后放开）。

---

## 3. 固件 `ghr/10.15/`（报告：`01-firmware.md`）

### 3.1 结构：为什么实现写在 `*_inline.h`

Keil 一直开着工程，内存里的文件列表是旧的，**外部改 `.uvprojx` 会被 Keil 保存时覆盖（已发生两次）**，
所以新模块的实现全部内联进 `Drive/Include/*_inline.h`，由 `main.c` include 带入，不动工程文件
（`ghr/10.15/Drive/Include/stepper_inline.h:1-9`）。

| 文件 | 行数 | 角色 |
|---|---|---|
| `MY/main.c` | 186（GBK） | 正式固件入口；include 顺序 = 架构分层（`:1-22`），主循环 `:120-185` |
| `MY/main_diag.c` | 119（GBK） | 诊断固件：FD 半圈 × 5 档参数、闪 2 下（`:35-53`、`:93-117`） |
| `Drive/Include/host_protocol_inline.h` | **1918** | 行协议全套（19 命令/13 参数/E01–E13/会话去重/遥测） |
| `Drive/Include/control_inline.h` | ~361 | 四轴状态、锁存错峰停车、非阻塞发帧、夹爪 settle |
| `Drive/Include/stepper_inline.h` | 491 | EMM V5 组帧/发送超时/回环自检 + TIM2 1ms 时基 |
| `Drive/Include/emm_reply_inline.h` | 369 | 回包长度表、滑动窗口重同步、非阻塞查询事务 |
| `Drive/Include/host_transport.h` + `Drive/Source/host_usb.c` | 66 / — | CDC 传输层（TX 拒半帧、RX 512B 环形队列） |

**不参与编译的陷阱**：`Drive/Source/stepper.c`、`gripper.c` 是历史参考副本（已漂移，`RX_SIZE 32` vs inline 版 64），
`key.c` 不存在；把它们加进工程会 `Multiply defined`。**以 `*_inline.h` 为准。**

### 3.2 硬件与启动

- 引脚：PA2/PA3=USART2（→驱动器 / 回读）、PA11/PA12=USB OTG FS CDC、PB6=TIM4_CH1 舵机、PA0=按键（**内部下拉，按下为高**）、PC13=LED（低亮）。
- 中断优先级：TIM2=1 > USB=2 > USART2=3；`stm32f4xx_it.c` 只放内核异常，外设 ISR 在 inline 头与 `host_usb.c` 里。
- 上电顺序照抄例36：`Delay/LED/Key/Stepper/HostLink/host_protocol` 初始化 → 闪 1 下 → `0E 52` 解锁转 → `FE 98` 停车 → `F3` 使能 Z → **等 500 ms** 驱动器才认速度指令（`MY/main.c:95-114`）。
- 主循环 ≈1 ms：`HostLink_Poll()` → `host_protocol_task()` → PA0 状态机（锁存/停车/让 Z 转）→ LED 心跳。

### 3.3 行协议（PC↔MCU，本工程最重要的一层）

```
请求  $<id>,<cmd>[,<arg>...]*<CS>\n      例 $12,motor_speed,1,0,60,1*4A
应答  #<id>,ok[,k=v...]*<CS>\n
错误  #<id>,err,<code>[,k=v...]*<CS>\n   事件 #0,event,<type>,...   遥测 #0,tele,...
```
- `CS` = 起始符后到 `*` 前所有字节的 XOR，两位大写十六进制（`:965-976`）；整帧 ≤96 字节（`:36-47`）。
- **`!` 是带外急停**，USB 回调与协议层都会拦（`host_usb.c:190-195`）。
- 语义铁律：**`ok` ≠ 到位**。完成看 `#0,event,task,state=reached`；三级证据 `sent/driver_ack/reached`。
- **`motor_query` 是唯一异步应答命令**：先记 `defer_id`，等驱动器回包或超时才补发 `ok`（`:1361-1406`）。
- 会话去重 4 槽：同 id 同内容重发原应答（防相对位移重复执行），冲突回 `E12`，`hello` 例外（`:1691-1740`）。
- 心跳 3 s 无字节 → 锁存停车，**只停车不关 Z 使能**（防垂直机构下滑，`:1866-1876`）。
- `readback_mask`（默认 15=四轴都接）声明哪些轴有回读，名单外 `motor_query` 一律 `E11`，绝不编数。

### 3.4 构建与验证

- `Project/STM32F407.uvprojx`：ARMCC V5.06u6、`STM32F407VGTx`、O1、输出名却是 **`STM32F429`**（历史遗留，烧的是 `Objects/STM32F429.hex`）。
- 最新完整重编（含 USB）：`Code=27728 RO=808 RW=516 ZI=7108`，**0 Error 0 Warning**（`Project/Objects/STM32F429.build_log.htm:53-55`，10-21 20:00）。诊断固件 `Code=3416`。
- 测试层 `Test/host_protocol/`：**在 PC 上用真实固件源码 + 硬件桩**跑协议一致性，再把固件实际发出的帧（`frames.txt`）
  交给上位机自己的 `protocol.py` 二次解析——"规格即文档"的双向验证，是全工程最值得抄的做法。
- **未验证**：USB CDC 从未上板枚举、PA3 真驱动器回读、四轴联动、心跳拔线场景；"步进真转过"只有交接文档"例36 实测好用"的间接证据。

---

## 4. PC 上位机 `ghr/10.15/上位机/`（报告：`02-host-app.md`）

纯标准库 Python + tkinter（`pyserial` 可选），10 个模块 ≈5000 行，6 个测试文件 121 用例（实跑 120 过，
唯一错是沙箱 Temp 写权限，非代码问题）。

| 模块 | 行数 | 职责 |
|---|---|---|
| `protocol.py` | 548 | 帧语法/XOR/13 错误码/`COMMAND_SPECS`(ArgSpec 校验)/分帧/去重/请求 id 池 |
| `serial_link.py` | 251 | pyserial 与 `\\.\COMn` 双后端、端口枚举（VID 0483 排前）、指数退避重连 |
| `host_client.py` | 478 | 握手/心跳 1s/失联 3s/超时策略/`RETRYABLE` 仅幂等 5 命令/事件队列 |
| `simulator.py` | 513 | 无硬件模拟固件，时间推进产生 tele/task 事件 |
| `sequence.py` | 337 | 12 种步骤 + `SequenceRunner`，`wait=reached` 才算到位 |
| `host_gui.py` | 1088 | 六页 GUI、软位置记账、一键回 0（Z→X→Y→托盘） |
| `vision_import.py` / `vision_grasp.py` | 183 / 266 | 只读导入视觉 JSON / 生成 12 步/件序列 |
| `calib_wizard.py` / `calib_dialog.py` | 528 / 783 | 标定数值核心（解仿射、残差）/ Tk 向导（三模式） |

- 线程模型写死在 `host_gui.py:1-13`：**界面线程只 `after(30ms)` 轮询事件队列，绝不跨线程碰控件**。
- 六页：四轴控制 / 舵机夹爪 / 参数(13 项) / 动作序列 / **视觉目标** / 原始日志（`host_gui.py:448-472`）。
- 与固件逐项对齐（版本、96 字节、E01–E13、13 参数默认值、`hello` 免缓存、`!` 即停）；
  唯一差异：会话缓存槽 PC 16 vs 固件 4 → 大轮次循环中相对位移有理论重复执行窗口。
- 真机证据：`ghr/10.15/上位机/logs/readback-20261017-174030.jsonl` 证明 **hello 握手通**，
  但 3 轮×4 轴×3 种的 `motor_query` **全 E04** → 四轴回读线在真机上没通。
- 夹紧角以代码为准：**135°=夹紧（180-45），180°=松开**；早期文档"夹紧 0°"是错的。

---

## 5. 视觉 `new_eye/`（报告：`03-vision.md`）

- **入口**：`gui.py`（1240 行）是唯一生产入口；`main.py`(68) 是早期无界面原型；`vision.py`(145) 是旧版。
- **链**：四点单应（左上→右上→右下→左下，`gui.py:252`）→ 700×700 → 候选撒点 → SAM 细化
  （`auto_segment.py` 247 行，权重 `models/sam_b.pt` 357.7 MB）→ 反投影 bbox → 双摄一对一融合（`fusion.py` 143 行，
  MAX_DIST 0.18、颜色惩罚 0/.03/.10）→ 规则分类（`classify.py` 298 行，HSV 中值 + 圆度/顶点/长宽比/实心度）→ JSON。
- **输出**：`runtime/latest_targets.json`，`schema_version=5`，u/v ∈[0,1] 左上原点，`motion_authorized` 恒 false。
- **通讯**：`link.py`(343) TCP 5055 JSON Lines + UDP 5056 beacon + 串口 0xAA55/CRC16；机器人端 2 s 无帧必须停车。
- **性能**：SAM 799 ms 占整帧 1.06 s，实测 **0.98 fps** → 只能"看一眼→规划→动"，不能闭环。
- **三处常见误判**（读代码前必看）：
  1. `pixels_per_mm` 是**死键**（全仓无代码读取），实际用归一化 u/v + `tray_calib.py` 二维仿射；
  2. **Z 高度不在 new_eye**，全在 `vision_grasp.json` 人工示教（当前全 0）；
  3. 没有 YOLO-World、没有 Qwen 模型——"Qwen" 只是被复用的 venv 目录名。

**最硬的未完成项**：`new_eye/tray_calib.json` 的 `residual.dy_pulse` 达 **±3.2 万脉冲**（验收标准 <100），
这份仿射（a=10404.4 / d=-12371.8 / tx=-9263.4 / ty=-50656.1）**不能用于真抓，必须重标**；
另外"分盒扫描（转 60°→识别→累积）"还没做，分类只登记 1 个样本，且 `class_map` 6 条里 4 条类别名是纯数字。

---

## 6. 本地大模型 `Qwen/`（报告：`04-llm-qwen.md`）

- 定位：`Ollama v0.40.5`（便携版，仅 CUDA13/CPU）+ `qwen2.5vl:3b`（默认）/`7b` 的"看图说话"语义复核台；
  不开串口、不动机器，纯只读视觉 + 文件交接。
- 链路：`setup.ps1`（写死 Python312 路径建 .venv）→ `download_runtime.py`（稀疏 Range）→
  `download_model.py`（分片 + SHA256）→ `start.ps1`（`OLLAMA_MODELS`、只监听 127.0.0.1:11434、context 4096、keep_alive 30m）→
  `camera_preview.py`(599，三后端：台面增强/YOLO-World/台面分离+手工框) → 单件白底裁剪 → `recognize.py`(138，强制 JSON Schema、
  温度 0、非法 JSON 重试 1 次、类别白名单、图片注入防护) → `recognitions.jsonl` + 原子写 `vision_targets.json`(schema 1)。
- 实测：冷启 59.5–62.7 s、热 0.8–2 s；最近批次 6 件中 4 件输出"未知"，有误判且 `uncertain=false` → 只能当复核参考。
- **最大问题（已核实）**：上位机 `vision_import.py:22` 已改读 `new_eye/runtime/latest_targets.json`（schema 4/5），
  Qwen 的 schema 1 像素交接文件**已无人消费**；`test_vision_pipeline.py` 与 `deployment-status.md:16` 的"契约测试通过"均已过期；
  `deployment-status.md:39`"服务仍运行"也过期（当前无进程、11434 未监听）。
- 磁盘：33 GB 中约 17–18 GB 是 `downloads/`+`cache/` 可清缓存；7b 另占 5.97 GB 文档未报。
- 若保留，正确接法是**把 `recognize()` 当库调用**，而不是再维护一份 schema 1 交接文件。

---

## 7. 队友参考：`xrw/例35`、`例36`（报告：`05-refs-docs.md`）

- **例36** = 按键 + Z 轴单段升降的最小闭环：`FE 停 → F3 使能 → 等 500 ms → PA0 按下 → FD 上升 20 圈 → 等 7 s → FD 下降`。
  参数集中在 `app_config.h`（RPM 300 / ACCEL 128 / 3200 脉冲每圈 / 20 圈 / 等 7000 ms），并附 20 多条 `#error` 编译期自检。
  **主工程的 PA0 内部下拉、上电时序、FD 只发一次、地址 Z1 / 托3 / X4 / Y5 都来自它。**
- **例35** = 最完整流程：USART1 收视觉坐标（`"1,120,-30,45.6"` = 编号,X偏差,Y偏差,深度）→ 比例式 XY 接近跟随
  （>8 px 走速度模式，±8 px 内 FE 停，600 ms 无新坐标自动停）→ Z 下降 40 圈 → 舵机 180° 夹 → 上升 → XY 开环回起点
  → 托盘六工位 0/60/…/300°（脉冲 0/533/1067/1600/2133/2667，FD 绝对位置 raF=1）→ 下降取放。
  **主工程没有继承视觉、舵机抓夹时序、托盘转位、X/Y 联动** → 机械臂主线是半成品。
- `backup_before_<标签>_<日期>_<时间>` 共 76 个（例35 44 + 例36 32），是调试编年史，`.gitignore:50` 排除，不必读。

---

## 8. 交付快照 `final/`（报告：`06-final.md`）

- 是什么：**2026-10-21 01:06 冻结**的「new_eye 视觉 + 10.15 上位机」一体化包，393.7 MB（357.7 MiB 是 `sam_b.pt`）。
- 怎么拼：`final/main.py:24-28` 把 `new_eye/` 与 `上位机/` 插进 `sys.path`，先建 `host_gui.App`（6 页），
  再插「视觉」(index 0) 与「X/Y 标定」(index 2) → **8 页单窗口**；视觉页以 `embedded=True, ctrl=app` 寄生、
  直接借上位机 client 点动；视觉 import 失败只降级成红字说明页（`:42-52`）。
- 纯拷贝：`docs/` 7/7、固件源码、`ghr/10.15` 非上位机部分 hash 全同；`new_eye` 14 同 / 7 异 / 2 缺。
- **只存在于 final 的代码（根目录没有，别丢）**：`gui.py` +181 行嵌入化、`host_gui.py` 开机回基准、
  `vision_import.py` 基准拦截 + 切标定页、新增 `home_route.py`/`home_route.json`/`calib_tab.py`/`tests/test_home_route.py`。
- **反向漂移**：根目录 `link.py` 多网卡 beacon 修复、`无线组网联调.md`、`link_demo.py` 不在 final；
  `final/runtime` 缺 `calib_marks.json`；`vision_grasp.json` 示教值全 0。
- 结论：**交付快照 + 一体化分支的唯一封存点，不是主线**（冻结后根目录又开发了 19 小时）。
  继续开发前应先把那 6 个文件回流根目录，并跑 `python -m unittest discover -s tests`。

---

## 9. 屏实验 `ghr/10.17`、`ghr/10.19` 与 `build/`

- `ghr/10.17`：最小点屏验证（软件 SPI + 手写 `tft.c`/`tft_init.inc`/`tft_font.h` 8×16 ASCII），ST7735S 128×160，0E/0W，**未下载实物**。
- `ghr/10.19`：完整液晶实验（厂家 `lcd_init.c`/`lcd.c`/`lcdfont.h`），跑纯色/彩条/灰度/渐变/彩虹/方格 + 图片；
  `MY/pic.h` 258936 B（`gImage_pic[40960]` 占 Flash）；`tools/img2c.py`(3911B) 图片转 C 数组，可直接复用于赛项"显示屏显示货物图片"。
- ⚠ **矛盾**：10.17 是 `2 PC5/RESET、3 PB14/DC`，10.19 是 `6 PB14/RES、7 PC5/DC`，正好互换，需实物核对。
- `build/uv4_*.log` 4 份：编译器都是 `V5.06 update 6 (build 750)`；**唯一一份 10.15 的日志是失败的**——
  13 条 `error - cannot create command input file '.\objects\xxx.__i'`（`Objects/` 被 `.gitignore:31` 排除，新克隆必然没有）；
  3 份成功的 `Code=2718 RO=490 RW=24 ZI=1024` 其实属于 **10.17/10.19 屏工程**。
  → **仓库里没有 10.15 主固件"编译通过"的日志证据**（`Project/Objects/` 里有 10-21 的 0E0W 产物和 build_log，但那是被 gitignore 的本地产物）。

---

## 10. 赛题：这是「智能分拣」，不是搬运/救援（报告：`05-refs-docs.md` §1）

来源 `newpdftext.txt`（官方规则 556 行，冲突以它为准）、`pdftext.txt`（命题解析 643 行）。
- 智能救援**明文禁止抓取**（`newpdftext.txt:511`）→ 机械臂方案直接违规；智能搬运需移动底盘 + 2400×2400 场地 → 无底盘，排除。
- 智能分拣硬约束：外形 ≤**350×350×450 mm**（`:270`）、**六个储物盒**（`:271`）、托盘 ≥160×160 且边缘 ≥10 mm（`:273`）、
  占场地 500×500（`:282`）、货物 ≤40 mm 方形、初赛 ≥12 件/≥6 类（`:285-287`）、
  **必须有仅显示功能的高亮屏显示序号/名称/图片/数量**（`:257-258`）、
  **一件分拣存好且屏显示完才可下一件**（`:331-334`）、超 **15 秒**无动作无显示本轮结束（`:334`）、
  **一键启动不得遥控**（`:330`）、单一内置电源不可更换（`:263`）、允许笔记本通讯但运行中不得触碰（`:261`）、两次机会取最好（`:341`）。
- 计分：1 件 2 分；同形同色同盒每件 5 分；错放 0 分（`pdftext.txt:409-411`）；总分 P=A×20%+B×10%+C×70%。
- 对项目意味着：托盘地址 3 的六工位（0/60/120/180/240/300°）天然就是六盒选择机构；双相机俯视就是货物识别；
  **缺件 ① 高亮显示屏（10.17/10.19 的驱动可补）、② 一键启动 + 15 秒节奏（现为 PA0 多按 + 固定等待）；风险 ③ 350×350×450 包络需实测。**

---

## 11. 三条铁律 & 约定（新人/新会话必读）

1. **模块实现写在 `Drive/Include/*_inline.h`**，`main.c` 里的三行 include 就是实现；`gripper.c`/`stepper.c` 是参考副本，
   加进 Keil 会 `Multiply defined`；**别从外部改 `.uvprojx`**（Keil 保存会用内存旧列表覆盖，已发生两次）；
   `uvoptx` 被 gitignore，每人自己选调试器。
2. **PA0 必须 `GPIO_PuPd_DOWN`**（按下读到高），`KEY_DEBOUNCE_MS=20`、`KEY_TASK_MS=1`，先松开才认下一次按下。
3. **编码不批量转码**：GBK=`MY/main.c`、`MY/main_diag.c`、`MY/stm32f4xx_it.c`、`Drive/Source/delay.c`、`led.c`、`delay.h`、`led.h`；
   其余多为 UTF-8。改 GBK 文件要写回 GBK（`read` 会报 `invalid UTF-8`）。
4. 提交前：Keil Rebuild **0 Error 0 Warning** + 上板实测 + `git status` 无 `Objects/`/hex/axf；
   密钥 `D:\study\git\key\id_ed25519` 唯一且**绝不入库**；主循环里不许长 `Delay_ms`。
5. 环境：Keil MDK V5.39 + ARMCC **V5.06 u6**（禁 AC6），`D:\study\keil\UV4\UV4.exe -b <uvprojx> -j0 -o <log>`；
   多份文档写死绝对路径 `D:\study\project\robot-competition`，**整项目要克隆到同一路径**。

---

## 12. 风险评估：按"会不会毁掉一场比赛"排序

| 级别 | 风险 | 证据 |
|---|---|---|
| 🔴 致命 | **X/Y 标定不可用**：残差 ±3.2 万脉冲（要求 <100）→ 抓取位置全错 | `new_eye/tray_calib.json:44-75` |
| 🔴 致命 | **Z 示教全 0**：`vision_grasp.json` 的 safe/grasp/lift/place 全是 0 → 真机必撞 | `ghr/10.15/上位机/vision_grasp.json`、`final/.../vision_grasp.json` |
| 🔴 致命 | **未上板验证**：USB CDC 从未枚举、四轴联动无记录、视觉抓取序列从未真机跑 | `01-firmware.md` §12、`02-host-app.md` §16 |
| 🟠 高 | 四轴回读硬件并线未通（真机全 E04）；TXD 不能并联，需二极管线与/模拟开关/RS-485 | `logs/readback-20261017-174030.jsonl`、`上位机/README.md:21-69` |
| 🟠 高 | 绝对定位在固件里形同相对（`control_apply_position(..., absolute=0)`），零点靠 PC 软位置记账 | `上位机/README.md:169-181` |
| 🟠 高 | 分拣赛两个强制项缺失：高亮显示屏、一键启动 + 15 秒节奏 | `newpdftext.txt:257-258`、`:330-334` |
| 🟡 中 | 380 与 350 的包络差：需实测整机 350×350×450 | `newpdftext.txt:270` |
| 🟡 中 | 分盒扫描未实现（顶视看不全六盒）；分类只登记 1 样本、4 条类名是数字 | `new_eye/交接文档.md:530-533`、`new_eye/config.json:43-50` |
| 🟡 中 | 集成代码只在 `final/`，主线再开发会丢；根目录网络修复又没进 final（双向漂移） | `06-final.md` §8 |
| 🟢 低 | Qwen 交接文件已成孤儿、文档过期；33 GB 里 17 GB 可清 | `04-llm-qwen.md` §9-10 |
| 🟢 低 | 输出名 `STM32F429` 与芯片 F407 不符（历史遗留）；10.17/10.19 的 RES/DC 互换 | `01-firmware.md` §11、`05-refs-docs.md` §5 |

---

## 13. 文档可信度分层（先看这份，能省很多时间）

| 文档 | 可信度 | 注意 |
|---|---|---|
| `ghr/10.15/交接文档-20261016.md`(467 行) | 高（截至 10-16） | 但"上位机仅方案未实现"已被推翻 |
| `ghr/10.15/交接文档-上位机开工-TypeC-20261016.md`(22 KB) | 高（截至 10-16） | "夹紧 0°"错，应为 135°；"未重新链接"已被 10-21 重编推翻 |
| `上位机方案.md` / `-v2` / `-v3-TypeC-CDC.md` | **v3 才是落地版** | v1/v2 的 USART1 路线、`emm.py`、`config.json` 都没实现 |
| `new_eye/交接文档.md`(767 行) | 高（唯一权威完成度记录） | 已完成/未完成都写得准，建议进度以它为准 |
| `new_eye/标定操作手册.md`(263 行) | 高 | 10 步流程 + 验收标准（残差 <100、误差 <0.02） |
| `Qwen/README.md`、`Qwen/deployment-status.md` | **中/低** | 交接契约、服务状态、模型体积三处过期 |
| `ghr/10.15/上位机/README.md` | 中 | "75 测试"实为 121；"5 页"实为 6 页；但接线/约定章节非常准 |
| `final/README.md`、`final/使用说明.md`(401 行) | 高（仅对 final） | 自称"2026-10-21 快照"，`README.md:160` 也承认真机抓取未验证 |
| 根 `README.md`(92 行) | 中 | **目录树缺 `Qwen/`、`new_eye/`、`final/`**；引脚表准 |
| 根 `交接文档.md`(189 行) | 已过期 | 被 `交接文档-20261016.md` 取代 |
| `环境复刻流程.md`(250 行) | 高（期望值） | 是"应该怎样"，不是"已经验证" |

---

## 14. 十五分钟上手路径

```powershell
# 0) 先看结论：本文件 → .survey/0{1..6}-*.md（谁负责哪块看 §1 表）

# 1) PC 侧（不需要任何硬件，最容易验证）
cd ghr\10.15\上位机
python -X utf8 -m unittest discover -s tests        # 121 用例（本机 120 过 + 1 沙箱 Temp 权限错）
python -X utf8 host_gui.py --sim                     # 模拟后端点一遍六页

# 2) 视觉（需要 Qwen\.venv 的 python + sam_b.pt 357 MB）
& ..\..\..\Qwen\.venv\Scripts\python.exe new_eye\gui.py      # 或 new_eye\run_gui_as_admin.cmd
#    产 new_eye\runtime\latest_targets.json，再回上位机「视觉目标」页点"读取"（不运动）

# 3) 固件（需要 Keil + ST-Link）
D:\study\keil\UV4\UV4.exe -b ghr\10.15\Project\STM32F407.uvprojx -j0 -o build\uv4.log   # exit 0 = 成功
#    烧 ghr\10.15\Project\Objects\STM32F429.hex（正式，闪 1 下）；诊断用 STM32F429_diag.hex（闪 2 下）

# 4) 一体化交付包（不开发，只看现场形态）
final\run.bat            # 或 --sim / --port COM5 --connect / --no-vision / --selftest
```

---

## 15. 建议的下一步（按性价比）

1. **先回流 final 的 6 个文件到主线**（`home_route.py`/`.json`、`calib_tab.py`、`test_home_route.py`、`gui.py`、`host_gui.py`、`vision_import.py`），
   跑一遍 121 用例，避免"改主线丢集成功能"。
2. **重做 X/Y 标定**（用 `标定操作手册.md` 第 3A 步"视觉点标注法"），验收残差 <100；这一步不通，抓取永远是错的。
3. **上板验证 USB CDC**（枚举 → `hello` → 心跳 → 拔插重连），再接四轴回读（先只插 Z，`readback_mask=1`，
   稳定后加一台，最后才考虑二极管线与）。
4. **示教 Z**（`vision_grasp.json` 的 safe/grasp/lift/place/drop），先 `--sim` 空跑，再低速真机。
5. **补赛项强制项**：把 10.19 的 ST7735S 驱动接进主固件做"仅显示"高亮屏；把 PA0 多按流程改成"一键启动 + 15 秒节奏"。
6. **收敛文档**：根 README 补 `Qwen/`、`new_eye/`、`final/`；`上位机/README` 更新测试数与页数；Qwen 文档标注"已停用/孤儿"。
7. 可选：清理 `Qwen/downloads`+`cache` ≈17 GB；决定 Qwen 存废（保留就把 `recognize()` 当库调用）。

---

## 附：子报告索引

| 报告 | 覆盖 | 规模 |
|---|---|---|
| `.survey/01-firmware.md` | `ghr/10.15` 固件全量（含 USB/协议/测试层/构建/漂移清单） | 447 行、92 处引用 |
| `.survey/02-host-app.md` | `ghr/10.15/上位机` + 三版方案 + 真机日志 + 实跑测试 | 229 行、90 处引用 |
| `.survey/03-vision.md` | `new_eye` 数据流/标定/融合/分类/JSON/完成度/风险 | 293 行、94 处引用 |
| `.survey/04-llm-qwen.md` | `Qwen` 部署链路/识别流水线/实测/文档漂移/边界 | 232 行、79 处引用 |
| `.survey/05-refs-docs.md` | 赛题规则/EMM V5 速查/例35-36/编译日志/10.17-10.19/协作规范 | 321 行、176 处引用 |
| `.survey/06-final.md` | `final` hash 矩阵/一体化入口/独有代码/运行时证据/存废判断 | 242 行、48 处引用 |
