2186279865/robot-10.15/02-资料库/05-调研报告/03-vision.md

# 03 · new_eye 双相机视觉子系统

> 调研范围：`new_eye/`（12 个 Python 文件 + 6 篇文档 + 配置/运行时 JSON）。只读调研，证据一律用 `相对路径:行号` 标注（行号为 2026-10-21 实测文件行号）。二进制未阅读：`new_eye/models/sam_b.pt`(357 MB)、`runtime/*.png`、`__pycache__/*.pyc`。

## 0. 一句话定位

new_eye 是整机的"眼睛"：**两路 USB 相机（顶视 + 副摄）→ 各自四点透视校正到统一 700×700 托盘坐标系 → SAM 实例分割 → 规则特征分类 + 双摄融合 → 输出托盘归一化坐标 `(u,v)` 与类别**，写 `new_eye/runtime/latest_targets.json`、可选 TCP 推送。它**从不直接驱动电机**——`motion_authorized` 恒为 `false`（`new_eye/gui.py:780`）。
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
