2186279865/robot-10.15/01-交付包/runtime/calib_refs/cam0_top.jpg

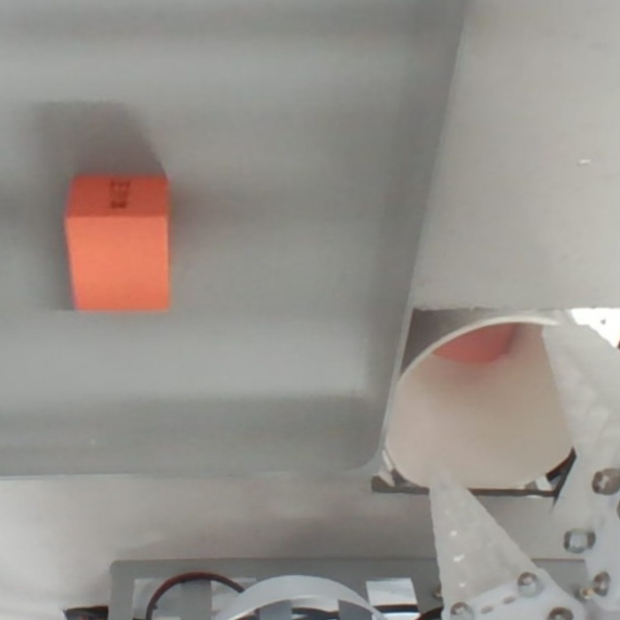
01-交付包/runtime/calib_refs/cam0_top.jpg
