2186279865/robot-10.15/01-交付包/runtime/calib_refs/pos2_cam1.jpg

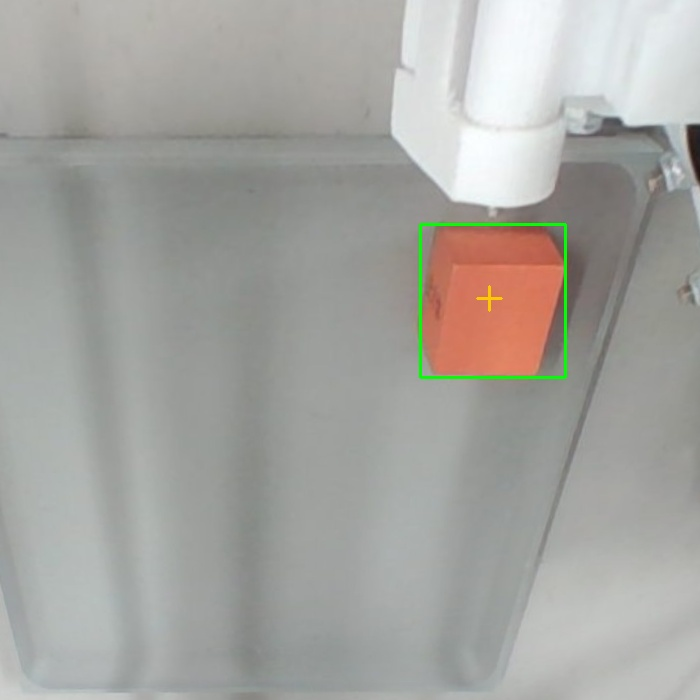
01-交付包/runtime/calib_refs/pos2_cam1.jpg
