2186279865/robot-10.15/01-交付包/runtime/calib_refs/pos2_side.jpg

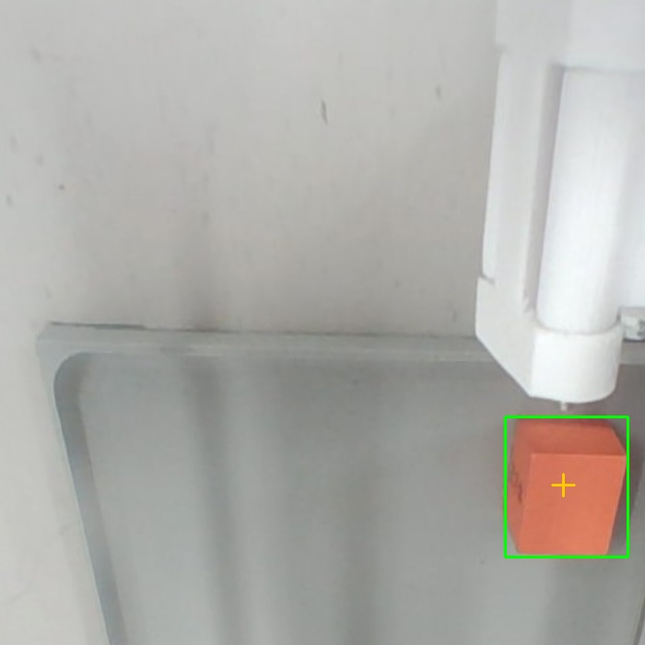
01-交付包/runtime/calib_refs/pos2_side.jpg
