2186279865/robot-10.15/01-交付包/vision/runtime/dbg_split_last.jpg

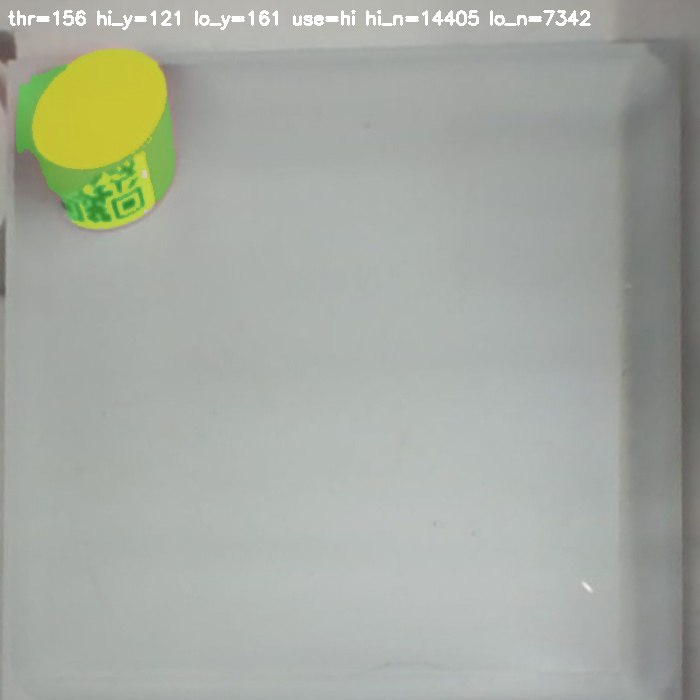
01-交付包/vision/runtime/dbg_split_last.jpg
