2186279865/robot-10.15/01-交付包/vision/runtime/last_top_warp.jpg

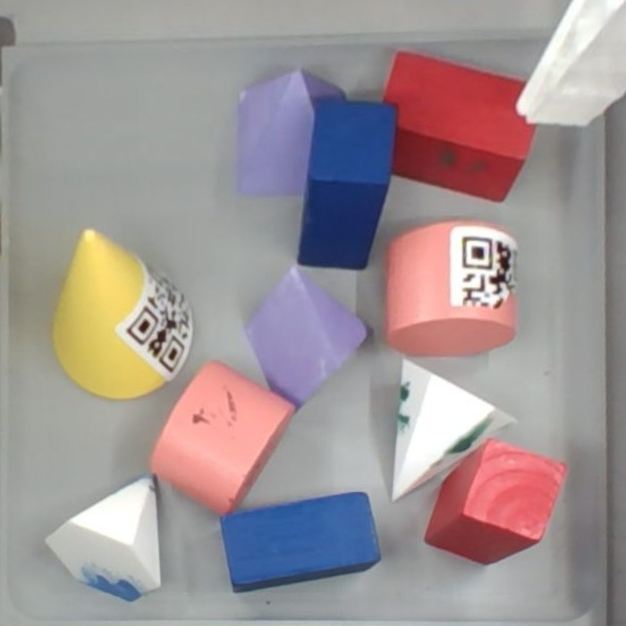
01-交付包/vision/runtime/last_top_warp.jpg
