2186279865/robot-10.15/02-资料库/04-历史快照/final-20261021/ghr/10.15/上位机/_gui_shot.png

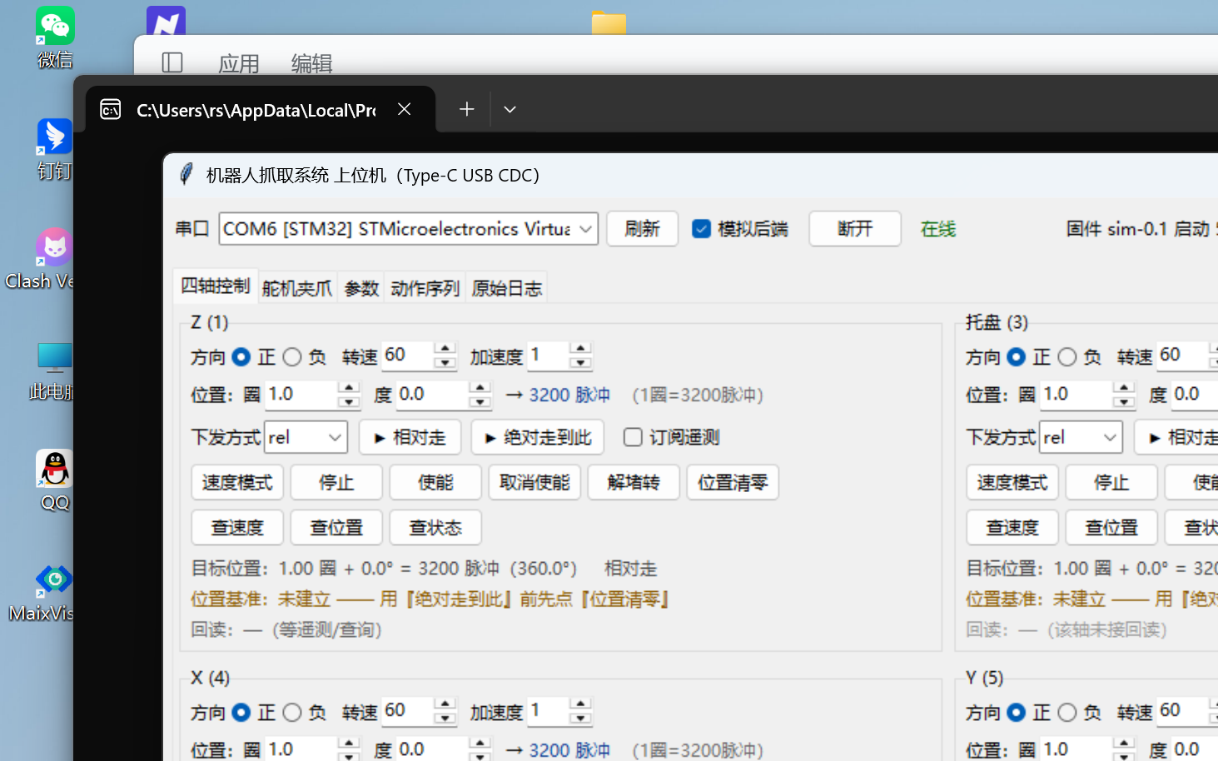
02-资料库/04-历史快照/final-20261021/ghr/10.15/上位机/_gui_shot.png
