2186279865/robot-10.15/02-资料库/04-历史快照/final-20261021/runtime/final_app_vision_targets.png

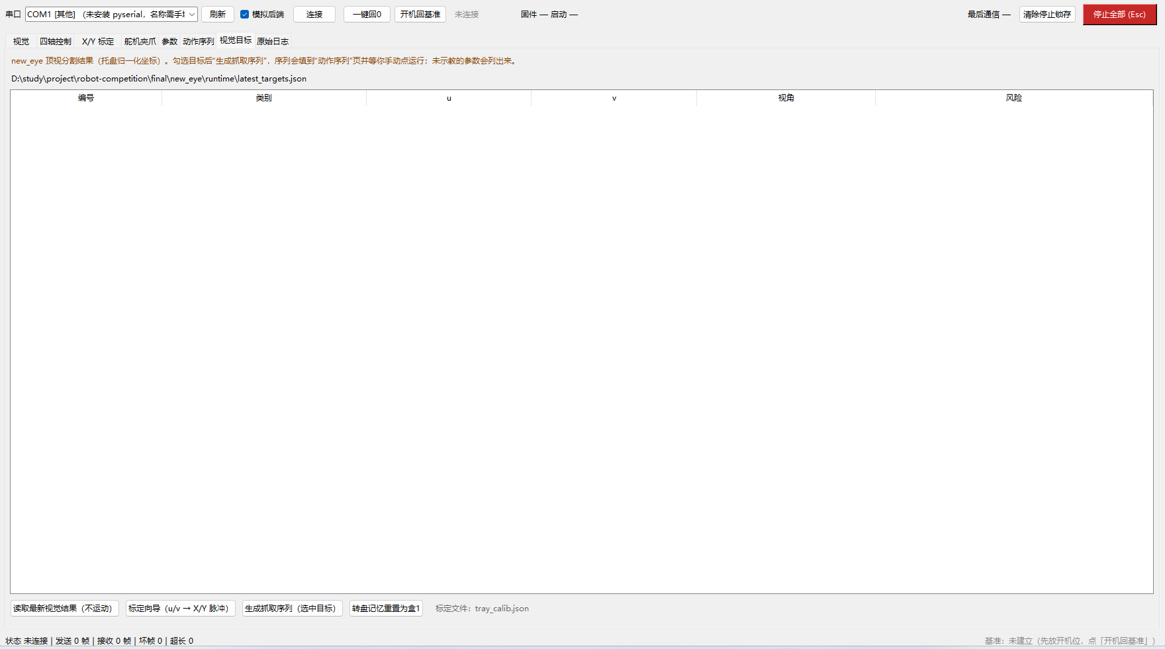
02-资料库/04-历史快照/final-20261021/runtime/final_app_vision_targets.png
