2186279865/robot-10.15/02-资料库/04-历史快照/final-20261021/runtime/home_route_proof.png

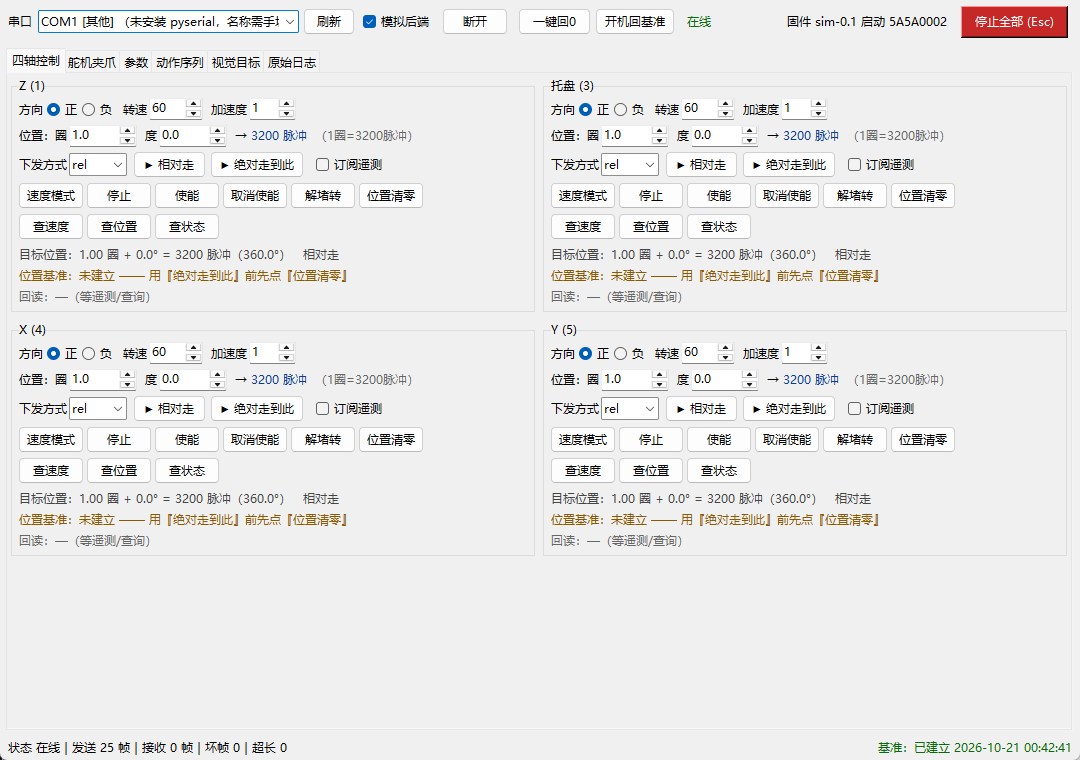
02-资料库/04-历史快照/final-20261021/runtime/home_route_proof.png
