2186279865/robot-10.15/02-资料库/04-历史快照/new_eye-独立视觉/runtime/panel_proof.png

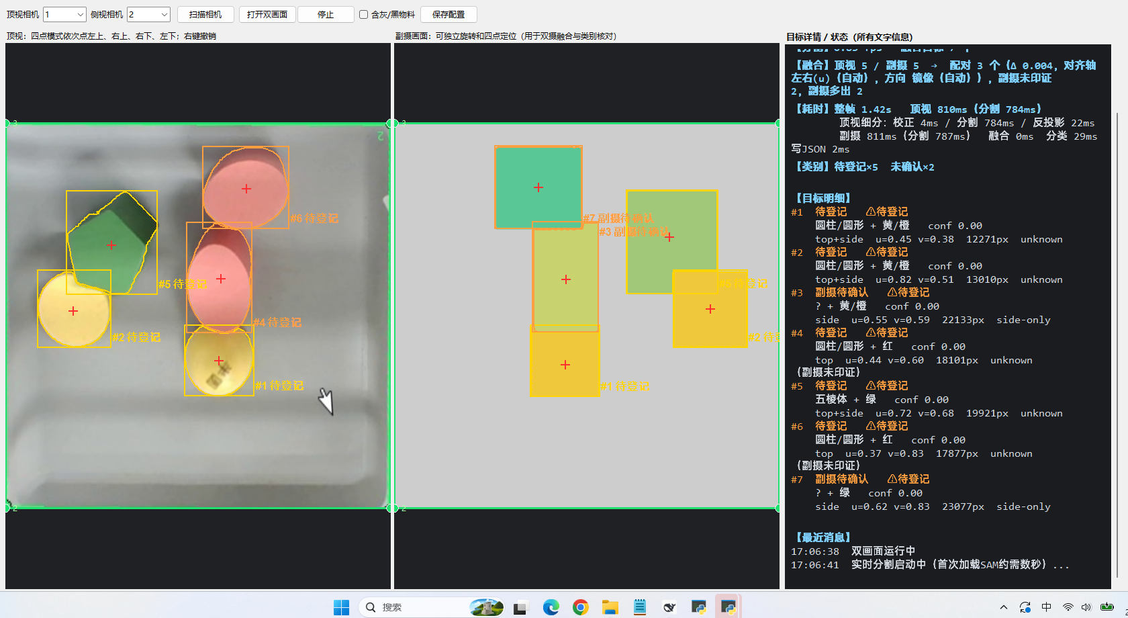
02-资料库/04-历史快照/new_eye-独立视觉/runtime/panel_proof.png
