2186279865/robot-10.15/02-资料库/07-图片与录屏/real_cam1.jpg

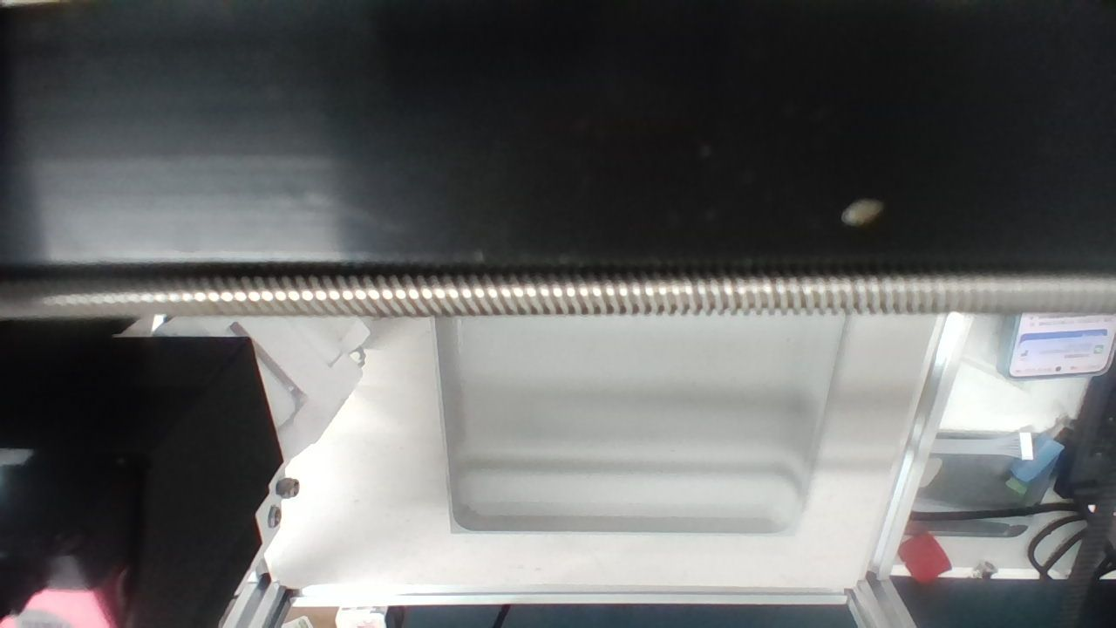
02-资料库/07-图片与录屏/real_cam1.jpg
