2186279865/robot-10.15/02-资料库/07-图片与录屏/selftest_1_视觉.png

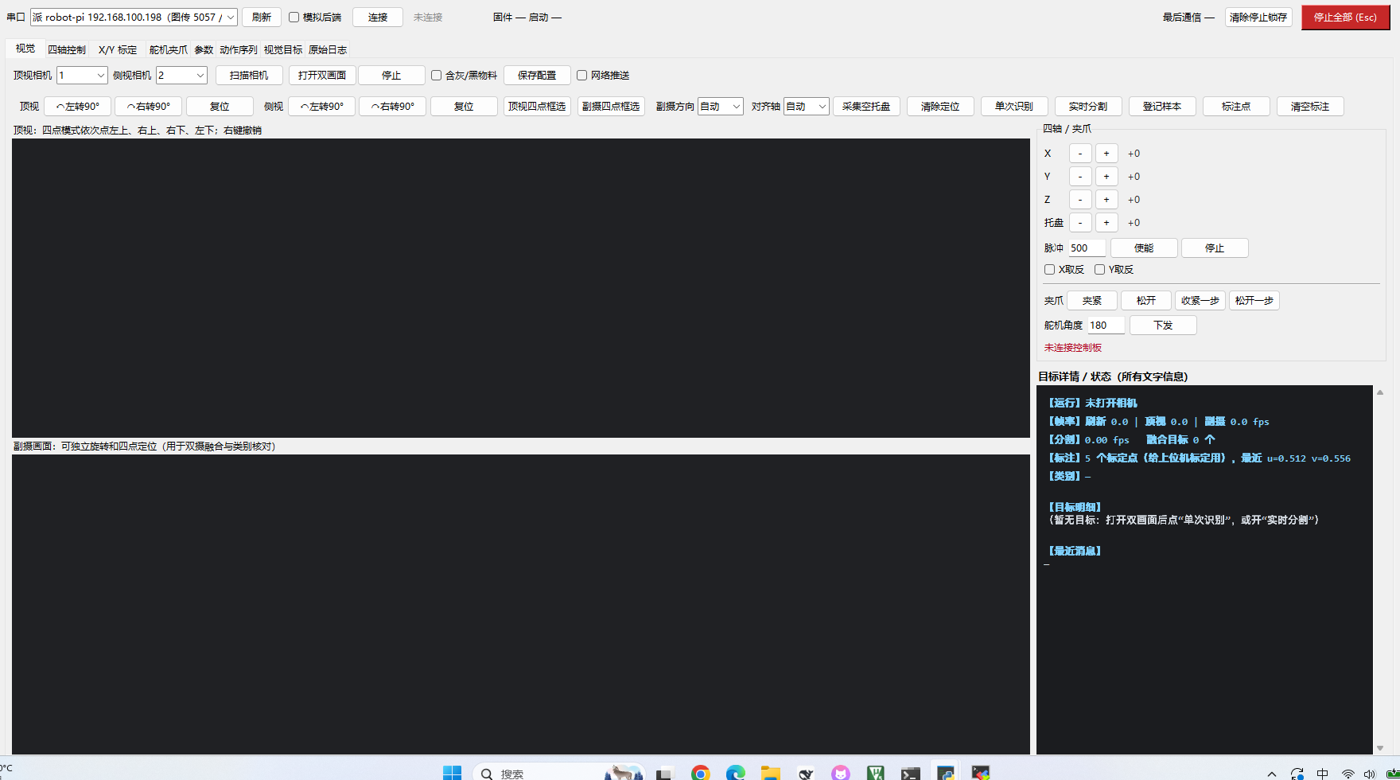
02-资料库/07-图片与录屏/selftest_1_视觉.png
