2186279865/robot-10.15/02-资料库/07-图片与录屏/selftest_7_视觉目标.png

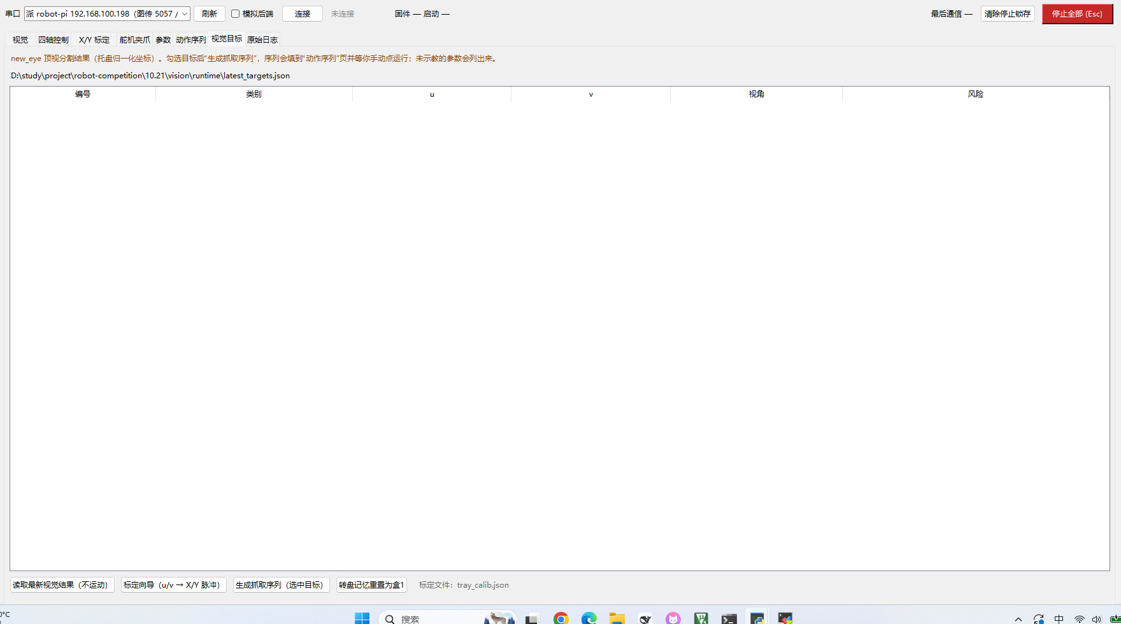
02-资料库/07-图片与录屏/selftest_7_视觉目标.png
