2186279865/robot-10.15/02-资料库/07-图片与录屏/wifi_control_connected.png

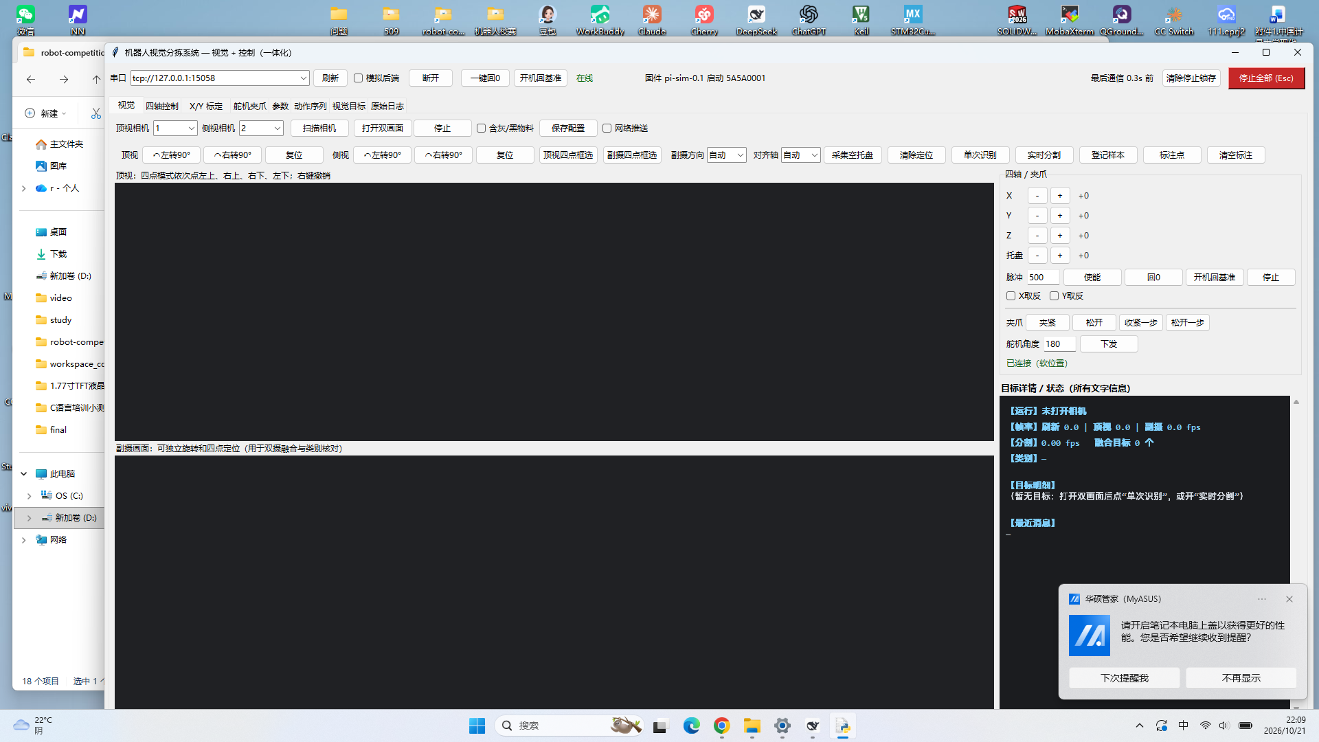
02-资料库/07-图片与录屏/wifi_control_connected.png
