2186279865/robot-10.15/02-资料库/派端屏-实拍-20261031-0745.png

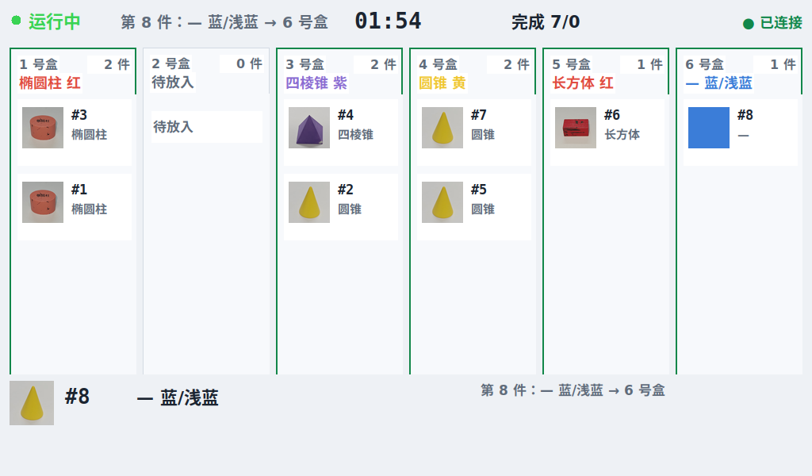
02-资料库/派端屏-实拍-20261031-0745.png
