2186279865/robot-10.15/02-资料库/派端屏-预设图-20261031.png

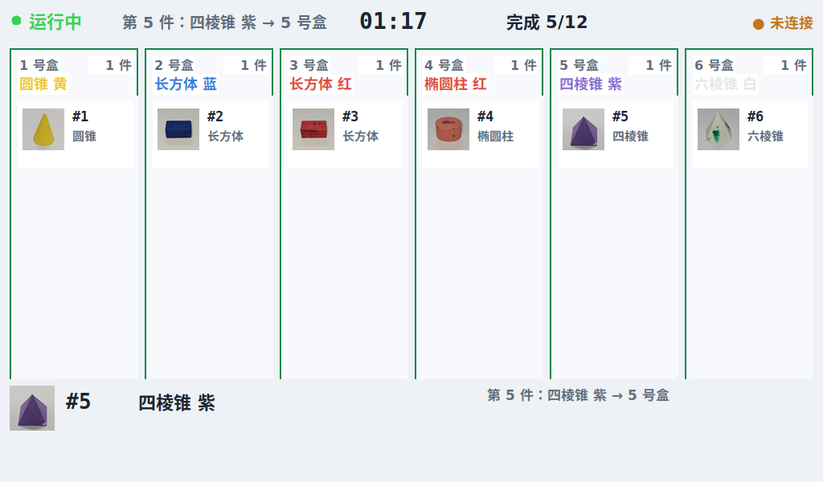
02-资料库/派端屏-预设图-20261031.png
