2186279865/robot-10.15/10.21/runtime/real_cam0.jpg

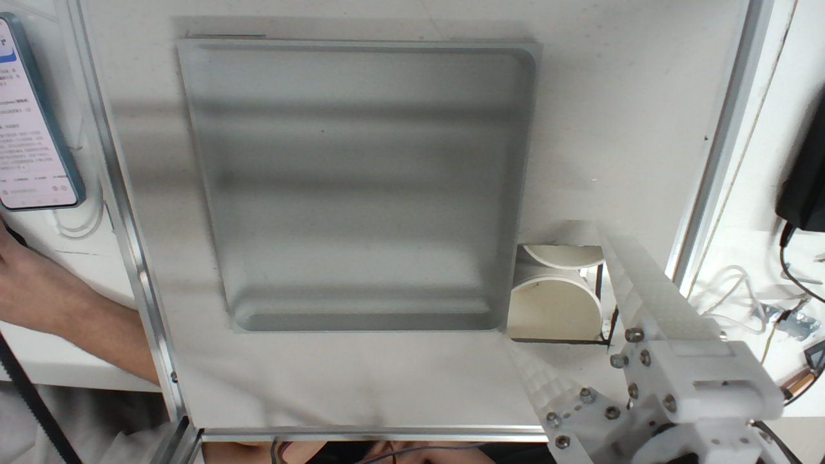
10.21/runtime/real_cam0.jpg
