2186279865/robot-10.15/10.21/runtime/real_new_gripper_grab.jpg

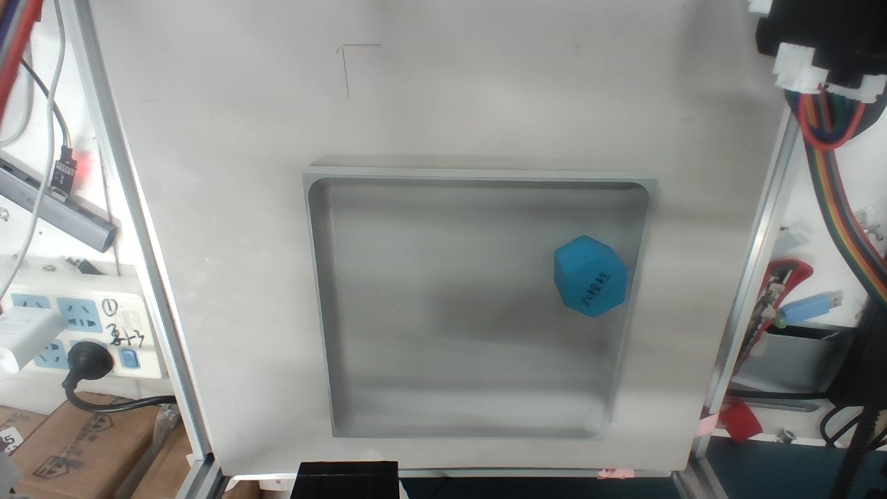
10.21/runtime/real_new_gripper_grab.jpg
