2186279865/robot-10.15/10.21/vision/runtime/empty_background.png

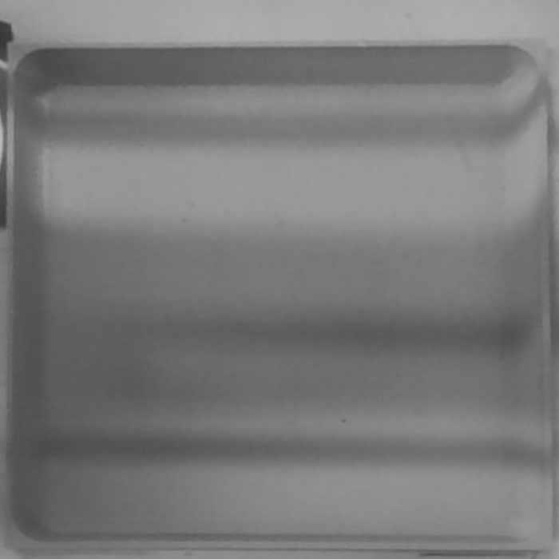
10.21/vision/runtime/empty_background.png
