2186279865/robot-10.15/codex/datasets/user_geometry_reference/source.jpg

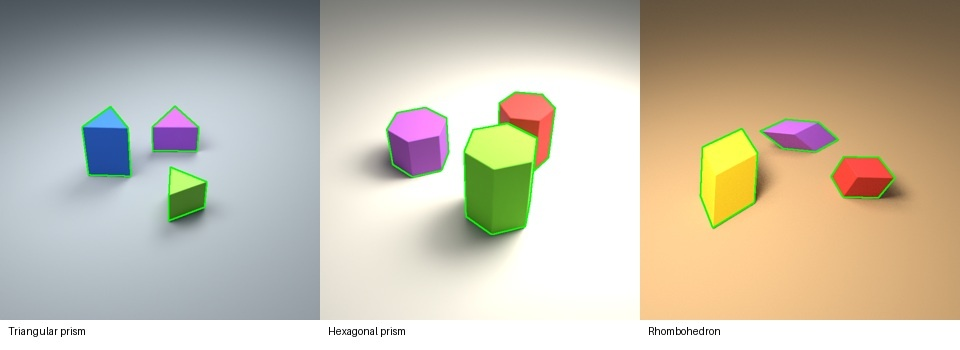
codex/datasets/user_geometry_reference/source.jpg
