2186279865/robot-10.15/codex/datasets/user_geometry_reference/without_captions.png

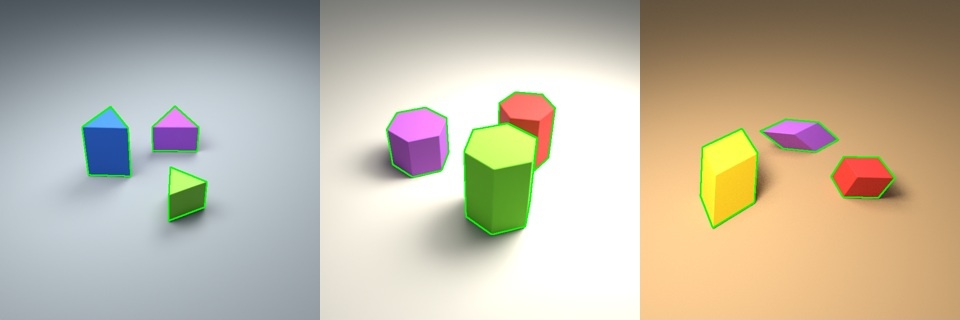
codex/datasets/user_geometry_reference/without_captions.png
