2186279865/robot-10.15/codex/output/project_report_work/final-render-v6/contact.png

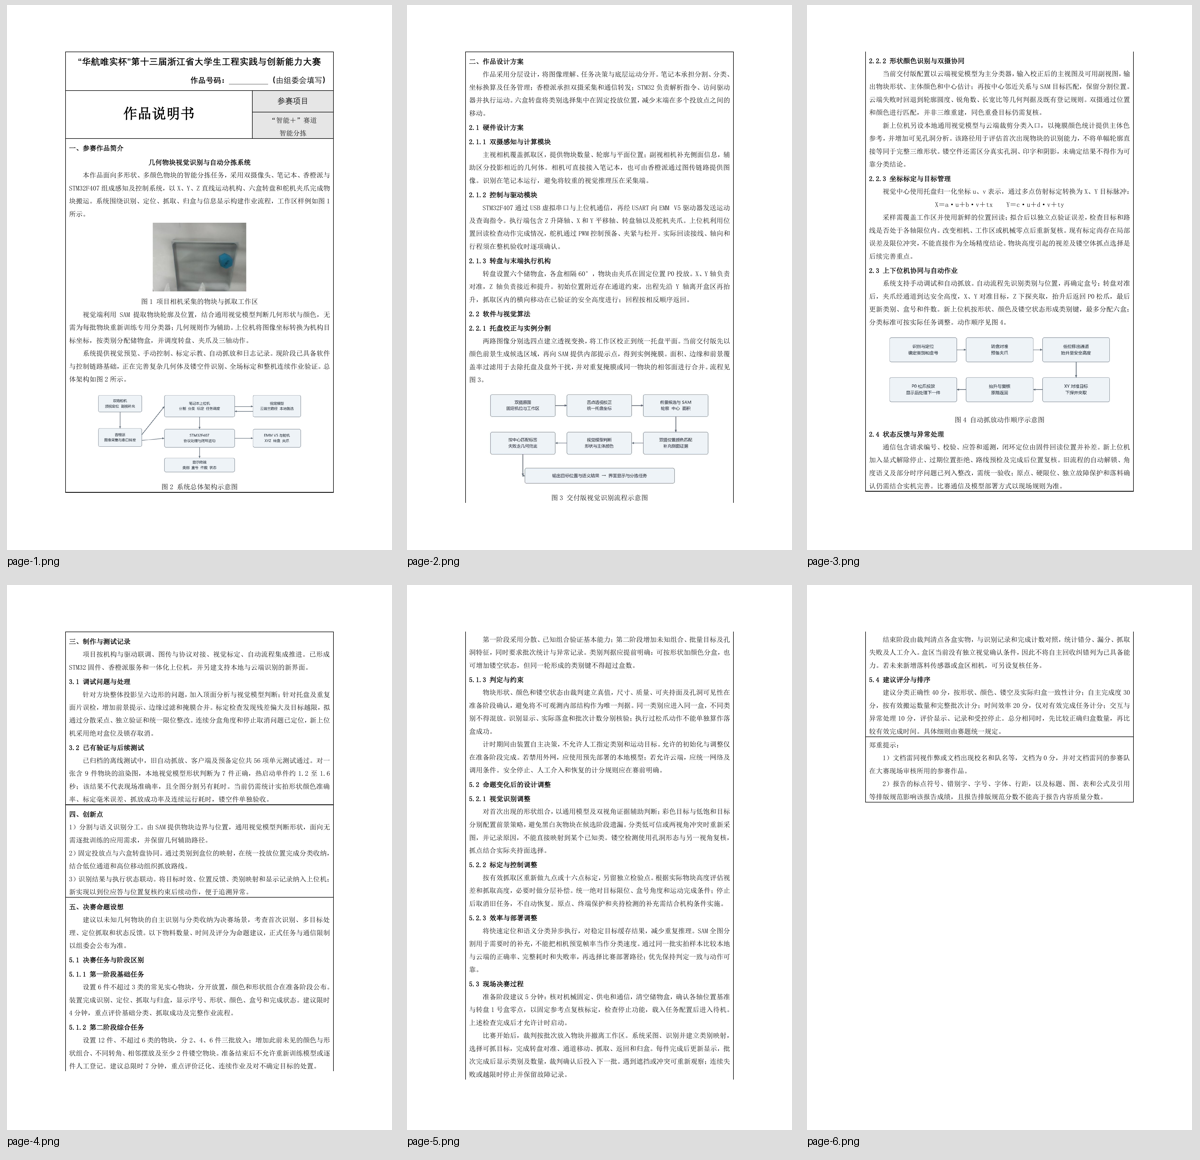
codex/output/project_report_work/final-render-v6/contact.png
