2186279865/robot-10.15/codex/output/project_report_work/template-4.png

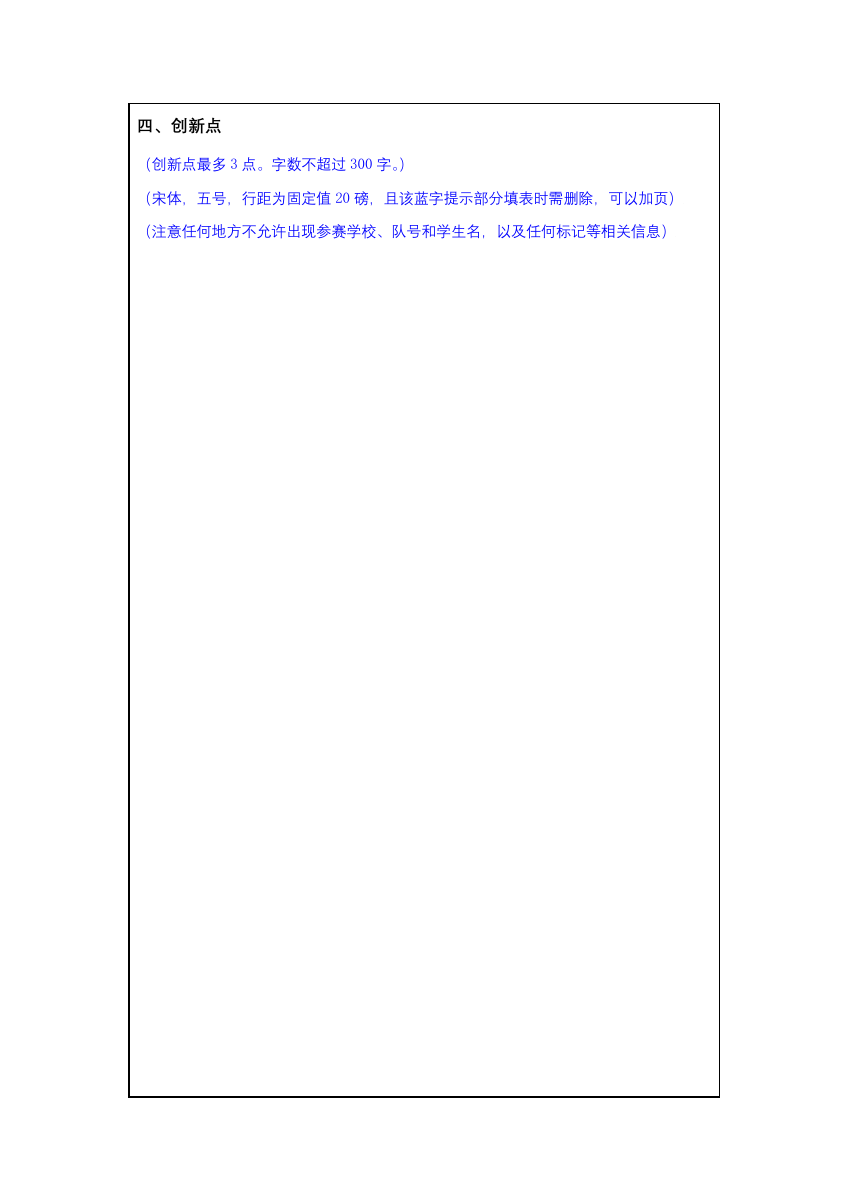
codex/output/project_report_work/template-4.png
