2186279865/robot-10.15/codex/output/project_report_work/template-6.png

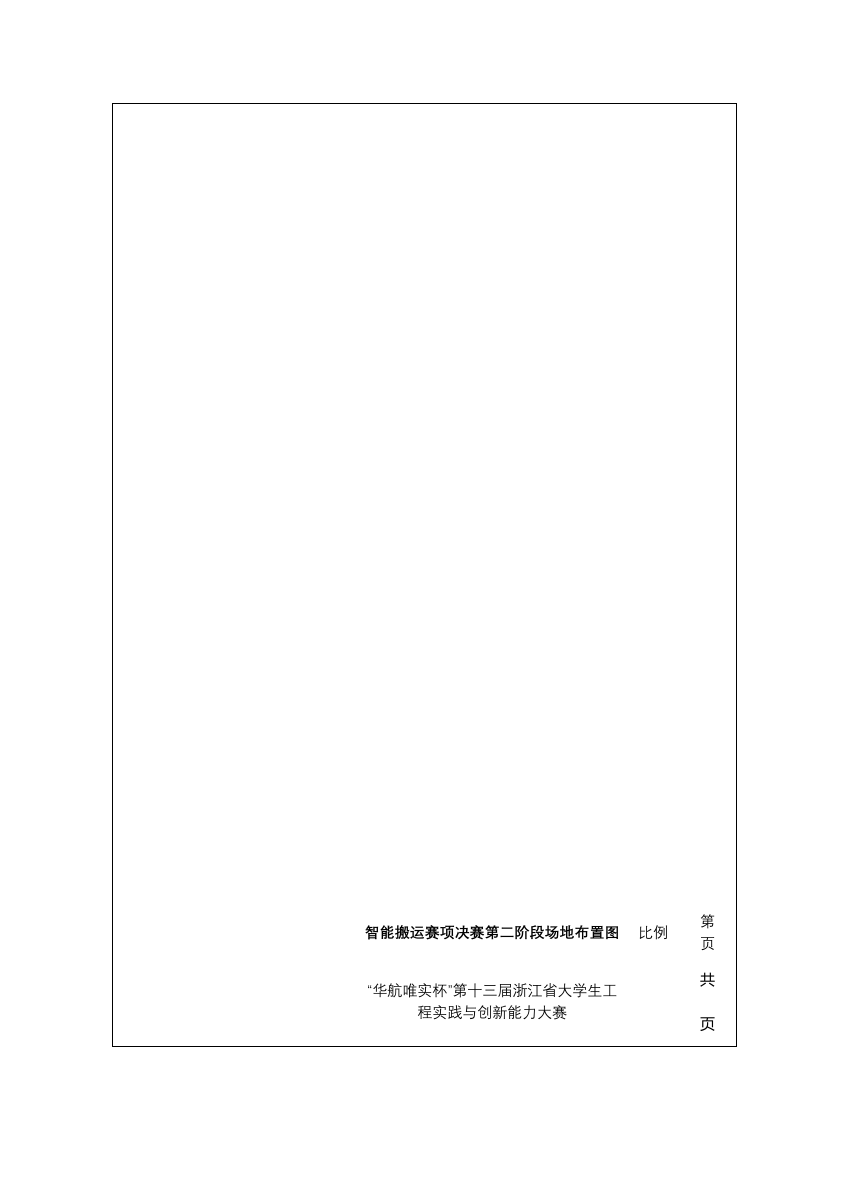
codex/output/project_report_work/template-6.png
