2186279865/robot-10.15/codex/output/project_report_work/template-fidelity-final/b_render/page-3.png

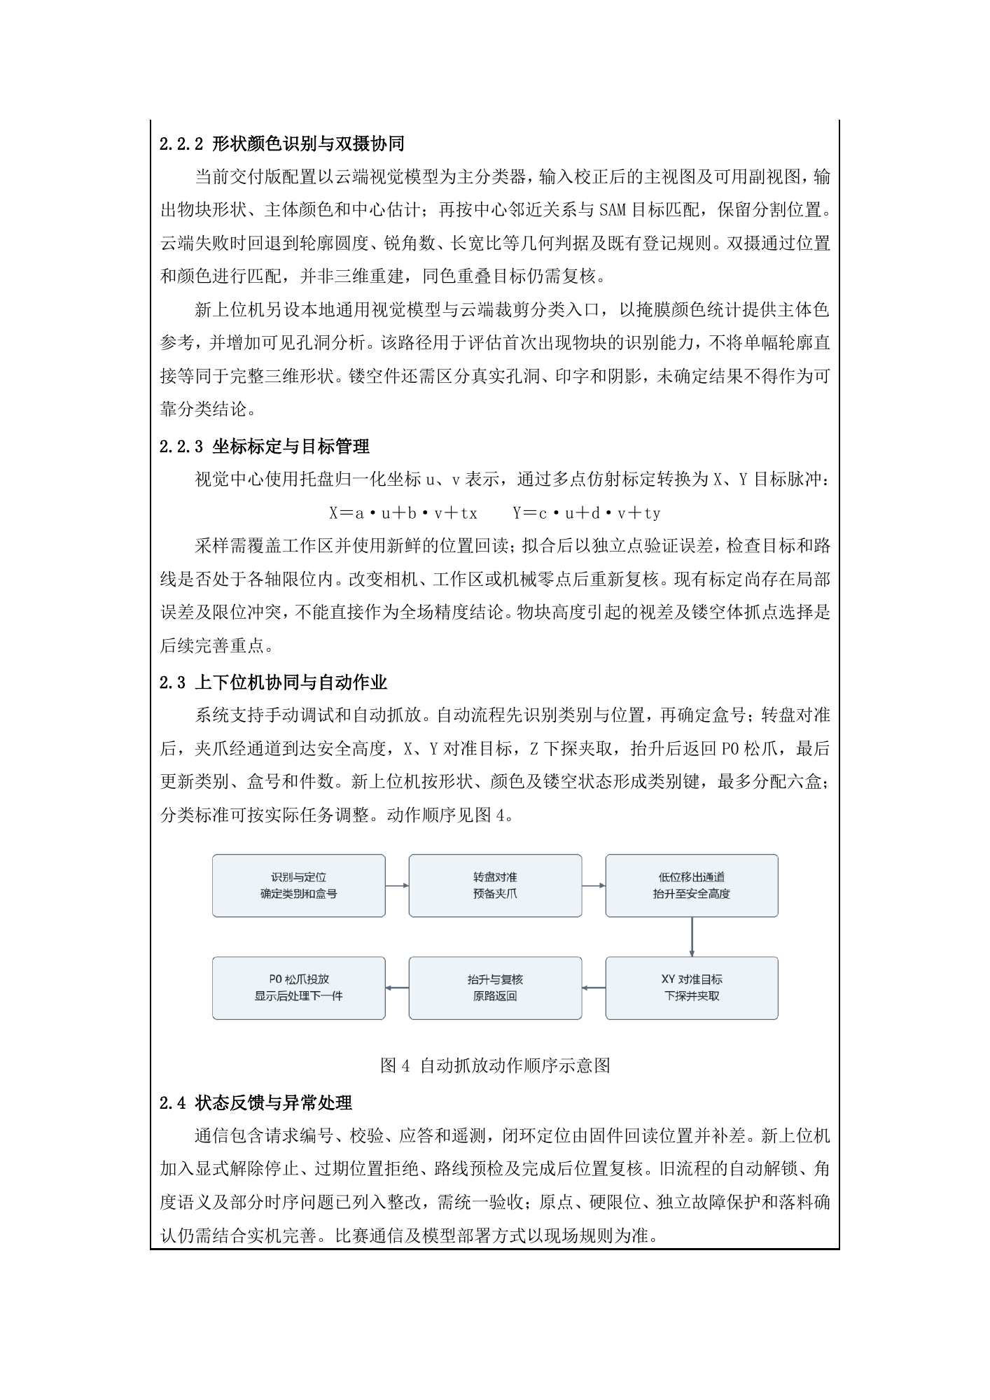
codex/output/project_report_work/template-fidelity-final/b_render/page-3.png
