2186279865/robot-10.15/codex/output/project_report_work/template-fidelity-final/diff_pages/diff-page-4.png

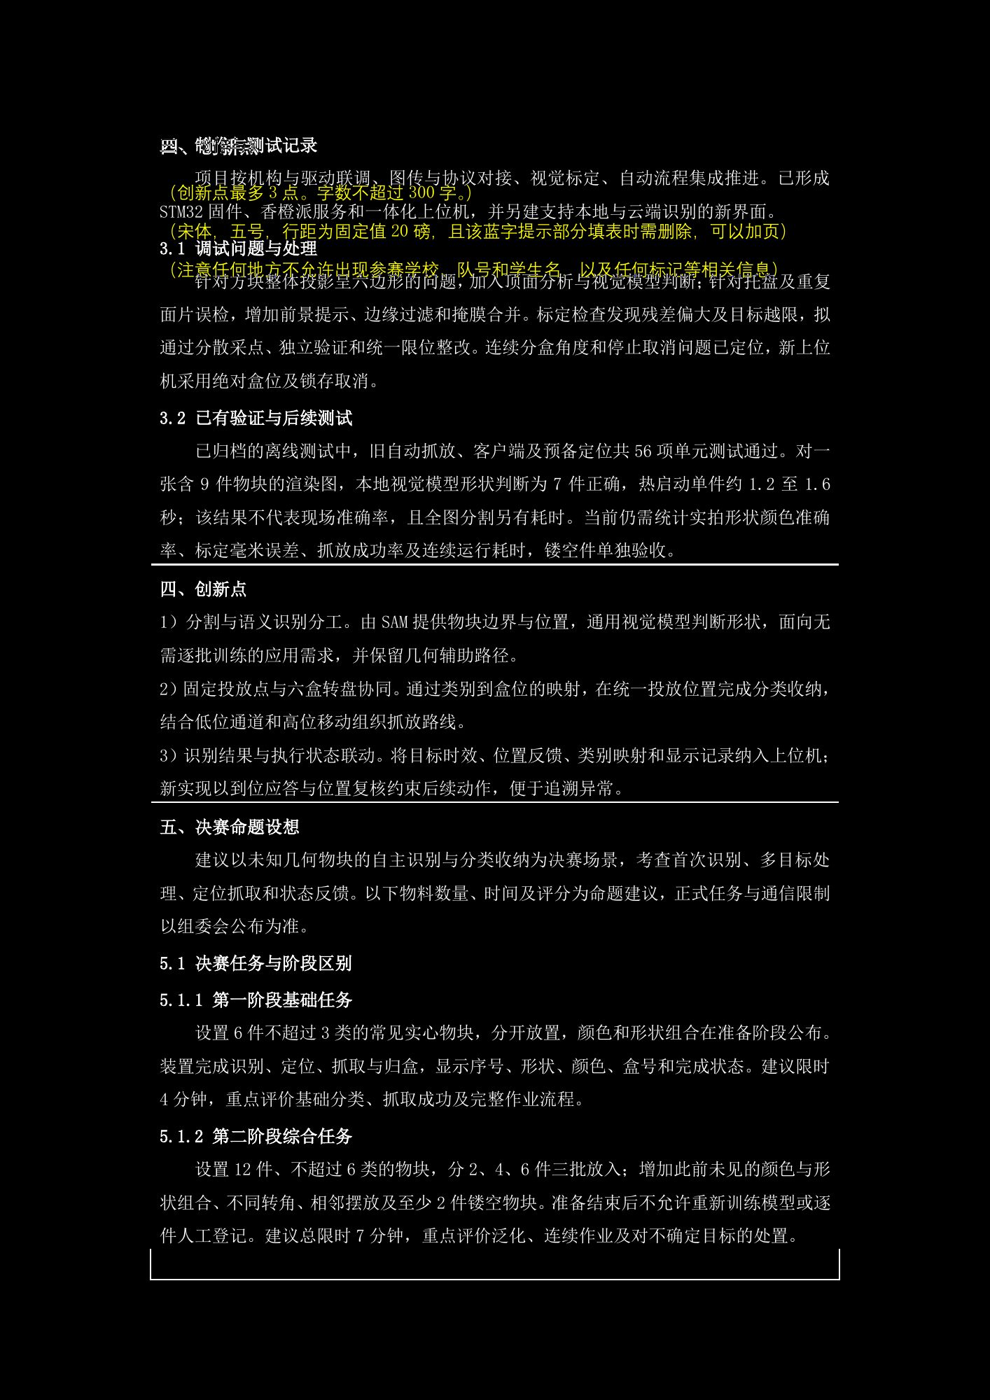
codex/output/project_report_work/template-fidelity-final/diff_pages/diff-page-4.png
