2186279865/robot-10.15/codex/output/project_report_work/workspace.jpg

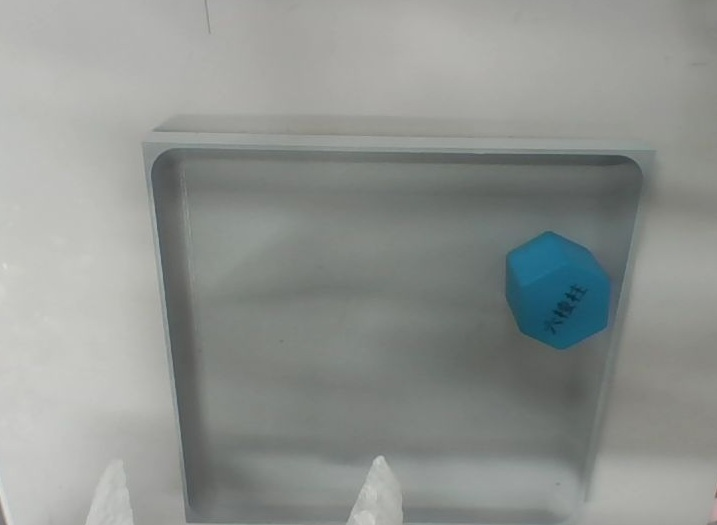
codex/output/project_report_work/workspace.jpg
