2186279865/robot-10.15/final/runtime/final_app_calib.png

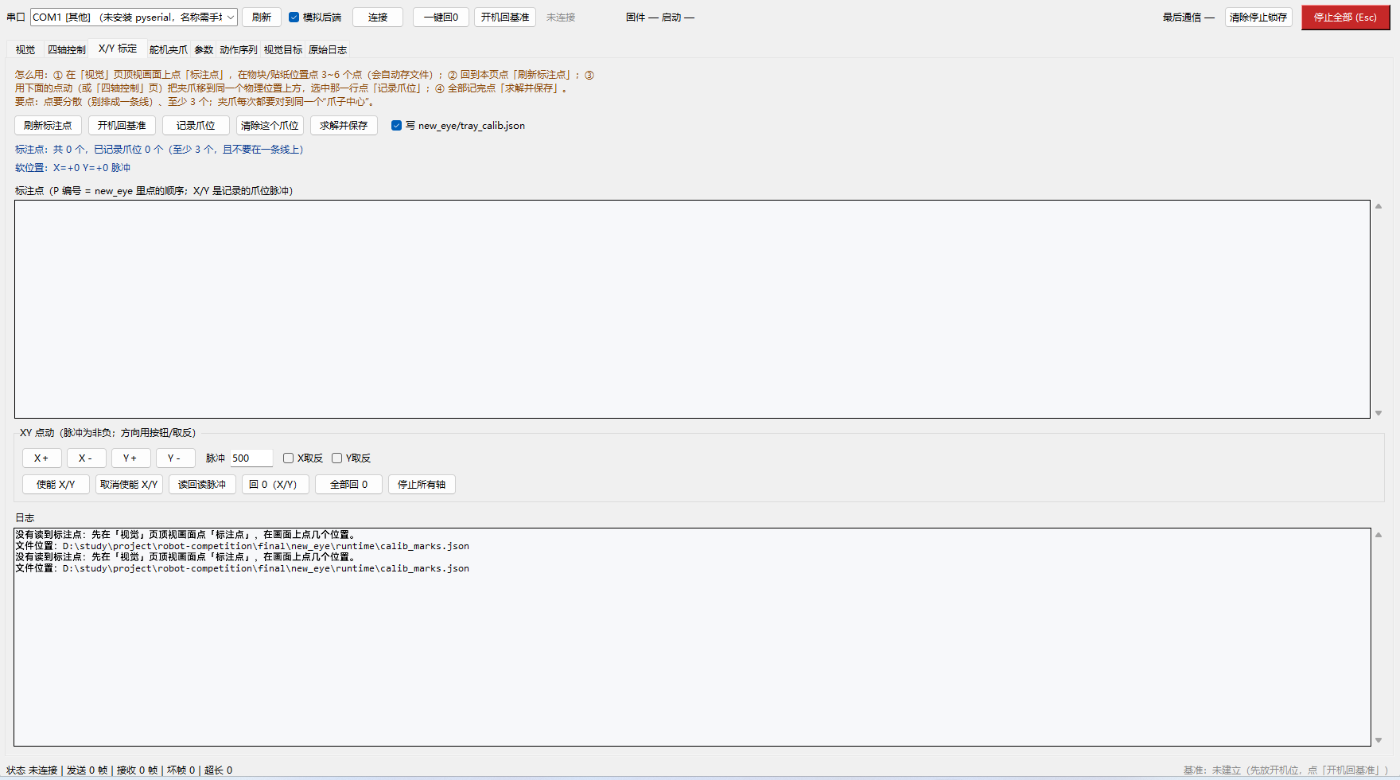
final/runtime/final_app_calib.png
