2186279865/robot-10.15/final/runtime/layout_proof.png

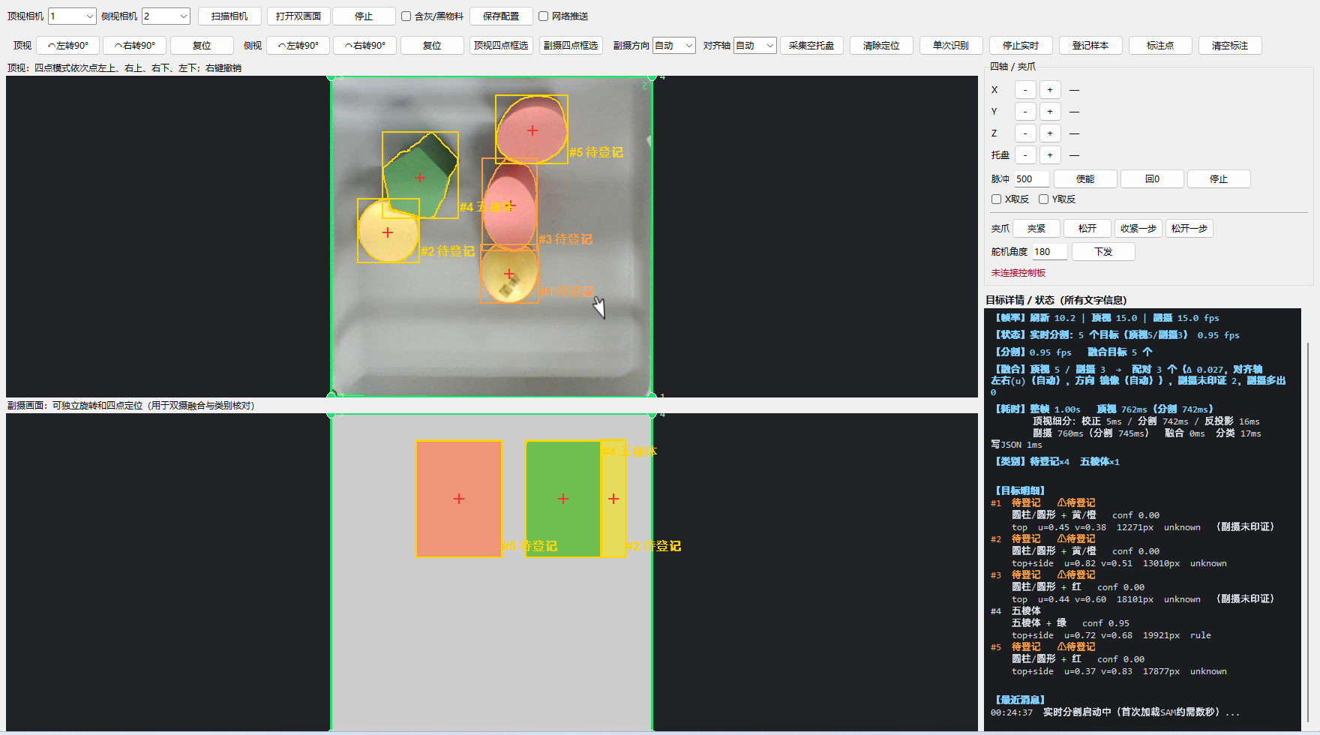
final/runtime/layout_proof.png
