2186279865/robot-10.15/ghr/10.19/tools/demo_preview.png

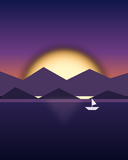
ghr/10.19/tools/demo_preview.png
