2186279865/robot-10.15/new_eye/runtime/calib_dialog_proof.png

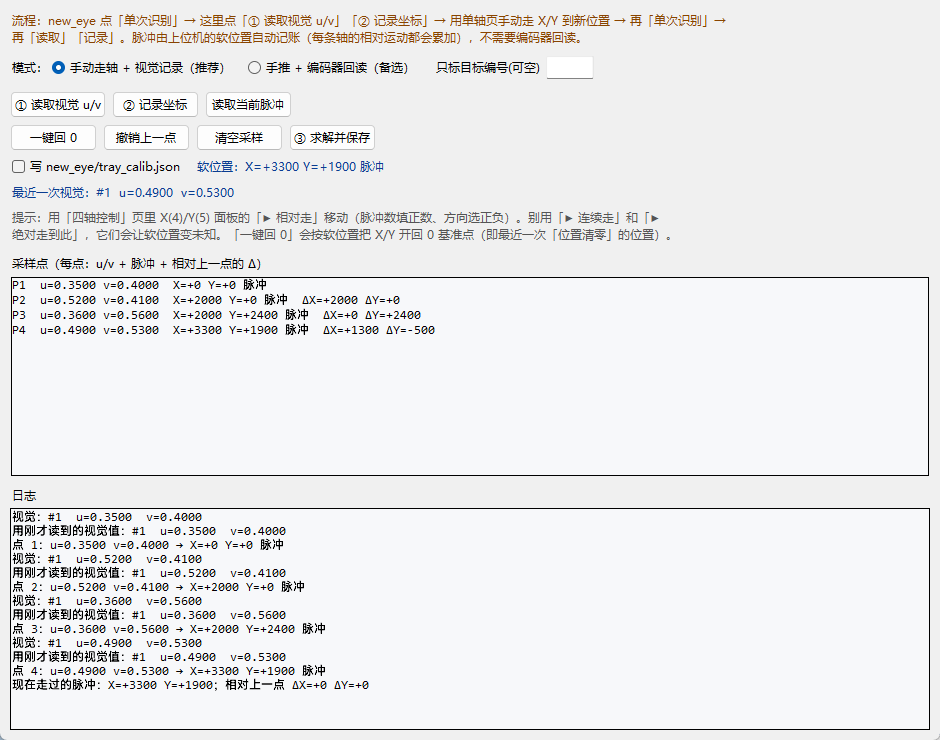
new_eye/runtime/calib_dialog_proof.png
