2186279865/robot-10.15/图片/presets/pink_ellipse_cylinder.png

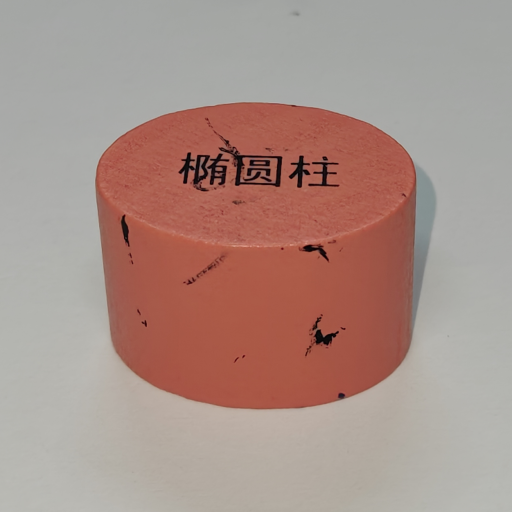
图片/presets/pink_ellipse_cylinder.png
