2186279865/robot-10.15/图片/presets/purple_square_pyramid.png

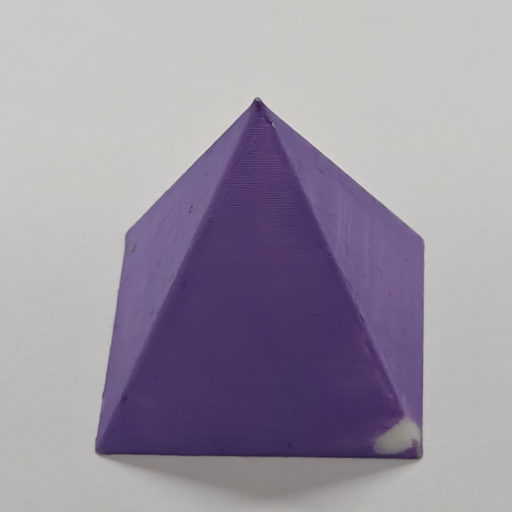
图片/presets/purple_square_pyramid.png
