2186279865/robot-10.15/图片/presets/red_cuboid.png

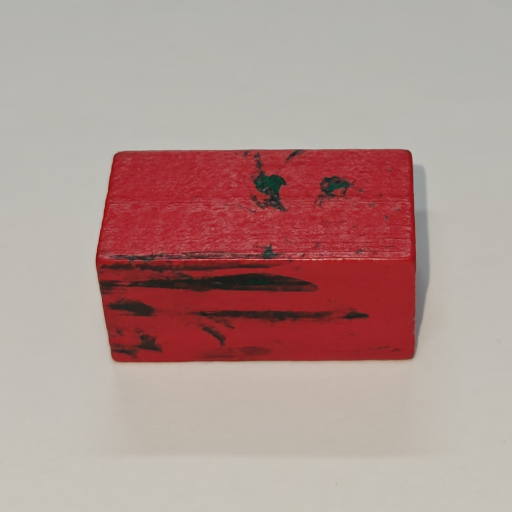
图片/presets/red_cuboid.png
