2186279865/robot-10.15/图片/presets/white_pent_pyramid.png

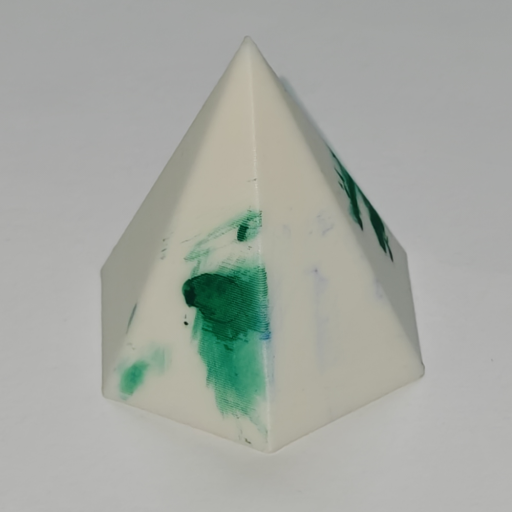
图片/presets/white_pent_pyramid.png
