2186279865/robot-10.15/图片/presets/yellow_cone.png

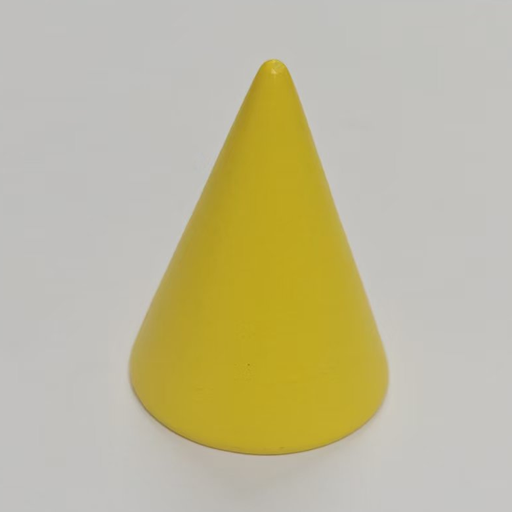
图片/presets/yellow_cone.png
