2186279865/robot-10.15/codex/VISION_CALIBRATION_REVIEW.md

# 视觉标定审阅

日期：2026-10-27。检查旧视觉、标定、抓取链路及新 codex 标定实现；跳过 `03-实验台`。仅离线分析，没有修改标定或操作机器人。

## 结论

现有“托盘四点透视校正 → 归一化 u/v → 仿射变换 → X/Y”架构适用于固定相机、固定平面和直角坐标机构，无需仅因为存在误差就更换为复杂手眼标定。但目前缺少采样一致性、独立验收、标定版本绑定与高度处理；形状尺寸标定还有尺度使用不一致的问题。

分类模型、几何尺寸测量和抓取定位是三个不同的评价对象。换 YOLO 或 SAM 不会自动修好坐标变换。

## 已确认的问题

### 1. 当前标定误差较大，而且超差仍能保存

对 `01-交付包/vision/tray_calib.json` 中 5 个点重新最小二乘拟合：

| 指标 | X / 脉冲 | Y / 脉冲 |
| --- | ---: | ---: |
| 训练点 RMS 残差 | 178.18 | 534.95 |
| 训练点最大绝对残差 | 294.66 | 677.49 |
| 每次留出一个点、用其余点预测的最大绝对误差 | 858.91 | 4347.56 |

留一验证仅表明当前小样本拟合不稳定，不能当成全场实测误差；这些点也不是独立验收点。物理毫米误差应使用重新实测的每轴 pulse/mm 换算，不能直接把脉冲当毫米。

`host/grasp_calib.py:113` 在检查 MAX_RESIDUAL=120 之前，已调用可写文件的求解；超差只返回 warning。`host/calib_tab.py:456` 使用 write=True。建议先完成数值和范围验收，通过后才能原子替换正式标定。

### 2. 点位覆盖不足，且与软限位冲突

5 点的 u/v 凸包面积约 0.2052，即归一化托盘的 20.5%。这不是说其余区域一定错误，而是这些区域缺少插值约束，需要外推或单独验证。

当前映射对单位正方形四角的 Y 预测范围约 [-111724.54, -22840.38]；当前 Y 软限位为 [-55000, 500]。保存样本中也有 -79141、-90141、-97140 等越限坐标。旧自动路径又没有严格执行绝对目标限位。

不能仅凭当前文件判断是限位、零点、记录值还是实际行程有误。应先实测行程与坐标原点；抓取 ROI 内任何越限目标均应拒绝，不能为容纳拟合结果直接扩大行程。

### 3. 旧标定未与相机、四点框、机器零点绑定

`vision/tray_calib.py:97` 保存单位、时间、仿射及点集，没有相机标识、分辨率、四点框指纹、原点代号、工具偏移或采样高度。

旧 `vision/gui.py:838` 重选四点不使已有 X/Y 标定失效；旧 `auto_grab.py:73` 读取目标不检查结果时间戳。换框、移动相机、机器重新清零或读取旧结果后仍可能套用旧映射。

建议保存一套完整标定档案；相机或 ROI、机器坐标参考变化时默认失效，重新定位到相同物理参考并通过检查后再恢复。抓取前必须验证图像新鲜、目标未移动、映射版本一致。

### 4. 记录图像点与机械位置没有严格同步

旧 `calib_tab.py:416` 先取机械位置，再读取视觉目标，且可退回软位置；视觉结果缺少采样同步约束。抓起来之后若物块已移动、识别点变成爪子或另一件物块，就会配错点。

新 `codex/workbench/app.py:600` 检查视觉 5 秒内有效，并用新鲜机械位置，已有改善；仍需检查机械停止和多帧位置稳定，把图像采样与机械静止时间对应起来。改四点框时还应清除之前的 teach_points，避免混用坐标系。

“曾经抓成功”只能证明落在某个可抓范围，不等于夹爪中心与视觉中心精确重合。标定宜用固定高对比标记、定位针或中心可重复对准的工装。

### 5. 平面映射不能消除物块高度视差，轮廓中心也未必适合抓取

旧 `vision/gui.py:1090` 的透视变换校正托盘平面；`auto_segment.py:205` 用外轮廓矩计算中心。顶面和侧面离开托盘平面后，投影位置可能偏移，偏差随高度及相机位置变化。

`host/grasp_calib.py` 注释中“抓取高度相同就没有视差”的说法不充分：实际要比较被观测表面的高度和整个投影几何。相同高度、相同外形的样本可能吸收部分系统偏差，但不能保证不同高度工件同样准确。

镂空或凹形物块的轮廓中心可能位于孔内或物体外；是否能夹取还取决于夹爪方向、开口宽度、有效夹持面和周围间隙。应将显示中心和抓取姿态分开，使用掩膜、孔洞与夹爪尺寸评估候选抓点。

在实际视觉管线中未见相机内参去畸变步骤。镜头边缘畸变是否显著需实拍验证；若显著，先标内参去畸变，再做平面映射，并确保检测和映射使用同一种坐标。

### 6. 形状标定尺度前后不一致，单一方块补偿也有限

`vision/shape_calib.py:44` 按已知方块宽度得到实测 mm/px，并用它计算副摄 k_h。顶视分类使用实测尺度，但 `vision/classify.py:235` 副摄运行时改用 tray_mm/700，再乘该 k_h。因此实测尺度与名义尺度不同时，同一个标定方块也不能恢复已知高度。

纯数值复现：已知 25 mm，顶视宽 100 px，副摄高 80 px，tray_mm=160；标定得 mm/px=0.25、k_h=1.25，但运行公式输出 22.857 mm，而非 25 mm。这是合成输入验证公式，不是现场测量结果。

此外，bbox 尺寸受物块旋转、侧面投影和遮挡影响；斜视相机把托盘平面拉成正方形，不等于把立体高度校正为真实高度。单个 k_front/k_h 只适合受限范围的经验修正。当前 config.json 的 shape_calib.source=default、k_front=k_h=1，也没有实测标定完成的证据。

建议两路相机各自管理测量尺度；统一标定与运行公式。对顶面尺寸使用合理的旋转几何测量，对副摄高度按相机几何和基准平面处理；用多个位置、角度、高度的标准件验证。三维要求较高时再评估双目或深度相机。

### 7. 单位自动猜测与手推模式可能污染坐标

`host/calib_wizard.py:95` 根据记录跨度自动猜测 counts/pulse 并除以 20.48。跨度大也可能来自错误原点或确实较长的行程，应要求来源明确，发现歧义拒绝保存。

`:135` 手推模式按单圈最短角差累计，并把第一点定义为 (0,0)。实际回读若为多圈位置，或者采样间跨过一圈，就可能混叠；该新原点也必须与运行时坐标对齐。这不是当前 5 点误差来源的定论，需要核对实际所用入口和驱动器回读语义。

## 新 codex 标定还应补充的内容

已有：归一化四点检查、改 ROI 后取消标定确认、至少 4 点、最小二乘秩和条件数检查、超 100 脉冲拒绝拟合、导入旧标定后要求复核。

尚缺：各轴 mm 误差阈值、独立验证点、覆盖范围限制、标定档案/版本绑定、相机内参、高度视差补偿、ROI 变化后清空旧采样，以及可重复的工具中心标定。仅靠 calibration_confirmed 布尔值还不够。

## 推荐现场流程

1. 固定相机、焦距和机械参考，测准托盘物理尺寸、各轴 pulse/mm、夹爪工具中心、行程及原点重复性。
2. 必要时用棋盘格或 ChArUco 标内参，采用托盘固定标志确定平面；AprilTag/ArUco 也可用于开机验证相机或托盘是否移动。标记应有足够像素并实测精度，不等于自动保证精确。
3. 在有效抓取区布置 3×3 或 4×4 点，记录静止时的新图像与机械位置，分散覆盖边角。拟合仿射作为起点；若误差呈系统性趋势，再检查内参、平面、高度和机构，而非直接增加多项式阶数。
4. 另取至少 5 个未参与拟合的位置，重复低速对准，记录每轴及二维毫米误差、最大误差和重复性。验收阈值由最小可抓间隙和夹爪容差确定。
5. 用不同高度、不同转角的物块验证；必要时做按高度的几何补偿或分层标定，限定可用高度范围。镂空体另外验证抓点、夹爪朝向和夹持面。
6. 保存完整档案，通过范围和误差验收才启用自动抓取。开机用固定参考点快速复核；相机、四点框、工具或坐标原点变化后重新确认。

先要取得的数据：相机安装高度和倾角、托盘尺寸、物块高度范围、夹爪开口和允许偏差、每轴实测 pulse/mm、原点/回零方式，以及带真实位置的原始样本。无需先提供训练数据集。
