2186279865/robot-10.15/01-交付包/vision/runtime/numbered_test.jpg

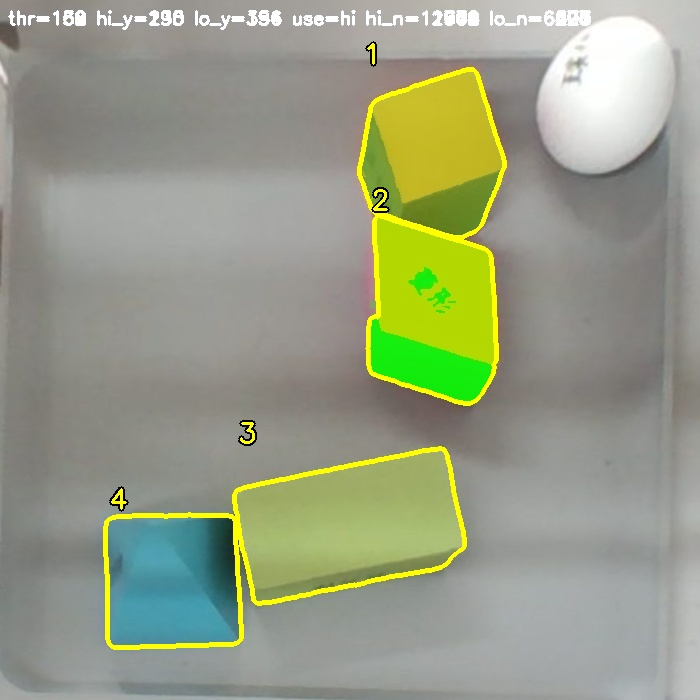
01-交付包/vision/runtime/numbered_test.jpg
