2186279865/robot-10.15/02-资料库/01-赛题/crop_test.jpg

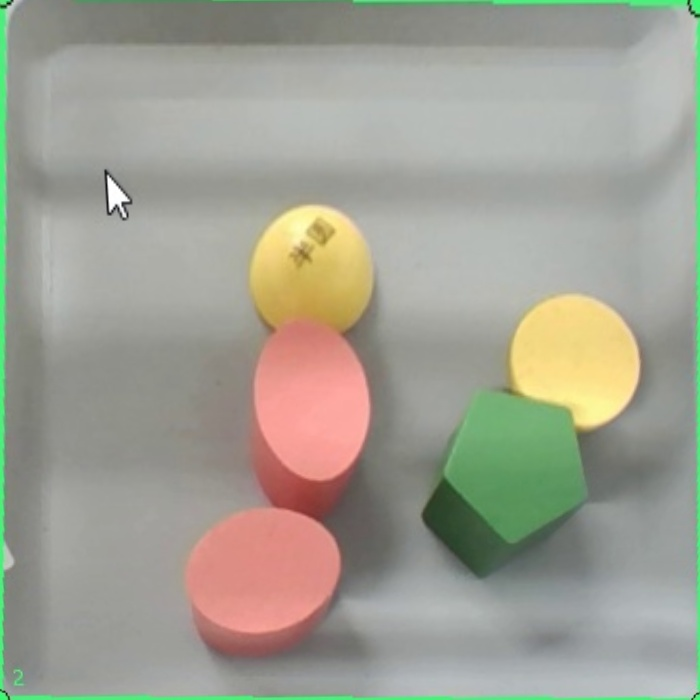
02-资料库/01-赛题/crop_test.jpg
