2186279865/robot-10.15/02-资料库/00-项目日志.md

# 00-项目日志（唯一追加式日志）

> **规则**：这个文件只往后加，不删旧的。
> 每条记录一个"事"，不是一次提交。写的是**想法与行为**：为什么想做、考虑过什么、放弃了什么、怎么验证的、留下什么坑。
> 复制 `00-项目日志模板.md` 的格式往里填。

---

## 2026-10-21 · 通读整个项目，写一份"家底清单"

**背景**
接手这个仓库时只听说"STM32 + 视觉 + 上位机"，具体哪块能用、哪块是实验残留完全不清楚。想要一份能让自己（和后来的队友）十分钟内搞清"这东西现在到底能干什么"的材料。

**方案取舍**
- 想自己逐个文件读到懂 → 32273 个文件，光 `Qwen/` 就有 3 万个，不可能。
- 决定：分 6 个方向并行派调研员（固件 / 上位机 / 视觉 / Qwen / 参考例程与文档 / final 快照），每人只读、产出带行号引用的报告，我负责汇总成导读。选这个是因为**行号引用**能让我随时回去核对，比"大概是这样"可靠。

**做了什么**
- 6 份调研报告 + 一份《全项目导读》（15 节：架构图、五条数据链、逐子系统、赛题约束、风险表、文档可信度、上手命令、下一步）。
- 期间发现的硬事实：固件主线 `ghr/10.15` 重编是 0 Error 0 Warning（Code=27728），但**USB CDC 从未上板枚举过**；上位机 121 个用例里 120 过，真机日志证明 hello 通、四轴 `motor_query` 全 `E04`；`new_eye` 的 X/Y 标定残差到 ±3.2 万脉冲（要求 <100），等于不可用；`final/` 是 10-21 凌晨冻结的一体化快照，有 6 个集成文件只存在于那里。

**验证**
读写都留了行号；发现并改掉报告里一处笔误（`sam_b.pt` 说成 899 MB，实际 357.7 MB）。

**遗留 / 风险**
- 文档大面积过期：根 README 目录树里没有 `Qwen/`、`new_eye/`、`final/`；唯一一份 10.15 编译日志是**失败**的。
- 赛项强制要求"高亮显示屏显示序号/名称/图片"和"一键启动 + 15 秒节奏"，这两个都没做。

**放弃的念头**
- 想把 `Qwen/` 的 33.7 GB 一次读透 → 放弃，它只是个"看图说话"实验台，与主线不通。

---

## 2026-10-21 · final/run.bat 双击打不开："'m' 不是内部或外部命令"

**背景**
用户报"final 文件夹里的 run.bat 打不开了"。这类问题在现场最要命：明明代码是好的，双击就废。

**方案取舍**
- 先怀疑解释器路径（`final/.venv` 不存在）→ 用 `Qwen/.venv` 手动跑 `main.py --selftest`，8 页全过，说明**逻辑没问题**。
- 再看文件字节：539 B、无 BOM、CRLF=0、LF=17，中文是 UTF-8 多字节。结论：cmd.exe 按系统 ANSI 码页逐字节解析批处理，UTF-8 中文 + LF-only 会把行边界切错。
- 修法三选一：①只改换行（CRLF）②改 GBK+CRLF ③**纯 ASCII + CRLF**。选 ③：跨语言环境最稳，代价是注释和提示只能写英文。

**做了什么**
- 重写 `run.bat` / `setup.bat` 为纯 ASCII + CRLF（逻辑一字未改），并在注释里写明"为什么必须 ASCII+CRLF"。
- 全仓扫了一遍 `.bat/.cmd`：其余本来就纯 ASCII，Keil 自带的 `keilkilll.bat` 带 CRLF 不动。
- `使用说明.md` 故障排查表加了一行：见到 `'m' is not recognized` 就是这个坑。

**验证**
`cmd /c "run.bat --selftest"` 8/8 页；`setup.bat` 在"PATH 里没有 python"时能正确报错退出；真双击截图留证。

**遗留 / 风险**
这是**通用陷阱**：以后任何 `.bat` 被编辑器另存成 UTF-8 就复发。后来把这条写进了交付包的 `CHECK.py`（检查非 ASCII 字节 + CRLF）。

**放弃的念头**
- 想用 PowerShell 脚本代替 .bat → 放弃：现场双击体验不如 .bat，且 PowerShell 执行策略又是一层坑。

---

## 2026-10-21 · "final 能不能跑在香橙派 4 Pro 12G 上"

**背景**
想把整套系统塞进一块 55 美元的香橙派。要先回答：算力够不够，尤其是视觉。

**方案取舍 / 实测**
- 直接在笔记本 CPU 上跑 SAM-B 计时（700×700、1 点 prompt）：加载 0.57 s，**单次分割 6.2–6.7 s**（8 线程 Ryzen 9 8940HX）。
- 按 A733（2×A76 + 6×A55，无 CUDA）保守估 4 倍 → **20–30 s/帧**。结论：SAM 在派上不可用；而控制端（tkinter + 串口）在派上完全跑得动。

**做了什么 / 结论**
- 给出三条路线：A 派只当控制端（`--no-vision`）；B 全派化（必须换 YOLO11n-seg 之类轻模型，SAM 换掉）；C 换 RK3588 + RKNN。
- 关键判断：**12 GB 内存不是瓶颈，算力才是**；而且 RKNN 工具链冷门、散热、USB 带宽都要另外折腾。

**验证**
只用真实计时和公开规格推算，没有真机跑过（板子还没到）。这条后来被证实方向正确：真机到手后，最终架构是"派采集 + 笔记本识别"。

**放弃的念头**
- 一开始想"干脆重写一个轻量视觉" → 放弃：分割质量直接决定抓取成功率，SAM 的泛化是这套系统的立身之本，不能为了板子换模型。

---

## 2026-10-22 · 架构定调：派采集、笔记本识别、串口桥透传

**背景**
用户提出真实链路："香橙派连 STM32，相机连香橙派，派把画面无线传给笔记本，笔记本识别，再下发运动指令抓取"。

**方案取舍**
四个方案对比：
1. **相机上派 + 串口桥**（拉模式拉静帧，笔记本识别）；
2. 实时视频流（RTSP/H.264），派端硬编码；
3. 控制下沉到派（笔记本只看）；
4. 全派化（换轻模型）。

量化后选 ①：SAM 在笔记本上 0.8–1 s/帧占绝对主导，而一张 720p JPEG 上行只要 10–40 ms、带宽 <1 Mbps → **根本不需要视频流**。方案 2 要折腾全志编码器插件；方案 3 要把 5000 行 tkinter 搬到派；方案 4 要换模型。①还有一个决定性优点：**协议零改动、固件零改动、默认行为不变**（`--pi` 不传时完全等价于原来）。

**做了什么**
- 定了三条通道：TCP 5057 图传（拉模式：笔记本发 9 字节请求，派回 24 字节头 + JPEG）、TCP 5058 串口桥（字节透传）、UDP 5056 发现。
- 定义了三层安全网：界面急停 → 派端 1.5 s 无字节发停车帧 → 固件 3 s 心跳锁存。
- 写了 `10.21/` 自包含包（后来重排成 `01-交付包/`）：派端 `pi_agent.py`、笔记本端 `RemoteCamera`/`SocketLink`/`camera_factory`。

**验证**
假派 + 假串口自测全绿；真机（香橙派）上：图传建连 10–51 ms，取一帧 1280×720 137–376 ms，串口桥 5–38 ms。

**遗留 / 风险**
- WiFi 双路 1920×1080 需要 4–7 MB/s，实际用 1280×720 更稳。
- 现场若 AP 隔离，UDP 发现收不到 → 靠"记住上次 IP"兜底。

**放弃的念头**
- 想过让派端推流（UDP 分片）→ 放弃：丢帧要重传逻辑，而"按需拉一帧"天然没有积压问题。

---

## 2026-10-22 · 换了一台"全新的"派：重装系统后的五个坑

**背景**
WiFi 换到 `MIFI-2419` 后，用串口登录发现：用户 `orangepi`、系统全新（uptime 6 分钟）、家目录是镜像原始状态。

**踩到的坑（都记下来，换机必看）**
1. **SSH 主机键变了**（旧 `WIMfsjTCe+…` → 新 `SHnztqS6…`），plink 需要重新固定指纹；
2. 没有 `~/robot1021`：`pscp` 直接传目录会失败（目标父目录不存在），要先 `mkdir -p`；
3. 没有 `cv2` / `pyserial`：`apt-get install python3-opencv python3-serial`（华为云 arm64 镜像）；
4. 串口被 MobaXterm 占着（PID 3123），pyserial 报 `PermissionError(13, '拒绝访问')` —— 但 .NET 的 `SerialPort` 能开，用来登录救急；
5. **相机槽位与旧机相反**：旧机 0=顶视，新机 0=侧视 → `remote.cam_map` 要跟着改。

**做了什么**
- 重新部署 `pi/` + `common/`，装了依赖，先用 `--fake-camera --fake-serial` 验通，再切实机。

**验证**
`find_pi.py 192.168.100.198 --full`：图传 44–70 ms、串口桥 5–15 ms、取帧 1280×720 251–376 ms。

**遗留 / 风险**
- "槽位会变"这件事没有一劳永逸的办法，只能现场用 `find_pi --full --cam 0/1` 看一眼。

**放弃的念头**
- 想写脚本自动判定哪个槽位是顶视 → 放弃：判断"是不是俯视托盘"本质是视觉问题，规则不可靠，人工一眼更快。

---

## 2026-10-23 · 双相机同 USB2 hub：5 fps 的真因不是 CPU

**背景**
真机上双相机预览只有 5–6 fps，日志还刷"相机 0 连续抓帧失败，重开设备"。

**排查思路（值得记）**
1. 先停掉 agent，用 cv2 单独并发读两台 → 40+40 帧全成功、18 fps ⇒ **相机本身没问题**；
2. 再看 `_open_capture()` 只设了宽/高/帧率，**没设像素格式** ⇒ V4L2 默认 YUYV，720p 单路 ~55 MB/s；
3. 两台挂同一个 USB2 hub ⇒ 带宽根本不够。

**做了什么**
`10.21/pi/pi_agent.py::_open_capture()` 在 Linux 上先设 `CAP_PROP_FOURCC = MJPG` 再设宽高，上传到派重启。

**验证**
帧率从 5–6 回到 10–12 fps（两条相机分插 USB3 + USB2 时 11 fps；同一 hub 时 6.4/4.9 fps，瓶颈是 hub 本身）。日志不再刷抓帧失败。

**遗留 / 风险**
- 想稳，就把一台相机插派的 USB3 口（A733 只有一个 USB3）。
- 降分辨率是最后手段（会作废标定）。

**放弃的念头**
- 试过"只在需要时打开相机、拍完就关" → 放弃：开关相机的延迟（1–2 s）比省下的带宽更贵。

---

## 2026-10-23 · "点连接没反应"：静默失败比报错更难查

**背景**
用户点「连接」后界面毫无变化。第一反应是网络问题。

**排查**
- 笔记本 ping 通、22 口开，但 **5057/5058 全关** ⇒ 派端服务没跑；
- 派 `uptime` 只有 4 分钟 ⇒ 刚重启过，而 `pi_agent` **没有开机自启**；
- 再看代码：`toggle_connect()` 失败时只往「原始日志」写一行，主界面什么都不显示 ⇒ 用户看到的就是"没反应"。

**做了什么**
1. 派端：生成适配现场的 systemd 服务（`User=orangepi`、`WorkingDirectory=/home/orangepi/robot1021/pi`、`ExecStart=… --cam-index 0 --cam-index 2`），`enable --now`；把 `install.sh` 改成**现场生成** unit（原来是把树莓派示例原样 `cp` 过去，用户/路径都不对）；
2. 上位机：`host_client.last_error` + 状态栏红字「连接失败」+ 弹窗（弹窗里直接写下一步：查服务、查防火墙、查端口），成功连上才"记住上次 IP"（免得把打错的 IP 存进下拉框）。

**验证**
`gui_fail_smoke.py` 打一个不存在的端口 → 弹窗 1 次、标题「连接失败」、含 `systemctl status robotpi`、状态栏红字、`last_error='LinkError: … WinError 10061'`。

**遗留 / 风险**
- 弹窗是阻塞式的，连串调试时会烦；但现场"看得见"优先于"顺手"。

**放弃的念头**
- 想过自动重连（指数退避）→ 现在只做到"报错清楚 + 手动重连"，自动重连留待后续。

---

## 2026-10-23 · 夹爪三档角度：180 全开 / 150 预备 / 135 夹紧

**背景**
用户提出：上电到 180°（全开）→ 跑任务前自动到 150°（预备）→ 抓取 135°（夹紧）→ 松开回 180° → 再回 150° 等下一次。原系统只有 180/0 两态。

**关键决策**
- 150° 这个"自动到预备位"**由上位机在连上后下发**，不是固件自己定时做 —— 因为"什么时候算开始跑"只有上位机知道。
- 夹紧角度用户先说 137°，最后确认**仍用 135°**。
- 舵机**保持通电不卸力**（卸力会掉夹持）。只预留 `gripper_hold_max_ms`（默认 0 = 永不卸力）作调试兜底。

**做了什么（固件）**
- `gripper.h` 加 `GRIPPER_READY_DEG 150` + `Gripper_ReadyNow()`；
- `servo.c` 加 `Servo_Release()`（占空比 0 = 无脉冲；定时器不关，下次 `Servo_SetAngle` 自动恢复）；
- `control_inline.h` 加 hold_max 计时 + 到点卸力；
- `host_protocol_inline.h` 参数表 13 → 15（新增 `gripper_ready_deg`、`gripper_hold_max_ms`），`gripper` 命令加 `ready` 子动作。
- 编译：**0 Error 0 Warning**，Code=28,000（原 27,728），hex 81,951 B。

**做了什么（上位机）**
- 参数页两个新参数、夹爪页加「预备(150)」按钮、连上 hello 后自动下发 `ready`；
- 抓取序列改成 `grab → 松开 180 → 抬 Z → 等 500 ms → 150`（**先抬 Z 再收口**：在盒子里从 180 收到 150 会蹭到物块/盒壁）。

**验证**
单测 164 个全过；真机（烧了新固件）`param_get gripper_ready_deg=150`、`gripper ready → angle=150`；夹爪开合在相机画面里肉眼可见。

**遗留 / 风险**
- `gripper_hold_max_ms` 的范围是 0–60000（HostParam 是 uint16）；我第一版 brief 写成 0–600000，被自己的代码打回。

**放弃的念头**
- 想过让固件自己"上电 180 → 2 秒后 150" → 放弃：会出现"刚上电就自己动"的安全隐患，也不符合比赛"一键启动"的节奏。

---

## 2026-10-23 · 接近段示教：从"记不住"到"三种点动都能记"

**背景**
用户要把"上电位置 → 抓取位置"这段路录下来，抓取前自动重放，避免每次手动点。第一版做出来后用户反馈：**"记录不住"**。

**根因**
第一版钩子只认 `motor_pos` 且 `mode=="rel"`。但界面上有三种点动方式：
- 「相对走」→ `motor_pos rel` ✅ 能记；
- 「绝对走到此」→ `motor_pos abs` ❌ 分支提前 return；
- 「常用走」→ `motor_speed` ❌ 完全不记。

而且没有任何可见反馈，用户不知道自己录上了没有。

**关键事实（很重要）**
固件把"绝对位置"也**按相对执行**（`control_apply_position(..., absolute=0)`）。所以 abs 点动实际走的是"目标那么多个脉冲"，不是"走到绝对位置"。这直接决定了记录逻辑：abs 也按 `(方向, 脉冲数)` 记账，而不是算目标差。

**做了什么**
- 三种点动全部纳入：rel 直接记；abs 当 rel 记（并 note 提醒"固件按相对执行"）；speed 记 `(起始时间, 方向, 转速, 加速度)`，等 `motor_stop` 或 `stop_all` 到了才按"转速 × 时间"结算。
- 每记一段就 `note("已记录第 N 段：X +3200 脉冲")`，状态行实时显示段数与净脉冲。
- 重放：先 `stop_clear`（断线后固件会锁存停止），逐段 `motor_enable + motor_pos rel`，跑完自动衔接动作序列。

**验证**
单测 22 个；冒烟 16 项（含"绝对走到此记成一段""常用走停下结算成一段"）；真机待用户验证。

**遗留 / 风险**
- 速度模式那段是**估算**，误差大（0.4 s × 60 RPM ≈ 1280 脉冲，实测 1500）。已建议示教优先用相对走/绝对走到此。
- 开环无回读，重复精度靠机械；跑偏了要重新示教。

**放弃的念头**
- 想过"录制时改写点动按钮，只允许相对走" → 放弃：限制了用户操作习惯，且 abs 本身有价值。

---

## 2026-10-23 · 删掉「一键回0 / 开机回基准」，改成「回上电初始位」

**背景**
用户明确说"删掉截图里的两个功能"（一键回0、开机回基准），因为实际用不上、还占顶栏；同时要一个新功能："从上电开始记录所有移动，一键原路返回"。

**为什么原来的回零不好用**
- 固件没有真正的"机械原点"，所谓"回 0"只是把**软位置**归零，不是回到某个物理位置；
- 托盘"位置清零"后仍需人工对准 1 号位，容易误以为已经校准；
- 有了"记录 + 倒放"，"回初始位"这件事才真的可执行。

**做了什么**
- 删除：顶栏两个按钮、视觉页两个按钮、X/Y 标定页与标定对话框里的回零按钮、`home_route.py` 模块/状态文件/测试、生成序列时的"还没建立基准"拦截弹窗。保留「位置清零」（只归零不运动）。
- 新增 `journey.py`：记录**四轴**（含托盘）每一次移动（命令发出即记账），最多 2000 段；「原路返回初始位」= 倒序 + 方向取反重放；返回成功后清空记录（避免再点一次往反方向走）；固件重启（boot id 变化）自动清零。

**验证**
单测 12 个（journey）+ 全量 164；冒烟 11 项（记录 3 段含托盘 → 速度模式补记 → 返回严格倒序取反 → 每段先使能 → 成功后清空 → 急停清队列）。

**遗留 / 风险**
- 开环重放有累积误差；返回后要目视确认真的回到原位。
- 记录是"本次上电以来"，固件一重启就清空。

**放弃的念头**
- 想过记录到"帧级"（每 50 ms 采样一次位置）→ 放弃：没有编码器回读，采样再多也是估算，反而显得精确。

---

## 2026-10-23 · 仓库重排成三个文件夹

**背景**
仓库 34.5 GB、3 万多个文件，`Qwen/` 一个目录就 33.7 GB，`final/`、`new_eye/`、`10.21/`、`ghr/10.1x/` 之间还有大量重复（`sam_b.pt` 有 3 份，各 357.7 MB）。新队友进来根本分不清哪个是"现在能用的"。

**方案取舍**
拆成三个文件夹：
1. **`01-交付包/`** —— 现在能用的那一版，自包含（带模型、带 hex、带文档），按 stm32 / 香橙派 / 视觉 / 上位机 分类；
2. **`02-资料库/`** —— 全部资料：赛题、硬件、往届参考、历史快照、调研报告、交接文档 + **本日志**；
3. **`03-实验台/`** —— 一次性实验（Qwen 语义识别、SAM 上派实测、网络化原型），允许脏、允许废，但有"四状态"规矩。

**为什么不是两个文件夹**
Qwen 那 33.7 GB 既不属于"现在能用"，也不属于"资料"，它是"试过的东西"。混进 02 会把资料库撑爆，混进 01 会破坏自包含。

**做了什么**
- 阶段 0（先保命）：`git add -A` + commit `3a5fec3` + tag `working-20261023`；物理备份到 `D:\study\backup\robot-competition-2026-10-23`（1.16 GB，含 `_MANIFEST.txt` 逐文件哈希）；模型不进 git（`.gitignore` 加 `*.pt`）。
- 阶段 1：建 `01-交付包/`，把 `10.21/` 的代码按 stm32/orangepi/vision/host 重排，所有路径改成相对计算（`pi_agent.py` 的 common 路径改成候选列表）——这样挪目录不会炸。
- 阶段 2：建 `02-资料库/`，xrw 去掉 75 个 backup 目录、历史快照去掉模型。
- 阶段 3：建 `03-实验台/`，Qwen 移进去。

**验证**
- 备份逐一 SHA256 对比 MATCH（sam_b.pt / hex / run.bat / host_gui.py）；
- `01-交付包/selftest.bat /quick` → 全绿（164 单测 / 派端 24 / 协议 37 / 端到端 5）。

**遗留 / 风险**
- `01-交付包` 的 `.venv` 需要单独装一次（约 1–2 GB）。
- 03 是 33.7 GB 的大件，不建议长期放系统盘。

**放弃的念头**
- 想把模型用 Git LFS 入库 → 暂时放弃：357.7 MB × 版本数会让 clone 变得很难看，先用"包内单份 + 备份"策略。

## 2026-10-24 · 上传 GitHub：三文件夹结构进远端

**背景**：仓库重排完、自测全绿，需要一份"团队/答辩都能看"的远端版本。

**取舍**：
- 走 SSH（git@github.com:2186279865/robot-10.15.git）+ 专用密钥，不用代理——校园网对 HTTPS 代理不稳；
- **模型（357.7 MB）不上传**：GitHub 单文件 100 MB 限制、LFS 免费额度也是 1 GB。只留 LFS 规则防误传，权重靠本地/物理备份；
- **.survey/ 不上传**：里面是本机临时验证脚本（路径写死开发机、含 PI_PASS 环境变量用法），整理后的报告已在 2-资料库/05-调研报告/；
- 3-实验台/Qwen-VLM/（33.7 GB）在 .gitignore 里，远端只剩它的 README。

**做了什么**：git push origin main（4 个提交：快照 3a5fec3 → 重排 61e59d8 → 清理 121c7ea → 文档 f98bfad → LFS 规则 b9d4095 → 去 .survey 088fe21）；git push origin --tags（working-20261023）。

**验证**：git ls-remote 与本地 HEAD 一致；远端顶层 = 1-交付包 / 02-资料库 / 03-实验台 / README.md，1288 文件，.pt 对象 0 个。

**遗留**：权重不在远端（这是设计，不是疏漏）。要给别人完整可跑包，得走 D:\study\backup\robot-competition-2026-10-23 或本地 1-交付包/vision/models/。

## 2026-10-24 · 回读真相、往返流程、遥测闭环：把今天的思路集中记一份

**背景**：今天讨论了很多"要不要这么做"的东西，但没有一件是改代码就完的——都是要拍板的设计。怕明天接不上，单独整理成 `02-资料库/思路-2026-10-24.md`，这里只记结论和坑。

**取舍**：
- 不再用"所有移动都记录再倒放"（`journey.py`）来做往返，改成**只记录通道段**、抓取动作不参与返回——否则返回时会把"下探/夹紧/托盘转位"都倒着做一遍；
- 查询问题**先绕开**（上位机读遥测缓存），再做诊断固件钉死，不为了一个按钮停掉整条流程；
- 闭环只做"到点确认 + 丢步检测"，不做实时伺服——遥测每轴 400 ms 才刷新一次，做伺服是自欺欺人。

**做了什么**：
- 三个只读探针（`.survey/readback_check.py` / `readback_tele.py` / `readback_noTele.py`）+ 耗时/突发两个补充测试，共 20 次查询 0 成功、遥测 75 帧全有真实 counts；
- 写 `02-资料库/方案-整机作战方案-v1.md`（整机方案，含赛题硬指标、缺口、节拍预算、P0–P5 阶段、风险、runbook）；
- 按你的意见把方案 §5.3 从"STM32 直驱 ST7735S"改成"**派 HDMI 小显示器 + 图形窗口**"（新增端口 5059 推显示状态）；
- 讨论定下往返流程（P0 → 通道 → 抓 → 通道倒序 → P0 释放 → 下一件）与它需要的 5 个实现件。

**验证**：遥测四轴 counts 与 GUI 显示一致（Z=2,757,257 / 托盘=7 / X=−31,111 / Y=446,243）；E04 往返 62–93 ms（短于 100 ms 超时）；遥测关闭后 8/8 仍 E04。

**遗留 / 风险**：
- `motor_query` 仍未修（主假设：`sent_ms` 与 `stamp_ms` 不同源，需上板诊断）；
- `02-资料库/02-硬件/README.md:23` 与 `01-交付包/VERSION.md:28` 里"PA3 未接线 → E04"的旧结论**要改**；
- 往返模式的 7 个待拍板问题（释放点、P0 干涉、通道是否每件走、货高、是否允许放弃、屏规格、标定实验许可）都写在 `思路-2026-10-24.md` 第 6 节。

**放弃的念头**：
- 想把 PA2/PA3 用软件"对调"寄存器解决——F4 没有 SWAP 位，这条路不存在（要么 bit-bang、要么换脚、要么改线）；
- 想用 `journey.py` 直接当往返执行器——它记录太杂，会把抓取动作也倒放。

## 2026-10-25 · 固件加闭环 `motor_goto`：让"走一段"变成"走到位"

**背景**：通道段要求"必须走到位"，而 `motor_pos` 只保证指令被接纳——丢步、背隙、堵转都不会告诉你；`motor_query` 又必回 E04（还没修）。遥测里其实一直有真实 counts（四轴都能读到），所以闭环放在固件里做：数据就在 RAM，判定 1 ms，不用绕 WiFi 往返 200–400 ms。

**取舍**：
- 不改 `motor_query`，直接读 `host_query_sweep` 已经缓存好的 `host_axis_read[]`——绕开坏的那条路，不动老的；
- 用"连续两次 counts 变化 <40"判停，不用固定延时：堵转、丢步都能自然识别；
- `HostParam` 的 value/min/max 从 uint16 扩到 uint32（`counts_per_rev`=65536 装不下），参数 15 → 21 项；
- goto 期间 `host_query_sweep` 优先轮询它那根轴，但不设 `host_query_pending`（设了反而挡住自己的采样）；
- 目录上把 Keil 工程从 `stm32/project/` 挪进 `stm32/firmware/Project/`——uvprojx 里的 `..\\MY` 相对路径只有这个位置成立，改代码比改 30 条路径安全。

**做了什么**：
- `emm_reply_inline.h`：加 `Emm_PulsesToCounts` / `Emm_CountsToPulses`（int64 中间量、四舍五入）；
- `host_protocol_inline.h`：E14 + 6 个参数 + `HostGoto` 状态机（COARSE → SETTLE → MEASURE → CORRECT）+ `host_cmd_motor_goto` + 抢轴保护（其它运动命令在 goto 期间回 E09）+ 停止/失联中止 + hello 丢弃旧 goto；
- 上位机：`host_client.goto()` / `wait_reply()`、四轴页每个轴加「闭环」勾选（勾上后「相对走」走 goto）、参数页 6 项中文标签、`tools/goto_check.py` 自测脚本、协议文档新增 3.2 节。

**验证**：编译 **0 Error 0 Warning**，Code 28,000 → **30,300**，hex 81,951 → **89,098 B**（2026-10-25 21:43）；`CHECK.py` 19/19；`selftest.bat` 7/7 全绿（164 单测 + 24 + 37 + 5）；GUI 截图里四轴页出现「闭环」勾选、参数页出现 6 个新参数。**真机还没验证**（要烧新 hex + 接回读线）。

**遗留 / 风险**：
- `counts_per_rev` 标称 65536，但必须实测标定（A 实验：走 3200 脉冲看 counts 变化）；
- 背隙没补偿（补差段是单向逼近，反向时会多欠一点），C 实验量出来之前别把 tol 设太小；
- 遥测丢包时 goto 会等到超时回 E14（连续无新样本），不会瞎走；
- `corridor.py` 还没切到等 goto 返回，仍按时间等。

**放弃的念头**：
- 想把闭环放上位机（复用 GUI 现成逻辑）——WiFi 往返 200–400 ms，判一次位要两个来回，节拍废掉；
- 想顺手把 `motor_query` 也修了——没证据钉死根因，先让闭环绕过去，诊断固件等有板子时再做。

## 2026-10-25 夜 · 闭环 `motor_goto` 真机打通：从"以为驱动器坏了"到"查询帧把运动帧挤掉"

**背景**：晚上把含 `motor_goto` 的固件烧进板子后，真机测试一直失败——`E14 lost`、`err` 恒等于目标（13107 counts）、`passes` 打满 4，而同一根轴用 `motor_pos` 走同样的 640 脉冲却能走（counts +13112）。所以"电机不转"完全不成立，问题是闭环看不见/发不出去。

**取舍**：
- 没有直接改 `motor_query`（旧 E04 bug 还没钉死），而是让 goto 直接读 `host_query_sweep` 刷出来的 `host_axis_read[]` 缓存；
- 判定"停稳"不用固定延时，用"两次样本变化 <40 counts"（堵转/丢步都能自然暴露）；
- 不在 PC 侧做闭环：WiFi 往返 200–400 ms，判一次位两个来回，节拍废掉；
- 烧录只能走 Keil `UV4 -f`（本机没有 ST-LINK_CLI），每次烧完必须手动按复位。

**做了什么（今天真正落地的修复）**：
1. `host_cmd_motor_goto` 的 `host_require_argc(id, nargs, 2U)` 是**精确匹配**，而 `goto()` 带 tol/rpm 发 4 个参数 → 必回 E02。改为 2..4 区间。
2. 所有时间差改成**有符号**比较：`(int32_t)(now - started_ms) > (int32_t)max_ms`；`now` 取自任务开头、`started_ms` 取命令处理时，用 uint32 相减会回绕成天文数字 → 当拍判"超时"（313 ms 就回 E14 timeout）。这跟 `motor_query` 必 E04 是同一类病。
3. 新增 `HOST_GOTO_PRIME`：先等一份新鲜 counts 定 base，再发第一段（原来直接动，base 是旧值）。
4. 新增 `HOST_GOTO_GAP`（20 ms）：实测 sweep 刚收到 0x36 应答就紧跟着发 FD，驱动器会整帧吞掉。
5. **关键修复**：goto 激活时第 7 步每轮都调 `host_query_sweep()`（主循环 kHz 级）→ 驱动器被 0x36 查询淹没，FD 帧被丢。给 sweep 加节流：goto 期间至少间隔 20 ms，且刚发过 FD 后静默 30 ms。

**验证**：
- 编译 0 Error 0 Warning，Code 30,300 → **30,608**，hex 89,098 → **89,961 B**（22:46:55）；
- 复位后真机：`motor_goto 4 +640 tol=200 rpm=60` → `ok passes=0 err=-127 counts elapsed=834 ms`，counts 94042 → 107252（Δ13210，理论 13107）；
- 单轮 `goto_check` 另一次：`err=33 counts`（0.18°）；
- 中间踩坑：`goto_check.py` 靠 `hc.latched` 判断锁存 → 经常漏（固件 3 s 没字节就自动锁存）→ 改成**无条件先 `stop_clear`**。

**遗留 / 风险**：
- **负方向 bug（已定位未修）**：GAP 阶段发段时传 `host_goto.pulses`（绝对值），丢了方向 → 负向指令实际往正走。补丁 `.survey/patch_goto_dir.py` 已写好，**明天第一步就是应用+重编+烧录**。
- `tools/goto_check.py` 客户端等待太短（rpm=60 时 4.2 s），第 2 轮会误判超时，之后撞 E09。
- `counts_per_rev=65536` 已由实测确认，但 `tol=200 counts≈1.1°` 是否够比赛用还没定。
- 背隙没补偿；`motor_query` 仍然必 E04（闭环已绕开）。
- 3 轮往返漂移测试还没跑（第 2 轮就被超时打断）。

**放弃的念头**：
- 怀疑过驱动器坏、使能没发、编码器线松、acc=0 的问题——全部用单变量实测排除（`motor_pos` 能动、`acc=0/1` 都能动、紧跟查询不影响 `motor_pos`）；
- 想过去 PC 侧抓 UART 波形——没有独立逻辑分析仪，改用"改固件回显 tx/txc/rpm/pulses"的最低成本取证；
- 想过直接重写 goto 状态机——最后证明只要节流查询就够，改动 4 行。

**明天的入口**：`02-资料库/明日待办-2026-10-26.md`（方向修复 → 3 轮验证 → 3200 脉冲 → 接进 corridor → 收尾提交）。

## 2026-10-26 · D0：无实物方案落地（动态盒映射 + 角度模式 + 自动状态机 + 派端显示）

**背景**：昨天定的"现场无实物、10-30 省赛、只剩 4 天"把方案逼成一个硬约束——不能靠赛前录样本，
也不能靠现场学习；同时通道必须以"先 Y 让开、再抬 Z"出场（初始位上方有遮挡，机构不可改）。
于是把"类别 → 盒子"从固定映射改成**运行时动态登记**：计分只要求"同形同色同盒"，
第一件某类就占一个空盒（最多 6 类 6 盒），同类后续同盒 —— 不需要样本、不需要学习。

**取舍**：
- 转盘走"角度模式"（`motor_angle`）而不是驱动器的绝对位置模式：后者要验证 `raF=1` 语义，
  而前者可以复用刚打通的闭环（发相对帧 + 读 0x36 判位），风险低一半；
- 角度基准放 RAM（`motor_angle_zero` 一次一记），掉电失效可接受——上电本来就要人工对零；
- 状态机放 PC（`auto_runner.py`）而不是固件：改一行就能调流程，比赛现场才敢改；
- 软限位放上位机（`limits.json`）：固件不该背全局行程知识，且明天要量的数就是它的输入；
- 显示页用派自带 XFCE 桌面 + tkinter 全屏，不碰 framebuffer/DRM。

**做了什么**：
- 固件（`host_protocol_inline.h`）：修 goto 负方向（GAP 段传绝对值导致永远往正走）、CORRECT 段补 dir、
  参数 21→22（加 `angle_tol_counts` 90）、新增 `motor_angle_zero` 与 `motor_angle` 两条命令
  （复用 goto 闭环，单圈最短路径）；编译 0E0W，Code=31,632，hex **92,952 B**；
- 上位机：`protocol.py` 加 `angle_tol_counts`、`host_gui.py` 加中文标签、`host_client.py` 加
  `angle_zero()`/`angle()`、新增 `box_map.py`（动态盒分配，落盘 `runtime/box_map.json`）、
  `vision_grasp.py` 接入 `ensure_boxes()`（手动映射优先）、新增 `auto_runner.py`（IDLE→…→DONE/FAULT 状态机，
  带软限位 `E15` 与假后端）、新增 `display_link.py`（5059 推 JSON 行）、
  新增 `orangepi/pi/pi_display.py`（全屏大字显示，`--fake` 可自演示）；
- 测试：`test_box_map.py` 9 个 + `test_auto_runner.py` 8 个，host 全量 **164 → 182 OK**；
  `CHECK.py` 19/19；`selftest.bat /quick` ALL CHECKS PASSED；
- 文档：README 新增 §5.4（状态机）/§5.5（显示页）、协议文档新增 3.3（motor_angle）/3.4（显示 5059）；
  方案改按"动态盒映射"口径（详见 `方案-省赛冲刺总纲-2026-10-26.md`）。

**验证**：只有软件层证据（编译、单测、CHECK、selftest）；**固件这版（92,952 B）还没烧、没上真机**。

**遗留 / 风险**：
- goto 负方向与角度模式的真机验证还没做（明天第一件就是量行程 + 烧 92,952 B 那版）；
- `auto_runner.py` 的真 backend（把 `goto/angle/gripper/capture/box_for/xy_for/display` 接到真硬件）
  还没写，现在只有假后端；
- 动态盒映射的显示文案是 `五棱柱|蓝` 这种规则键，正式比赛要不要美化（`五棱柱·蓝`）看现场；
- 相机仍看不到盒子（落货无视觉确认），建议盒入口加对射（记在 OPT）。

**放弃的念头**：
- 想在固件里做角度模式（直接用 raF=1 绝对位置）——要验证厂家语义，今晚没时间，闭环复用更稳；
- 想让 auto_runner 直接驱动 GUI——GUI 是给人看的，状态机要能无界面跑，解耦更安全；
- 想做"一类一键自动学"（现场 3 分钟录 6 类）——规则分类器已经输出"形状|颜色"，不需要学。
