2186279865/robot-10.15/02-资料库/00-项目日志模板.md

# 00-项目日志模板

> 复制下面这段，粘到 `00-项目日志.md` 的**末尾**，按顺序填。
> 一条记录 = 一件"事"（一个功能、一次排查、一个决定），不是一次提交、不是一个文件改动。

---

## YYYY-MM-DD · 一句话说清这件事

**背景**
为什么想做这件事？当时遇到了什么现象/需求？（写现象，不写结论）

**方案取舍**
考虑过哪几条路？各自代价是什么？为什么选这条？
（这条最值钱——半年后你会忘了为什么这么做，但会记得"当时还有别的选择"）

**做了什么**
功能级别的描述。改了什么行为、加了什么入口、删了什么。
不要贴 diff，不要列文件名清单；要写"用户能感知到什么变化"。

**验证**
怎么确认它真的好了？给出数字、命令、截图位置。
（"跑通了"不算验证，"164 个单测全过 + 真机回 angle=150"才算）

**遗留 / 风险**
哪些地方还很脆、哪些是已知缺口、下次谁会踩到什么。

**放弃的念头**
想过但最终没做的方向，以及为什么不做。
（防止半年后自己/队友又绕回同一个坑）
