2186279865/robot-10.15/02-资料库/04-历史快照/液晶-10.19/MY/main.c

/***
***************************************************************************************************
*	@file  	main.c
*	@version V1.0
*	@brief  液晶屏彩色显示测试实验（10.19）
   **************************************************************************************************
   *  @description
	*
	*	实验平台：鹿小班STM32F407ZGT6核心板 （型号：LXB407ZG-P1）
	*	液晶屏  ：1.8寸 / 1.77寸 ST7735S 128x160  SPI 串口屏
	*	程序基底：10.15 工程（LED + 延时），在其上加入 LCD 驱动
	*
>>>>> 功能说明：
	*
	*	1. 全屏纯色循环：白、黑、红、绿、蓝、黄、青、品红、橙、粉……
	*	2. 8 色彩条（先竖条、再横条）
	*	3. 16 级灰度条
	*	4. RGB 三原色渐变
	*	5. 彩虹色带（色相渐变）
	*	6. 16 色方块
	*	7. 满屏显示一张图片（数据在 pic.h 里，可用 tools\img2c.py 换成自己的照片）
	*	以上画面循环显示，每换一屏 LED1（PC13）翻转一次，方便判断程序是否在跑。
	*
>>>>> 接线（详见 lcd_init.h，板载 P2 接口）：
	*	VCC->3.3V  GND->GND  SCL->PB13  SDA->PB15  CS->PB12  DC->PC5  BLK->PB1  RES->PB14
	*	即核心板板载“TFT显示屏接口”P2 排针，液晶屏直接插上即可
	*
	***************************************************************************************************/

#include "stm32f4xx.h"
#include "led.h"
#include "delay.h"
#include "lcd_init.h"
#include "lcd.h"
#include "pic.h"

/*====================== 扩展颜色（RGB565） ======================*/
#define ORANGE        0xFC00	//橙色
#define PINK          0xFE19	//粉色
#define PURPLE        0x8010	//紫色
#define GOLD          0xFEA0	//金色
#define SKYBLUE       0x867D	//天蓝色
#define TEAL          0x0410	//青色（深）
#define NAVY          0x0010	//藏青色
#define OLIVE         0x8400	//橄榄色
#define SILVER        0xC618	//银白色
#define DARKGRAY      0x4208	//深灰色
#define DARKGREEN     0x0400	//深绿色
#define DARKRED       0x8000	//深红色

/* 纯色显示用的颜色表 */
static const u16 ColorTab[] =
{
	WHITE,    BLACK,   RED,      GREEN,   BLUE,    YELLOW,
	CYAN,     MAGENTA, ORANGE,   PINK,    PURPLE,  GOLD,
	SKYBLUE,  TEAL,    NAVY,     OLIVE,   SILVER,  DARKGRAY,
	DARKGREEN,DARKRED, LIGHTBLUE,LIGHTGREEN, BROWN, GRAY
};
#define COLOR_NUM   ((u16)(sizeof(ColorTab) / sizeof(ColorTab[0])))

/* 彩条用的 8 种颜色 */
static const u16 BarTab[8] =
{
	RED, GREEN, BLUE, CYAN, MAGENTA, YELLOW, WHITE, BLACK
};


/******************************************************************************
      函数说明：由 R、G、B 三个 8 位分量组成 RGB565 颜色值
      入口数据：r,g,b  0~255
      返回值：  16 位颜色值
******************************************************************************/
static u16 RGB565(u8 r, u8 g, u8 b)
{
	return (u16)(((r & 0xF8) << 8) | ((g & 0xFC) << 3) | (b >> 3));
}


/******************************************************************************
      函数说明：色相(0~360) 转 RGB565 颜色（饱和度和亮度都取 100%）
      入口数据：h  色相 0~360
      返回值：  16 位颜色值
******************************************************************************/
static u16 HueToColor(u16 h)
{
	u8 r = 0, g = 0, b = 0;

	if(h < 60)												//红 -> 黄
	{
		r = 255;
		g = (u8)((u32)h * 255 / 60);
	}
	else if(h < 120)										//黄 -> 绿
	{
		r = (u8)(255 - ((u32)(h - 60) * 255 / 60));
		g = 255;
	}
	else if(h < 180)										//绿 -> 青
	{
		g = 255;
		b = (u8)((u32)(h - 120) * 255 / 60);
	}
	else if(h < 240)										//青 -> 蓝
	{
		g = (u8)(255 - ((u32)(h - 180) * 255 / 60));
		b = 255;
	}
	else if(h < 300)										//蓝 -> 品红
	{
		r = (u8)((u32)(h - 240) * 255 / 60);
		b = 255;
	}
	else													//品红 -> 红
	{
		r = 255;
		b = (u8)(255 - ((u32)(h - 300) * 255 / 60));
	}

	return RGB565(r, g, b);
}


/******************************************************************************
      函数说明：1. 全屏纯色循环
******************************************************************************/
static void Test_SolidColor(void)
{
	u16 i;

	for(i = 0; i < COLOR_NUM; i++)
	{
		LED1_Toggle;										//每换一种颜色翻转一次LED
		LCD_Fill(0, 0, LCD_W - 1, LCD_H - 1, ColorTab[i]);
		Delay_ms(500);
	}
}


/******************************************************************************
      函数说明：2. 彩条（先竖条，再横条）
******************************************************************************/
static void Test_ColorBars(void)
{
	u8 i;
	u16 w = LCD_W / 8;										//竖条宽度
	u16 h = LCD_H / 8;										//横条高度

	LED1_Toggle;
	for(i = 0; i < 8; i++)									//8 条竖彩条
	{
		LCD_Fill(i * w, 0, (i + 1) * w - 1, LCD_H - 1, BarTab[i]);
	}
	Delay_ms(1500);

	LED1_Toggle;
	for(i = 0; i < 8; i++)									//8 条横彩条
	{
		LCD_Fill(0, i * h, LCD_W - 1, (i + 1) * h - 1, BarTab[i]);
	}
	Delay_ms(1500);
}


/******************************************************************************
      函数说明：3. 16 级灰度条（用于观察屏的灰阶和伽马）
******************************************************************************/
static void Test_GrayScale(void)
{
	u16 i;
	u16 g;
	u16 w = LCD_W / 16;

	LED1_Toggle;
	for(i = 0; i < 16; i++)									//上半屏：16 级灰度
	{
		g = i * 17;											//0,17,34,...,255
		LCD_Fill(i * w, 0, (i + 1) * w - 1, LCD_H / 2 - 1, RGB565((u8)g, (u8)g, (u8)g));
	}

	for(i = 0; i < LCD_W; i++)								//下半屏：连续灰度渐变
	{
		g = (u16)((u32)i * 255 / (LCD_W - 1));
		LCD_Fill(i, LCD_H / 2, i, LCD_H - 1, RGB565((u8)g, (u8)g, (u8)g));
	}
	Delay_ms(2000);
}


/******************************************************************************
      函数说明：4. RGB 三原色渐变（横向亮度从 0 到 255）
******************************************************************************/
static void Test_ColorGradient(void)
{
	u16 x;
	u16 h = LCD_H / 3;

	LED1_Toggle;
	for(x = 0; x < LCD_W; x++)
	{
		LCD_Fill(x, 0,     x, h - 1,     RGB565((u8)(x * 2), 0, 0));			//红渐变
		LCD_Fill(x, h,     x, 2 * h - 1, RGB565(0, (u8)(x * 2), 0));			//绿渐变
		LCD_Fill(x, 2 * h, x, LCD_H - 1, RGB565(0, 0, (u8)(x * 2)));			//蓝渐变
	}
	Delay_ms(2000);
}


/******************************************************************************
      函数说明：5. 彩虹色带（色相从左到右 0~360 渐变）
******************************************************************************/
static void Test_Rainbow(void)
{
	u16 x;

	LED1_Toggle;
	for(x = 0; x < LCD_W; x++)
	{
		LCD_Fill(x, 0, x, LCD_H - 1, HueToColor((u16)((u32)x * 360 / LCD_W)));
	}
	Delay_ms(2000);
}


/******************************************************************************
      函数说明：6. 16 色方块（4 x 4），方块之间用白色分割线隔开
******************************************************************************/
static void Test_ColorGrid(void)
{
	u8 i, j;
	u16 w = LCD_W / 4;
	u16 h = LCD_H / 4;

	LED1_Toggle;
	for(i = 0; i < 4; i++)
	{
		for(j = 0; j < 4; j++)
		{
			LCD_Fill(i * w, j * h, (i + 1) * w - 1, (j + 1) * h - 1, ColorTab[i * 4 + j]);
		}
	}

	/* 用 1 像素宽的白色分割线把 16 个方格隔开 */
	for(i = 1; i < 4; i++)
	{
		LCD_Fill(i * w, 0, i * w, LCD_H - 1, WHITE);
		LCD_Fill(0, i * h, LCD_W - 1, i * h, WHITE);
	}
	Delay_ms(2500);
}


/******************************************************************************
      函数说明：满屏显示一张 128x160 的图片
                图片数据在 pic.h 里（gImage_pic[]，RGB565，大端）
                想换成自己的照片：python tools\img2c.py 你的图片.jpg MY\pic.h
******************************************************************************/
static void Test_Picture(void)
{
	LCD_Fill(0, 0, LCD_W - 1, LCD_H - 1, BLACK);		//先清屏，图片边缘更干净
	Delay_ms(100);
	LCD_ShowPicture(0, 0, LCD_W, LCD_H, gImage_pic);	//满屏显示图片
	Delay_ms(3000);
}

/******************************************************************************
      函数说明：主函数
******************************************************************************/
int main(void)
{
	Delay_Init();											//延时函数初始化
	LED_Init();												//LED初始化
	LCD_Init();												//LCD初始化

	/* 开机先刷黑屏，确认屏正常工作 */
	LCD_Fill(0, 0, LCD_W - 1, LCD_H - 1, BLACK);
	Delay_ms(300);

	while(1)
	{
		Test_SolidColor();									//1. 全屏纯色
		Test_ColorBars();									//2. 彩条
		Test_GrayScale();									//3. 灰度条
		Test_ColorGradient();								//4. RGB 渐变
		Test_Rainbow();										//5. 彩虹色带
		Test_ColorGrid();									//6. 16 色方块
		Test_Picture();										//7. 满屏图片
		Delay_ms(500);
	}
}
