2186279865/robot-10.15/xrw/例35 视觉XY接近跟随(1)(2)/HARDWARE/S20/s20_servo.h

#ifndef S20_SERVO_H
#define S20_SERVO_H

#include "sys.h"
#include "app_config.h"

/* TIM4_CH1：PB6。例26使用PA2/PA3，例28使用PC6/PC7/PC8，资源不冲突。 */
#define S20_SERVO_PORT GPIOB
#define S20_SERVO_PIN  GPIO_Pin_6

/* 270°数字舵机，PWM脉宽端点单位us。 */
#define S20_SERVO_MIN_US  500U
#define S20_SERVO_MAX_US 2500U
#define S20_SERVO_TARGET_DEG 180U
#define S20_SERVO_SWEEP_HOLD_MS 1000UL
#define S20_SERVO_OPEN_DEG CLAW_OPEN_DEG
#define S20_SERVO_OPEN_SETTLE_MS CLAW_OPEN_WAIT_MS
#define S20_SERVO_GRAB_DEG CLAW_GRAB_DEG
#define S20_SERVO_GRAB_SETTLE_MS CLAW_GRAB_WAIT_MS

void S20_Servo_Init(void);
void S20_Servo_SetAngle(uint16_t angle);
uint16_t S20_Servo_AngleToPulse(uint16_t angle);

#endif
