2186279865/robot-10.15/01-交付包/host/auto_grab.py

"""自动抓一件：视觉识别 → 算 X/Y → 抓 → 抬 → 回 P1 → 降 → 退 P0 → 转盘 → 松爪。

设计原则
--------
* **只用手工验证过的原语**：`prep_pose.move_abs`（绝对位置、带单步上限、优先用
  回读 counts 算增量）负责所有平移，`client.angle` 负责转盘，
  `client.send('gripper', ...)` 负责夹爪。自动流程与手动按按钮走同一套代码。
* **不猜位置**：`move_abs` 拿不到回读 counts、也没有软位置时会直接拒绝
  （POS_UNKNOWN），本模块不做任何"盲走"兜底 —— 撞一次机的代价太大。
* **顺序固定**（现场验证过的 10 步）：
  Z 抬顶 → X/Y 到物块上方 → Z 降底 → 夹紧 → Z 抬顶 → X/Y 回 P1
  → Z 降底 → Y 退 P0 → 转盘 60° → 松爪 180 → 500 ms 后回预备角度（存盘值，默认 158）。
* 视觉只给 `center_tray` 的 (u, v)，X/Y 脉冲由 `vision/tray_calib.json` 的仿射
  （a/b/c/d/tx/ty）反算，所以换相机或挪支架必须重新标定。
"""

from __future__ import annotations

import json
import threading
import time
from pathlib import Path
from typing import Callable, Dict, Iterable, List, Optional, Tuple

import box_map as BM
import prep_pose
import display_link
import protocol as P

PKG_ROOT = Path(__file__).resolve().parent.parent
TARGETS_PATH = PKG_ROOT / 'vision' / 'runtime' / 'latest_targets.json'
CALIB_PATH = PKG_ROOT / 'vision' / 'tray_calib.json'

AXIS_Z = prep_pose.AXIS_Z          # 1
AXIS_TRAY = 3
AXIS_X = 4
AXIS_Y = 5

#: 现场实测：Z 底部 0 = 抓取位、Z 顶部 −152,000 = 抬起位、通道末端 Y = −13,144
Z_DOWN = 0
Z_UP = -152000
P1_Y = -13144
P0_Y = 0
TRAY_DEG = 60.0

# 2026-10-31 用户明确要求「Z 降到底夹紧后立刻抬升」：夹紧指令发完就走，
# 不再等舵机合拢 —— 固件 `host_cmd_gripper` 调完 `control_gripper_apply`
# 立刻回 ok（`host_protocol_inline.h:2112-2185`），舵机自己在 200 ms 内合拢，
# Z 抬升时爪子已经夹住，两者本来就并行。
SETTLE_GRAB_MS = 200       # 夹紧后停 200 ms 再抬 Z（用户 2026-10-31 明确：这里稍微等 0.2 s）
# 「Z 降到底 → 立刻松爪」：不再等转盘、也不再等落盒，Z 就停在底部，
# 下一件的 ①Y 进通道本来也要求 Z 在底。
#
# **但松爪后的「张嘴时间」不能为 0**（2026-10-31 现场教训）：
# 固件 `host_cmd_gripper`（host_protocol_inline.h:2112-2185）收到 ready 会
# 立刻 `Servo_SetAngle(168)` 覆盖 PWM，不看 busy、不等舵机；
# 如果 open 和 ready 背靠背下发（间隔 ~1 ms），舵机来不及从 135° 张到 180°，
# 现场看起来就是「爪子没松 / 没回到张开的预备角度」，物块也可能不掉。
# 舵机 135°→180° 约需 0.1~0.2 s，这里留 0.22 s 张口；
# 回预备（180°→168°）仍然不等，它在下一件 ②Z 抬顶期间自己转完。
SETTLE_OPEN_MS = 220       # 松爪后给舵机张嘴的时间（原 0 = 张不开；再早是 150/500）
SETTLE_READY_MS = 0        # 回预备位不再单独等（下一段运动期间舵机自己转完）

#: 在位判定：|残差| ≤ 60 脉冲（≈0.6 mm）就当已经在位，不再为 10 脉冲跑一趟往返。
IN_PLACE_TOL_PULSES = 60.0

#: 编码器读数"够新"门槛（ms）：超了就再取一次（最多 ~0.06 s），
#: 不再像以前那样死等 0.6 s 稳定才肯发下一条（现场每件白等 4~5 s）。
#: 现场实测拥塞时遥测 age 常到 400~800 ms（02:22 那批「读数不够新」42 次），
#: 门槛放到 800 ms、重取只 2 次：老一点也照走，精度由并行残差复核兜住。
COUNTS_MAX_AGE_MS = 800.0

#: 「预走」= ①Y 进通道 → ②Z 抬顶（与识别并行，2~6 s 空档正好走完）。
#: 仍必须先 Y 后 Z：穿通道时 Z 必须在底，抬顶只能在 Y 到位之后；抓空时
#: 预走多抬的 1.6 s 由回 P0 的分支吞掉（Z 在顶 → 先降底再退 Y），不会再"高位回 P0"。
#: 只在 Z 确实到底时才敢做（穿通道时通道净高不够）。
#: 400 脉冲 ≈ 0.24 mm（1658 脉冲/mm），比"在底部"更宽松一点点也不会顶到横梁。
PREFETCH_Z_TOL_PULSES = 400

# 转速统一由 host/protocol.py 的 GOTO_RPM_BY_AXIS 决定（这里原来写死 1500/120/300，
# 导致改 protocol 完全无效——日志里一直显示旧转速就是这个原因）
try:
    import protocol as _P
    RPM = {int(k): int(v) for k, v in _P.GOTO_RPM_BY_AXIS.items()}
except Exception:                                  # noqa: BLE001
    RPM = {AXIS_Z: 2200, AXIS_X: 300, AXIS_Y: 2000, AXIS_TRAY: 300}


#: 每个盒位之间的角度（6 个盒子均分一圈）
_ACC_DEFAULT = 0            # 加速度档：0 = 最快（现场实测 acc=1 约慢 10 倍，不能用！）
TRAY_RPM = 6              # 转盘转速（5 很稳、6 略快且顺；10 会甩货）
TRAY_BRAKE_S = 0.18        # 速度模式刹车提前量（秒）
TRAY_TOL_PULSES = 50      # 停车后残差容忍（脉冲）
TRAY_AUTOSCALE = False        # True 时才按“实测一半”自动 ×2 改 tray_scale（容易被 counts 误导，默认关）
TRAY_ACC = 1                  # 位置模式加速度档：1 = 驱动器慢斜坡（转盘惯性大，必须用这个）
TRAY_VERIFY_TOL_PULSES = 40   # 停车后残差超过多少脉冲才补一次
TRAY_WAIT_EXTRA_S = 0.5       # acc=1 斜坡很慢，估算时长之外再多等这么久
TRAY_TIMEOUT_S = 20.0
TRAY_JOIN_TIMEOUT_S = 8.0            # 已不再用于松爪前等待（2026-10-31 起松爪不等转盘），留着给诊断/兼容
# 到位判定放宽（现场：转盘会小幅抖，counts 噪声 ±几十，严格判据会一直等/不松爪）
TRAY_STABLE_COUNTS = 60.0      # 判“稳定”的 counts 抖动容差（原 20 ≈1 脉冲，现 60 ≈3 脉冲）
TRAY_SETTLE_NEED = 2           # 连续稳定采样次数（采样 50 ms）
TRAY_MOVED_OK = 0.72           # 位移达到目标的 72% 即算转到位（原 85%）
TRAY_MOVED_LENIENT = 0.45      # 已等到 elapsed ≥ 1.1×巡航时间 时，只要 45% 位移 + 稳定即算到位
TRAY_TIME_FALLBACK = 1.25      # counts 不可信时：巡航时间 ×1.25 即视为到位（时间收口）
TRAY_RELEASE_TOL_DEG = 4.0     # join 时若残差 ≤4° 也允许松爪

# 转盘软启动/软停车（惯性很大，必须慢升速、慢降速）
TRAY_RAMP_MS = 90            # 每一级升/降速的停留时间（ms）
TRAY_RAMP_RPMS = (0.6, 1.2, 2.0, 3.2, 4.5)   # 升速阶梯（最后一级=TRAY_RPM）
TRAY_DECEL_S = 0.60          # 减速段时长（用于算提前量）
BOX_STEP_DEG = 60.0
BOX_COUNT = 6


def class_key(target: Dict) -> str:
    """物块的类别键：'形状|颜色'（与视觉 class_key 的写法一致）。"""
    shape = str(target.get('shape') or target.get('class_name') or '未知').strip()
    color = str(target.get('color') or '').strip()
    return '%s|%s' % (shape, color) if color else shape


# 视觉偶尔给不出定名（待登记 / 副摄待确认 / — / 未知 / 其他几何体）。
# 这些**绝不能当新类别去占盒子**：6 个盒各占一类，占满后第 7 件就
# 「分盒失败：6 个盒子都已分配给其它类别」直接停批（2026-10-31 07:41、07:47 各踩一次，
# 一次是 `副摄待确认|蓝/浅蓝` 占了 6 号盒，一次是 `待登记|红` 撞上满盒）。
UNNAMED_SHAPES = {'', '—', '-', '--', '未知', '待登记', '副摄待确认', '其他几何体', '物体'}


def shape_of(key: str) -> str:
    return str(key or '').split('|')[0].strip()


def color_of(key: str) -> str:
    parts = str(key or '').split('|')
    return parts[1].strip() if len(parts) > 1 else ''


def is_named(key: str) -> bool:
    """这个类别键是不是"定名"的（能进分盒表）。"""
    return shape_of(key) not in UNNAMED_SHAPES
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
