2186279865/robot-10.15/(commit log)

2026-10-15 初始提交：10.15 工程（舵机/抓夹/按键/步进电机模块）
2026-10-15 gitignore: 排除密钥/凭证，避免私钥入库
2026-10-15 docs: 新增联合开发教程 CONTRIBUTING.md（协作流程/三条铁律/引脚分配）
2026-10-15 docs: 新增从注册账号讲起的联合开发完整教程（944行），并在 CONTRIBUTING 加指引
2026-10-15 重组：仓库根上移到 robot-competition，纳入 xrw 参考示例与 EMM 协议文档
    - ghr/10.15 整体下移一层（内容与历史不变）
    - xrw/例35、例36 纳入同一仓库
    - 忽略规则合并到根目录 .gitignore，修正 *.uvoptx 规则（原写成 *.uvopt 导致本机调试设置误入库）
    - 移除 Project/STM32F407.uvoptx（每台机器不同，不应共享）
2026-10-15 docs: README 更新为单一仓库结构（ghr+xrw 同仓库）
2026-10-15 docs: 按新仓库结构统一文档，补充 SSH/HTTPS 与代理说明
    - 克隆目录统一为 robot-competition，主工程路径明确到 ghr/10.15
    - 附录 A 更新为两段结构（整个仓库 / 主工程），并说明忽略规则已移到仓库根
    - 新增 2.6 节：SSH 与 HTTPS 的区别、是否需开代理、代理设置与排查表
    - README 补充两种远程地址与代理说明
2026-10-15 docs: 新增交接文档（新对话先读这份）
2026-10-16 chore: .gitignore 补充 Python 缓存与 ACL 恢复记录目录
2026-10-16 feat: 新增上位机 PC 端（协议/串口/客户端/模拟器/序列/GUI）
    按 ghr/10.15/上位机方案-v3-TypeC-CDC.md 实现，通信路线为板载 Type-C
    USB CDC，不再使用 USART1 + USB 转 TTL。
    - protocol.py 帧编解码/异或校验/分帧/会话去重/请求 id 池/错误码
    - serial_link.py 串口枚举与退避重连（Windows 文件句柄兜底）
    - host_client.py 握手/心跳/在途请求/超时策略/失联保护
    - simulator.py 无硬件模拟后端，与固件同一套协议
    - sequence.py 动作序列模型与执行器状态机
    - host_gui.py tkinter 五页界面（四轴/夹爪/参数/序列/日志）
    - tests/ 68 个 unittest 全绿，含 tkinter 冒烟测试
    固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
2026-10-16 docs: 新增上位机方案 v1/v2/v3 与两份交接文档
    - 上位机方案.md v1（USART1 路线，历史，含 xrw 可移植代码定位）
    - 上位机方案-v2.md v2（USART1 路线的完整方案，历史）
    - 上位机方案-v3-TypeC-CDC.md 当前生效方案（Type-C USB CDC）
    - 交接文档-20261016.md 早期交接（反汇编核对、模块接口表、踩坑）
    - 交接文档-上位机开工-TypeC-20261016.md 新对话接手文档
2026-10-16 feat: 步进模块电机序号改为映射轴地址，支持指定加速度与解堵转
    - STEPPER_MOTOR_1..4 不再是裸序号，改为 STEPPER_ADDR_Z/托盘/X/Y 的别名；
    stepper_all_addr[] 因此遍历 1/3/4/5，*All() 不再打到不存在的 2 号地址
    - 新增 Stepper_ResetStallAt(addr)：0E 52 解除堵转保护。堵转保护一旦触发，
    只发 F6/FD 电机也不会转，上电先补一帧成本很低
    - 新增 Stepper_MoveRelativeAt2 / Stepper_RunSpeedAt2，可指定 rpm 与加速度；
    原接口保留为使用默认参数的薄封装，行为不变
2026-10-16 feat: 正式固件 PA0 控制 Z 轴，新增独立诊断固件
    main.c：
    - 上电闪一次 LED、解除堵转、全部停止、使能 Z 轴(地址 1)
    - PA0 按下切换 Z 轴转/停，运行中每 250ms 补发一次速度帧
    - 带加速度的速度模式与自动换档参数阶梯表
    main_diag.c + STM32F407_diag.uvprojx：
    - 上电闪两次，FD 位置模式循环走半圈，用于验证电机能转
    - 独立 Keil 工程，不与正式固件共用输出
    两个工程用 ARMCC V5.06 update 6 重新编译通过：
    正式 0 Error 0 Warning，Code=3308
    诊断 0 Error 0 Warning，Code=3044
    仅编译通过，未烧录、未上板验证。
2026-10-16 feat: 上位机行协议固件层（主机侧验证通过，尚未接入 Keil 工程）
    新增（都不在 uvprojx 编译清单里，main.c 暂未 include，因此不影响现有固件）：
    - Drive/Include/host_transport.h USB CDC 传输层接口（HostLink_*），只定接口不实现
    - Drive/Include/control_inline.h 统一控制状态：四轴状态/停止锁存/四轴停车/夹爪角度
    - Drive/Include/host_protocol_inline.h 行协议：分帧、异或校验、请求去重、命令分发、
    参数、遥测、心跳失联；位移类指令一律 wait_ms=0（非阻塞）
    - Test/host_protocol/ 主机侧自测：把 Stepper_*/Servo_*/HostLink_* 换成桩，
    在 PC 上直接编译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
2026-10-16 chore: 主机侧测试产物不入库（frames.txt/*.pdb/.exe）
2026-10-16 feat: 新增 ST USB OTG 设备库（V2.2.0）与 HostLink 适配层
    - USB/：ST 官方 STM32_USB-Host-Device_Lib_V2.2.0 原始库（OTG 驱动/设备核心/CDC 类）
    + 本工程适配的 usb_conf.h、usbd_conf.h、usbd_desc.c/h、usb_bsp.c
    + MCD-ST Liberty SW License Agreement V2 许可 PDF + 移植说明 README.md
    - Drive/Source/host_usb.c：host_transport.h 的实现。发送直接写 CDC 类的 APP_Rx_Buffer
    （按剩余空间检查，不足则整体拒绝，绝不发半帧）；拔线/复位清收发队列与半帧；
    '!' 停止字符在 OUT 回调里锁存。中断内不调用靠 SysTick 的 Delay_ms。
    - 只启用 USB OTG FS + Device 模式，不定义 VBUS_SENSING_ENABLED（P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
2026-10-16 chore: Keil 工程接入 USB 栈，器件由 ZGTx 更正为 VGTx
    - 正式工程新增 USB 组（usb_core/usb_dcd/usb_dcd_int/usbd_core/usbd_ioreq/usbd_req/
    usbd_cdc_core/usbd_desc/usb_bsp 共 9 个），Drive 组新增 host_usb.c
    - IncludePath 增加 USB/App、STM32_USB_OTG_Driver/inc、设备核心 Core/inc、CDC 类 inc
    - 两个工程器件 STM32F407ZGTx -> STM32F407VGTx：实际芯片确认是 VGT6（1MB Flash），
    ZGTx 与 VGTx 同为 1MB、Flash 算法不变，只是把工程配置改成与实物一致
    - 正式工程全量构建 Code=23644 RO=636 RW=656 ZI=6704，0 Error 0 Warning
2026-10-16 feat: 正式固件接入上位机行协议，PA0 与 PC 共用一套状态
    - main.c 引入 host_transport.h / control_inline.h / host_protocol_inline.h，
    主循环每轮调用 HostLink_Poll() 与 host_protocol_task()
    - 去掉只发不收时代的自动换档阶梯与每 250ms 补发 F6：上位机接上后由 PC 指定转速，
    固件不再自作主张换档，也不在总线上重复制造同一条运动指令
    - 时间基准从 "ms += KEY_TASK_MS" 估算改为 Stepper_Millis() 实测
    - PA0：空闲时按 speed_rpm/acc 参数启动 Z 轴；有轴在转时停止全部并置停止锁存；
    已锁存且都停着时解除锁存（PC 端等价命令是 stop_clear）
    - 回读线尚未接，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
2026-10-16 feat: Z 轴回读（PA3/USART2 接收 + EMM V5 回包解析）
    - stepper_inline.h：USART2 打开接收，PA3 配 AF 复用，RXNE 中断 + 环形缓冲
    每次取一字节；只接 Z 轴（地址 1）这一路，四路 TX 不能因地址不同直接并联。
    - emm_reply_inline.h（新增）：按功能码长度表逐字节分帧、位置(0x36)/转速(0x35)/
    状态(0x3A) 解码、一次只留一个查询事务、0xFD 到位通知单列不当事务结果、
    本地址回了别的查询应答时报 E05 而不是硬等到超时。
    - host_protocol_inline.h：motor_query 改成"发询问帧 -> 等回包 -> 再回应答"，
    无回读能力的轴立即 E11，遥测订阅有回读的轴时后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
2026-10-16 feat: 多轴回读——readback_mask 声明接线，遥测四轴一起刷新
    - 新增运行参数 readback_mask（bit0=Z(1)/bit1=托盘(3)/bit2=X(4)/bit3=Y(5)，默认 1）：
    接线变了只改参数、不用重烧；名单外的轴 motor_query 一律回 E11，绝不编造实测值
    - hello 的 readback 字段按掩码生成（如 1/3/4/5），PC 端据此显示"该轴未接回读"
    - 遥测每拍轮询一个回读轴（1->3->4->5），并给订阅轴和其余回读轴各报一帧，
    四个轴的实测值一起刷新；各轴读数分槽存放，不串台
    - host_protocol_init 恢复出厂参数默认值；轮询位置归零，新会话不再从中间某个轴开始
    - 模拟后端与固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
2026-10-16 fix: 夹爪上电没初始化舵机 PWM，上位机点不动夹爪
    问题：用上位机点“夹紧/松开”，夹爪完全不动。
    根因：正式固件 MY/main.c 从来没调用过舵机初始化。Servo_Init()/Gripper_Init()
    整份工程里没有任何调用点，PB6/TIM4_CH1 根本没有 PWM 波形输出；
    协议层把 gripper 命令正确下发到 Servo_SetAngle() 也只是改了个 CCR 寄存器，
    引脚上没有任何信号（v3 方案里其实写过“正式/诊断入口均未初始化舵机”）。
    改动：
    - servo.h/servo.c：新增 Servo_InitAt(angle)，PWM 直接从指定角度起振；
    Servo_Init() 变成 Servo_InitAt(SERVO_OPEN_DEG)，原有行为不变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
2026-10-16 fix: 夹爪夹紧位改成 135 度（180-45），不是 0 度
    用户要求：夹紧不是 0 度，是 180-45 = 135 度。
    原来夹紧端点写的是 0 度（走完 180→135→90→45→0 四步才夹紧），
    现在夹紧位就是 135 度，180 度到 135 度一步即到位。
    - Drive/Include/gripper.h：GRIPPER_GRAB_DEG 0U -> 135U。
    - Drive/Source/gripper.c：参考副本的注释同步（GRAB 0 -> 135）。
    - Drive/Include/host_protocol_inline.h：参数表默认值
    { "gripper_grab_deg", 135U, 0U, 270U }。
    param_set 仍可在线上改这个端点，改完不用重烧固件。
    - 上位机 protocol.py：PARAM_DEFAULTS["gripper_grab_deg"] = 135（模拟器与 GUI 都从这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
2026-10-16 feat: 上位机位置模式可编辑目标（脉冲/圈数 + 相对/绝对），并修掉三处真问题
    位置模式（按"加入一个修改位置模式的功能"实现）：
    - 四轴控制页的目标位置可用脉冲或圈数任一输入，两框双向联动（1 圈 = 3200 脉冲 = 360°）
    - 拆成"相对走"(mode=rel) 与"绝对走到此"(mode=abs) 两个按钮，下拉框显示当前模式
    - 绝对位置必须有位置基准：界面记录该轴是否建立过基准（点过位置清零或明确确认），
    未建立时先弹确认框；重新握手（新会话）把四轴基准全部作废
    - 固件侧的门（基准无效回 E13）不变，界面按 E13/E04 给出可执行提示
    -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
2026-10-16 docs: 新增《上位机使用手册》（接线/启动/逐页操作/序列示例/错误码/故障排查）
    - ghr/10.15/上位机使用手册.md：面向使用者的完整操作手册
    （硬件接线与电源、烧哪个 hex、启动参数、五个分页逐项说明、位置模式与位置基准、
    停止与锁存、13 个参数表、序列示例骨架、错误码速查、常见故障表、协议速查、
    以及"已跑通/未验证"的诚实清单）
    - 上位机/README.md 顶部加一句指向手册的链接
    参数表按源码核对：heartbeat_ms 与 telemetry_ms 目前只保存/回读、不参与判定，
    手册里如实写明（上位机固定 1 秒 ping、遥测周期由 tele_on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
2026-10-16 Revert "docs: 新增《上位机使用手册》（接线/启动/逐页操作/序列示例/错误码/故障排查）"
    This reverts commit 11b6f31e2e486f3150199df81578ae47c37ae3cd.
2026-10-16 Revert "feat: 上位机位置模式可编辑目标（脉冲/圈数 + 相对/绝对），并修掉三处真问题"
    This reverts commit 77b8557fbe21f67612ca7dce68b889b7c45dfb5e.
2026-10-16 Reapply "feat: 上位机位置模式可编辑目标（脉冲/圈数 + 相对/绝对），并修掉三处真问题"
    This reverts commit c7d98b6e0a153217c601ab8805338fe0bb002b20.
2026-10-16 feat: 位置手动输入改成"转几圈 + 转几度"，自动折算脉冲
    用户要求：位置能手动输入转几圈、转几度。
    - host_gui.py AxisPanel：去掉脉冲输入框，改成两个输入框
    「位置：圈 [1.00] 度 [0.0]」→ 实时显示折算结果「3200 脉冲」，
    换算 1 圈 = 3200 脉冲 = 360°（1° = 3200/360 脉冲，四舍五入到整脉冲）。
    目标行显示"目标位置：1.00 圈 + 45.0° = 3600 脉冲（405.0°） 相对走"。
    - 圈/度相加：1 圈 + 45° = 3600 脉冲；只填 90° = 800 脉冲。
    - 都填 0 → 不下发只提示；负数/非数字 → 输入无效、不下发。
    - 相对走 / 绝对走到此、位置基准门（E13）、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
2026-10-16 feat: 回读轴默认改成四轴都接（readback_mask 默认 15）
    用户要求把 X、Y、托盘的回读一起接进来。
    - host_protocol_inline.h：readback_mask 出厂默认 1 -> 15（bit0=Z、bit1=托盘、
    bit2=X、bit3=Y），MCU 复位后四轴都在 hello 的回读名单里；注释写清四路 TXD
    不能直接短接、以及没接线的轴要改小掩码（否则查询刷 E04）。
    - protocol.py / simulator.py：PARAM_DEFAULTS 与模拟后端同步为 15；
    simulator.READBACK_AXES 由默认掩码推导，不再写死 (1,)。
    - 测试同步：固件侧 multiaxis 用例改成"默认四轴都接 -> 改 1 时其它轴 E11 ->
    改回 15"；errors 用例与 readback 用例里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
2026-10-16 docs: 补上只能四路 TXD 拧一起时的风险、自检步骤与退路（readback_mask 单轴法）
2026-10-20 feat: 同步 10.17/10.19 调试版本、new_eye 视觉上位机与 Qwen 脚本
    - ghr/10.17、ghr/10.19：新增调试阶段的 Keil 工程源码快照
    - ghr/10.15/上位机：新增标定对话框/标定向导、视觉抓取、视觉导入及对应测试
    - new_eye：新增视觉上位机源码，以及交接 / 标定操作 / 联调通讯三份文档
    - Qwen：新增视觉识别脚本（.venv、模型、下载缓存约 33GB 已在 .gitignore 排除）
    - 根目录：纳入 crop_test.jpg 测试图与 pdftext 文本资料
    - .gitignore：新增大模型权重、build/ 副本、运行时日志的忽略规则
2026-10-20 chore: 取消跟踪 new_eye 运行时输出 latest_targets.json
2026-10-20 docs: 新增换机复刻流程（L1 固件/L2 上位机/L3 视觉/L4 大模型）
2026-10-20 feat(final): 一体化视觉+控制软件快照与使用说明
    final/ 自包含发布目录：main.py 统一入口、视觉 new_eye（含 SAM 权重，Git LFS）、10.15 上位机与固件工程、docs 比赛规则、使用说明.md。
2026-10-20 docs(final): README 指向完整使用说明
2026-10-23 chore(snapshot): 2026-10-23 可运行版本快照（10.21 一体化 + 固件夹爪三档 + 方案与调研文档）
2026-10-23 refactor: 拆成 01-交付包 / 02-资料库 / 03-实验台
    - 01-交付包：10.21 的代码按 stm32/orangepi/vision/host 重排，路径改为相对计算；
    新增 README/VERSION/CHECK.py、固件源码+hex、runtime 占位；selftest.bat 适配新布局
    - 02-资料库：赛题、硬件、xrw（去 backup）、历史快照（去模型）、调研报告、交接教程、
    截图；新增 00-项目日志.md（12 条行为与取舍记录）、决策记录.md、模板
    - 03-实验台：Qwen 移入 Qwen-VLM（33.7 GB，已 gitignore）、SAM 上派实测、网络化原型
    - 根 README 改为三文件夹导航；模型 *.pt 仍不入库
2026-10-23 chore: 清理重构前的旧目录与根目录重复文档
    内容已全部并入 01/02/03（核对 19 项关键文件存在后才删）：
    - 10.21/ final/ new_eye/ ghr/ xrw/ build/ → 已迁入 01-交付包 与 02-资料库
    - 根目录 6 个重复文档 → 02-资料库/01-赛题、06-交接与教程、01-交付包/stm32/docs
    - 先补归档 ghr/10.15/Test（3.7 MB）与 4 个 backup_before_* 到 02-资料库/04-历史快照/固件-Test与备份
    - 仓库 34.6 GB / 34098 文件 → 33.3 GB / 31689 文件；顶层只剩 01/02/03 + README
    验证：CHECK.py 19/19 通过、selftest.bat /quick 全绿
2026-10-23 docs(01): 说明 .venv 是本机产物（开发机为 junction），换机需跑 setup.bat；清理 pip 临时目录
2026-10-24 chore: 给 01-交付包的模型路径也加 LFS 规则（防止误把 357MB 权重直塞 git 历史）
2026-10-24 chore: .survey/ 开发脚本不入库（临时验证脚本，路径绑定开发机；整理后的报告已在 02-资料库/05-调研报告）
2026-10-24 docs: 记录 GitHub 上传（日志条目 + VERSION 远程仓库信息）
2026-10-25 feat(firmware): 闭环 motor_goto（遥感读数闭环）+ 上位机接入 + 自测工具
    固件（0 Error 0 Warning，Code 28,000 → 30,300，hex 81,951 → 89,098 B）：
    - emm_reply_inline.h：加 Emm_PulsesToCounts / Emm_CountsToPulses（int64 中间量）
    - host_protocol_inline.h：E14；HostParam 的 value/min/max 扩到 uint32；参数 15 → 21
    （counts_per_rev / goto_tol_counts / goto_rpm / goto_final_rpm / goto_max_passes / goto_max_ms）；
    HostGoto 状态机（COARSE → SETTLE → MEASURE → CORRECT，读 host_axis_read 缓存）；
    host_cmd_motor_goto；抢轴保护；停止/失联中止；hello 丢弃旧 goto；sweep 优先刷 goto 轴
    - 目录：Keil 工程从 stm32/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
2026-10-25 feat(d0): 动态盒映射 + 角度模式 + 自动抓放状态机 + 派端显示页
2026-10-25 chore: hex/bin 按二进制入库（避免 CRLF 被规范化）
2026-10-25 chore: 重新按二进制存 hex（尺寸与 Keil 产物一致）
2026-10-25 chore: 忽略 3d/（本地 3D 打印件模型不入库）
2026-10-26 refactor(units): 统一单位口径（对外一律脉冲，counts 只在回读/容差）
2026-10-27 docs(teammate): 队友视觉调试包（只读看图 + 离线识别 + 一键自检 + 真机样例）
2026-10-27 docs(teammate): 修正样例图说明（real_new0=侧视 / real_new1=顶视）
2026-10-27 feat(model): SAM-B 权重经 Git LFS 入库（358MB），队友 clone 即可拿到
2026-10-27 docs: 模型经 LFS 入库后的说明同步（根 README/队友包）+ Qwen 实验代码入库
2026-10-27 feat(bridge): 串口桥控制口改独占 + 新增只读观察口 5054（防止两台上位机抢控制权）
    用户反馈：队友的上位机会和本机 GUI 抢连接。根因是 pi_agent 的 SerialBridge 原本允许多客户端并发写串口、回包广播。
    - pi_agent: 5058 同一时刻只允许一个控制方；第二个连接立刻关闭并写日志提示改连观察口；
    控制方断开立即释放，静默 10 s 自动释放（_reap_idle_owner，接管时重置静默计时）
    - 新增 --observer-port 5054 只读观察口：收广播、写入一律丢弃；--no-bridge-exclusive 仅供测试
    - host_gui: 连接失败提示里加"独占控制口"排查项
    - tools/bridge_owner_chec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
2026-10-27 feat(preset): 标定页加固定位置按钮（回P1/Z抬顶/Z降底/走通道/退通道）+ 自动抓放通道参数
    - prep_pose.move_abs(): 按目标位置闭环走增量，优先回读 counts，无位置来源拒绝（POS_UNKNOWN）、单步超行程 1.5 倍拒绝（RANGE）、已在目标位跳过
    - calib_tab: 一键走出固定路线旁新增 5 个按钮，确认框显示脉冲与 counts，后台线程执行
    - runtime/route.json: 自动抓放的 corridor（先 Y 后 Z）、z_low/z_pick/z_high、p0/p1，倒序取反由 auto_runner 自动生成
2026-10-27 chore: 补 route 模板、prep_pose 测试断言、最新 X/Y 标定（锚定平移）
2026-10-27 perf(host): 加速度默认 0（最快）+ 删除错误接近段/回初始位数据 + 界面日志落盘
    - prep_pose: DEFAULTS 增 acc=0；run()/move_abs() 下发 param_set acc；prep_pose.json 增 acc
    - calib_tab: 一键走固定路线/回P1/抬Z/降Z 等预设统一带 acc（从 prep_pose.json 读）
    - host_gui: 四轴面板加速度默认 1→0、标签「加速度(0=最快)」；_log() 同时落盘 runtime/host-YYYYMMDD.log（4MB 轮转）
    - 删除 runtime/approach_route.json（净 Y-10998/Z-170304 的错误行程）与 runtime/journey.json（残留）
    - host 单测 220 OK
2026-10-27 perf(host): 闭环 goto 提速（rpm 默认 1500）+ 固定位置按钮 rpm 40/60/80 -> 1500
    - host_client.goto: 不传 rpm 时用 GOTO_DEFAULT_RPM=1500（原来走固件默认 60，Z 满行程 72 s）；超时估算按驱动器上限 274 圈/分封顶
    - calib_tab.PRESETS: 回P1/抬顶/降底/走通道/退通道 全部 rpm=1500
    - 实测（日志）：Z 152000 脉冲 rpm=40 -> 71.7 s、rpm=60 -> 48.1 s、rpm=1500 -> 约 10.4 s（驱动器自身上限）
    - host 220 单测 OK
2026-10-27 feat(host): 夹爪预备位 150 -> 158（连上自动 param_set，不重烧固件）
    - protocol: 新增 GRIPPER_READY_DEG=158（PARAM_DEFAULTS 仍与固件出厂值 150 一致，测试不破）
    - host_gui: 连上后先 param_set gripper_ready_deg 158 再发 gripper ready；按钮/状态/说明都用该常量
    - tests: gui_smoke 断言改 158；220 单测 OK
    - docs: README / 一体化使用说明 / 网络协议-接口约定 同步 158
2026-10-27 feat(host): 按轴设置闭环速度（Z 1500 / Y 300 / X 120 / 托盘 300）
    - protocol: 新增 GOTO_RPM_BY_AXIS
    - host_client.goto: 不传 rpm 时按轴取默认
    - prep_pose.move_abs: rpm 支持 {轴: 转速}，内部 rpm_for(axis)
    - calib_tab.PRESETS: 回P1 = {1:1500, 4:120, 5:300}；抬顶/降底 Z 1500；通道 Y 300
    - 目的：X 回 P1 不再一瞬冲过去（0.37 s -> 约 1 s）；Z 保持最快
    - 220 单测 OK
2026-10-27 fix(host): 固定位置按钮卡在「还有动作在跑」——int(dict) 抛异常导致 _prep_running 永不复位
    - on_preset: rpm 现在可能是 {轴: 转速} 字典，不能再 int(rpm)；改为原样传给 worker
    - 线程启动放进 try/except，失败立刻复位 _prep_running 并把异常写进日志
    - 增加 10 分钟兜底：标志卡住自动放行（并提示重试）
    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
2026-10-27 feat(auto): 自动抓一件（视觉识别→X/Y→抓→抬→回P1→降→退P0→转盘→松爪）
2026-10-27 fix(vision): 单次识别崩溃（feature=None 时 np.linalg.norm 抛 TypeError）+ 识别异常落盘 vision_error.log
2026-10-27 fix(auto_grab): 修正固定路线顺序——先 Y 进通道再抬 Z（穿通道时 Z 必须在底部）
2026-10-27 docs(calib_tab): 自动抓一件确认框按修正后的顺序（先 Y 进通道再抬 Z）描述
2026-10-27 feat(auto_grab): 抓完落货改为可选（默认停在 P0，物块留在爪里）
2026-10-27 feat(calib): 抓取点标定——手动抓成功后记录 (u,v)<->(X,Y)，拟合仿射并写入 tray_calib.json
2026-10-27 feat(calib): X/Y 标定页加顶视小预览（336x189, 0.25s 刷新）
2026-10-27 feat(calib): 预览叠加四点框与标注点 P1..Pn
2026-10-27 fix(gui): 切页后界面卡死——refresh 每次调用都重复挂 80ms 定时器，改为单条循环；标定页预览仅可见时刷新
2026-10-27 fix(calib): 按手动抓取实测修正 Y 基准(ty -43045) + 放开 X/Y 软限位
2026-10-27 fix(calib): Y 比例按像元等比修正 c=-14203，ty 用实测锚点重定
2026-10-27 chore(limits): Y 下限放到 -55000 以容纳托盘最远端
2026-10-27 fix(host): 补 GOTO_DEFAULT_RPM 定义（转盘/松爪 NameError）+ 新增连续抓 N 件
2026-10-27 fix(calib): 连续抓按钮改用 app.client/say 并包 try/except（点不动=AttributeError）
2026-10-27 fix(calib): 自动抓/连续抓前自动订阅遥测，避免 POS_UNKNOWN 拒绝执行
2026-10-27 chore(gitignore): 忽略抓取点单测临时目录 grasp_io_*
2026-10-27 chore(calib): 提交现场四点框选与 5 点抓取标定结果；忽略备份文件
2026-10-27 fix(calib): 连续抓必须勾落货，否则拦下（避免夹着货去抓第二件）
2026-10-27 fix(calib): 连续抓传 pos_source 快照而非可调用对象，导致 POS_UNKNOWN（单次正常）
2026-10-27 feat(grab): 连续抓接入动态分盒（同类同盒）+ 分盒清零按钮
2026-10-27 feat(vision): 单次识别改后台线程 + 进度条，界面不再卡死
2026-10-27 feat(ui): 顶栏加大初始化/位置清零/四轴位置；视觉页改目标列表+抓取按钮；四轴页加状态总览与固定位置按钮，示教折叠
2026-10-27 feat(init): 初始化时用编码器回读建立四轴位置基准并打开闭环
2026-10-27 feat(ui): 舵机夹爪并入运动控制页；轴卡片高级收进菜单；标定页去掉重复固定位置键并加标定状态行
2026-10-27 feat(run): 新增「运行台」页（顶视大画面 + 一键开始/暂停/停止 + 进度 + 结果表），放在第一个标签
2026-10-27 feat(run): 运行台主摄改用「校正图+四点框+标注点+目标框」合成画面（与视觉页一致）
2026-10-27 fix(run): 运行台改为调用 auto_grab.run_many（与连续抓同一套逻辑），run_many 增加 on_event 回调 + 事件用例
2026-10-27 fix(vision): cam_map 改回 {1:1, 2:0}——顶视=派槽1、副摄=派槽0（四点框分别贴合对应画面）
2026-10-27 revert(run): 删除「运行台」页（逻辑不正确），页签恢复 7 个，视觉/标定索引回到 0/2
2026-10-27 chore(release): 保存现场 5 点抓取标定记录（grasp_pairs.json）并锁定当前完整版本
2026-10-27 feat(vision): 形状判定改为「毫米尺寸+几何基元容错链」，分割掩膜加闭运算填洞，阈值进 config（10 项新单测）
2026-10-27 feat(vision): 新增菱体/菱形类（extent+rect_fit 判据），并锁死旋转正方形/六棱柱不被误判（+2 单测）
2026-10-27 chore(vision): 清空旧 class_map（6 条错误硬映射会抢答），改为全量动态登记+分盒
2026-10-27 feat(vision): 新增「形状标定」按钮（mm/px + 顶视深度修正 k_front + 副摄高度修正 k_h），并接入侧视高度做二次判定（+13 单测）
2026-10-27 fix(vision): 形状标定先暂停实时分割、自动重试 3 次并打印每路目标数，提示更明确
2026-10-27 fix(vision): 形状标定前先 ensure_segmenter()，修 'NoneType' has no attribute 'segment'
2026-10-27 fix(vision): 形状标定改用 bbox_warped（校正图像素），修尺寸全 0
2026-10-27 feat(vision): 形状标定改用「已知方块反推 mm/px」，不再依赖 tray_mm 名义值（四点框框内框也能标）
2026-10-28 revert: 回滚到 2026-10-27 21:29 的完整版本（827c53e），撤销形状识别改造/形状标定/菱体判定与 class_map 清空
2026-10-28 chore(gitignore): 忽略 runtime/*.log.* 轮转日志；移除误入库的 host-20261027.log.1
2026-10-28 feat(vision): 视觉页加「交换主副摄」按钮（交换 cam_map 并重连），用于两路相机插反时一键纠正
2026-10-28 fix(vision): 相机下拉改为可手填 + 远程模式扫描派端槽位（readonly 无选项导致下拉空白不可选）
2026-10-28 fix(fusion): 副摄把同一物块拆成多块时，丢弃贴近已配对目标的碎块（新增 duplicate_side 诊断）
2026-10-28 fix(vision): 形状判据改用最小外接矩形填充率+顶点数（旋转不敏感），修正正方体/长方体/五棱/六棱/圆误判
2026-10-28 fix(fusion): side-only 碎块与任何有顶视的目标过近时丢弃（后置过滤，兼容配对内部结构）
2026-10-28 fix(seg): 同一物块的顶面+侧面掩膜按相邻bbox合并成整体（不再当成两个物体）
2026-10-28 feat(vision): 顶面提取后按长宽比判正方/长方（阈值1.30）+ 形状判据调试图落盘
2026-10-28 feat(vision): 形状判据前先去毛刺（最大连通域+开运算+填孔），顶面面积占比限制 0.28~0.85
2026-10-28 fix(vision): 形状判据改为按锐角个数判定（方形族 fill>=.93、菱体 .62-.93、圆类锐角<=2），解决圆柱/菱体/棱柱被判成正方体
2026-10-28 chore: 备份视觉几何判据版本（接入千问前）
2026-10-28 feat(vision): 接入本地千问 qwen3-vl 作形状第二意见（低置信/易混类才调，含预热与缓存）
2026-10-28 feat(vision): 千问改为手动复核按钮（SAM 占显存，运行时自动第二意见会 OOM）；加托盘外目标过滤
2026-10-28 chore(vision): 千问复核 keep_alive 改 120s（模型常驻 2 分钟内，避免每次重载 70s）
2026-10-28 fix(vision): 删掉误放/误调的 _warm_vlm_async（千问改手动复核后不需要开机预热）
2026-10-28 feat(vision): 接入 DeepSeek 云端形状复核（整幅图批量识别+中心匹配，补圆锥/棱锥两类）
2026-10-28 fix(vision): 恢复被误删的 Stream.start/run 等方法（上一步删 _warm_vlm_async 时连带删掉了 Stream 其余方法）
2026-10-28 feat(vision): DeepSeek 主分类（整图一次请求+中心最近配对），去掉千问；SAM 掩膜加颜色一致性防误合并
2026-10-28 feat(vision): DeepSeek 直出目标(SAM只做可选校验)+几何实测颜色修正；提示词只回答托盘内物体
2026-10-28 fix(vision): _shape_of 补 rad_ratio（尖顶度量），使圆锥/棱锥提示可用
2026-10-28 feat(vision): 主分类改为 SAM 定位 + DeepSeek 贴类别（同物多掩膜合并、颜色按掩膜实测），frames_for_vote 5->1
2026-10-28 feat(vision): 双视角联合识别（顶视+副摄同一次请求，center 必填，config.cloud_vlm.views 可切 top/two）
2026-10-28 fix(vision): DeepSeek 未返回目标时显式提示（避免静默回退几何）
2026-10-28 feat(vision): 颜色表补齐橙/紫/白；颜色以 DeepSeek 为准（可配 color_from_mask）
2026-10-28 chore(vision): DeepSeek 与分割目标匹配失败时落盘 vlm_debug.json 便于定位
2026-10-28 fix(vision): 双图 center 自动归一化 + 双图对不上自动回退单图（解决 DeepSeek 分类未匹配）
2026-10-28 fix(tray): 落货转盘改相对脉冲（不依赖角度基准）；GUI 加「托盘角度清零」按钮
2026-10-28 fix(tray,ui): 转盘落货改慢速闭环 goto(rpm=5)；连续抓按钮立即反馈、自动勾落货、去掉模态确认、180s 卡死兜底
2026-10-28 fix(vision): 识别帧数尊重配置（不再强制2帧）+ 分阶段进度提示 + 90s 看门狗可重试 + 云端超时≤8s；移除已废弃的 local_vlm.py
2026-10-28 fix(tray,ui): 转盘全程速度模式 rpm=5（去掉 goto 收尾补差猛转）；连续抓按钮状态/顶栏进度/同键停止；修两个状态依赖测试
2026-10-28 fix(tray): 速度模式 + 编码器实测校验 + 脉冲比例自学习（修只转30°/累积误差），rpm 按比例折算以保持物理角速度
2026-10-28 feat(display): 派端比赛屏改为赛题四列表格版（绝对像素布局、NDJSON v2 协议、假数据演示）
2026-10-28 feat(display): v7 六储物盒分列版式（每列=一类，卡缩略图+#序号，当前盒高亮，底栏最新一件+报警）
2026-10-28 feat(display): 支持 --theme dark/light/blue 三套配色（默认 light），修 lab 默认色被旧主题绑死
2026-10-28 chore: 保存当前现场标定与调试图（改造流水线前的快照）
2026-10-28 feat(vision): 新增快速定位模块 locate_fast（颜色/背景差分+分水岭，~75ms）与对比工具；识别时保存干净校正帧便于离线评测
2026-10-28 fix(vision): 保存干净校正帧改用 imencode+write_bytes（cv2.imwrite 对中文路径静默失败）
2026-10-28 feat(vision): locate_fast 自适应腐蚀拆粘连+色相兜底，中文路径读帧修复；实测 7/7 定位、46ms、多数偏差<1mm
2026-10-28 feat(calib): 抓取点标定加残差预览/删点/重复点替换/离群自动剔除，便于现场重标得更准
2026-10-28 perf(motion): Y 轴 goto 转速 300->800、X 120->300、补差段 60->150；新增 tools/speed_test.py 测丢步
2026-10-28 perf(motion): Z 1500->2200rpm、闭环容差 200->350counts、补差轮数 4->2；转盘 5->8rpm、夹爪等待 700->450/500ms
2026-10-28 perf(motion): Y 轴再提 800->1200 rpm；speed_test 改为可用链路接口并加双击 bat（Y/Z 两档测试）
2026-10-28 perf(motion): Y 1200->1600rpm、转盘 8->10rpm、X/Y 并行 goto 且动作准备指令只发一次（省 3 次往返/段）
2026-10-28 fix(motion): 回退 X/Y 并行——固件 host_goto 只有一个执行槽，第二条 motor_goto 返回 E09 goto_busy；保留 prep 只发一次
2026-10-28 chore: 保存 10-29 早间版本（Y1600/转盘10/prep优化/顺序goto），改固件前快照
2026-10-28 perf(motion): 到物块上方这一步改用 motor_pos 让 X/Y 真并行（固件 host_goto 单槽不支持并行，motor_pos 每轴独立）；带速度上限临时放开与回读校验补差
2026-10-28 fix(motion): X/Y 并行后不再固定 sleep（原来按 timeout 估算睡满 8s = 停顿），改为轮询编码器到位即走；Y 再提 1600->2000 rpm
2026-10-28 fix(motion): auto_grab 的 RPM 改为读 protocol.GOTO_RPM_BY_AXIS（原来写死旧转速导致提速全部无效）；X/Y 并行轮询改用 client.last_counts + 超时 3.5s
2026-10-28 feat(motion): 动作更顺——加速度档 0->1（起步/停止不再弹）、X 300->600 rpm、转盘 10->6 rpm
2026-10-28 fix(motion): 加速度档回退 0——实测 acc=1 会慢约 10 倍；保留 X=600、转盘=6
2026-10-28 perf(goto): 缩短段间空档 STABLE_NEED 2->1、GAP 20->10ms、STABLE_COUNTS 40->60（编译 0 错，Code=31624）
2026-10-29 fix(motion): move_xy_fast 修 send() 返回 rid 的误用（speed_rpm_max 之前从未放开，motor_pos 被拒→X/Y 没动）；补 motor_pos 回执校验与顺序 goto 退化
2026-10-29 test: move_xy_fast 兼容 FakeClient（无 wait_reply 时跳过参数调优与回执校验），248 单测恢复全绿
2026-10-29 perf(motion): 初始化把 telemetry_ms 降到 100/query_timeout 60（少等到位）、长行程加速前加 200 脉冲软启动垫片（起步更柔）
2026-10-29 perf(motion): 按用户选择 A —— Y 2000->1800、Z 2200->2000（起步更柔，节拍 +0.2s）
2026-10-29 perf(motion): 软启动垫片 200->600 脉冲(约 6mm) @300rpm，起步更柔
2026-10-29 test: 跟随软启动改成常量 SOFT_PULSES（248 绿）
2026-10-29 perf(motion): 软启动改两台阶（300rpm x300 + 900rpm x300），台阶幅度减半即中段不掉速
2026-10-29 test: 软启动断言改为两级台阶（248 绿）
2026-10-29 feat(display): 上位机接 5059 推送（state/item/item_done/alarm + 96px 缩略图 + 5s 保活），派端屏修顶栏盒号重复
2026-10-29 feat(display): 单件抓也推派端屏（item/item_done/state）；保活不再把计数刷回 0/0
2026-10-29 feat(motion): 长行程末段减速（最后 700 脉冲用 35% 速度收尾）缓解停车冲击；测试同步放宽
2026-10-29 feat(motion): X/Y 单独调柔（三级软启动+收尾1300脉冲30%）+ X 450/Y 1400 rpm；固件加预转软启动（hex 已更新，Z 不动）
2026-10-29 feat(motion): X/Y 并行段也改三段式（慢垫片→全速主体→慢收尾），消除并行起步/停车顿挫
2026-10-29 revert(motion): 运动控制回到 snapshot-20261029-0715（Z2200/X300/Y1600、无软启动/末段减速/并行；固件回到 prespin 前并已重烧）
2026-10-29 fix(grab): 第3步回到 07:15 的顺序 move()，删掉用陈旧遥测做二次校验导致的重复下发（现象：先走偏再补回来）
2026-10-29 feat(motion): X/Y 恢复一步并行（两轴同时 motor_pos + 新鲜编码器闭环收口，失败轴顺序补走）
2026-10-29 feat(motion): X/Y 真正一步并行（两轴 motor_pos 同时下发，按估算时长+停稳判定收口，残差轴再 goto 补）
2026-10-29 fix(motion): 并行后不再乱补走——等满估算时长+3次稳定判定，残差阈值60脉冲，读数滞后(≈整段位移)时跳过补走
2026-10-29 feat(motion): 第3步与第7步（回P1）都改并行一步走；helper move_xy() 统一入口
2026-10-29 chore: 保存可运行版本（X/Y 并行一步走版）
2026-10-29 feat(grab): 连续抓按『自动抓一件』重写——一次识别排队逐件、每件都走 run_once、失败重识别并重试一次；加 3 条队列行为单测
2026-10-29 chore: 保存现场（18:36 基座 + 连续抓重写；含最新标定/运行画面）
2026-10-29 fix(motion): 并行补走等回执、滞后判据改区间、等待时长按有效转速、每件开头清锁存（修连续抓 E09/E14/Y 冲过目标）
2026-10-29 fix(motion): 并行前等 counts 稳定、补走改发相对增量、偏离>3000 拒绝补走、补走失败即中止（修撞机/多走一整段）
2026-10-29 perf(motion): 每步稳定等待改为遥测新鲜度+60ms采样（1.5s→0.1s），并行收口判定缩短
2026-10-29 feat(tools): 新增转盘标定脚本 tray_calib.py（6x60 度实测 counts 反推 tray_scale）
2026-10-29 feat(tray): 转盘改速度模式沿续转（6rpm 匀速+到点前刹车+至多一次补差），消除位置模式的分段顿挫
2026-10-29 feat(gui): 运动控制页加「转盘 +60°/-60°」按钮（走速度模式 tray_turn，便于现场验证顺滑与对位）+ 转盘标定脚本
2026-10-29 feat(tray): 转盘改软启动/软停车（多级升速-匀速-多级降速），消除大惯性猛启动与停车甩动
2026-10-29 feat(tray): 转盘改位置模式 + acc=1 驱动器慢斜坡，脉冲一次算好下发（不再主机侧多级调速，消除一段一段）
2026-10-29 fix(gui): 转盘 +60°/-60° 按钮改后台线程（原来阻塞 Tk 主线程导致界面卡住），日志回到主线程刷新
2026-10-29 docs: 新增《复刻上位机到新电脑-给队友》（依赖/配置/自检/连派端/首次标定/常见问题/验收清单/回滚）
2026-10-29 fix(tray): 实测 4264 脉冲=240° → tray_scale 回 2.0；自动倍乘改为开关默认关（判据被 counts 误导曾把 2.0 学歪到 8.0）；托盘软限位放宽到 ±20000
2026-10-29 feat(grab): 连续抓分盒按‘同类不转/异类最短路径转/回旧盒反向’；转盘与回程并行（Z抬后起后台线程，松爪前 join 校验，未到位不松爪）
2026-10-29 perf(tray): 后台转盘用客户端最新遥测取 counts、判停稳更快(2次/85%)、补差轮询+4rpm、等待上限收紧，join 打印实际等待
2026-10-30 feat(display): v8 派端屏就地刷新（不闪）+ 5060 只读缓存帧；item 推送带 bbox/cam 供屏幕裁实时照片
2026-10-30 fix(display): 计时从「开始抓取」起算（连接/待机不再走表）；派端卡片类别名不再重复盒号、无 bbox 时裁托盘中心仍出实时照片
2026-10-30 fix(display): 修 IM 头解析(2sHHHI)/BGR 不转换/bbox 按整帧归一化/卡片异步照片重画，缩略统一 96x96 —— 卡上是放入瞬间实时照片
2026-10-30 fix(display): 卡片照片只框这一件货（1.45x 外扩，最小 110px、不超画面 42%），默认中心裁 26%
2026-10-30 fix(display): 计时改为 host 显式 running 标记驱动（未开始抓取时屏端钉死在 00:00，不再 0→4 锯齿）
2026-10-30 feat(grab): 转盘在夹紧后即后台开转（tray_async 默认 True），到 P0 立即可松爪；单件推送带占位缩略图+bbox，落货后按最新帧再刷照片
2026-10-30 fix(display): bbox 统一归一化成 [x,y,w,h]（支持像素/700/归一化/角点四种输入），卡片按框裁这件货；取消落货后按旧框重裁
2026-10-30 feat(pi): 新增派端遥控口 5062（ping/重启屏幕/重启服务/重启整机）+ 上位机「重启派端」按钮；start_display.sh 顺带守护 pi_ctl；sudoers 只放开两条运维命令
2026-10-30 chore(git): 强制 *.sh 与 orangepi/ 下文件用 LF（派端脚本被 CRLF 会 bad interpreter）
2026-10-30 feat(display): 任务结束显示总用时（finished/total_s）+ 屏端兼容像素bbox，避免旧上位机裁错
2026-10-30 fix(display): 无 bbox 时不再盲裁画面中心（会让每件都显示同一张），改用该件自带缩略图并打日志
2026-10-30 feat(display): 没收到目标框且无缩略图时，底栏提示「上位机需重启」
2026-10-30 feat(grab): 落货点改到 P1（P0/P1 下方都是盒子）→ 回P1 降Z 到位即松爪，不再退回 P0；drop=False 仍退 P0
2026-10-30 feat(ui): 新增「运行台」页（主摄画面+旋转+识别框、运行状态/识别结果双日志、一键启动抓到空、一键回P0）+ 舵机预备角度可输入存盘；页签置顶
2026-10-30 fix(ui): 运行台布局改为「上方固定主摄画面 + 下方运行状态/识别结果双日志」；selftest 截图前把窗口置顶，避免被其它窗口挡住
2026-10-30 fix(run_tab): 一键启动改用 app.calib_tab（原写 app.calib 报 AttributeError）；calib_tab.on_auto_many 透传 count/drop 到 _on_auto_many（原先未定义变量会 NameError）
2026-10-30 fix(grab): 连续抓日志/事件改 after 回主线程（跨线程改 Tk 会卡死）；打开双画面后后台预热 SAM，首次识别不再卡
2026-10-30 fix(link): 断联治理——图传 fps 15→8（双路 1080p 约 31Mbps 占满 WiFi）；链路判定 3s→8s、查询超时 300→800ms
2026-10-30 feat(display): 卡片缩略图按「识别框」严格裁切（CROP_PAD=1.0，下限 72px），与运行台画的框一致
2026-10-30 fix(photo): 派端裁图改取顶视槽位(cam=1, cam_map 顶视=1/副摄=0)；crop_square 严格按识别框裁并保持宽高比（灰边补齐），不再取正方形外扩
2026-10-30 fix(run_tab): 一键回 P0 改为按回读/软位置算增量（原来把绝对目标当相对脉冲下发，会多走一整段）；单测改为读取存盘的预备角度
2026-10-30 chore(release): 运行版整体收口——标定/运行态配置入库（calib_marks、gripper.json），忽略临时测试产物与每帧覆写的运行输出
2026-10-30 chore(release): 补齐运行必备配置——通道路线/转盘比例/分盒/预备位/四点框标注（route、tray_scale、box_map、prep_pose、journey、calib_marks）
2026-10-30 feat(vision): 按赛题 6 类重写 DeepSeek 提示词（顶面内部棱线判锥/柱、数量上限约束、逐件证据字段）；classify 增加 six_class 收敛；gui 增加 VLM 条数与本地分割一致性校验
2026-10-30 feat(grab): 整批抓完自动回 P0（Z抬顶→XY回P1→Z降底→Y退0）；用户叫停则停在原地
2026-10-30 fix(run): 连续抓线程结束后复位 _busy，避免第二次点「一键启动」误报正在执行
2026-10-30 fix(grab): 回 P0 顺序按现场纠正——已在 P1 且 Z 到底则直接 Y 回 0；否则先 Z 降到底再回 P0
2026-10-30 feat(tray+display): 转盘到位判据放宽(抖动/无回读按时间收口)+派端预设图+一键部署脚本
2026-10-30 docs: 新增交接文档-20261031（现状/架构/参数/坑/待办/现场操作卡）
2026-10-30 fix(motion): X/Y 并行残差 >3000 只告警不中止，改用新鲜读数复核（>40000 才中止）
    现场（2026-10-31）：并行后报「偏离目标 +11394 脉冲（>3000）」时爪子其实已到位，旧逻辑直接中止整批。根源是残差用 telemetry 旧帧算：Y 1600 RPM ~8.5 万脉冲/s，晚 130 ms 就差 1.1 万脉冲。
    改动：残差收口改 fresh_counts()；单轴残差 >60 时先用 fresh_axis() 新鲜读数复核再判；60~3000 仍顺序补一次；3000~40000 只告警、不补走、继续本件；>40000（~400 mm）保留中止等人工。阈值 prep_pose.XY_MISS_*。新增 3 个用例，254 个全绿；界面自检 8/8。交接文档 8.3/11 同步。
2026-10-30 fix(gripper): 初始化不再把预备角度冲回 158（类属性 import 时求值的坑）
    _INIT_PARAMS 是类属性，gripper_ready_deg 在 import 时就求值成协议默认 158，
    那时还没读 runtime/gripper.json（_build_gripper 之后才加载），于是每点一次
    「初始化」就把用户设的 167/168/170 下发成 158（现场现象：预备角度莫名变小）。
    - 拆成 _INIT_PARAM_BASE（不含预备角度）+ _init_params() 现算：
    界面输入框 > 存盘 gripper.json > 模块值，取第一个 135-180 的合法值
    - 初始化日志里的 ready= 也跟着实际下发值走，不再硬编码 158
    - auto_grab 落货提示「回预备 N°」改成读 P.GRIPPER_READ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
2026-10-30 test(gui): 界面用例不再把日志写进现场 runtime/（host_gui.LOG_DIR 可注入）
    跑一遍 255 个用例会往 01-交付包/runtime/host-YYYYMMDD.log 灌一万多行假流量
    （模拟 client 的 param_set/telemetry 也走同一个落盘钩子），排查现场问题时
    真机日志和用例日志混在一起分不清。
    - host_gui 增加模块级 LOG_DIR（None = 包内 runtime/，行为不变）
    - test_gui_smoke 建 App 前把 LOG_DIR 指向本用例的临时目录
    - 交接文档 §11 补一条：跑用例不再污染现场日志
2026-10-30 perf(start): 点完一键启动不再干等识别——预热SAM首帧、真按1帧识别、识别期间预走Y进通道+Z抬顶
2026-10-30 perf(grab): 节拍提速——回P0三分支+新鲜读数、X/Y永远并行、删0.6s稳定等待、夹爪/松爪等待缩短、Z/Y转速上调
    现场批复：z必须抬到位置（抬升高度不变），允许提速，先打回滚点标签 pre-speedup-20261031-0213。\n\n- goto_p0 重写：已在P0不动 / P1+Z底只走Y / P1+Z顶先降Z再Y / 不在P1先X/Y并行回P1再降Z再Y；判Z在底用连续两次一致的新鲜读数（修 01:58:53 旧帧误判导致高位直接回P0）\n- run_once: X/Y 全部走 move_xy() 并行；删 _settle_counts（一件6~8次x0.6s），改 _fresh_counts_for(最多5x30ms)；缺读数用软位置补\n- 等待：SETTLE_GRAB_MS 450->180、SETTLE_OPEN_MS 500->1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
2026-10-30 feat(box)+perf: 每次一键启动自动分盒清零；二轮提速（读数门槛800ms、预走恢复Z抬顶、Z 2800rpm）
    分盒：run_many(..., reset_boxes=True) 开批先 box_map.auto_reset(log)，日志留痕
    「分盒已自动清零（每批重新分配盒子）：<旧登记> → 0 类」；calib_tab._many_worker 传 True。
    旧登记是掉电保留文件，白占盒子会让新一批第 7 件「分盒失败」停机（10-31 踩两次）。
    默认 False，单件抓取/旧调用行为不变。
    提速（02:21 真机 11.9~15.3 s/件，再榨 ~1.6 s/件）：
    - COUNTS_MAX_AGE_MS 400→800（真机 age 常到 400~800 ms，02:22 那批「读数不够新」42 次）；
    _fresh_counts_for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
2026-10-30 feat(fw)+fix: 固件速度版默认值 + 上位机兜底 + 修 02:37 三处退化
    固件（01-交付包/stm32/firmware/Drive/Include/host_protocol_inline.h）
    - host_param_defaults 改为速度版：speed_rpm_max 300→3200、acc 1→0、
    telemetry_ms 200→100、gripper_ready_deg 150→168（只改复位初值，协议不动）。
    - Keil 命令行重编，stm32/hex/STM32F429.hex 已更新（hex 逐行对比只有这 4 条记录变化）。
    上位机
    - protocol.PARAM_DEFAULTS 与固件逐项对齐、GRIPPER_READY_DEG=168、Z 转速 2800→2400（实测 2800 更慢）。
    - 连接成功即下发速度版参数，并打一行「[连接] 参数快照：speed_rpm_max=… acc=…」。
    - move_x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
2026-10-30 fix(link): E10 自动清锁存重发 + 链路判定放宽 + 运动回执超时 3s + 云端慢熔断
    现场 03:13–03:15 那一批 0 件的根因（详见交接文档 §8 第 19/20 条）：
    - 派端串口桥看门狗 1.5 s 没收到字节就注入停车帧 → 固件置停止锁存 → 之后运动命令全回
    E10（03:14:22「第 1 件失败：Z 没走到位：E10」），而上位机没有任何自动恢复。
    - 图传一开链路就拥塞（1920x1080@8fps JPEG），回执迟到 1~3 s 击穿原来 1.5 s 的 ack 超时，
    8 s 判失联又直接断链重连（重连要重推参数、丢在途指令）。
    - 云端分类从 1.2 s 退化到 6.5~6.7 s，而 classify_fused 先 8 s 双图、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
2026-10-30 perf(z): Z 转速 2400→3000 + 闭环容差分级（Z 1500 counts）+ 固件 goto 余量 250→60ms、停稳判据 2→1
    用户反馈「Z 轴还可以再快」。上一轮把 Z 从 2400 抬到 2800 反而变慢（Z 单趟 1494→1848/2182 ms、
    passes 0→1~2），机理是：驱动器停的位置比闭环容差 goto_tol_counts=350 counts 稍偏，固件就用
    goto_final_rpm（默认 60 圈/分）补一整趟 —— 补的位移不到 1 mm，时间全花在固定开销上
    （等停稳 2 份遥测 + 20 ms 总线空档 + 慢速补走）。所以本轮是「抬转速」与「放宽容差」成对做，
    再把固件里两处纯等余量砍掉：
    - host/protocol.py：GOTO_RPM_BY_AXIS[1] 2400→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
2026-10-30 feat(z): Z 行程可现场覆盖(runtime/auto_grab.json) + 实测 Z 已到硬件上限的结论
    - auto_grab: _load_travel() 读 runtime/auto_grab.json 的 z_up_pulses/z_down_pulses，
    坏值(方向反/单位错)自动退回默认；开批日志打「Z 行程：抬顶 … mm，来源：…」
    - 一件 4 趟 Z 是纯行程，实测 Z 有效转速卡在 ~1804 圈/分(≈60 mm/s)：
    rpm 3000 vs 2400 单趟只差 24 ms(1585 vs 1617)，抬转速已无意义，只能少走行程
    - 出厂默认仍 -152000(91.7 mm, 安全)；现场按间隙调到 -100000 可省 ≈2.1 s/件
    - 5 个新用例覆盖：覆盖生效/非法值退回默认/坏 JSON/仓库自带模板必须是出厂值
2026-10-30 Revert "feat(z): Z 行程可现场覆盖(runtime/auto_grab.json) + 实测 Z 已到硬件上限的结论"
    This reverts commit caa9f82be82f489c716756cd41dd8c8d62d343b9.
2026-10-30 perf(tray): 转盘提前到本件一开始就转（省 1.5 s/件）+ Z 高度硬性结论
    现场 04:02 那件逐段计时发现：-120° 转盘要 7.42 s，而回程（⑥抬 ⑦回P1 ⑧降）只要 ~6 s，
    旧顺序「⑤夹紧后才转」在松爪前白等 1.51 s（日志「join 只等了 1.51 s」）。
    - auto_grab.run_once 新增 tray_early（默认 True）与 state：转盘启动提到 ①Y 之前，
    与抓取/回程全程并行；tray_early=False 可复现旧顺序（行为可回退）。
    - run_once 把本件已转角度写进 state['tray_applied']；run_many 重试时减掉已转角度，
    避免同一件转两次盘落错盒（日志「重试不再转盘（上一轮已转 +120°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
2026-10-30 feat(vision): 白色/浅色物块候选分支——局部亮度比找白块（修两个白六棱锥一直漏抓）
    根因两道门：候选前景只认 饱和度>45（白块 S≈11~15 进不来）；物体性门 sat_mean<32 且 diff_mean<20 又丢一次。
    修法：auto_segment._white_mask() 用 V/GaussianBlur(V) 局部亮度比(>1.10)+低饱和+够亮找候选；_white_ok() 用面积/填充率滤掉托盘内壁反光带；segment() 并入前景、放宽物体性门并输出 stats['white_blobs']。
    阈值来自现场实帧：白棱锥 7262/7778 px（填充 0.52/0.44）vs 内壁反光带 3800 px（填充 0.37）→ min_area 5000 + min_fill 0.35。
    新增 host/tests/test_auto_segment_white.py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
2026-10-30 perf(stream)+fix(link): 图传降到派端原生1280×720/质量60/预览限4fps；回执迟到不再阻塞运动（遥测判到位+迟到告警）
    现场（2026-10-31 04:38~04:55）：Z 降到底之后要停顿很久才夹紧/抬升。
    逐行核对日志：固件自报 elapsed_ms 只有 1034~1634 ms，但回执帧 2~15 s 才到上位机
    （全日志 19 次 ≥1.5 s，最坏 15.4/15.0 s），迟到窗口里 Z 遥测也断流（空档 13~15 s、
    出现 age_ms=599/799 的陈旧帧）→ 不是轴慢，是链路/派端桥被图传挤住。
    5054 只读观察口实测转发最大空档：基线 1.23 s → 边拉 1080p 图传 3.17 s → 停流 0.30 s。
    A) 图传降负载：派端相机原生 128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
2026-10-30 revert(stream): 图传改回 1920×1080（画面标注按标定坐标画，降分辨率会整体错位）
    上一版（44865e9）为了降链路负载，把取帧请求降到派端原生的 1280×720 + 质量 60 + 预览 4 fps。
    链路确实变松了，但**画面标注用的是 1920×1080 标定坐标**：视觉页校正点 P1~P4、识别目标框、
    `_vlm_crop_now()` 裁剪、运行台叠加框都按这个坐标系画/裁 —— 帧变小后标注整体错位（现场当场发现）。
    本轮回退到改前观感：
    - `vision/config.json`：width/height 1920×1080、img_quality 0（用派端配置=80）、preview_fps 0（不限帧）；
    - `calib_width/calib_height` 保留 1920×1080；`gu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
2026-10-30 revert: 回到 2026-10-31 04:30 现场版（= tag pre-streamopt-20261031-0510 的树）
    用户要求回到 04:30 那一版。把 44865e9（图传降 720p + 回执护栏）和 c9c48fb（图传改回 1080p）
    之后的代码/测试/文档恢复到 650f0a9 的状态：
    - 恢复 host_client.py / prep_pose.py / vision/camera_factory.py / remote_camera.py /
    vision/gui.py / vision/config.json / tests/test_client.py / tests/test_prep_pose.py / 交接文档；
    - 删除本轮新增的 host/tests/test_stream_scale.py；
    - 现场运行态 runtime/*.json（box_map / journey / gripper.json）保持不动。
    恢复后包含：白块/浅色物块候选（650f0a9）、转盘提前转（190f35f）、Z 抬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
2026-10-30 perf(stream)+perf(tele)+perf(grab): 图传 fps 8→3 真节流、遥测 200→400ms 并去重日志、松爪不等转盘、夹紧后立刻抬 Z
    现场问题（2026-10-31 05:13~05:31 真机日志）：Z 降到底后偶发停顿 2~6 s。
    固件自报 elapsed_ms 恒 1034~1054 ms（其实早走完），是回执迟到：
    Z 的 60 次 motor_goto 里 18 次回执迟到 ≥1.5 s；迟到窗口内遥测整段断流
    （"链路变慢：已经 5 s 没收到任何数据"、"ping 无应答"）。
    根因：图传 1920×1080@8fps 请求把派端 CPU 吃满（相机原生 1280×720，先放大再压 JPEG，
    实测只出 ~1.1 fps）+ 四轴 5 Hz 遥测（≈20 帧/秒）→ 串口桥转发被饿死，遥测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
2026-10-30 fix(grab): 松爪留 220ms 张嘴时间（open/ready 背靠背会让爪子张不开）
    现场反馈「爪子的预备角度是不是被你改没了」——预备角度参数其实一直在：
    连接时 param_set gripper_ready_deg=168、参数快照 168、host/runtime/gripper.json 168，
    `gripper ready` 每件也都在发。真正的回归是上一提交把 SETTLE_OPEN_MS 从 150 清零：
    open 与 ready 相隔 ~1 ms 下发，固件 host_cmd_gripper 收到 ready 立刻 Servo_SetAngle(168)
    覆盖 open 的 PWM（host_protocol_inline.h:2112-2185、control_inline.h:312-326、servo.c:58），
    不看 busy、不等舵机 -> 舵机来不及从 135° 张到 180°，现场看起来就是「没松爪 /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
2026-10-30 ui(run): 运行台删掉预览画面，只留日志（识别结果改为查 fused 列表刷新）
    用户 2026-10-31 要求「删掉运动台的预览界面」。
    - run_tab.py: 去掉 canvas / 640×360 预览帧 / 左旋右旋按钮 / fps 标签 / PIL 画框与缩放；
    页面现在 = 顶部按钮行 + 左右两栏日志（运行状态 / 识别结果）占满整页。
    - 「识别结果」不再靠画图时顺带记录：改成 _refresh_items() 每 120 ms 读
    vision_app.fused 列表做签名比对，仍会打印「#n 类别 颜色」与「（画面里没有识别到目标）」。
    - _tick 保留：它原来兼顾「连续抓结束后复位 _busy」，这部分逻辑不变。
    - doc: 代码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
2026-10-30 ui(calib): X/Y 标定页删掉顶视小预览（只留标注点列表与点动）
    用户 2026-10-31 要求「把 xy 标定里的预览也删掉」。
    - calib_tab.py: 删掉「顶视预览（0.25 s 刷新）」的 LabelFrame、占位图、
    _preview_stream / _preview_update / _preview_overlay / _preview_tick 四个方法、
    以及 PREVIEW_W/H 常量；顺带去掉只被它们用到的 PIL / cv2 / numpy 导入。
    标注点列表现在占满整页（原来右侧被预览挤着一列）。
    - 保留：「残差预览」按钮（那是按抓取点算残差脉冲的文字预览，不是画面）、
    标注点列表、记录爪位/求解并保存、XY 点动等一切标定功能。
    - doc: 代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
2026-10-30 feat(pi): 派端屏货物图改用 presets/ 预设照片（默认不再实时截取）
    现场要求（2026-10-31）：「@图片/presets/ 让派端调用这几张照片，不在实时截取」。
    派端 `orangepi/pi/pi_display.py`：
    - `item` 改成**预设图优先**：先 `preset_photo(name,color,f(52))`，查不到才用上位机推的
    `thumb_b64`；大图同样先取预设。
    - `preset_photo` 三级查找：精确「形状|颜色」→ 同色同族 → 同族（任意颜色），
    新增 `_shape_family()` 把 圆锥/棱锥/柱/长方 归类。
    - 新增 `_preset_sizes()`+`_pick_preset_size()`：按请求尺寸挑「相近且不小于」的档，
    必要时 `subsample()` 整数倍缩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
2026-10-30 fix(pi): 修复派端屏显示纯色方块——补自检/颜色兜底/部署校验/开机自启
    事故（2026-10-31 07:35，用户：「派端图片不对，现在是纯色图片，没有调用这几张」）：
    派端 `pi_display.py` 被换回了 10-30 的旧版（38126 B，mtime 仍是 10-30 10:57，
    像是带时间戳同步覆盖的），`presets/` 目录整个不在 —— 旧版拿不到图就画纯色方块。
    重传后现场恢复（真机跑着的一批里 `椭圆柱|红 → 1 号盒` 直接显示粉色椭圆柱实物图）。
    第二处「纯色」来源（同一次现场观察到）：第 8 件类别名是 `—`（形状没认出来）+ 蓝色，
    预设查不到 → 退回上位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
2026-10-31 fix(motion,box,app): 修 07:35~07:49 现场四类抽风——零脉冲补走 E02、没定名的件吃盒停机、多窗口互踢/stop_all 打断、回执迟到兜底恢复
    现场 06:01~07:49 的日志逐条核对（runtime/host-20261031.log + .log.1）后定位到 4 条原因：
    1. E02 零脉冲补走（07:39:10，真 bug）：并行残差复核把 -49332 复核成 0 之后没有重新判容差，
    仍发 motor_goto,5,0,... → 固件 E02 reason=pulses → 整件白失败。
    修法：复核后重新判容差（容差内直接 continue）；_goto_wait() 对 0 脉冲直接返回、不发指令。
    2. 没定名的类别吃盒号（07:41、07:47 两次「分盒失败：6 个盒子都已分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
2026-10-31 feat(grab): 按现场固定时序重排——识别期先Y后Z、夹紧后200ms、转盘到位才降Z、松爪即拍照+抬Z回预备、X/Y整对重发；开批刷新派端屏
    用户 2026-10-31 明确「这些都是死的」的固定循环，逐条落地：
    1. 每次「一键启动」先刷新派端屏（display_link.reset → pi_display kind=reset：6 个盒卡片清空、
    计数/计时归零、回「等待第一件」），再清分盒登记。
    2. 识别期间预走恢复两步：①Y 进通道 → ②Z 抬顶（先 Y 后 Z，穿通道时 Z 必须在底）。
    3. 每件重新拍照识别：calib_tab._many_worker 传 recognize_each=True（松爪后立刻拍下一张）。
    4. 夹紧后等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
2026-10-31 fix(motion): 修 16:04「客户端等待超时」——两轴同批发出、过期读数改用软位置、到位即走、E09 忙不判失败
    现场 16:04:50~16:05:07 一件白失败，日志复现出的因果链：
    - ⑦ 的 motor_pos(+26090) 已把 Y 送回 P1，但 Y 遥测 counts 冻结在 -803218（托盘位）3 秒多、age_ms 一路涨到 2399；
    - 预走按这份旧值又算了一遍 +26076 发 motor_goto → 同一段位移叠加两次，Y 顶到轨道正端（编码器停在 +675 脉冲）；
    - 固件闭环追不上（passes=3）10.2 s 后才回 E14，客户端 estimate_timeout_ms≈8.5 s 先到期 →「客户端等待超时」；
    - 正式流程立刻重发 → E09 goto_busy（固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
2026-10-31 fix(motion): 修 16:31「反而 0 件」——位置账本优先、遥测只在静止时回写、盲读数不动轴
    现场（16:31 那批）比上一版更差，根因不是"提速"，而是位置基准被冻结的遥测值反复冲掉：
    - 驱动器只在轴停下后才刷新 counts，运动期间遥测帧里的 counts 冻在"出发前的位置"；
    - host_gui.update_telemetry() 收到 counts 就无条件回写 soft_pos，把 motion_hook 累加的
    指令账本冲回旧值 → 回程按旧值算出"Y 并行：-19 脉冲"（本该 +83162）；
    - _wait_arrive 的"无进展提前收口"只有 0.30 s（Y 走 8 万脉冲要 ~1 s）→ 提前放行，
    Z 在 Y 还在走时就下压；
    - _counts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
2026-10-31 fix(motion): X/Y 横移改全开环——只发不判、不补走，账本按实发脉冲累计
    现场三次事故同一个根：每段执行本身都是准的，乱走全是"确认环节拿错读数把位移
    重放一次"造成的：
    * 16:04 冻结遥测（Y counts 卡 -803218、age_ms 涨到 2399）→ 预走又发 +26076，
    叠加在 ⑦ 的 +26090 上把 Y 顶到轨道尽头 → E14 补差 10.2 s → 客户端 8.5 s
    超时 → 重发撞 E09 goto_busy → 整件失败；
    * 16:31 遥测把账本冲回 P1 → 回程只发 -19 脉冲（应 +83,180）→ 残差 +83162 → abort；
    * 16:54 日志写"收口 X -472"实际发成 -8668 → X 跑到 -90 mm，回程甚至反向 +3364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
2026-10-31 Revert "fix(motion): X/Y 横移改全开环——只发不判、不补走，账本按实发脉冲累计"
    This reverts commit 816d2e5bc0891791315e162a22174e10f7402cb2.
2026-10-31 Revert "fix(motion): 修 16:31「反而 0 件」——位置账本优先、遥测只在静止时回写、盲读数不动轴"
    This reverts commit c3d615b3b0385dc42a84d3f0718c0e320cc3f3ec.
2026-10-31 Revert "fix(motion): 修 16:04「客户端等待超时」——两轴同批发出、过期读数改用软位置、到位即走、E09 忙不判失败"
    This reverts commit 228ad6e422d0778c0833fabf5c399d89a1b8e439.
2026-10-31 fix(motion): X 轴收口基准改用新鲜读数、残差量直发
    现场（2026-10-31 16:54:17）：残差用 fresh_counts() 算出 -472，收口却用 read_counts()
    （2.8 s 前的旧帧 +8668）重算成 -8668，X 多走 8196 脉冲被顶到 0 点左侧，下一件又按被污染的
    位置算 +15114 顶回来 —— 用户看到的"X 轴莫名其妙不对"。
    - _send_round(send_map, rel_map=None)：绝对轴基准改 fresh_counts() or read_counts()
    - 收口轮把残差量直发（rel_map），不再"绝对目标 - 基准"二次换算
    - 新单测 StaleBasisTests 3 例（472 只发 472 / 100 不等于整段 5000 / 两轴仍同批发出）
    - 全套件 333 绿、main.py --selftest 8/8；交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
2026-10-31 fix(motion,link): 基准改 motor_query 现查 + 按实测转速等走位 + E10/E14 自动清锁存重试
    现场（2026-10-31 18:12，4 成 1 败 127.1 s）实证：X/Y 的遥测 counts 每 1.6 s 才刷新一次
    （固件 host_query_sweep() 挂在遥测分支里、每拍只查一根轴，4x400ms 一圈），
    Y 实测 42,675 脉冲/s → 拿它当"当前位置"会错几万脉冲；再叠加
    "按 1240 圈/分估走位时间(少等 1.55 倍)"和"同一缓存帧两帧相同→判成停稳"，
    就出现"前几件还好、后面越走越乱、批末 goto_p0 闭环又把位置拉回来"。
    * prep_pose.query_pulses()：motor_query <axis> pos 直问驱动器（忙 E09 重试 3x15ms），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
